Agustin586/AWG-RP2040/Tesis/Anteproyecto/caratula.tex

% =========================================================
% CARÁTULA
% =========================================================
\begin{titlepage}
	\thispagestyle{empty} % sin encabezado ni pie
	
	\vspace*{-3cm}
	
	% --- Logos arriba ---
	\begin{minipage}[t]{0.49\textwidth}
		\raggedright
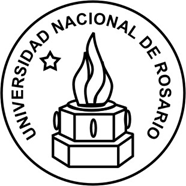
[picture p9: Tesis/Anteproyecto/pic/unr-logo.png]
		
	\end{minipage}
	\begin{minipage}[t]{0.49\textwidth}
		\raggedleft
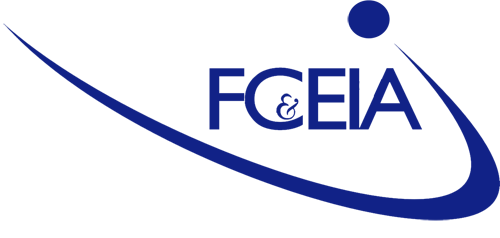
[picture p10: Tesis/Anteproyecto/pic/FCEIA-logo.png]
		
	\end{minipage}
	
	\vspace{1cm}
	
	% --- Institución ---
	\begin{center}
		{\Large Universidad Nacional de Rosario \par}
		\vspace{0.15cm}
		{\large Facultad de Ciencias Exactas, Ingeniería y Agrimensura \par}
		\vspace{0.15cm}
		{\large Ingeniería Electrónica \par}
	\end{center}
	
	\vspace{2cm}
	
	% --- Título principal ---
	\begin{center}
		{\bfseries\LARGE Proyecto I\par}
		\vspace{0.35cm}
		{\bfseries\Large Generador de Funciones Arbitrarias basado en DDS\par}
		\vspace{0.25cm}
		{\large \par}
	\end{center}
	
	\vspace{2cm}
	
	% --- Línea decorativa ---
	\noindent\rule{\textwidth}{1.2pt}
	
	\vspace{0.9cm}
	
	% --- Datos en dos columnas ---
	\noindent\makebox[\textwidth]{%
		\begin{minipage}[t]{0.49\textwidth}
			\raggedright
			{\bfseries Estudiante:}\par
			Agustín Zuliani, Legajo: Z-1183/5\par
			\vspace{0.6cm}
			{\bfseries Carrera:}\par
			Ingeniería Electrónica\par
		\end{minipage}%
		\hfill
		\begin{minipage}[t]{0.49\textwidth}
			\raggedleft
			{\bfseries Director:}\par
			Daniel Márquez\par
			\vspace{0.6cm}
			{\bfseries Asignatura / Proyecto:}\par
			Proyecto 1\par
		\end{minipage}%
	}
	
	\vspace{0.9cm}
	
	% --- Línea decorativa ---
	\noindent\rule{\textwidth}{1.2pt}
	
	\vfill
	
	% --- Pie ---
	\begin{center}
		Rosario, Santa Fe — 2026\par
	\end{center}
	
\end{titlepage}
