Agustin586/AWG-RP2040/Tesis/Anteproyecto/config.tex

%En este archivo se tienen las configuraciones realizadas para el proyecto
%=================================================================================
%								      PAQUETES
%=================================================================================
\usepackage{amsmath}
\usepackage[utf8]{inputenc}
\usepackage{graphicx}
\usepackage[export]{adjustbox}
\usepackage{float}
\usepackage[bookmarks = true, colorlinks=true, linkcolor = black, citecolor = black, menucolor = black, urlcolor = black]{hyperref}
\usepackage{vmargin}
\setpapersize{A4}
\setmargins{2.5cm}{1cm}{16.5cm}{23cm}{.5cm}{2.5cm}{0pt}{2cm}
\setlength{\skip\footins}{1cm}
\usepackage{fancyhdr}
\pagestyle{fancy}
\fancyhf{}
\usepackage{enumitem}
\usepackage{tikz, adjustbox}
\usepackage[most]{tcolorbox}
\usepackage{xcolor}
\usepackage{wrapfig}
\usepackage{lipsum}
\usepackage{titlesec}
\usepackage{rotating}
\usepackage{pdflscape}
\usepackage{tabularx}

% Interlineado
\usepackage{setspace}
\onehalfspacing
