Agustin586/AWG-RP2040/Tesis/Anteproyecto/anteproyecto.tex

\documentclass[12pt,a4paper]{article}

\usepackage[spanish]{babel}

% Carga tu configuración (NO se modifica)
\input{config.tex}

% Extras tuyos
\input{tcolorbox_define}
\input{Config_codigo}

% =========================================================
% ENCABEZADO Y PIE DE PAGINA (fancyhdr ya está cargado en config.tex)
% =========================================================
\chead{%
	{\itshape\bfseries ``Proyecto 1''}\\
	{\bfseries Generador de Funciones Arbitrarias}\\
	Estudiante: Zuliani, Agustín -- Director: Márquez, Daniel\\
	Universidad Nacional de Rosario, 2025
}
\lhead{}
\rhead{}
\renewcommand{\headrulewidth}{1.5pt}

\lfoot{Zuliani, Agustín}
\rfoot{\thepage}

% =========================================================
% MÁRGENES / FORMATO DE PÁGINA
% =========================================================
% Como en config.tex tenés geometry + vmargin, elegí UNO.
% Si querés seguir con vmargin (porque usás \setmargins), dejá esto:
% Si en cambio querés imponer márgenes con geometry (sin tocar config.tex),
% comentá el bloque \setmargins de arriba y usá, por ejemplo:
% \geometry{left=3cm,right=2.5cm,top=3cm,bottom=3cm}

% =========================================================
% FORMATO DE TÍTULOS (titlesec ya está en config.tex)
% =========================================================
\definecolor{teal}{RGB}{0,128,128}

\titleformat{\section}[block]
{\sffamily\Huge\bfseries\color{teal}}
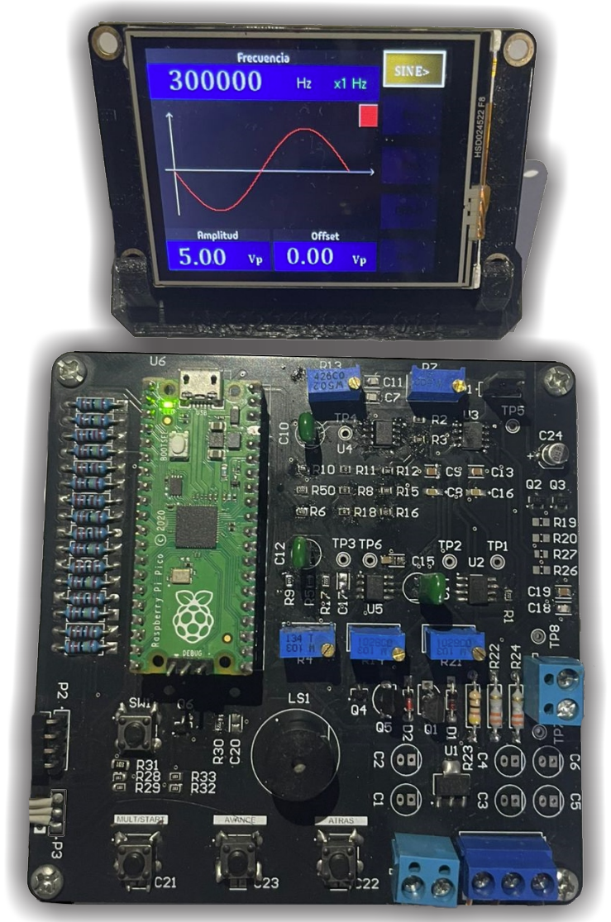
[picture p11: Tesis/Anteproyecto/Introduccion/img/dispositivo.png]
{\raisebox{-0.2\height}{}\hspace{0.3em}\thesection}
{0.5em}
{}
[\vspace{-0.5em}\color{teal}\rule{\linewidth}{2pt}]

\titleformat{\subsection}
{\normalfont\large\bfseries\color{teal}}{\thesubsection}{1em}{}
\titlespacing*{\subsection}{0pt}{0.5em}{0.5em}

\titleformat{\subsubsection}
{\normalfont\large\bfseries\color{teal}}{\thesubsubsection}{1em}{}
\titlespacing*{\subsubsection}{0pt}{0.5em}{0.5em}

% =========================================================
% ÍTEM CON IMAGEN (enumitem ya está en config.tex)
% =========================================================
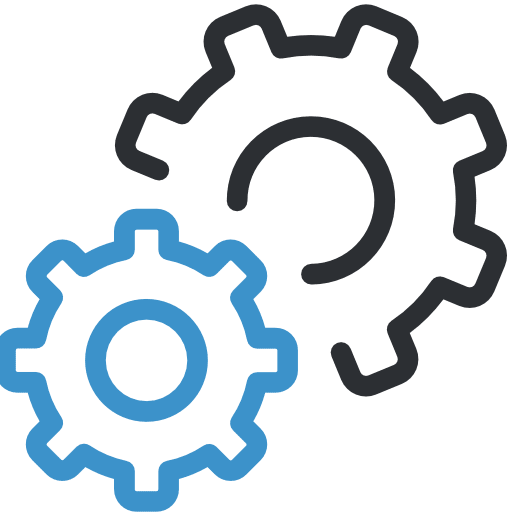
[picture p12: Tesis/Anteproyecto/pic/items_control.png]
\newcommand{\itemimage}{}
\setlist[itemize]{label=\itemimage}

\begin{document}
	
	% =========================================================
	% CARÁTULA SIN ENCABEZADO
	% =========================================================
	\input{caratula.tex}
	
	\newpage
	
	\tableofcontents
	\newpage
	
	\input{Introduccion/doc/introduccion.tex}
%	\input{Introduccion/doc/Objetivo.tex}
	\input{Comparacion/comparacion.tex}
	\input{caracteristicas.tex}
%	\input{Introduccion/doc/Objetivo.tex}
	\input{Metodologia/doc/metodologia.tex}
%	\input{Conclusion/doc/instrumental.tex}
%	\input{Conclusion/doc/avances.tex}
%	\input{Conclusion/doc/mejoras_a_futuro.tex}
	
	\newpage
	
	\bibliographystyle{plain}
	\bibliography{bibliografia}
	
\end{document}
