Agustin586/AWG-RP2040/Tesis/Anteproyecto/Config_codigo.tex

\usepackage{tcolorbox}
\usepackage{listings}
\usepackage{xcolor} % Para colores personalizados

\definecolor{codebg}{rgb}{1,1,1} % Fondo gris claro
\definecolor{codeborder}{rgb}{0.6,0.6,0.6} % Borde gris oscuro

\lstdefinestyle{mystyle}{
  language=C,
  basicstyle=\ttfamily\color{black}, % Código en negro
  keywordstyle=\color{blue}, % Palabras clave en azul
  commentstyle=\color{green!50!black}, % Comentarios en verde oscuro
  stringstyle=\color{red}, % Cadenas en rojo
  showspaces=false, % Oculta los espacios
  showstringspaces=false % Evita que los espacios dentro de strings se marquen
}

\newtcolorbox{codebox}{
    colback=codebg, 
    colframe=codeborder, 
    arc=3mm, 
    boxrule=1pt, 
    fontupper=\ttfamily
}

%===================================================================================
%									BLOCK DE NOTAS
%===================================================================================
% Yellow:
\definecolor{BgYellow}{HTML}{FFF59C}
\definecolor{FrameYellow}{HTML}{F7A600}

% Definir el estilo de la nota
% Yellow Sticky Note (YStkyNote):
\newtcolorbox{YStkyNote}[1][]{%
	enhanced,
	before skip=2mm,after skip=2mm, 
	width=0.4\textwidth, % width of the sticky note
	boxrule=0.2mm,
	colback=BgYellow, colframe=FrameYellow, % Colors
	attach boxed title to top left={xshift=0cm,yshift*=0mm-\tcboxedtitleheight},
	varwidth boxed title*=-3cm,
	% The titlebox:
	boxed title style={frame code={%
			\path[left color=FrameYellow,right color=FrameYellow,
			middle color=FrameYellow]
			([xshift=-0mm]frame.north west) -- ([xshift=0mm]frame.north east)
			[rounded corners=0mm]-- ([xshift=0mm,yshift=0mm]frame.north east)
			-- (frame.south east) -- (frame.south west)
			-- ([xshift=0mm,yshift=0mm]frame.north west)
			[sharp corners]-- cycle;
		},interior engine=empty,
	},
	sharp corners,rounded corners=southeast,arc is angular,arc=3mm,
	% The "folded paper" in the bottom right corner:
	underlay={%
		\path[fill=BgYellow!80!black] ([yshift=3mm]interior.south east)--++(-0.4,-0.1)--++(0.1,-0.2);
		\path[draw=FrameYellow,shorten <=-0.05mm,shorten >=-0.05mm,color=FrameYellow] ([yshift=3mm]interior.south east)--++(-0.4,-0.1)--++(0.1,-0.2);
	},
	drop fuzzy shadow, % Shadow
	fonttitle=\bfseries, 
	title={#1}
}
