Agustin586/AWG-RP2040/Tesis/Anteproyecto/Conclusion/doc/avances.tex

\section{Avances realizados}
En esta sección se presentan los avances que fueron realizados durante el proceso de desarrollo del anteproyecto de forma preliminar. 

\subsection{Diseño de la placa de alimentación}
Dentro de estos avances se encuentra el diseño de la \textbf{placa de Alimentación} a través del programa de diseño \textbf{Altium} que puede verse en la Figura \ref{fig:placaalimentacion} y \ref{fig:placaalimentacionvuelta}.

\begin{figure}[H]
	\centering
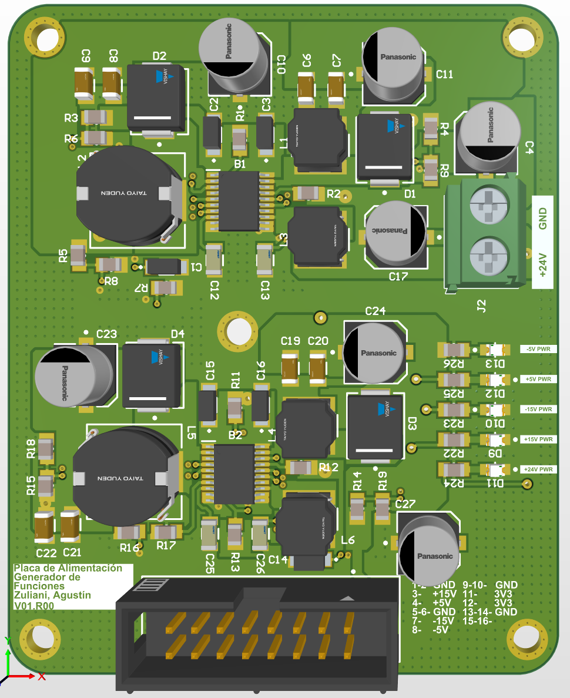
[picture p13: Tesis/Anteproyecto/Conclusion/img/placa_alimentacion.png]
	
	\caption{Placa de Alimentación diseñada V01.R00 del lado TOP.}
	\label{fig:placaalimentacion}
\end{figure}

\begin{figure}[H]
	\centering
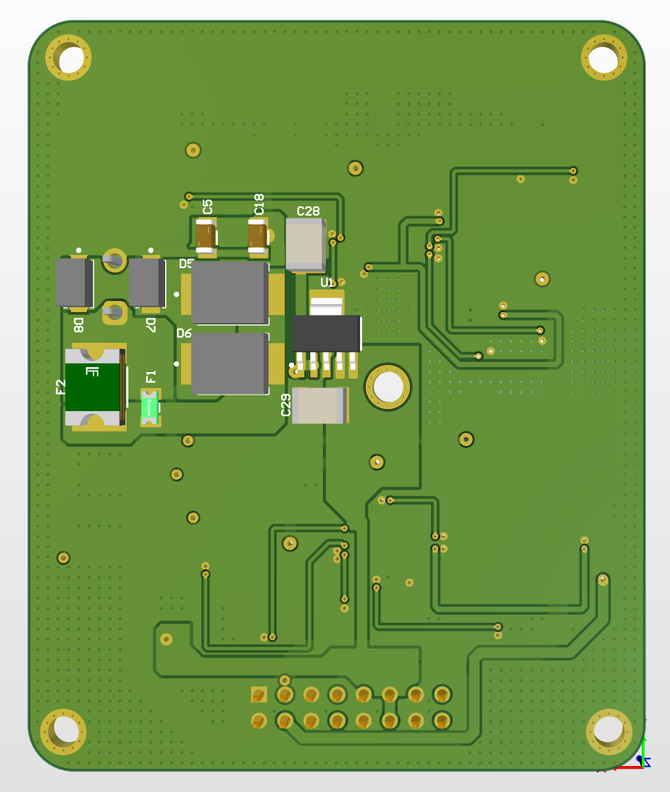
[picture p14: Tesis/Anteproyecto/Conclusion/img/placa_alimentacion_vuelta.png]
	
	\caption{Placa de Alimentación V01.R00 del lado Bottom.}
	\label{fig:placaalimentacionvuelta}
\end{figure}

El circuito esquemático puede verse a continuación:

\begin{figure}[H]
	\centering
	
	\caption{Esquemático de la PCB de Alimentación.}
	\label{fig:fuente}
\end{figure}

\subsection{Diseño de la placa de control}
De la misma manera con la \textbf{placa de control} se fueron realizando avances, dentro de estos se encuentra únicamente el diseño del esquemático. En esta placa como se mencionó anteriormente se encuentra toda la generación de la señal, así como también el control mediante el RP2040 para la lógica funcional.

\begin{figure}[H]
	\centering
	
	\caption{Esquemático de la placa de control.}
	\label{fig:pcbcontrol}
\end{figure}

\begin{figure}[H]
	\centering
	
	\vspace{6pt}
	
	\caption{Esquemático de la placa de control (hojas 2 y 3).}
\end{figure}

\begin{figure}[H]
	\centering
	
	\vspace{6pt}
	
	\caption{Esquemático de la placa de control (hojas 2 y 3).}
\end{figure}

\begin{figure}[H]
	\centering
	
	\vspace{6pt}
	
	\caption{Esquemático de la placa de control (hojas 2 y 3).}
\end{figure}

\begin{figure}[H]
	\centering
	
	\vspace{6pt}
	
	\caption{Esquemático de la placa de control (hojas 2 y 3).}
\end{figure}

\begin{figure}[H]
	\centering
	
	\vspace{6pt}
	
	\caption{Esquemático de la placa de control (hojas 2 y 3).}
\end{figure}

\begin{figure}[H]
	\centering
	
	\vspace{6pt}
	
	\caption{Esquemático de la placa de control (hojas 2 y 3).}
\end{figure}

\begin{figure}[H]
	\centering
	
	\vspace{6pt}
	
	\caption{Esquemático de la placa de control (hojas 2 y 3).}
\end{figure}
