Agustin586/AWG-RP2040/Presentacion SASE/PRESENTACION_SASE_2025.pdf

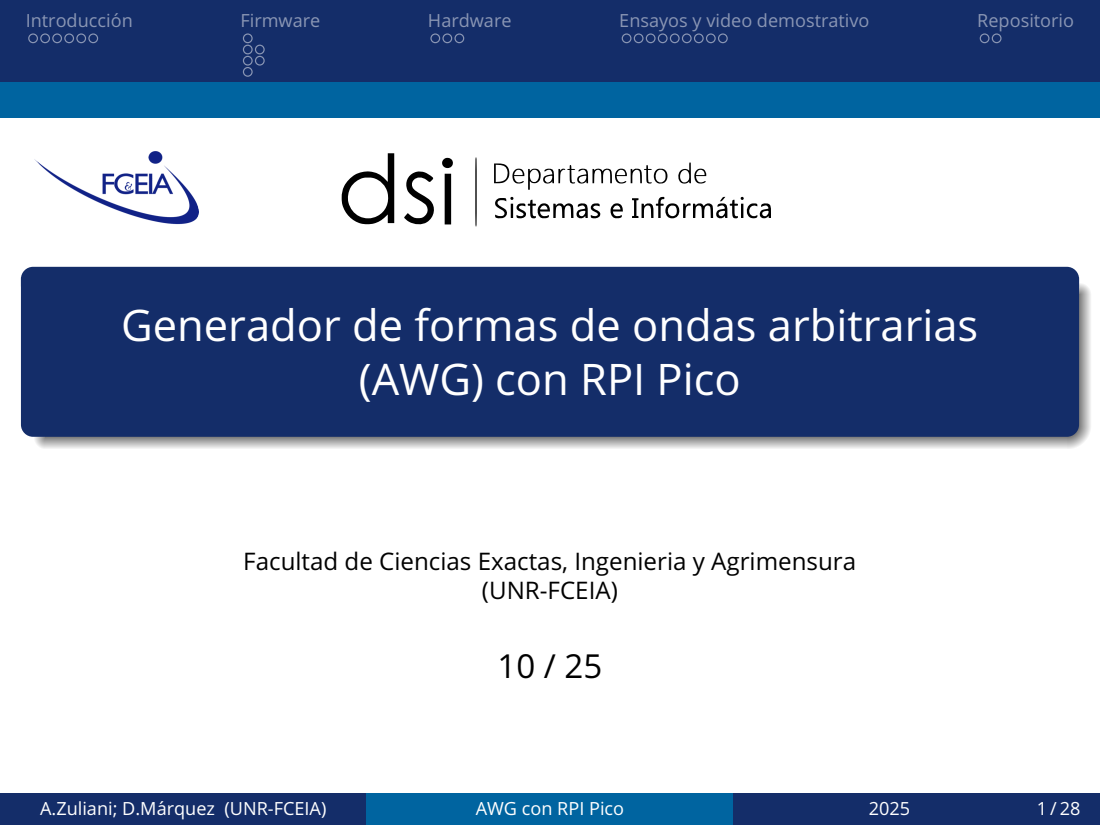
[picture p27: page 1]
Introduccion´; Firmware; Hardware; Ensayos y video demostrativo; Repositorio; (UNR-FCEIA); A.Zuliani; D.Márquez (UNR-FCEIA); AWG con RPI Pico

Generador de formas de ondas arbitrarias

(AWG) con RPI Pico

Facultad de Ciencias Exactas, Ingenieria y Agrimensura

## Índice

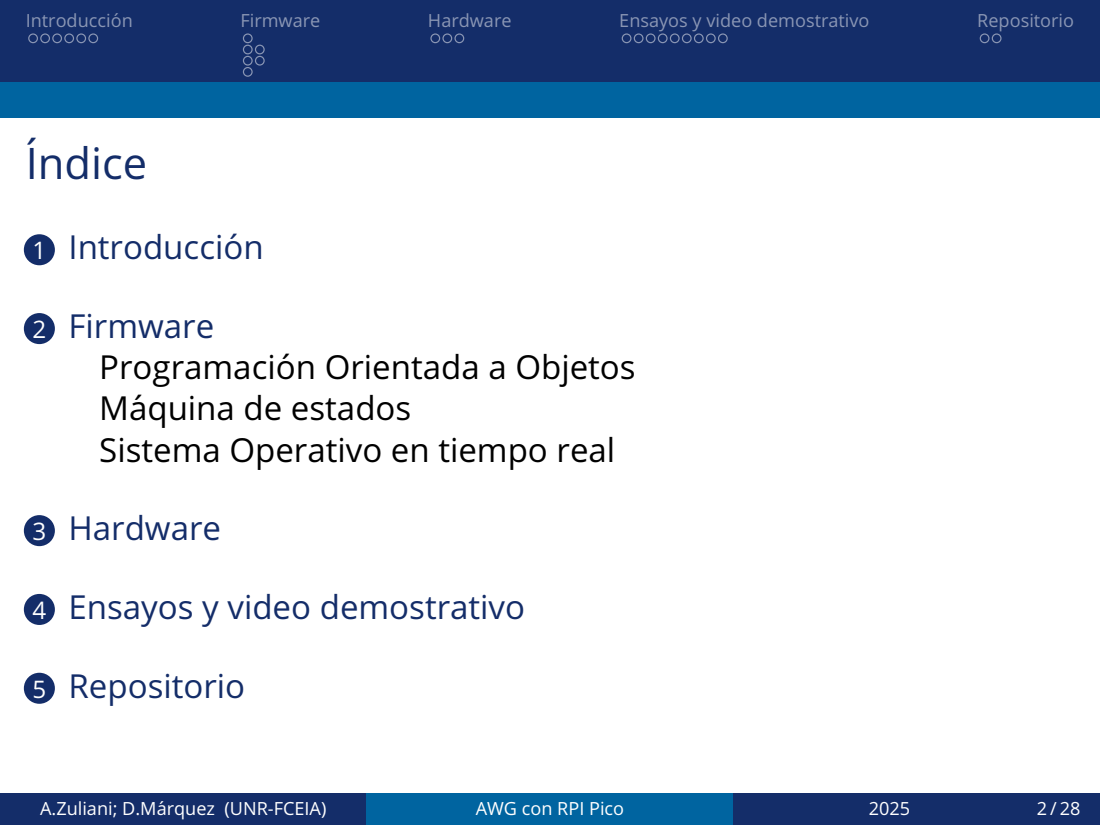
[picture p28: page 2]
1 Introduccion´; 3 Hardware; 5 Repositorio; A.Zuliani; D.Márquez (UNR-FCEIA); AWG con RPI Pico

2 Firmware
Programacion Orientada a Objetos ´
Máquina de estados
Sistema Operativo en tiempo real

4 Ensayos y video demostrativo

## Introduccion´

- ¿Qué es el SASE?
A.Zuliani; D.Márquez (UNR-FCEIA) | AWG con RPI Pico | 2025 | 3 / 28

## Introduccion´

- ¿Qué es el SASE?
- ¿Cuales fueron las motivaciones? ´
A.Zuliani; D.Márquez (UNR-FCEIA) | AWG con RPI Pico | 2025 | 3 / 28

## Introduccion´

- ¿Qué es el SASE?
- ¿Cuales fueron las motivaciones? ´
- ¿Qué es un AWG? ¿Porqué la eleccion de ese micro en particular? ´
A.Zuliani; D.Márquez (UNR-FCEIA) | AWG con RPI Pico | 2025 | 3 / 28

## Simposio Argentino de Sistemas Embebidos (SASE)

2025

El Simposio Argentino de Sistemas Embebidos (SASE) es un evento anual que reúne a la comunidad académica y a la industria en torno a la temática de los Sistemas Embebidos.
Los objetivos del SASE son los siguientes:
1 Difundir en el ámbito profesional y académico las tecnologías asociadas a los sistemas embebidos.
2 Fomentar la interaccion industria-academia en temas ´ asociados a los sistemas embebidos.
3 Incentivar entre los estudiantes universitarios y los jovenes ´ profesionales el interés por los sistemas embebidos.

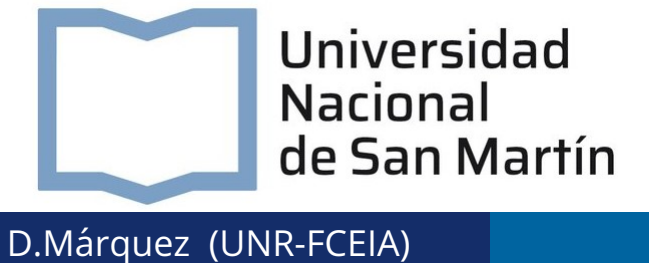
[picture p29: figure]
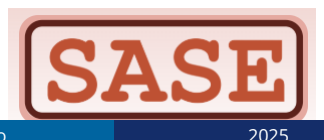
[picture p30: figure]

A.Zuliani; D.Márquez (UNR-FCEIA) | AWG con RPI Pico | 2025 | 4 / 28

## ¿Qué es un AWG?

Un generador de formas de onda arbitrarias (AWG) permite generar funciones periodicas cargando puntos en un buffer y ´ reproduciéndolos mediante un DAC a la frecuencia solicitada. La resolucion depende de la profundidad del buffer y del DAC, ´ afectando la frecuencia máxima alcanzable. Mayor resolucion´ implicará menor frecuencia máxima.

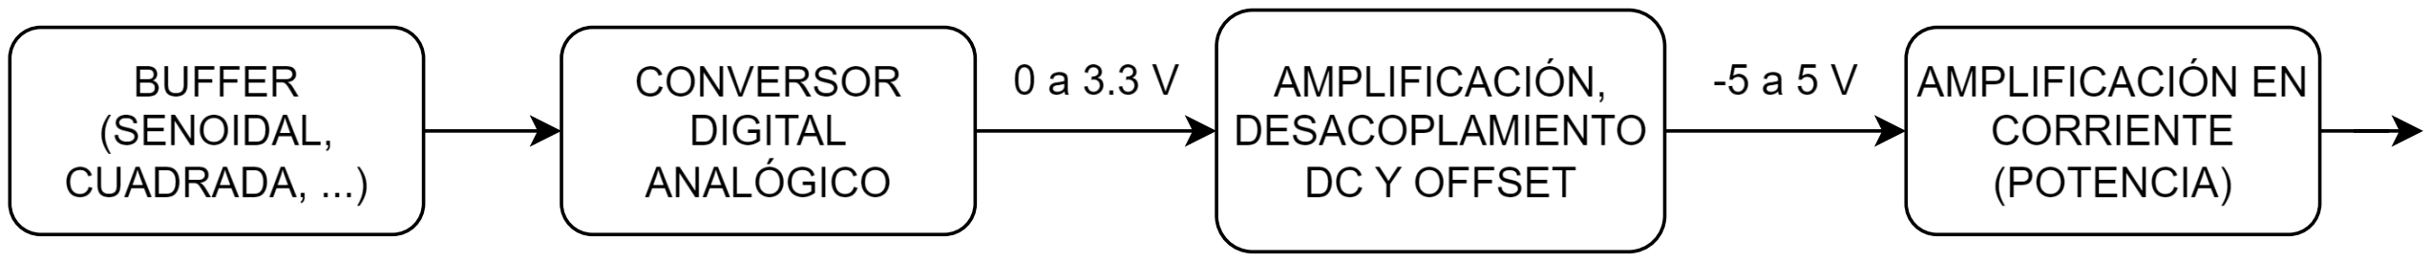
[picture p31: figure]

Figura 1.1: Diagrama en bloques del AWG

A.Zuliani; D.Márquez (UNR-FCEIA) | AWG con RPI Pico | 2025 | 5 / 28

## Raspberry Pi Pico

- Microcontrolador: RP2040, ARM Cortex-M0+ dual-core a 133 MHz.
- Memoria: 264 KB de SRAM y 2 MB de flash externa (QSPI).
- Periféricos: 2x I2C, 2x SPI, 2x UART, 16 canales PWM, ADC de 12 bits (3 canales + temperatura interna).
- PIO: 2 bloques con 4 máquinas de estado programables cada uno.
- GPIO: 26 pines (3.3 V, multifuncion, no toleran 5 V). ´
- USB: 1.1, modo host o dispositivo.
- Alimentacion: ´ | 1.8–5.5 V (regulador interno a 3.3 V).
- Programacion: ´ | C/C++, MicroPython, Arduino.
A.Zuliani; D.Márquez (UNR-FCEIA) | AWG con RPI Pico | 2025 | 6 / 28

## Raspberry Pi Pico

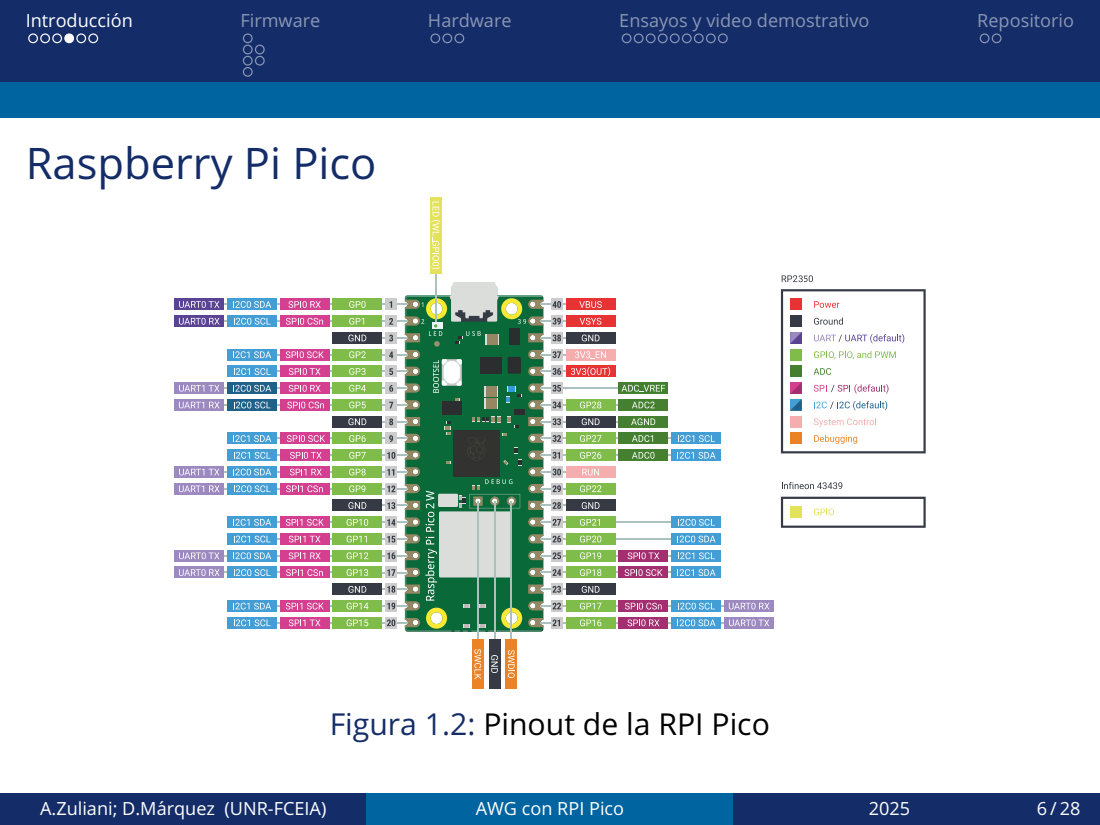
[picture p32: page 9]
A.Zuliani; D.Márquez (UNR-FCEIA); AWG con RPI Pico

Figura 1.2: Pinout de la RPI Pico

## Programmable Input/Ouput (PIO) y DMA

- DMA (Direct Memory Access): transfiere datos entre memoria y periféricos sin intervencion del CPU, liberando ´ carga de procesamiento. Cuenta con 12 canales independientes y se usa comúnmente con PIO, SPI o ADC para transferencias continuas de datos. En nuestro caso lo utilizamos para transferir el buffer en la memoria RAM al PIO.
A.Zuliani; D.Márquez (UNR-FCEIA) | AWG con RPI Pico | 2025 | 7 / 28

## Programmable Input/Ouput (PIO) y DMA

- DMA (Direct Memory Access): transfiere datos entre memoria y periféricos sin intervencion del CPU, liberando ´ carga de procesamiento. Cuenta con 12 canales independientes y se usa comúnmente con PIO, SPI o ADC para transferencias continuas de datos. En nuestro caso lo utilizamos para transferir el buffer en la memoria RAM al PIO.
- PIO (PROGRAMMABLE I/O): es un periférico programable que permite implementar protocolos personalizados o de alta velocidad directamente en hardware, sin cargar la CPU. Posee 2 bloques con 4 máquinas de estado cada uno. Es ideal para bit-banging preciso o interfaces como WS2812, I2S o DVI. En este caso fue utilizado para generar la senal de salida en la ˜ escalera R-2R.
A.Zuliani; D.Márquez (UNR-FCEIA) | AWG con RPI Pico | 2025 | 7 / 28

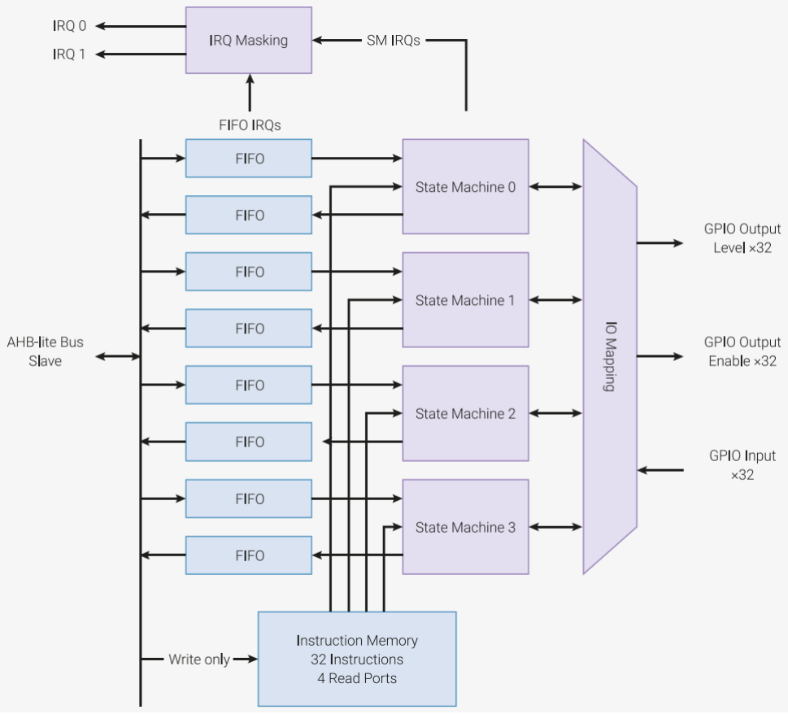
[picture p33: figure]

Figura 1.3: Diagrama de niveles en bloques del periférico PIO.

A.Zuliani; D.Márquez (UNR-FCEIA) | AWG con RPI Pico | 2025 | 8 / 28

FIRMWARE

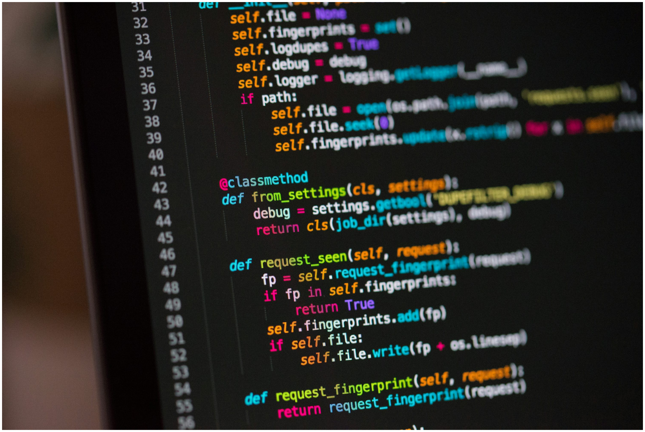
[picture p34: figure]

A.Zuliani; D.Márquez (UNR-FCEIA) | AWG con RPI Pico | 2025 | 9 / 28

## Programacion orientada a objetos (POO) ´

¿Cual fue el enfoque de la programaci ´ | on? ´
A.Zuliani; D.Márquez (UNR-FCEIA) | AWG con RPI Pico | 2025 | 10 / 28

## Programacion orientada a objetos (POO) ´

¿Cual fue el enfoque de la programaci ´ | on? ´

El firmware fue escrito basado en el concepto de la programacion´ orientada a objetos. Para esto mismo cada archivo/objeto representa una porcion específica del hardware. En especial ´ pueden destacarse las etapas de amplificacion´ , desacoplamiento DC y filtros PB (offset).

A.Zuliani; D.Márquez (UNR-FCEIA) | AWG con RPI Pico | 2025 | 10 / 28

## Programacion orientada a objetos (POO) ´

¿Cual fue el enfoque de la programaci ´ | on? ´

El firmware fue escrito basado en el concepto de la programacion´ orientada a objetos. Para esto mismo cada archivo/objeto representa una porcion específica del hardware. En especial ´ pueden destacarse las etapas de amplificacion´ , desacoplamiento DC y filtros PB (offset).
Además se hizo énfasis en una organizacion en forma de ´ | capas,
con la idea de que las capas asociadas a niveles superiores representen una mayor interaccion con el usuario, mientras que ´ capas de niveles inferiores una mayor abstraccion para este. ´
A.Zuliani; D.Márquez (UNR-FCEIA) | AWG con RPI Pico | 2025 | 10 / 28

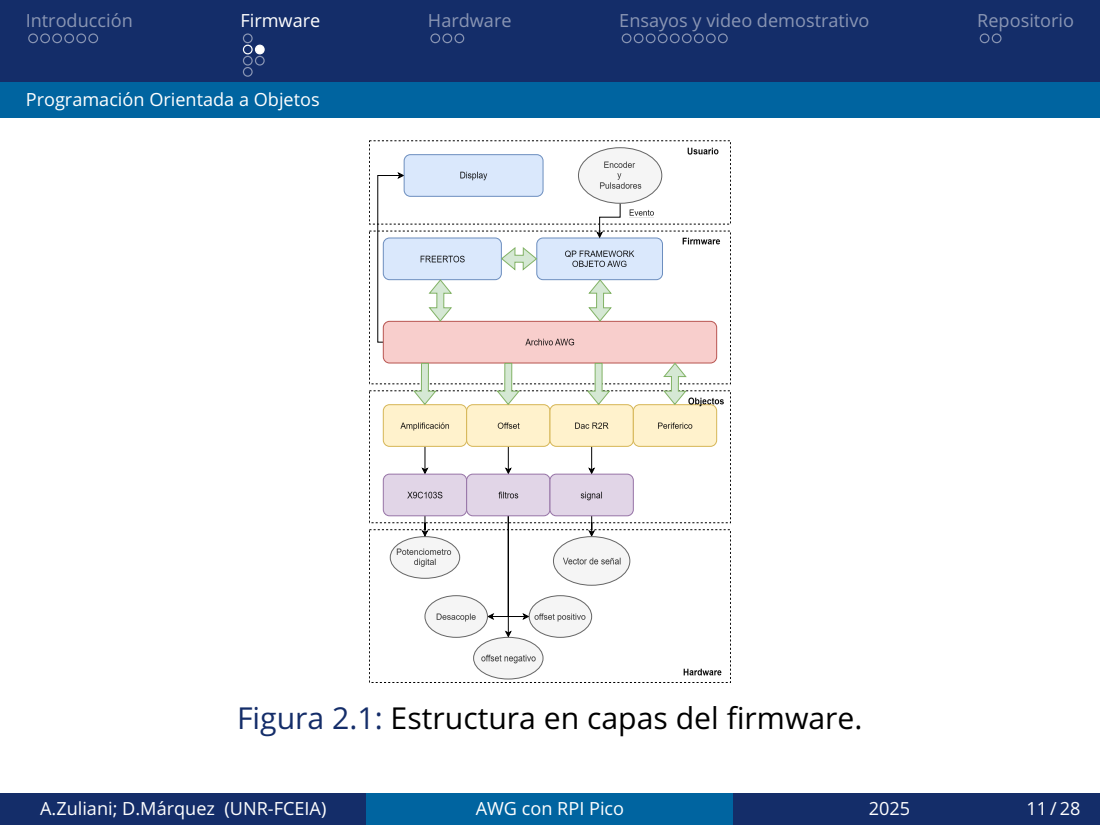
[picture p35: page 17]
A.Zuliani; D.Márquez (UNR-FCEIA); AWG con RPI Pico

Programacion Orientada a Objetos ´

Figura 2.1: Estructura en capas del firmware.

## Máquina de estados

Con la intencion de generar un ´ | menú de configuracion´ para los
distintos parámetros de la senal como ˜ | amplitud, frecuencia, offset
y tipo de senal ˜ , se disenõ una ´ | máquina de estados. Utilizamos el
framework de Quantum Leaps, en el que desarrollamos de forma gráfica los distintos estados, eventos y temporizadores a
utilizar. Podemos ver una representacion de esta m ´ | áquina de
estados en la figura 2.2.

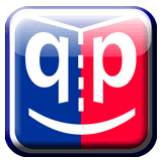
[picture p36: figure]

A.Zuliani; D.Márquez (UNR-FCEIA) | AWG con RPI Pico | 2025 | 12 / 28

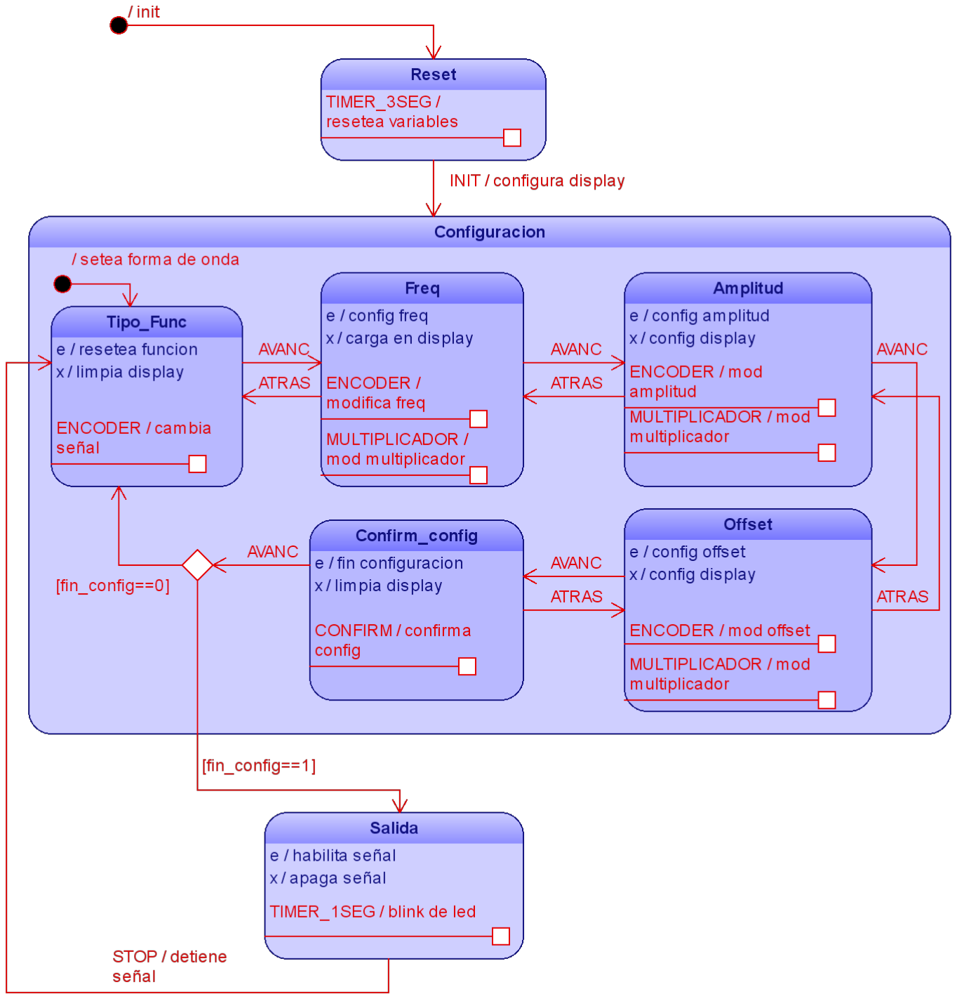
[picture p37: figure]

Figura 2.2: Máquina de estados.

A.Zuliani; D.Márquez (UNR-FCEIA) | AWG con RPI Pico | 2025 | 13 / 28

## Sistema Operativo en Tiempo Real

- ¿Como est ´ an distribuidas las tareas? ´
- ¿Como se relaciona con la MEF de antes? ´
A.Zuliani; D.Márquez (UNR-FCEIA) | AWG con RPI Pico | 2025 | 14 / 28

## Sistema Operativo en Tiempo Real

- ¿Como est ´ an distribuidas las tareas? ´
- ¿Como se relaciona con la MEF de antes? ´
Para la gestion del firmware se utiliz ´ | o FreeRTOS, elegido por ser de ´
codigo abierto y capaz de integrarse con Quantum Leaps. La ´ máquina de estado se ejecuta como una tarea estática, mientras que en paralelo corren otras tareas esenciales: deteccion de ´ pulsadores, manejo de interrupciones del encoder y generacion de ´
la senal (AWG) que son din ˜ | ámicas.

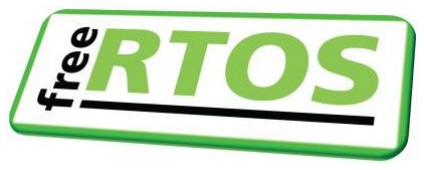
[picture p38: figure]

A.Zuliani; D.Márquez (UNR-FCEIA) | AWG con RPI Pico | 2025 | 14 / 28

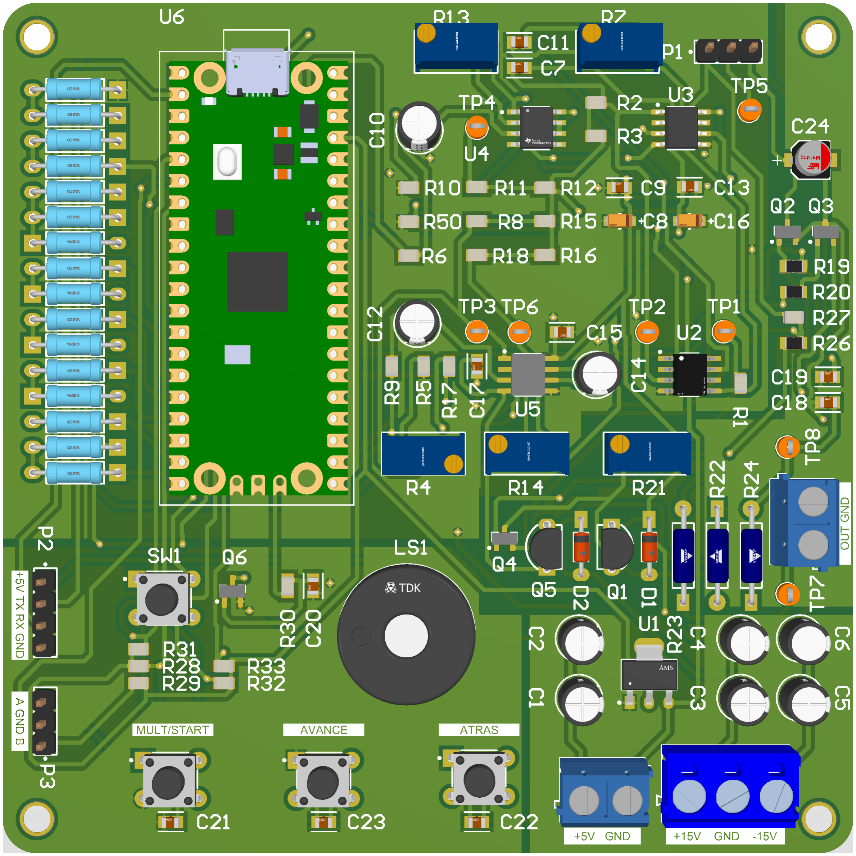
[picture p39: figure]

A.Zuliani; D.Márquez (UNR-FCEIA) | AWG con RPI Pico | 2025 | 15 / 28

## Hardware

El hardware se compone de varias etapas que permiten producir una senal de acuerdo a las especificaciones del usuario. Se ˜ mencionan las siguientes:

- Conversion anal ´ | ogica digital ´
A.Zuliani; D.Márquez (UNR-FCEIA) | AWG con RPI Pico | 2025 | 16 / 28

## Hardware

El hardware se compone de varias etapas que permiten producir una senal de acuerdo a las especificaciones del usuario. Se ˜ mencionan las siguientes:

- Conversion anal ´ | ogica digital ´
- Amplificacion´
A.Zuliani; D.Márquez (UNR-FCEIA) | AWG con RPI Pico | 2025 | 16 / 28

## Hardware

El hardware se compone de varias etapas que permiten producir una senal de acuerdo a las especificaciones del usuario. Se ˜ mencionan las siguientes:

- Conversion anal ´ | ogica digital ´
- Amplificacion´
- Desacople DC
A.Zuliani; D.Márquez (UNR-FCEIA) | AWG con RPI Pico | 2025 | 16 / 28

## Hardware

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

- Conversion anal ´ | ogica digital ´
- Amplificacion´
- Desacople DC
- Offset de continua
A.Zuliani; D.Márquez (UNR-FCEIA) | AWG con RPI Pico | 2025 | 16 / 28

## Hardware

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

- Conversion anal ´ | ogica digital ´
- Amplificacion´
- Desacople DC
- Offset de continua

¿Qué hace a grandes rasgos cada etapa? ¿En qué radica su importancia?

A.Zuliani; D.Márquez (UNR-FCEIA) | AWG con RPI Pico | 2025 | 16 / 28

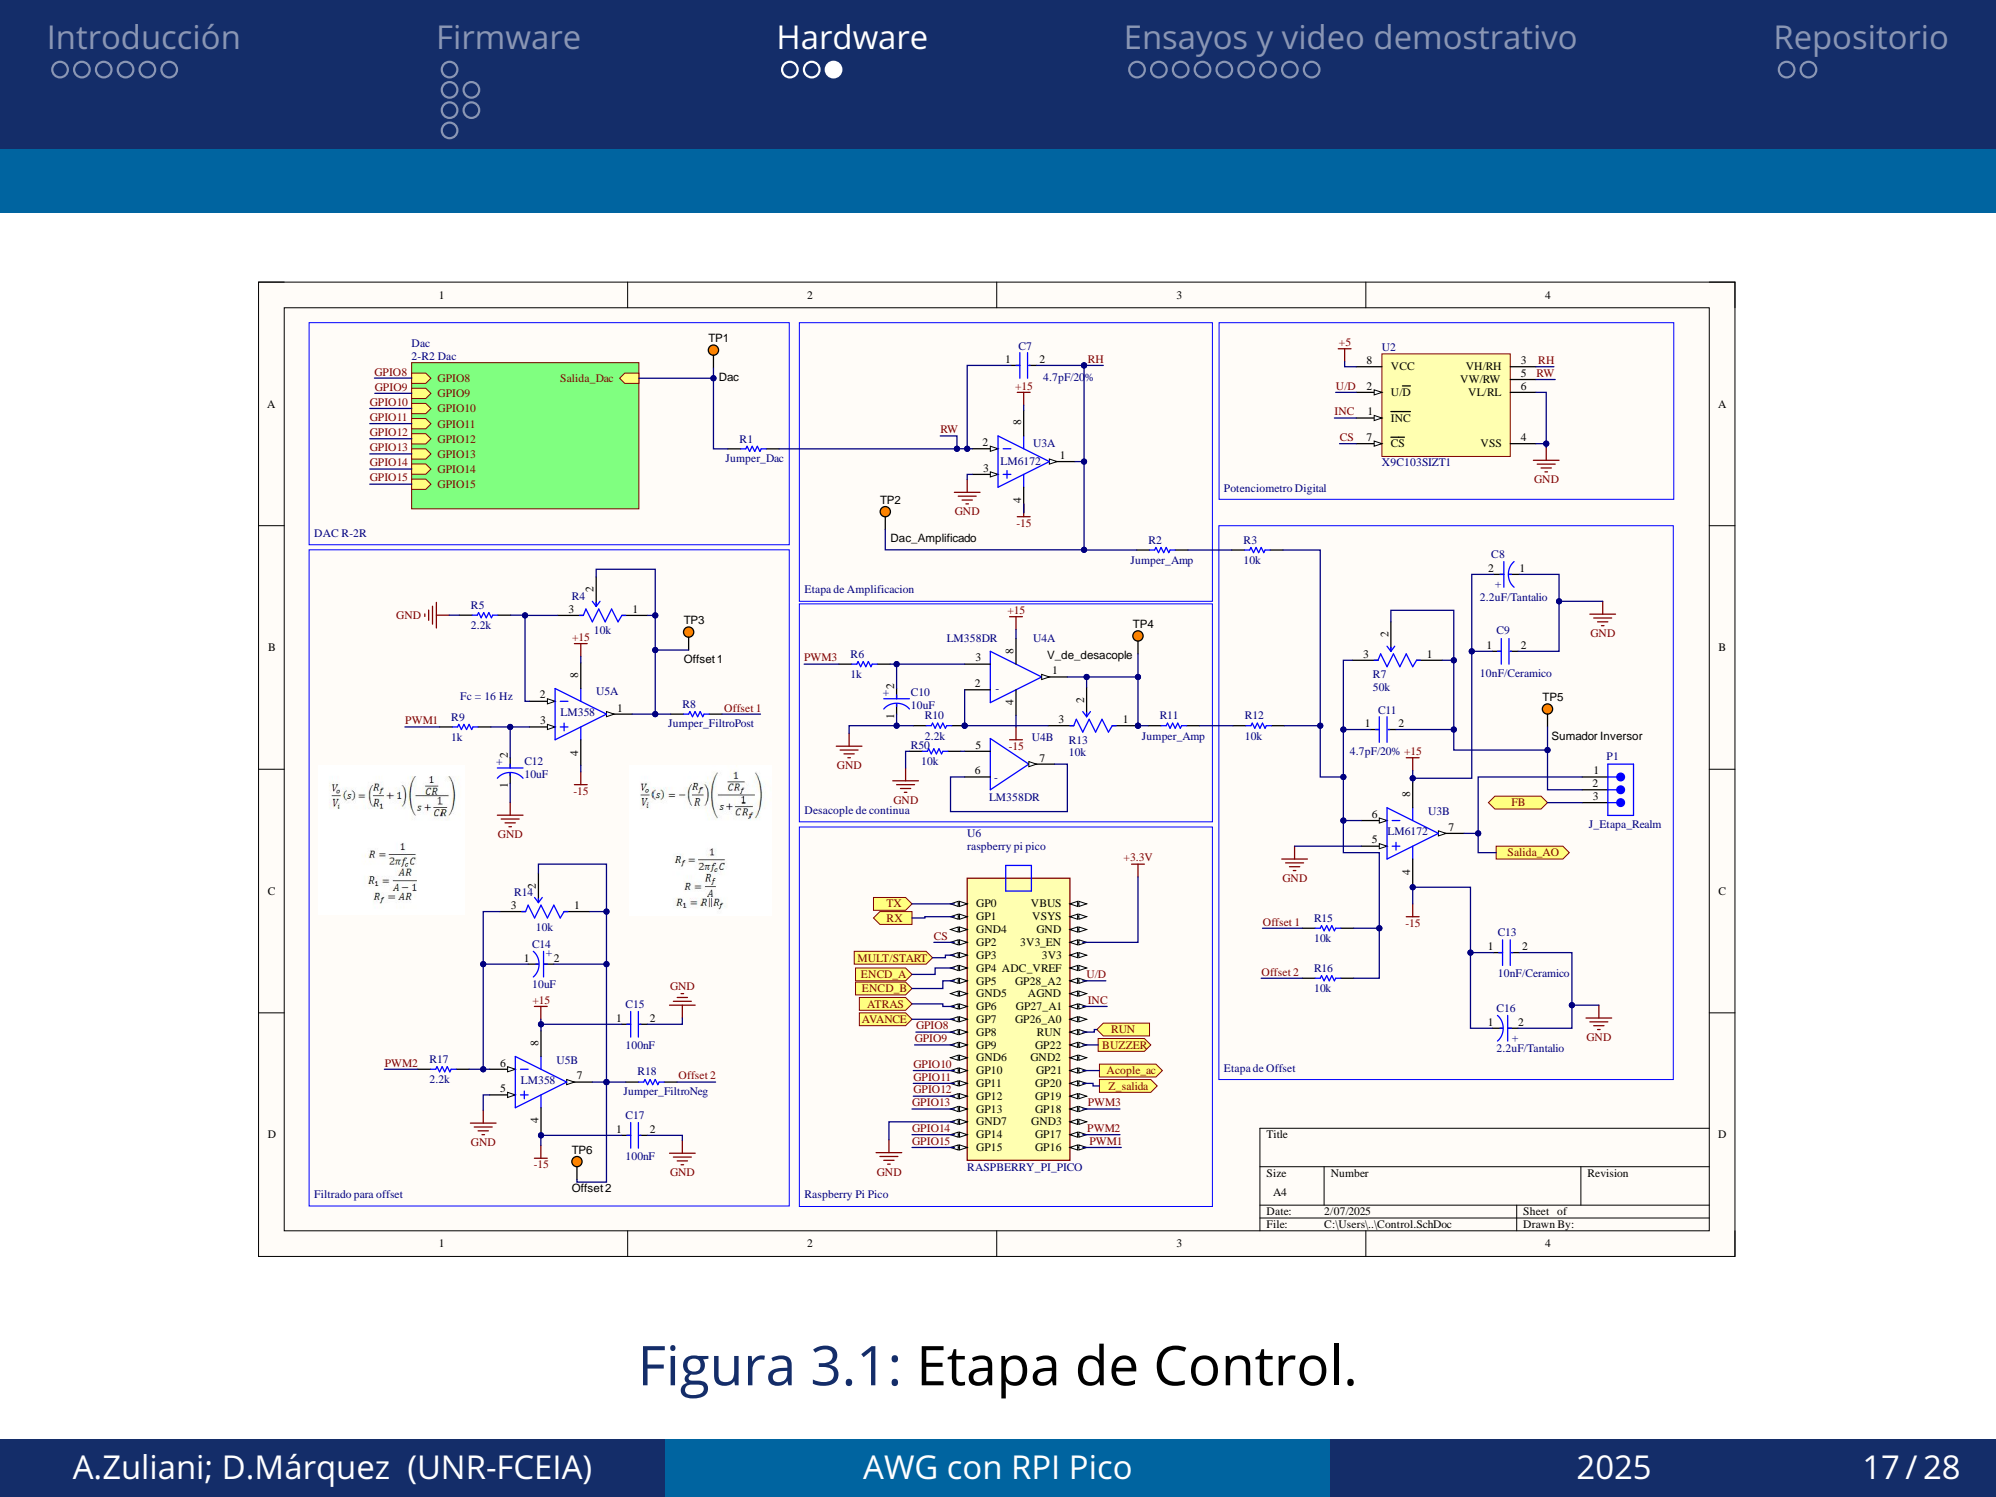
[picture p40: page 28]

Figura 3.1: Etapa de Control.

ENSAYOS

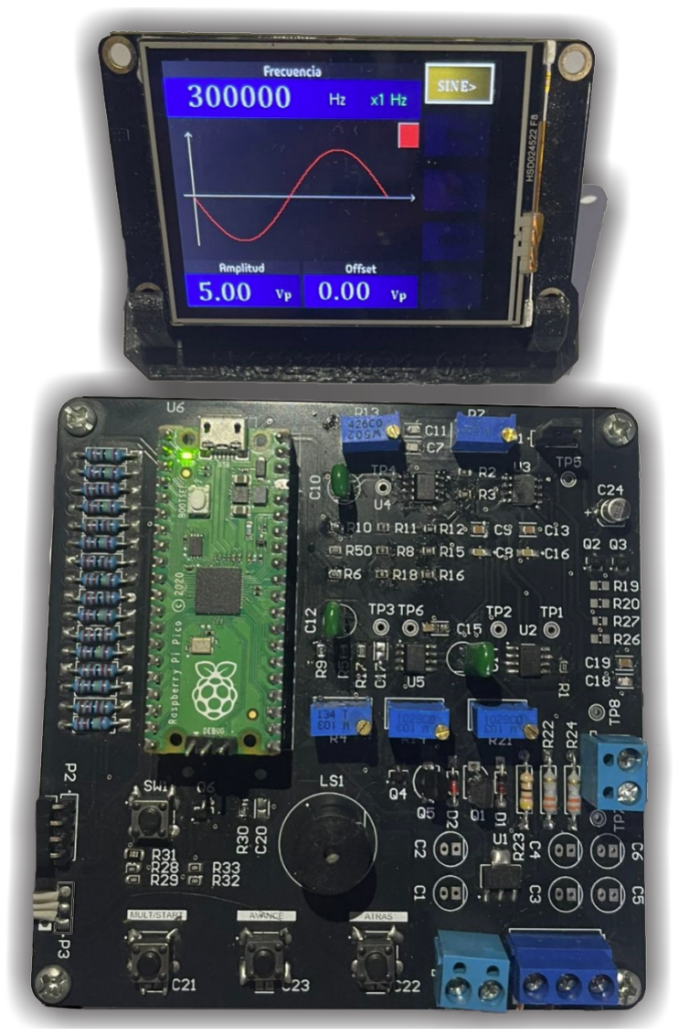
[picture p41: figure]

A.Zuliani; D.Márquez (UNR-FCEIA) | AWG con RPI Pico | 2025 | 18 / 28

## Ensayos realizados

Senoidal:

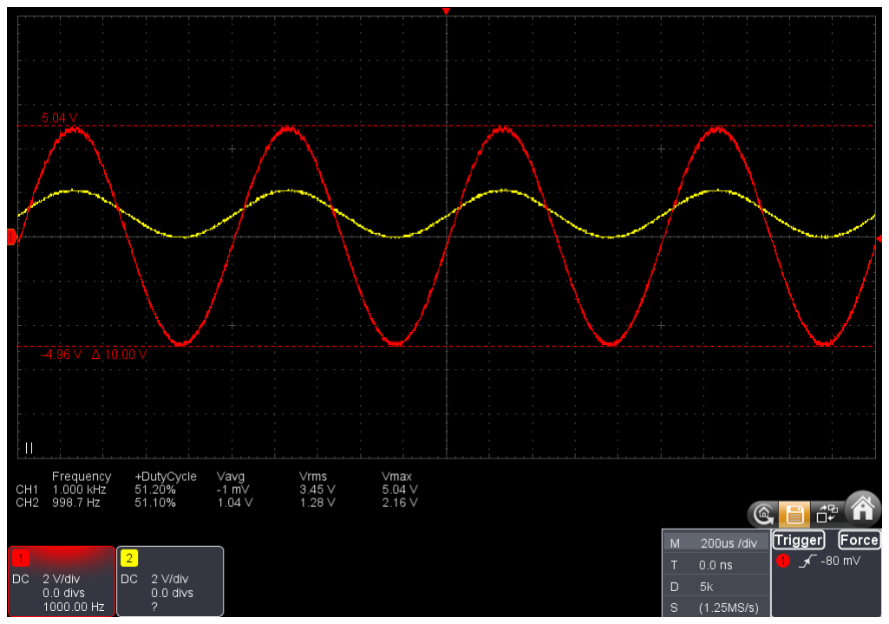
[picture p42: figure]

Figura 4.1: 10 Vpp y f = 10 KHz.

A.Zuliani; D.Márquez (UNR-FCEIA) | AWG con RPI Pico | 2025 | 19 / 28

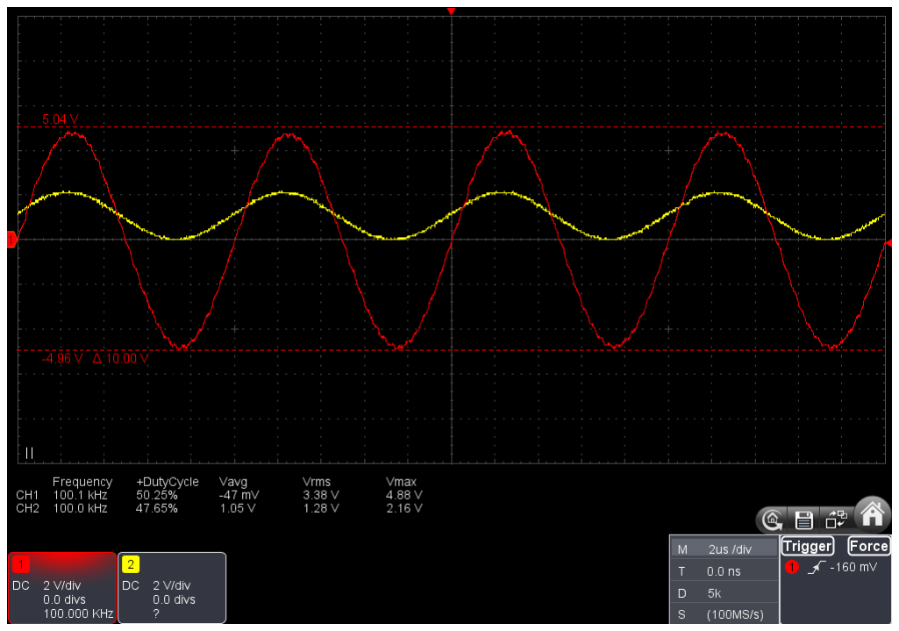
[picture p43: figure]

Figura 4.2: 10 Vpp y f = 100 KHz.

A.Zuliani; D.Márquez (UNR-FCEIA) | AWG con RPI Pico | 2025 | 20 / 28

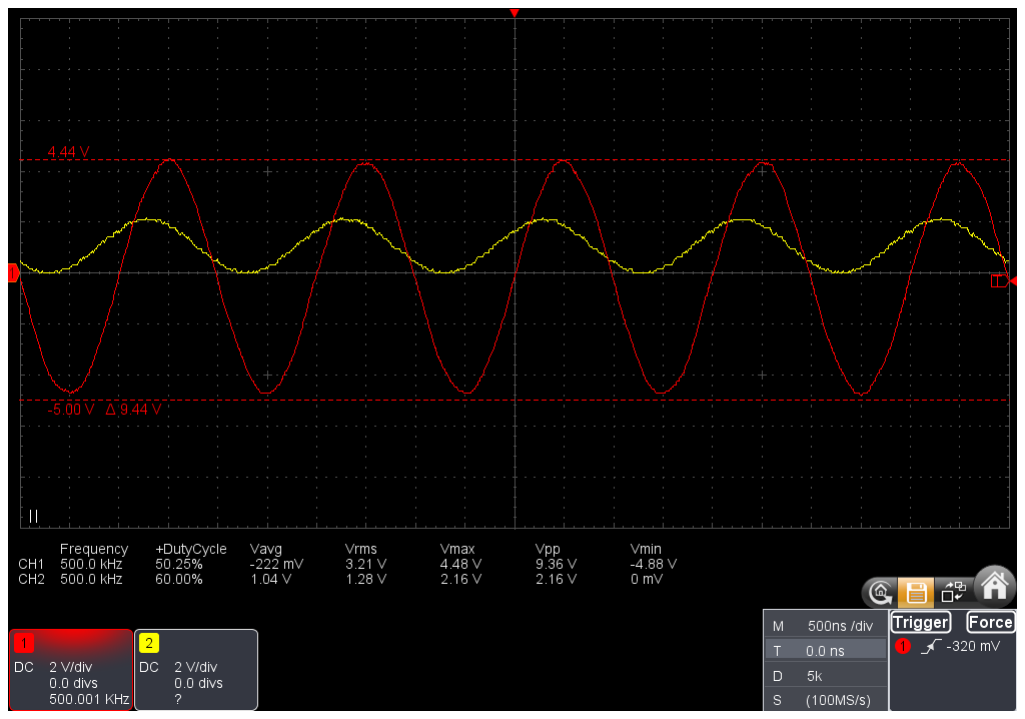
[picture p44: figure]

Figura 4.3: 10 Vpp y f = 500 KHz.

A.Zuliani; D.Márquez (UNR-FCEIA) | AWG con RPI Pico | 2025 | 21 / 28

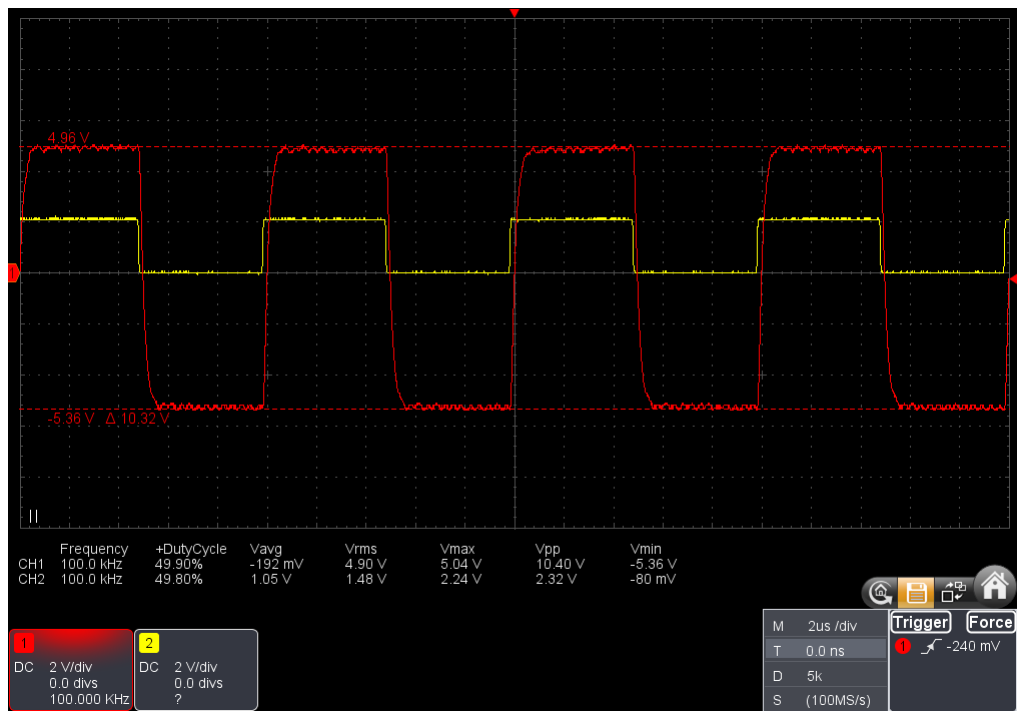
[picture p45: figure]

Figura 4.4: 10 Vpp y f = 100 KHz.

A.Zuliani; D.Márquez (UNR-FCEIA) | AWG con RPI Pico | 2025 | 22 / 28

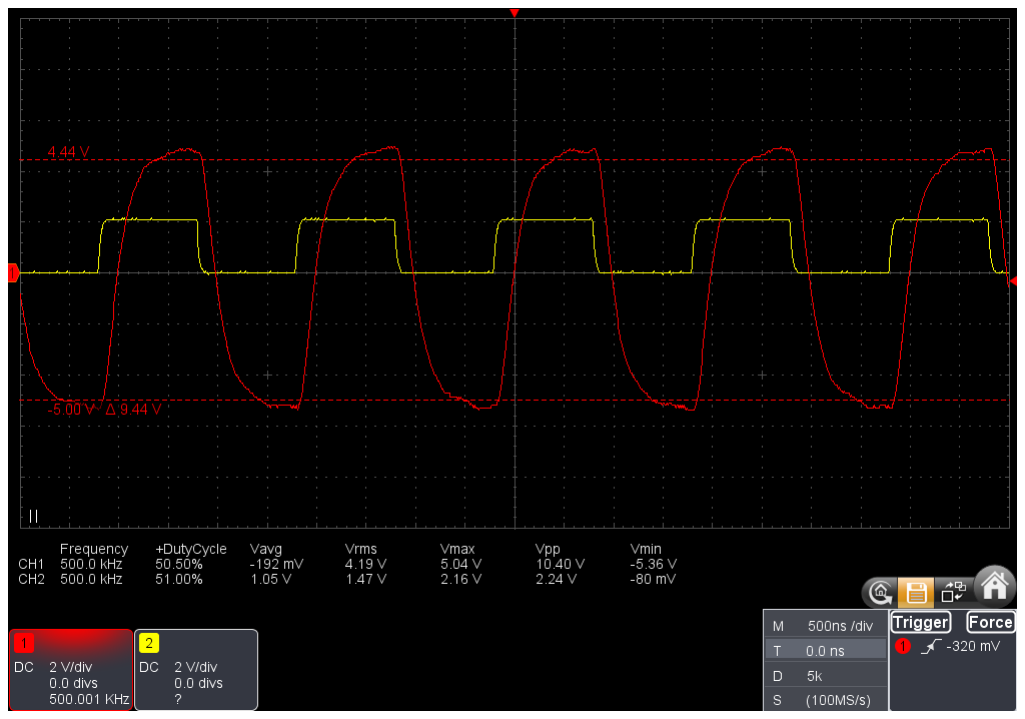
[picture p46: figure]

Figura 4.5: 10 Vpp y f = 500 KHz.

A.Zuliani; D.Márquez (UNR-FCEIA) | AWG con RPI Pico | 2025 | 23 / 28

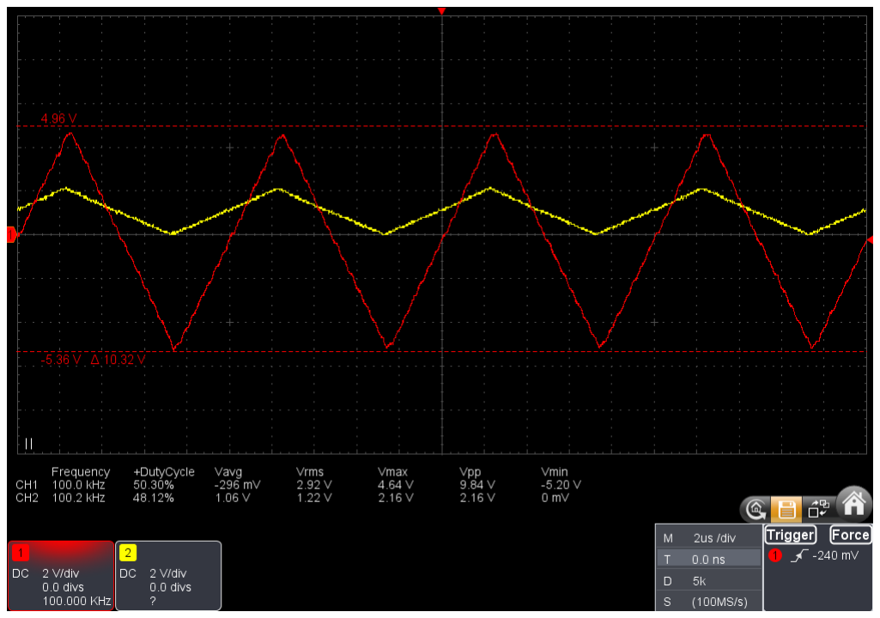
[picture p47: figure]

A.Zuliani; D.Márquez (UNR-FCEIA) | AWG con RPI Pico | 2025 | 24 / 28

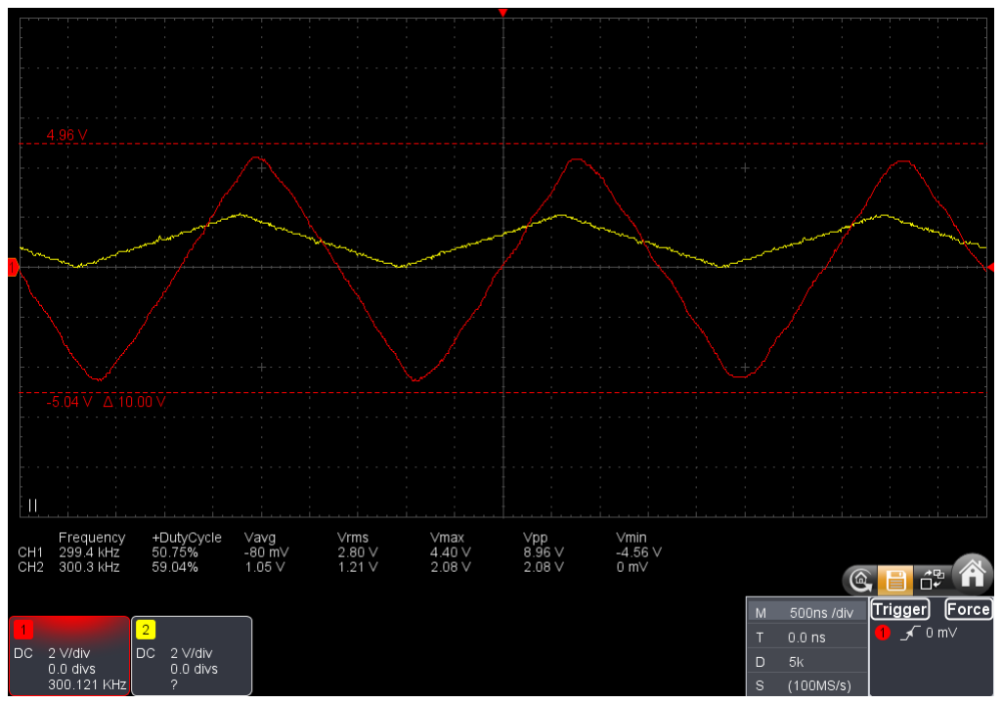
[picture p48: figure]

A.Zuliani; D.Márquez (UNR-FCEIA) | AWG con RPI Pico | 2025 | 25 / 28

## Video demostrativo

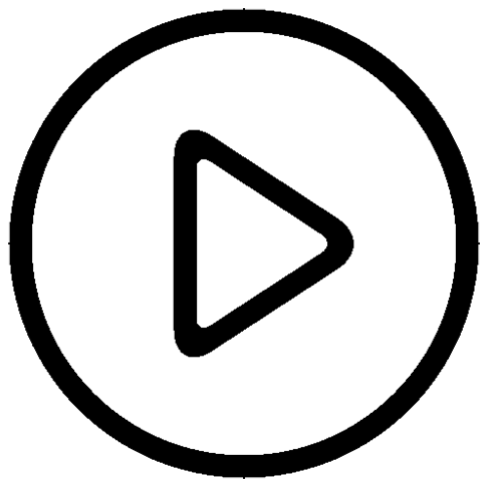
[picture p49: figure]

A.Zuliani; D.Márquez (UNR-FCEIA) | AWG con RPI Pico | 2025 | 26 / 28

## Repositorio

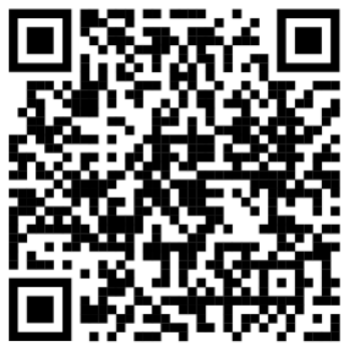
[picture p50: figure]

Emails:
- Agustin Zuliani:
amzuliani02@gmail.com
- Daniel Márquez:
dmarquez@fceia.unr.edu.ar
A.Zuliani; D.Márquez (UNR-FCEIA) | AWG con RPI Pico | 2025 | 27 / 28

# Gracias por mirar y escuchar!

A.Zuliani; D.Márquez (UNR-FCEIA) | AWG con RPI Pico | 2025 | 28 / 28
