Agustin586/AWG-RP2040/Tesis/Tesis/main.tex

%%%%%%%%%%%%%%%%%%%%%%%%%%%%%%%%%%%%%%%%%%%%%%%%%%%%%
%% File: main.tex
%% Author: John Liaperdos (ioannis.liaperdos@gmail.com)
%% Last update: April 28, 2015
%% Description: Provides an example of a PhD Thesis 
%% using the teipel-thesis-en pdfLaTeX class.
%%
%% Character encoding: UTF-8
%%%%%%%%%%%%%%%%%%%%%%%%%%%%%%%%%%%%%%%%%%%%%%%%%%%%%
%
%
%%%%%%
% 1. use the "modern" or "classic" option to switch between 
% a modern or classic font, respectively.
%
% 2. add/remove the "hyperref" option to enable/disable hyperlinks:
% (remember to remove auxiliary files after adding/removing 
% the "hyperref" option).
%
% 3. add/remove the "printer" option to typeset a printer-friendly 
% (grayscale)/color version of the thesis.
%
% 4. use the "watermark" option to indicate a draft copy of the thesis
%
% 5. use the "histinit" option to enable "historiated initials".
% (If used, all chapter initials declared by the \InitialCharacter{}
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
%% Place and date of publication
%
	\thesisPlaceDate{Medellín, 2017}
%
%% -------------------------------------------------------------------
%% Place and date in acknowledgements (if applicable).
%
	\ackPlaceDate{Medellín, 2017}
%
%% -------------------------------------------------------------------
%% Approval information
%
	\examinationDate{ Date:}
	\approvalStatement{Approved by \hspace{2.0 cm}}
%
%% -------------------------------------------------------------------
%% Copyright Year
%
	\copyrightYear{2025}
%
%% -------------------------------------------------------------------
%% Name of first examiner
%
%	\firstExaminer{Professor A}
	\firstExaminer{\hspace{5.0 cm}}
%
%% -------------------------------------------------------------------
%% Title of first examiner
%
	\firstExaminerTitle{}
%
%% -------------------------------------------------------------------
%% Name of second examiner
%
	\secondExaminer{\hspace{5.0 cm}}
%
%% -------------------------------------------------------------------
%% Title of second examiner
%
	\secondExaminerTitle{}
%%
%%
%%%%%%%%%%%%%%%%%%%%%%%%%%%%%%%%%%%%%%%%%%%%%%%%%%%%%%%%%%%%%%%%%%%%%%
%% THESIS COLORS: 
%%%%%%%%%%%%%%%%%%%%%%%%%%%%%%%%%%%%%%%%%%%%%%%%%%%%%%%%%%%%%%%%%%%%%%
%%
%% Color for cover and chapters
	\chaptercolor{brown!75!magenta}
%%
%% Color for appendices
	\appendixcolor{brown!80!magenta}
%%
%% hyperlink color (ignored if the "hyperref" option is omitted)
    	\hyperlinkcolor{red!55!brown}
%%
%% Thesis title foreground color in cover page (ignored if the "plain" option is used)
    	\titlecolor{white}
%%
%% Thesis title background color in cover page (ignored if the "plain" option is used)
    	\titlebackgroundcolor{brown!85!magenta}  
%%
%%
%%%%%%%%%%%%%%%%%%%%%%%%%%%%%%%%%%%%%%%%%%%%%%%%%%%%%%%%%%%%%%%%%%%%%%
%% COVER PAGE IMAGE: 
%%%%%%%%%%%%%%%%%%%%%%%%%%%%%%%%%%%%%%%%%%%%%%%%%%%%%%%%%%%%%%%%%%%%%%
%%
%% Cover page image (optional)
%% If no cover page image is required, set argument to blank, or comment-out the \coverpageimage macro.
%%
%% Syntax:
%%          \coverpageimage{scale factor}{path to cover page image}
%%      or
%%          \coverpageimage[tikz]{scale factor}{TikZ commands}
%%          (commands may include \usetikzlibrary statements, etc.)
%%      
%% Examples:
%%      - Use the image in "figures/rdf.png" scaled by 0.8 (=80%):
%%          \coverpageimage{0.8}{figures/rdf.png}
%%      - Use a TikZ drawing scaled by 0.5 (=50%):
%%          \coverpageimage[tikz]{0.5}{
%%              \draw[thick, magenta] \foreach \x in {18,90,...,306} {
%%                  (\x:4) node{} -- (\x+72:4)
%%                  (\x:4) -- (\x:3) node{}
%%                  (\x:3) -- (\x+15:2) node{}
%%                  (\x:3) -- (\x-15:2) node{}
%%                  (\x+15:2) -- (\x+144-15:2)
%%                  (\x-15:2) -- (\x+144+15:2)
%%              };
%%          }
%%
     \coverpageimage{0.4}{figures/neutrino_mass_diagram}
     %\coverpageimage{0.3}{figures/bullet2}  
     \vspace{2.0 cm}
%%
%%
%%%%%%%%%%%%%%%%%%%%%%%%%%%%%%%%%%%%%%%%%%%%%%%%%%%%%%%%%%%%%%%%%%%%%%
%% MISCELLANEOUS SETTINGS: 
%%%%%%%%%%%%%%%%%%%%%%%%%%%%%%%%%%%%%%%%%%%%%%%%%%%%%%%%%%%%%%%%%%%%%%
%%
% Path to University Logo (all supported formats are allowed)
	%\UniversityLogoPath{logo/teikal_logo.eps}
	\UniversityLogoPath{figures/logo-udea}
%
% Path to University Logo (grayscale version to be used with the `printer' option)
	\UniversityBWLogoPath{figures/logo-udea.eps}
%
% Scalefactor for University logos (1 for 100%)
	\LogoScaleFactor{1.1}
% Draft Indication (watermark text to be used with the `watermark' option)
	\draftIndication{}%poner algo debajo de superviso en la primera hoja
%
% Frontispiece settings (ignored if the `frontispiece' option is omitted)
%	Syntax: \setFrontispiece[scale factor]{path to frontispiece image}{frontispiece image legend}
	\setFrontispiece[0.3]{figures/logo-udea}{Universidad de Antioquia} %figura detras de la primera página ---> GUITARRA
	
\begin{document}
\maketitle
\beginfrontmatter

\include{abstract}
% Dedication
	\thesisDedication{Para mi familia y amigos.
	\\Especial dedicación a mi familia por todo su apoyo durante estos años.}
% Acknowledgements (content in `acknowledgements.tex')
	%\include{acknowledgements}
% Table of Contents
	\tableofcontents
% List of Figures
	%\listoffigures
% List of Illustrations
	%\listofillustrations
% List of Tables
	%\listoftables
% Preface (content in `preface.tex') 
	%\include{preface}
	
\beginmainmatter

\end{document}

%%%%%%%%%%%%%%%%%%%%%%%%%%%%%%%%%%%%%%%%%%%%%%%%%%%%
