Agustin586/AWG-RP2040/img/10VPP_100KHZ_SENOIDAL.pdf

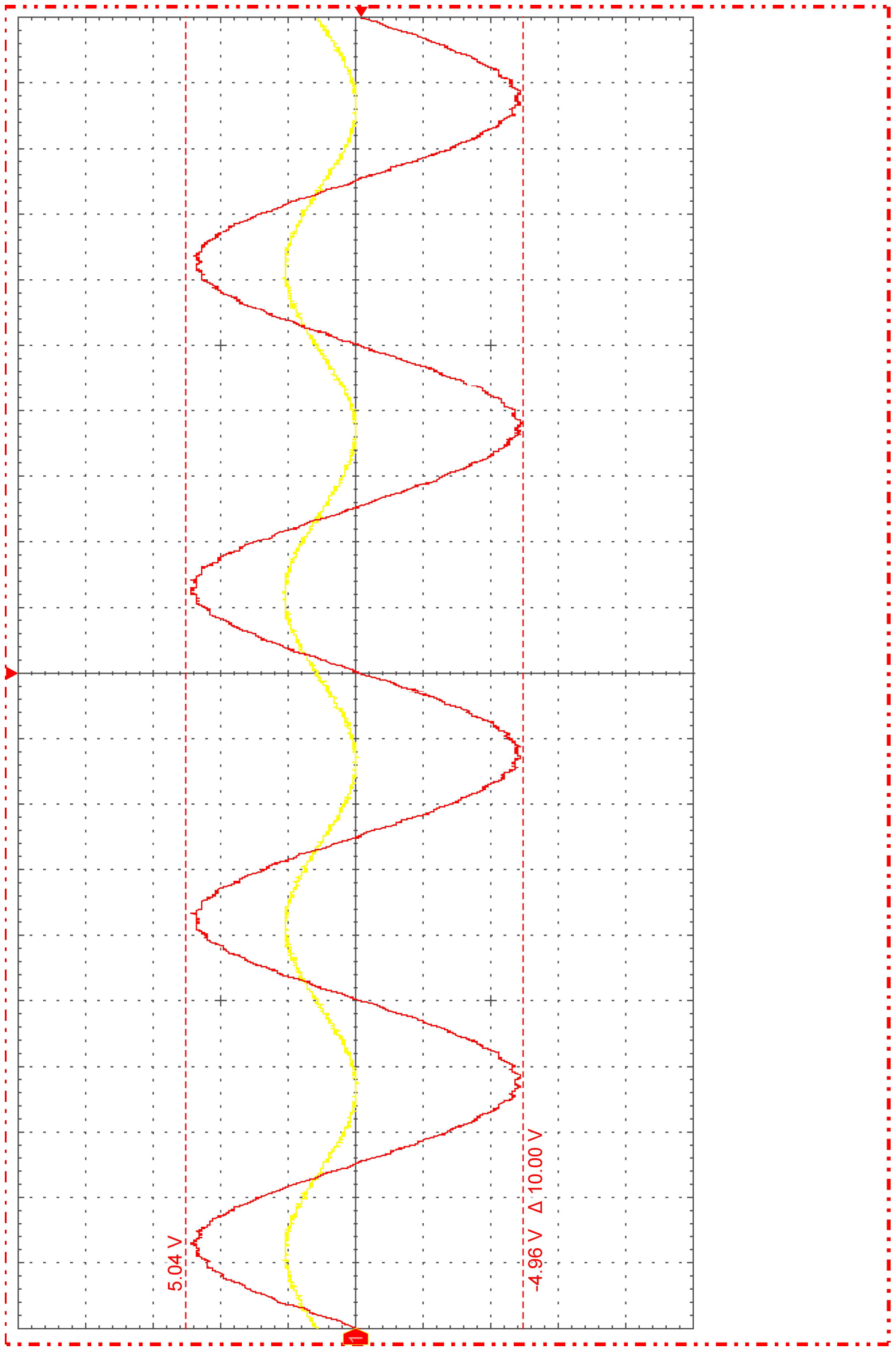
[picture p62: page 1]
