Agustin586/AWG-RP2040/img/10VPP_1KHZ_SENOIDAL.pdf

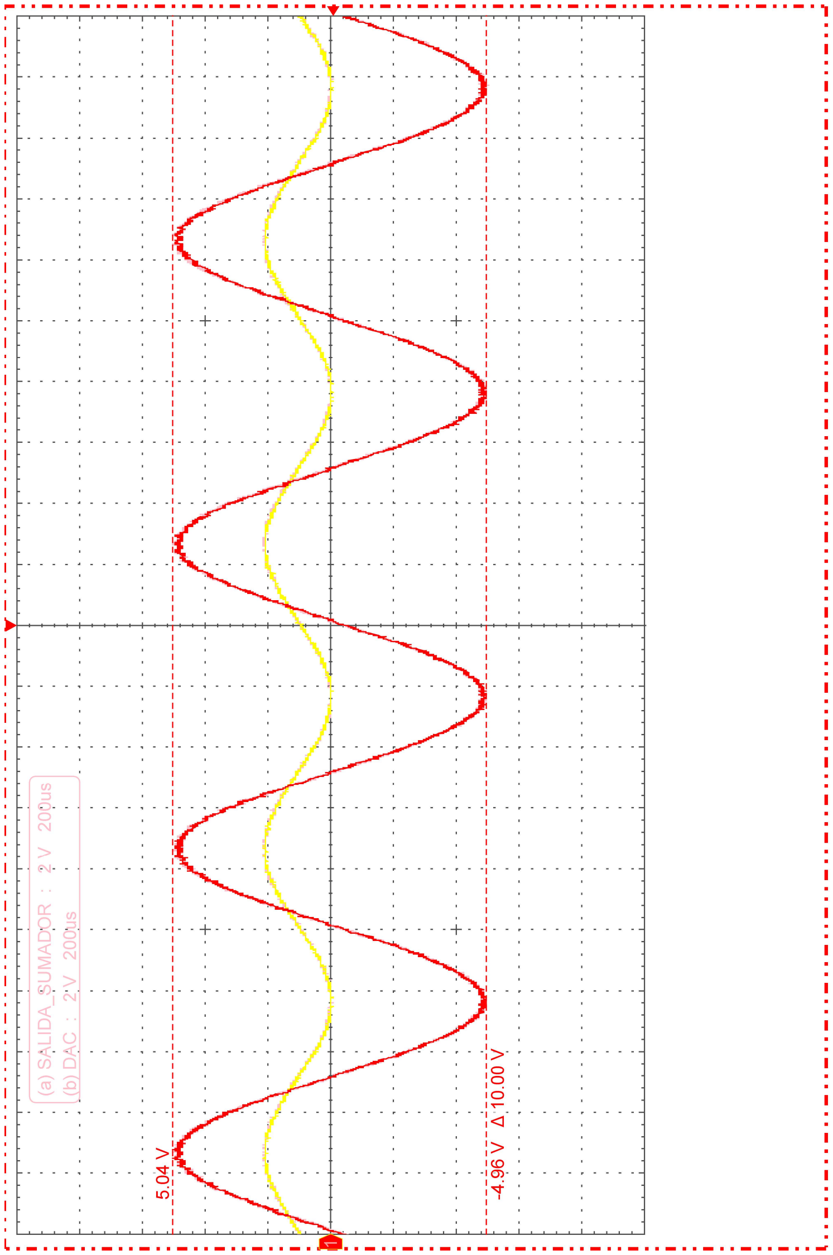
[picture p63: page 1]
