Agustin586/AWG-RP2040/img/10VPP_50KHZ_SENOIDAL.pdf

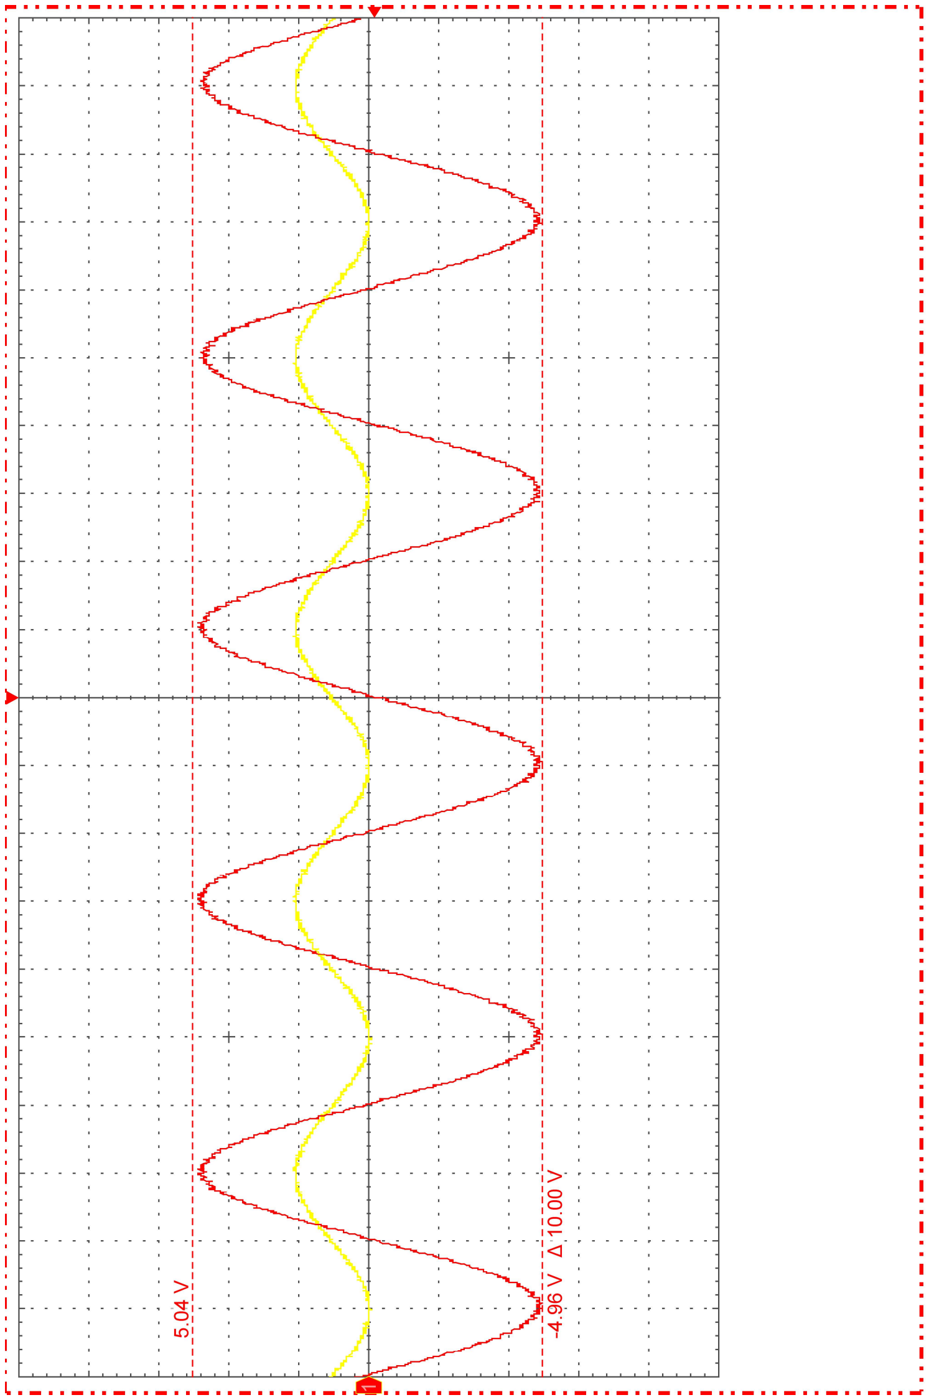
[picture p64: page 1]
