Agustin586/AWG-RP2040/img/1vpp.png

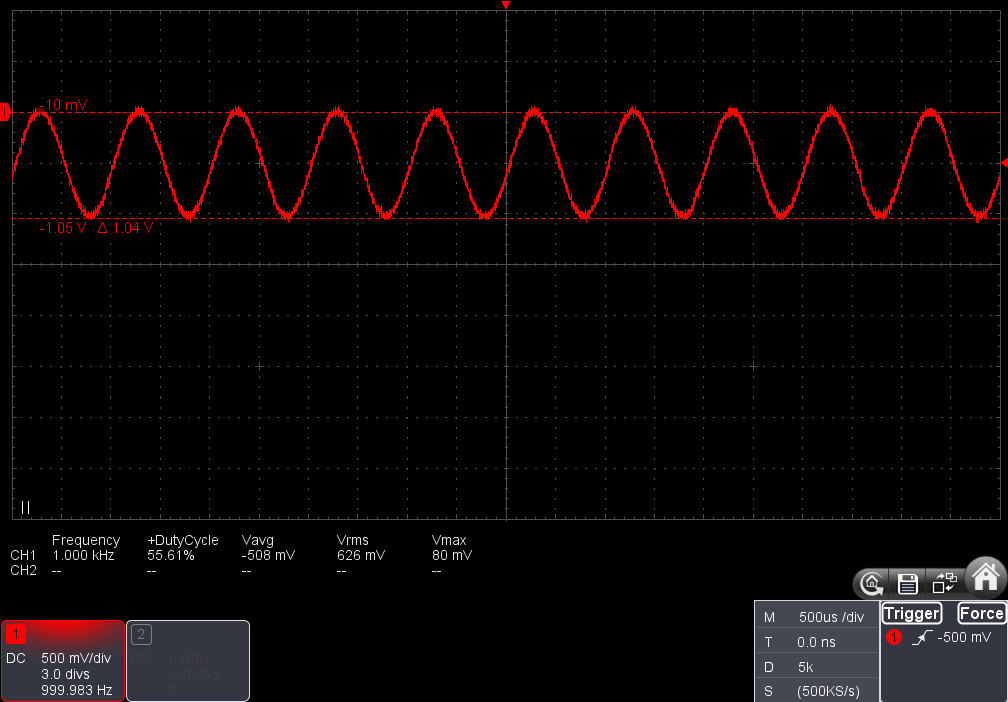
img/1vpp.png
