Agustin586/AWG-RP2040/img/10VPP_2.5VOFFSET_100KHZ_SENO.png

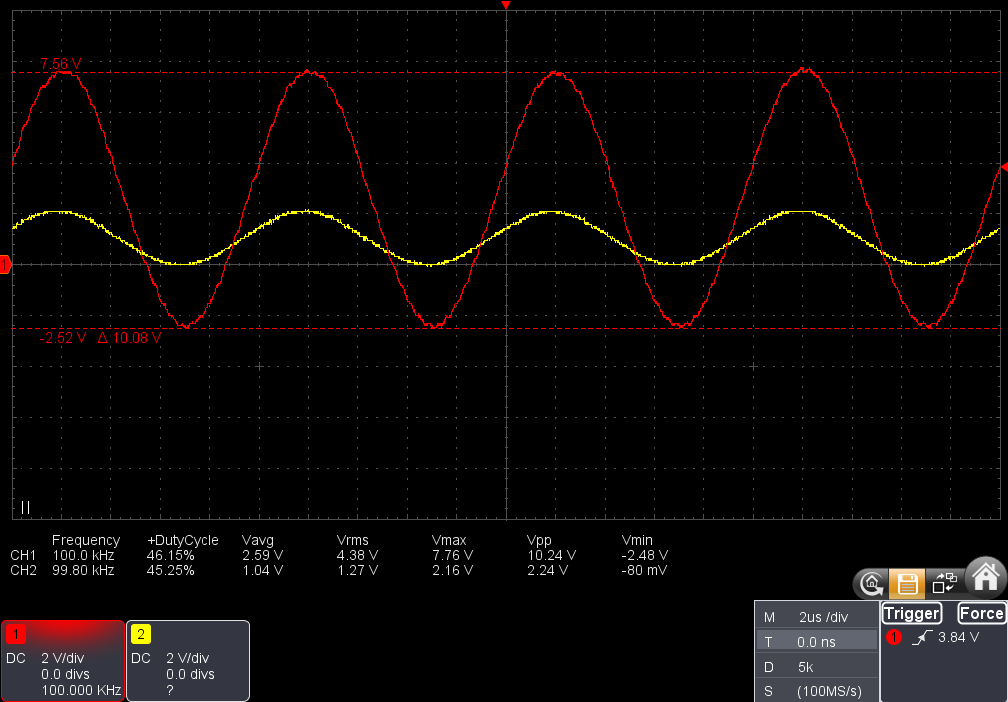
img/10VPP_2.5VOFFSET_100KHZ_SENO.png
