Agustin586/AWG-RP2040/img/10VPP_100KHZ_CUAD.png

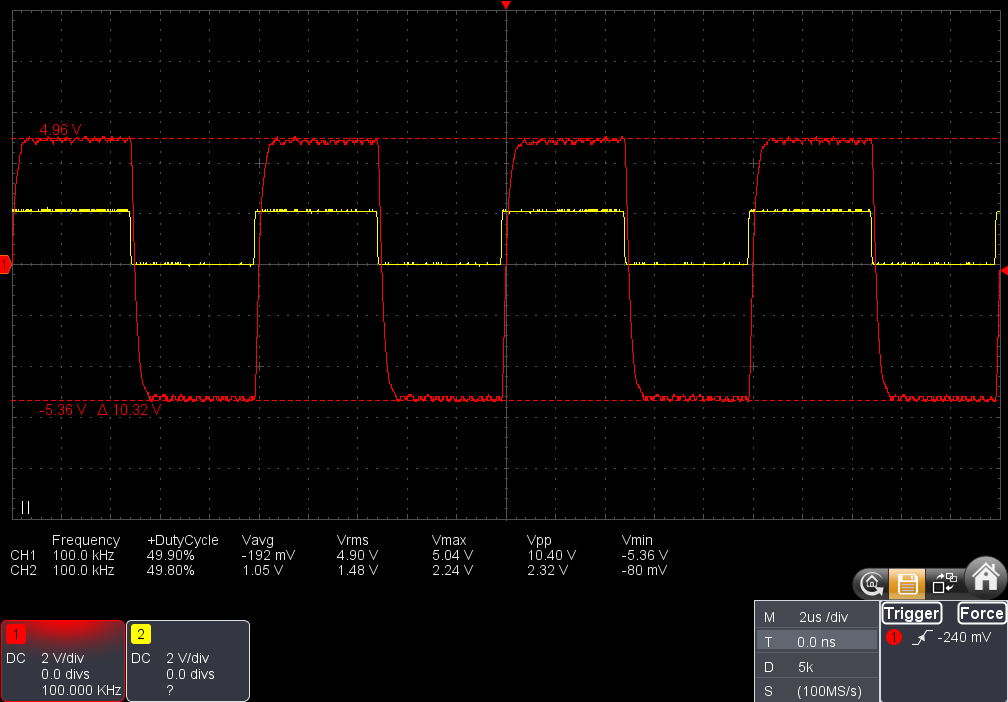
img/10VPP_100KHZ_CUAD.png
