Agustin586/AWG-RP2040/img/10VPP_100KHZ_SENOIDAL.png

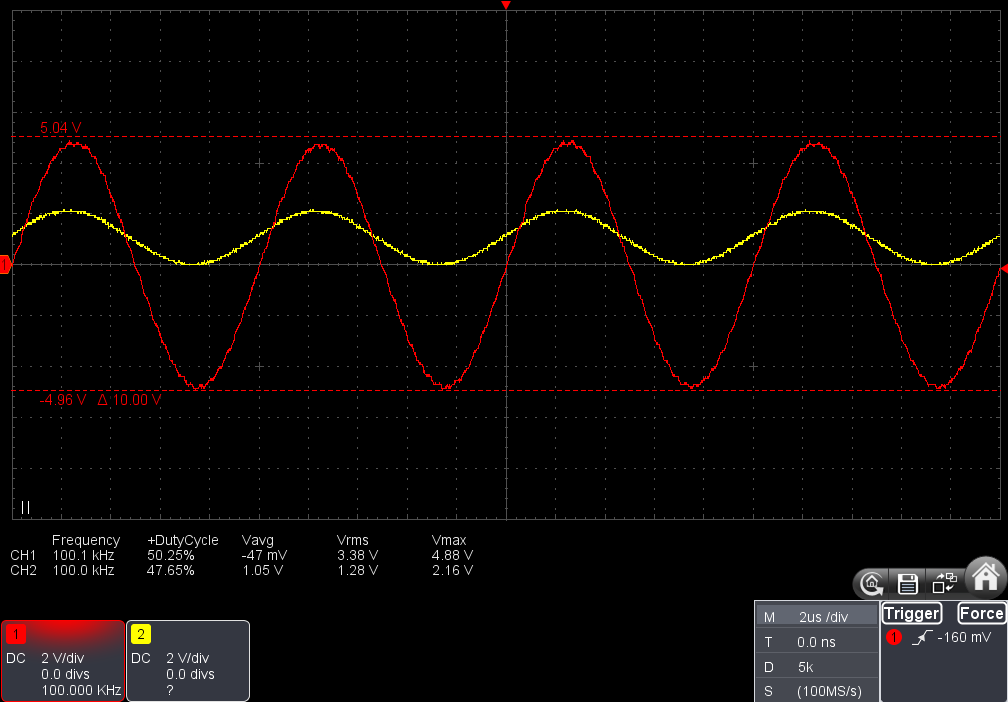
img/10VPP_100KHZ_SENOIDAL.png
