Agustin586/AWG-RP2040/img/10VPP_100KHZ_TRIAN.png

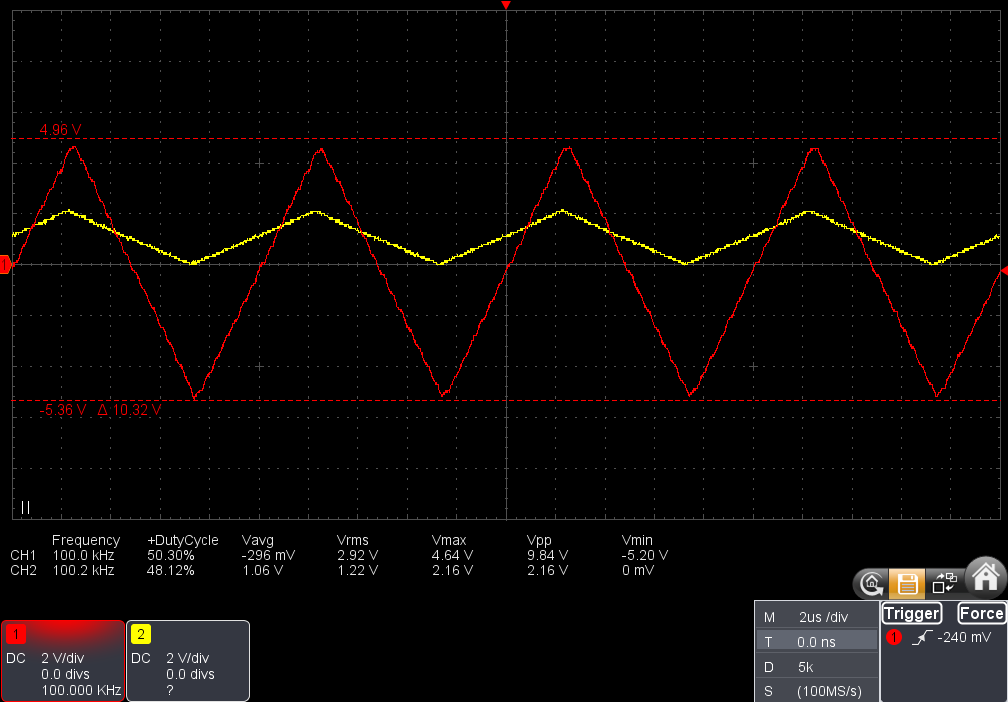
img/10VPP_100KHZ_TRIAN.png
