Agustin586/AWG-RP2040/img/10VPP_500KHZ_SENO.png

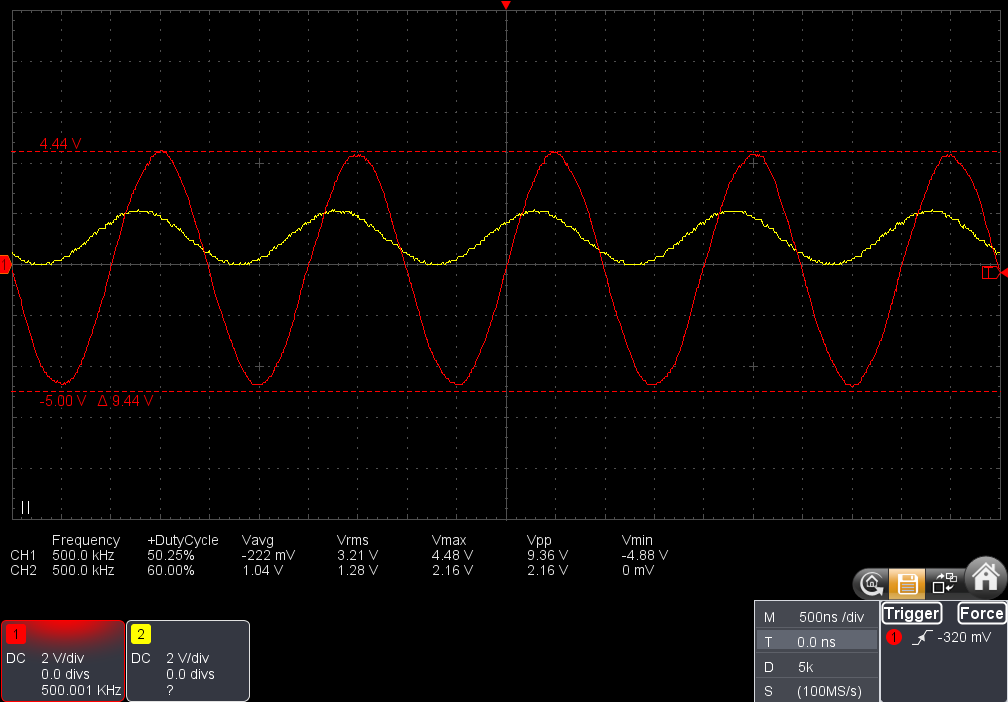
img/10VPP_500KHZ_SENO.png
