Agustin586/AWG-RP2040/img/IDEM.png

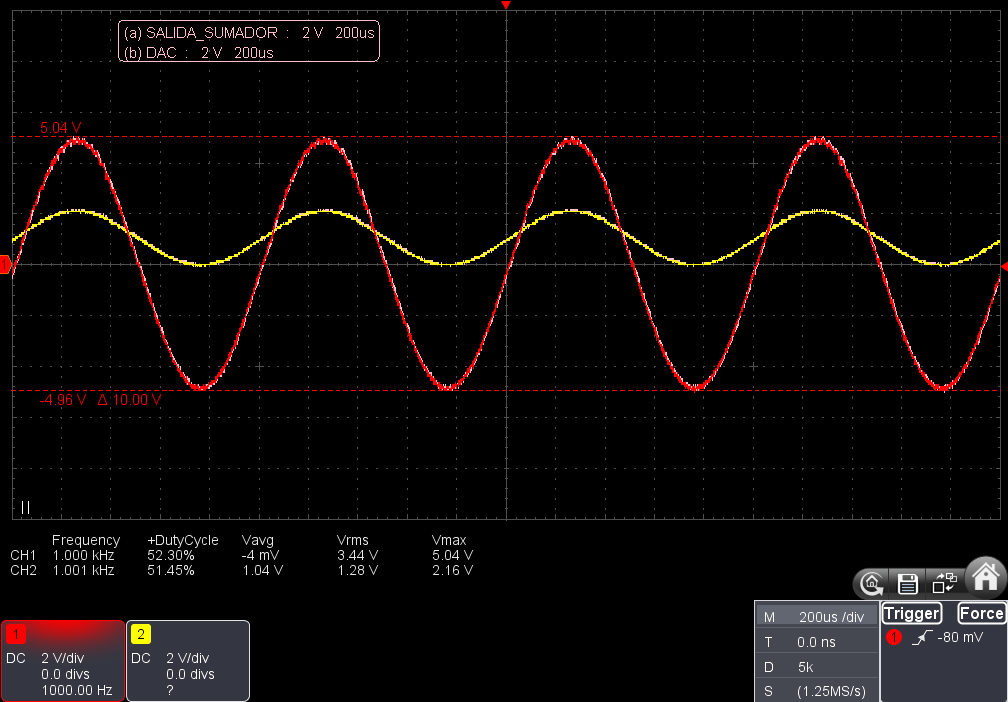
img/IDEM.png
