Agustin586/AWG-RP2040/img/UNSAM.jpg

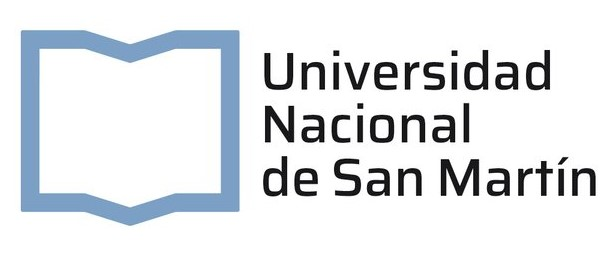
img/UNSAM.jpg
