Agustin586/AWG-RP2040/Presentacion SASE/img/encoder.jpg

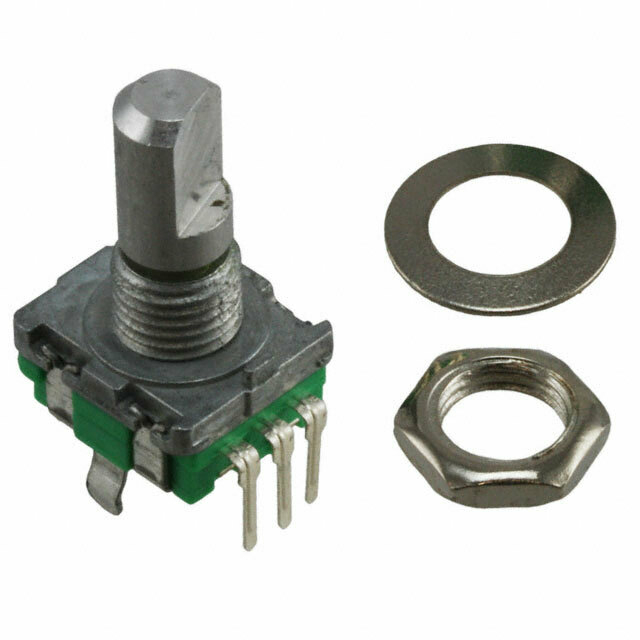
Presentacion SASE/img/encoder.jpg
