Agustin586/AWG-RP2040/Presentacion SASE/img/pcb.png

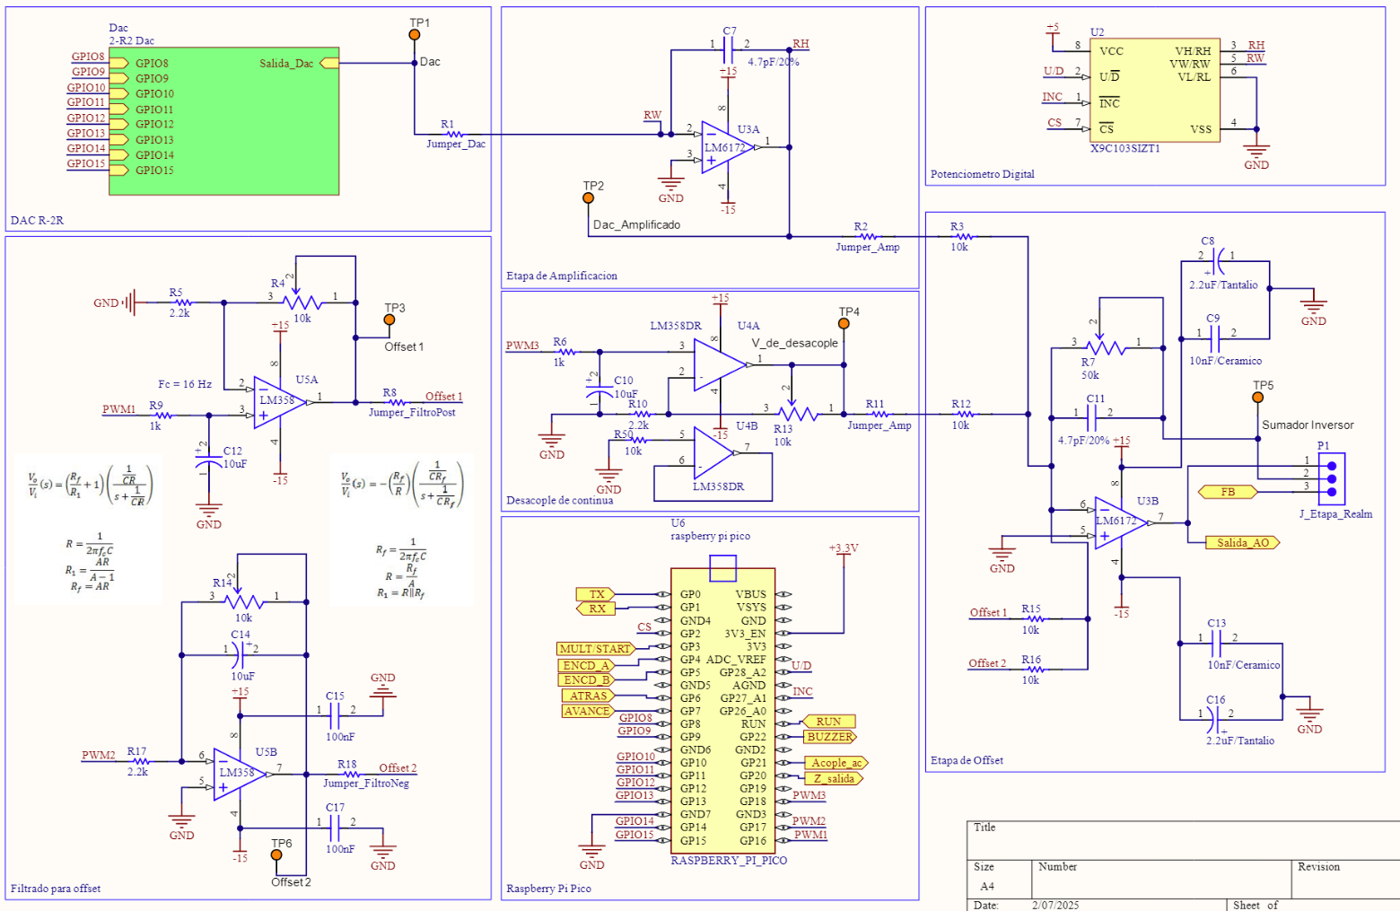
Presentacion SASE/img/pcb.png
