Agustin586/AWG-RP2040/Presentacion SASE/img/pio.png

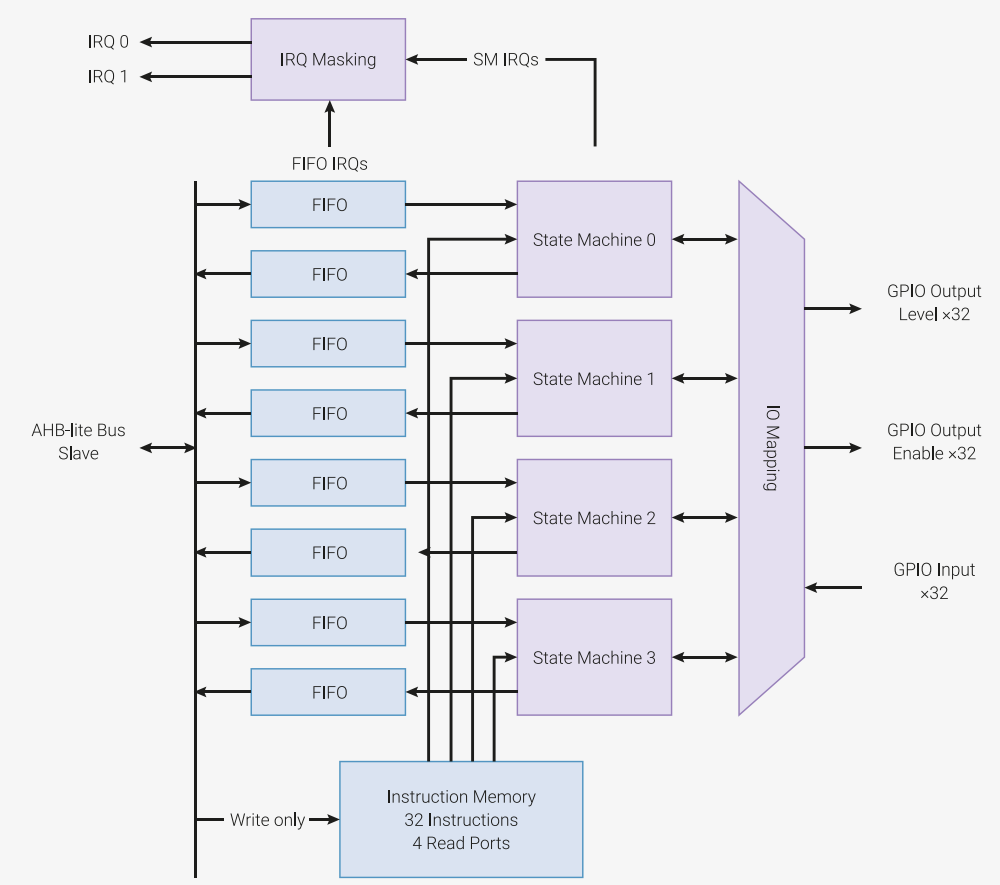
Presentacion SASE/img/pio.png
