Agustin586/AWG-RP2040/Tesis/Anteproyecto/Comparacion/img/Gaf-chino.png

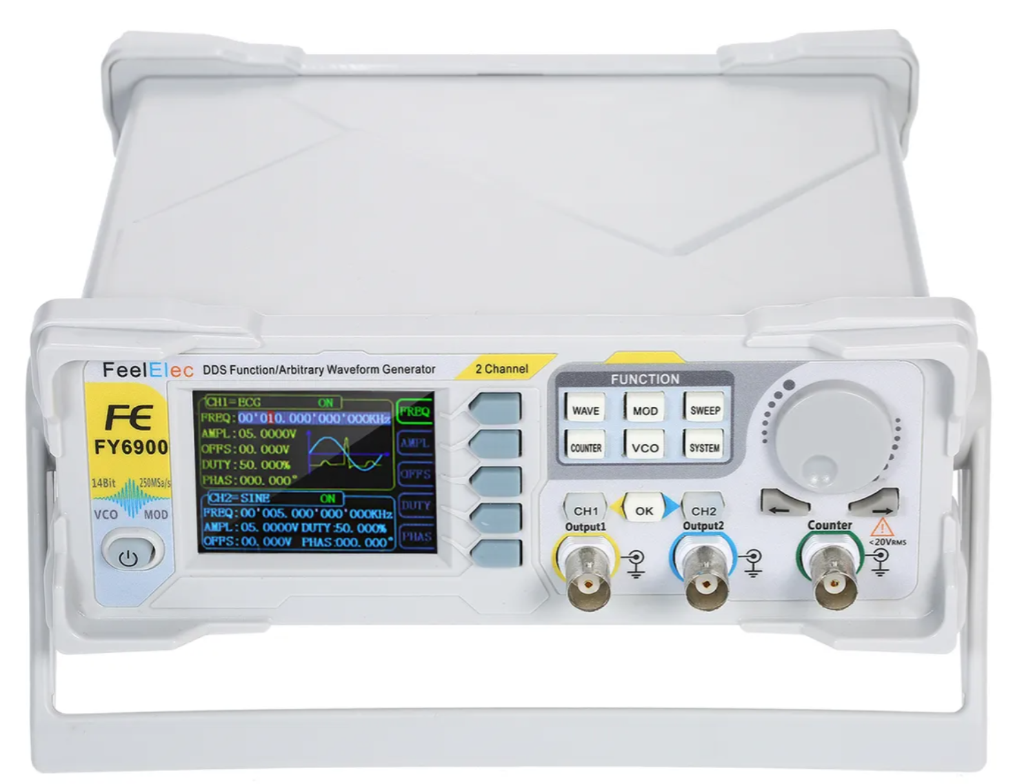
Tesis/Anteproyecto/Comparacion/img/Gaf-chino.png
