Agustin586/AWG-RP2040/Tesis/Anteproyecto/Comparacion/img/owon.png

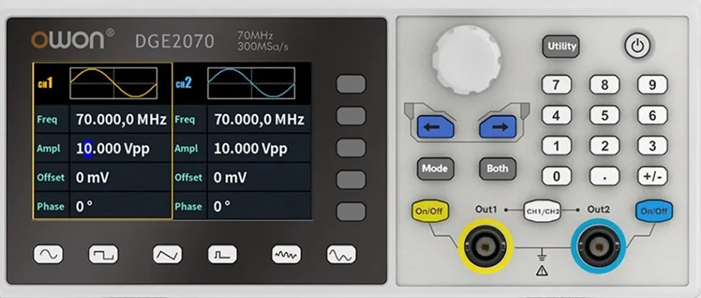
Tesis/Anteproyecto/Comparacion/img/owon.png
