Agustin586/AWG-RP2040/Tesis/Anteproyecto/Comparacion/img/unit-t.png

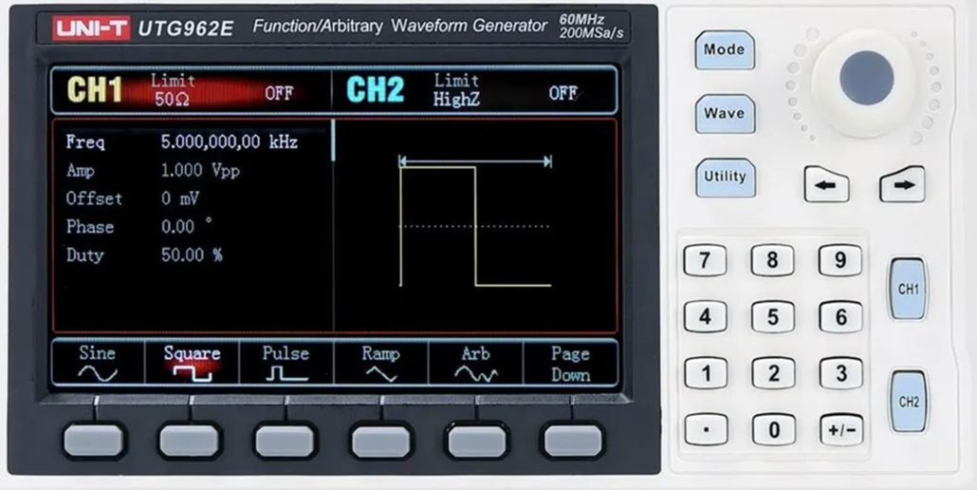
Tesis/Anteproyecto/Comparacion/img/unit-t.png
