Agustin586/AWG-RP2040/Tesis/Anteproyecto/img/AWG_DDS.png

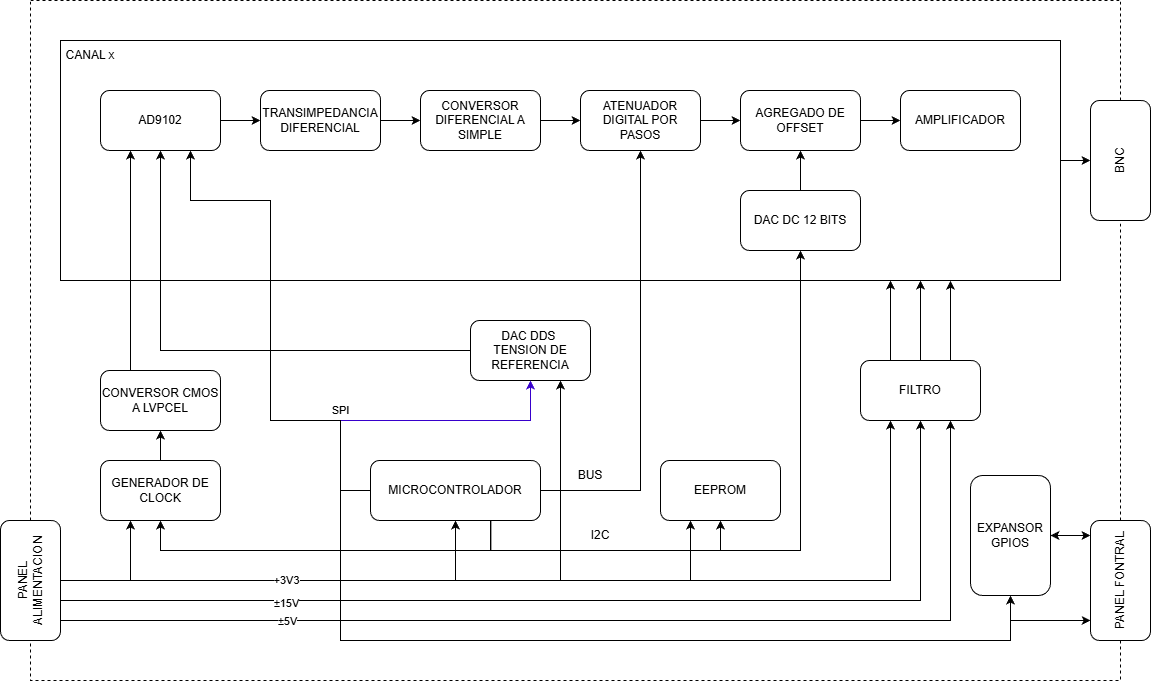
Tesis/Anteproyecto/img/AWG_DDS.png
