Agustin586/AWG-RP2040/Tesis/Anteproyecto/Introduccion/img/dds.png

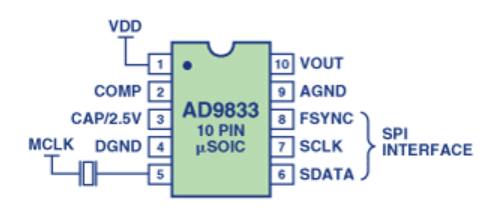
Tesis/Anteproyecto/Introduccion/img/dds.png
