Agustin586/AWG-RP2040/Tesis/Anteproyecto/Introduccion/img/DDS_AD9102.png

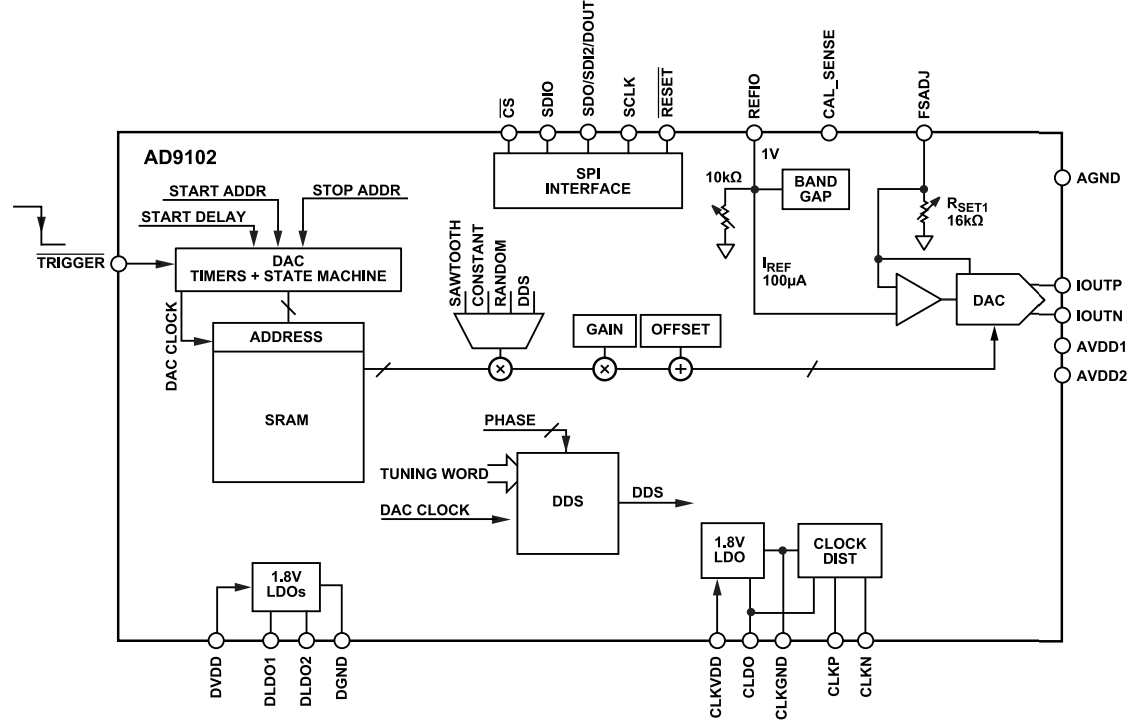
Tesis/Anteproyecto/Introduccion/img/DDS_AD9102.png
