Agustin586/AWG-RP2040/Tesis/Anteproyecto/Introduccion/img/pulso_gauseano.png

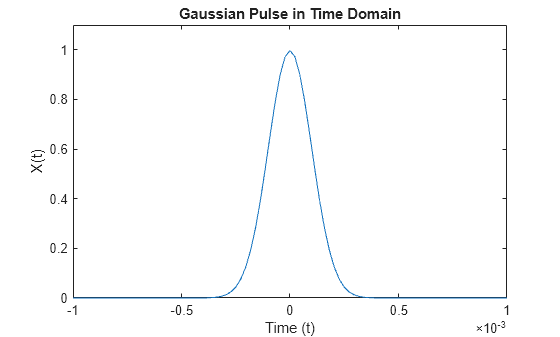
Tesis/Anteproyecto/Introduccion/img/pulso_gauseano.png
