Agustin586/AWG-RP2040/Tesis/Anteproyecto/Introduccion/img/r2r-4bits-2.png

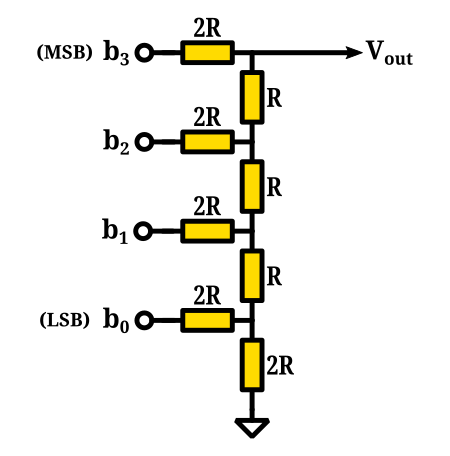
Tesis/Anteproyecto/Introduccion/img/r2r-4bits-2.png
