Agustin586/AWG-RP2040/Tesis/Anteproyecto/Introduccion/img/triangular.png

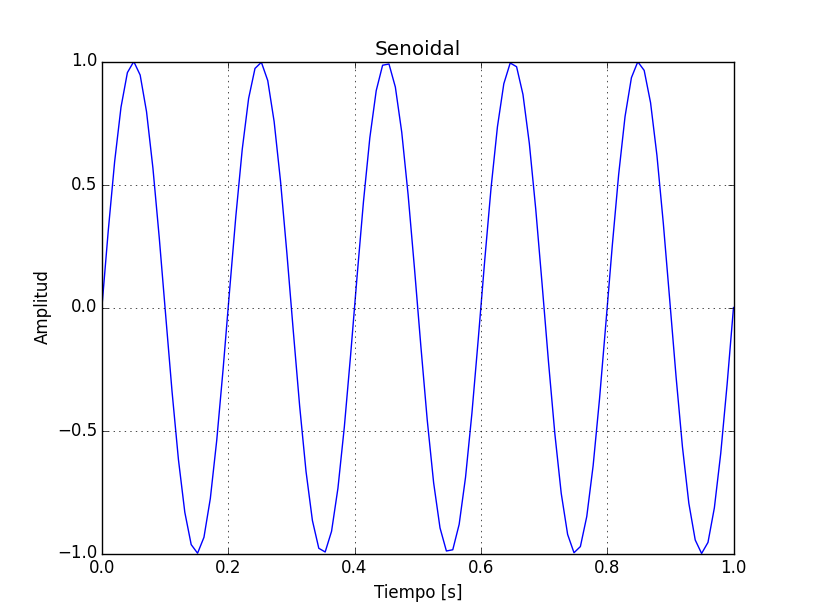
Tesis/Anteproyecto/Introduccion/img/triangular.png
