Agustin586/AWG-RP2040/Tesis/Anteproyecto/Introduccion/img/vias_stitching.png

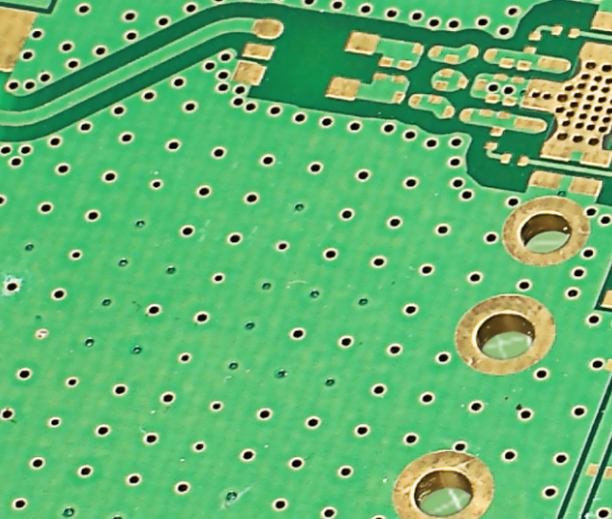
Tesis/Anteproyecto/Introduccion/img/vias_stitching.png
