Agustin586/AWG-RP2040/Tesis/Anteproyecto/pic/pid.png

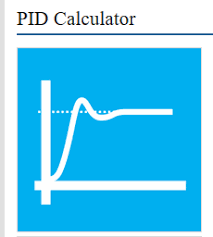
Tesis/Anteproyecto/pic/pid.png
