Agustin586/AWG-RP2040/Tesis/Extras/Funktionsgenerator-master/Funktionsgenerator-master/Bilder/Gerät/Hauptplatine.png

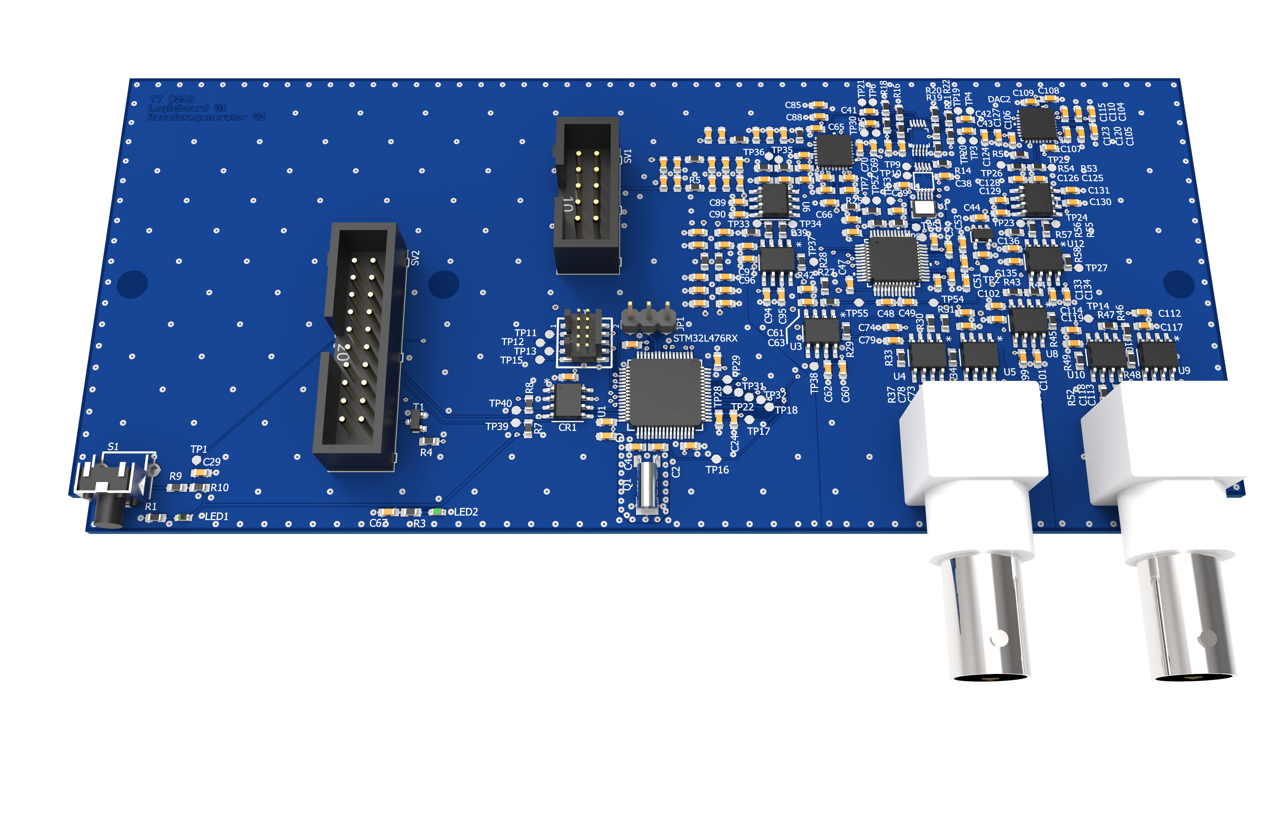
Tesis/Extras/Funktionsgenerator-master/Funktionsgenerator-master/Bilder/Gerät/Hauptplatine.png
