Agustin586/AWG-RP2040/Tesis/Extras/Funktionsgenerator-master/Funktionsgenerator-master/Bilder/Gerät/Netzteilplatine.png

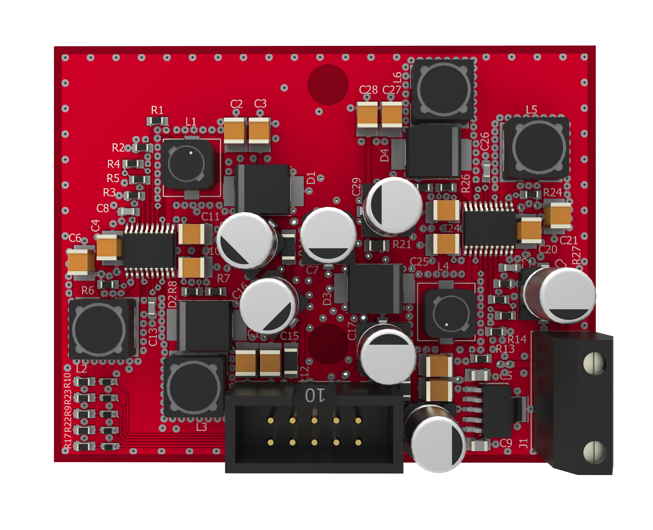
Tesis/Extras/Funktionsgenerator-master/Funktionsgenerator-master/Bilder/Gerät/Netzteilplatine.png
