Agustin586/AWG-RP2040/PCB/PCB_Fuente/Fuente.V01.R00/Project Outputs for Fuente.V01.R00/BOM/Bill of Materials-Fuente.V01.R00.xlsx

Comment | Description | Designator | Footprint | LibRef | Quantity
LT8471IFE#PBF | DC/DC CONVERTER, MULTITOPOLOGY, 50V, TSSOP-20; Supply Voltage:50V; No. of Step-Down DC - DC Converters:2; No. of LDO Regulators:-; No. of Regulated Outputs:2; Digital IC Case:TSSOP; No. of Pins:20Pins; Operating Temperature Min:-40CRoHS Compliant: Yes | B1, B2 | SOP65P640X120-21N | LT8471IFE#PBF | 2
2.2uF 50V | Capacitor | C1, C2, C3, C14, C15, C16 | MBASx31x | MBASU31LSB7225KTNA01 | 6
47uF 35V | CAP ALUM 47UF 20% 35V SMD | C4, C10, C11, C17, C23, C24, C27 | FP-FK-D-MFG | CMP-05427-000002-1 | 7
4.7uF 20V | CAP CER 1UF 10V X7R 1206 | C5, C6, C7, C8, C9, C18, C19, C20, C21, C22 | FP-CC1206-1_25-MFG | CMP-03422-001171-1 | 10
100nF 50V | CAP CER 0.1UF 50V X7R 1206 | C12, C13, C25, C26 | FP-C1206C-EB-MFG | CMP-03020-005759-1 | 4
10uF 25V | CAP 10uF 25V ±20% 1812 (4532 Metric) Thickness 2.8mm SMD | C28, C29 | CAPC1812(4532)280_L | CMP-1040-01657-2 | 2
SL43-E3/57T | DIODE SCHOTTKY 30V 4A DO214AB | D1, D3 | FP-95402-MFG | CMP-02539-000070-1 | 2
SL43 | DIODE SCHOTTKY 30V 4A DO214AB | D2, D4 | FP-95402-MFG | CMP-02539-000070-1 | 2
MBRS360T3G | Schottky Power Rectifier, 2-Pin SMC, Pb-Free, Tape and Reel | D5, D6 | ONSC-SMC-2-403-03_V | CMP-1055-00394-1 | 2
SMAJ24CA | Transient Voltage Suppressor, 6.40 to 231 V, 24 V Stand-off Voltage, Bi-Directional, -55 to 155 degC, 2-pin DO-214AC, Pb-Free, Tape and Reel | D7, D8 | VISH-DO-214AC-2_N | CMP-0548-00269-2 | 2
PWR +15V | SML-LX0805UWC-TR White LED, 0805 Diffused, Rectangle Lens SMD package | D9, D10, D11, D12, D13 | FP-SML-LX0805UWC-TR-MFG | CMP-00229-00139794-1 | 5
0468001.NR | FUSE BOARD MNT 1A 63VAC/VDC 1206 | F1 | FP-0468-MFG | CMP-2000-05753-2 | 1
2920L110/60MR | PTC RESET FUSE 60V 1.1A 2920 | F2 | FP-2920L-MFG | CMP-08606-000028-1 | 1
IDC-PLACA CONTROL | CONN HEADER VERT 16POS 2.54MM | J1 | FP-SBH11-PBPC-D08-ST-BK-MFG | CMP-25680-000019-1 | 1
INPUT 24V | 111 Series 5MM Pitch Straight, Pcb Terminal Block, Through Hole, 2 Way | J2 | 691111710002 | CMP-1502-03262-3 | 1
15uH | Shielded Wirewound Inductor 15uH 20% 2.3A 91mΩ SMD | L1, L3, L4, L6 | FP-NR6045-MFG | CMP-14484-001063-1 | 4
10uH | Inductor Power Shielded Wirewound 10uH 20% 100KHz Ferrite 4.1A 32.5mΩ DCR T/R | L2, L5 | FP-NR10050-MFG | CMP-14484-000424-1 | 2
100K 5% | 124K 0.125W 1% 0805 (2012 Metric) SMD | R1, R2, R11, R12 | RESC0805(2012)_M | CMP-1013-00746-1 | 4
68K7 1% (69K) | 124K 0.125W 1% 0805 (2012 Metric) SMD | R3, R13 | RESC0805(2012)_M | CMP-1013-00746-1 | 2
180K 1% | 124K 0.125W 1% 0805 (2012 Metric) SMD | R4, R5, R14 | RESC0805(2012)_M | CMP-1013-00746-1 | 3
4K75 1% | 124K 0.125W 1% 0805 (2012 Metric) SMD | R6, R16 | RESC0805(2012)_M | CMP-1013-00746-1 | 2
170K 1% (169K) | 124K 0.125W 1% 0805 (2012 Metric) SMD | R7, R17 | RESC0805(2012)_M | CMP-1013-00746-1 | 2
10K 1% | 124K 0.125W 1% 0805 (2012 Metric) SMD | R8, R9, R19 | RESC0805(2012)_M | CMP-1013-00746-1 | 3
316K 1% | 124K 0.125W 1% 0805 (2012 Metric) SMD | R15 | RESC0805(2012)_M | CMP-1013-00746-1 | 1
59K 1% | 124K 0.125W 1% 0805 (2012 Metric) SMD | R18 | RESC0805(2012)_M | CMP-1013-00746-1 | 1
1K2 5% | 124K 0.125W 1% 0805 (2012 Metric) SMD | R22, R23, R25, R26 | RESC0805(2012)_M | CMP-1013-00746-1 | 4
2K2 5% | 124K 0.125W 1% 0805 (2012 Metric) SMD | R24 | RESC0805(2012)_M | CMP-1013-00746-1 | 1
TPS7A4533DCQT | Single Output Fast Transient Response LDO, 1.5 A, Fixed 3.3 V Output, 2.1 to 20 V Input, 6-pin SOT-223 (DCQ), -40 to 125 degC, Green (RoHS & no Sb/Br) | U1 | DCQ0006A_M | CMP-0395-00359-2 | 1
