Agustin586/AWG-RP2040/PCB/Carrito Excel/Carritodecomprasguardado_ene.17_1007a. m..xls

CARRITO:1/17/2026 10:06:54
Mouser N.º | Fabricante N.º | Fabricante | Ref. Cliente | Descripción | RoHS | Ciclo de vida | Cantidad pedida | Precio (ARS) | Ext.: (ARS)
576-0468001.NR | 0468001.NR | Littelfuse |  | Fusibles de montaje en superficie 1A Slo-Blo | En conformidad con la RoHS |  | 1 | $ 1.588,86 | $ 1.588,86
576-04661.75NR | 04661.75NR | Littelfuse |  | Fusibles de montaje en superficie 63V 1.75A VFA Slimline | En conformidad con la RoHS |  | 1 | $ 1.031,94 | $ 1.031,94
584-LT8471IFE#PBF | LT8471IFE#PBF | Analog Devices Inc. |  | Reguladores de voltaje de conmutación 2x Multitopology DC/DC Convs w/ 2A Switc | En conformidad con la RoHS |  | 2 | $ 24.324,30 | $ 48.648,60
660-RN73H2TD6732B25 | RN73H2ATTD6732B25 | KOA Speer |  | Resistores de película fina - SMD | En conformidad con la RoHS |  | 10 | $ 468,47 | $ 4.684,70
963-BASU31LSB7225KT | MBASU31LSB7225KTNA01 | TAIYO YUDEN |  | Capacitores cerámicos de capas múltiples (MLCC) - SMD/SMT 50V 2.2uF X7R 1206 10% Industrial | En conformidad con la RoHS |  | 10 | $ 353,81 | $ 3.538,10
963-NR10050T100M | NR10050T100M | TAIYO YUDEN |  | Inductores de potencia - SMD 963-LSXBH10050HL100M RPLCMT PN 10uH 1005 20% LOW PROFILE | En conformidad con la RoHS |  | 4 | $ 1.113,84 | $ 4.455,36
625-SL43-E3 | SL43-E3/57T | Vishay |  | Rectificadores y diodos Schottky 4.0 Amp 30 Volt | En conformidad con la RoHS por exención |  | 4 | $ 1.900,08 | $ 7.600,32
80-C1206C104K5RAUTO | C1206C104K5RACAUTO | KEMET |  | Capacitores cerámicos de capas múltiples (MLCC) - SMD/SMT 50V 0.1uF X7R 1206 10% AEC-Q200 | En conformidad con la RoHS |  | 100 | $ 70,43 | $ 7.043,00
963-NRS6045T150MMGK | NRS6045T150MMGK | TAIYO YUDEN |  | Inductores de potencia - SMD 963-LSXND6060YEL150M RPLCMT PN 6045 15uH 91mOhms 1900mA | En conformidad con la RoHS |  | 10 | $ 345,62 | $ 3.456,20
667-EEE-FK1V470P | EEE-FK1V470P | Panasonic |  | Capacitores electrolíticos de aluminio - SMD 47uF 35V | En conformidad con la RoHS |  | 10 | $ 366,91 | $ 3.669,10
80-C1812C106M3R | C1812C106M3RACTU | KEMET |  | Capacitores cerámicos de capas múltiples (MLCC) - SMD/SMT 25volts 10uF X7R 20% | En conformidad con la RoHS |  | 2 | $ 1.736,28 | $ 3.472,56
584-AD9102BCPZ | AD9102BCPZ | Analog Devices Inc. |  | Conversores digitales a analógicos - DAC 14 bit Single Channel DAC | En conformidad con la RoHS |  | 1 | $ 60.180,12 | $ 60.180,12
579-MCP4725A0TECH | MCP4725A0T-E/CH | Microchip |  | Conversores digitales a analógicos - DAC Sngl 12B NV DAC | En conformidad con la RoHS |  | 2 | $ 2.080,26 | $ 4.160,52
625-SMAJ24CA-E3/5A | SMAJ24CA-E3/5A | Vishay |  | Diodos de protección contra ESD / Diodos TVS 400W 24V 5% Bi | En conformidad con la RoHS por exención |  | 5 | $ 573,30 | $ 2.866,50
576-2920L110/60MR | 2920L110/60MR | Littelfuse |  | Fusibles reajustables - PPTC 60V 1.1A-HD 20A 1210 | En conformidad con la RoHS |  | 2 | $ 1.097,46 | $ 2.194,92
863-MBRS360T3G | MBRS360T3G | onsemi |  | Rectificadores y diodos Schottky 3A 60V | En conformidad con la RoHS por exención |  | 10 | $ 350,53 | $ 3.505,30
640-USB4125-GF-A-190 | USB4125-GF-A-0190 | GCT |  | Conectores USB USB C Rec GF RA 6P SMT TH Stakes 1.9mm | En conformidad con la RoHS |  | 10 | $ 809,17 | $ 8.091,70
640-USB4105-GF-A | USB4105-GF-A | GCT |  | Conectores USB USB Type C,2.0, Rec,SMT, 0.95mmTH Shell Stakes,G/F,RA,Top Mnt,T&R | En conformidad con la RoHS |  | 10 | $ 1.077,80 | $ 10.778,00
279-CRGCQ0805F5K6 | CRGCQ0805F5K6 | TE Connectivity |  | Resistores de película gruesa - SMD CRGCQ 0805 5K6 1% SMD Resistor | En conformidad con la RoHS por exención |  | 10 | $ 34,40 | $ 344,00
279-CRGP0805F10K | CRGP0805F10K | TE Connectivity |  | Resistores de película gruesa - SMD CRGP 0805 10K 1% SMD Resistor | En conformidad con la RoHS por exención |  | 10 | $ 111,38 | $ 1.113,80
863-MBR120VLSFT1G | MBR120VLSFT1G | onsemi |  | Rectificadores y diodos Schottky 1A 20V | En conformidad con la RoHS por exención |  | 10 | $ 388,21 | $ 3.882,10
