Agustin586/AWG-RP2040/PCB/PCB_Control/PCB_Control/Project Outputs for PCB_Control.V03.R00/PCB_Control.V03.R00.xlsx

Comment | Description | Designator | Footprint | LibRef | Quantity
MCP23S17-E_SS | I/O Port Expander 16-Bit SPI SSOP28 | B1 | SOP65P780X200-28N | MCP23S17-E_SS | 1
LMH6612MAX_NOPB | Single Supply, Dual 345 MHz Rail-to-Rail Output Amplifier | B2, B4 | SOIC127P600X175-8N | LMH6612MAX_NOPB | 2
THS4271D | Super-Fast Ultra-Low Distortion High Speed Amplifier | B3, B5, B8, B9, B10, B11 | SOIC127P600X175-8N | THS4271D | 6
USBLC6-2SC6 | TVS Diode Array Uni-Directional USBLC6-2SC6 17V, SOT-23 6-Pin | B6 | SOT95P280X145-6N | USBLC6-2SC6 | 1
W25Q128JVSIM_TR | 3V 128M-BIT SERIAL FLASH MEMORY WITH DUAL/QUAD SPI & QPI & DTR | B7 | SOIC127P790X216-8N | W25Q128JVSIM_TR | 1
OPA4197ID | 36-V, Precision, Rail-to-Rail Input Output, Low Offset Voltage Op Amp | B12 | SOIC127P600X175-14N | OPA4197ID | 1
PE4312C-Z | RF ATTENUATOR 31.5DB 50OHM 20QFN | B13, B14 | QFN50P400X400X90-21N-D | PE4312C-Z | 2
SI5351A-B-GTR | Clock Generator 10MHz to 100MHz-IN 160MHz-OUT 10-Pin MSOP T/R | B15 | SOP50P490X110-10N | SI5351A-B-GTR | 1
AD9102BCPZ | Analog Devices AD9102BCPZ, 14 bit Serial DAC, 180Msps, 32-Pin LFCSP | B16, B17 | QFN50P500X500X80-33N-D | AD9102BCPZ | 2
DAC8562SDGSR | 16-bit, dual-channel, low-power, ultra-low glitch, voltage output DAC with 2.5V, 4ppm/C reference | B18 | SOP50P490X110-10N | DAC8562SDGSR | 1
W5500 | Ethernet ICs 3in1 Enet Controller TCP/IP +MAC+PHY | B19 | QFP50P900X900X160-48N | W5500 | 1
100n | Capacitor SMD 0805 | C1, C4, C5, C6, C9, C10, C11, C14, C15, C16, C19, C20, C21, C22, C25, C26, C27, C28, C30, C32, C34, C36, C38, C40, C42, C45, C47, C49, C50, C52, C54, C55, C57, C59, C60, C62, C64, C65, C88, C90, C91, C92, C94, C96, C98, C100, C101, C102, C104, C106, C111, C112, C113, C114, C137, C138, C147, C149, C151, C161, C163, C165, C167, C168, C169, C170, C171, C172, C176, C178, C180, C182, C189, C190, C191, C192, C193, C194, C195, C198 | CAP_0805 | CAP_0805 | 80
10u | Capacitor SMD 0805 | C2, C3, C7, C8, C12, C13, C17, C18, C23, C24, C29, C31, C33, C35, C37, C39, C41, C43, C44, C46, C48, C51, C53, C56, C58, C61, C63, C87, C89, C93, C95, C97, C99, C103, C105, C196, C197 | CAP_0805 | CAP_0805 | 37
0.1u | Capacitor SMD 0805 | C66, C68, C107, C108, C109, C110, C116, C124, C127, C135 | CAP_0805 | CAP_0805 | 10
10u_0603 | Capacitor SMD Tantalum 0603 | C67, C69 | CAP_TANT_0603 | CAP_TANT_0603 | 2
10u | WCAP-ASLI Radial Can - SMD aluminum electrolytic capacitor 0.248Dia 6.30mm ±20% 10muF 80V | C70, C71 | WCAP-ASLI_D6.3H7.7 | CMP-03913-89507488-2 | 2
2.2uF | CC0603 2.2 uF X5R 10.00% 16 V | C72 | FP-CC0603-DA-MFG | CMP-03422-000187-1 | 1
4.7uF | Chip Multilayer Ceramic Capacitors for General Purpose, 0805, 4.7uF, X6S, 22%, 20%, 35V | C73 | FP-GRM21B-0_15-IPC_A | CMP-06035-033280-1 | 1
100n | CC0805KKX7RYBB104 Capacitor Ceramic 0.01uF 250V X7R 10% 0805 T/R | C74, C75, C76, C77, C78, C79, C80, C81, C82, C84, C139, C140, C141, C142, C143, C144, C153, C154, C155, C156, C157, C158 | FP-CC0805-EB-MFG | CMP-00621-107850848-1 | 22
1u |  | C83 | CAPC2013X140X50NL20T25 | CMP-2007-04663-1 | 1
15p |  | C85, C86 | CAPC2013X94X50NL20T25 | CMP-1036-01049-2 | 2
100p | Capacitor SMD 0805 | C115, C117, C118, C119, C120, C121, C122, C123, C125, C126, C128, C129, C130, C131, C132, C133, C134, C136, C148, C150, C152, C162, C164, C166 | CAP_0805 | CAP_0805 | 24
8.2p | Capacitor SMD 0805 | C145, C146, C159, C160 | CAP_0805 | CAP_0805 | 4
1u | Capacitor SMD 0805 | C173, C175, C177, C179, C181 | CAP_0805 | CAP_0805 | 5
150n | Capacitor SMD 0805 | C174 | CAP_0805 | CAP_0805 | 1
22n | Capacitor SMD 0805 | C183 | CAP_0805 | CAP_0805 | 1
6.8n | Capacitor SMD 0805 | C184, C185 | CAP_0805 | CAP_0805 | 2
1n 2KV | Capacitor SMD 0805 | C186 | CAP_0805 | CAP_0805 | 1
10n | Capacitor SMD 0805 | C187, C199 | CAP_0805 | CAP_0805 | 2
15p | Capacitor SMD 0805 | C188 | CAP_0805 | CAP_0805 | 1
4.7u | Capacitor SMD 0805 | C200 | CAP_0805 | CAP_0805 | 1
ESD9B3.3ST5G | SZ Prefix for Automotive and Other Applications Requiring Unique Site and Control Change Requirements ; AECQ101 Qualified and PPAP Capable ; This is a PbFree Device; Low Capacitance 15 pF; Low Clamping Voltage; Small Body Outline Dimensions: 0.039 x 0.024 (1.0mm x 0.60mm); Low Body Height: 0.016 (0.4 mm); Response Time is < 1 ns; IEC6100042 Level 4 ESD Protection; Low Leakage | D1 | SODFL1006X40N | ESD9B3.3ST5G | 1
SMF5.0AT1G | 200 W Transient Voltage Suppressor, 2-Pin SOD-123FL, Pb-Free, Tape and Reel | D2, D3 | ONSC-SOD-123FL-2-498_V | CMP-1061-00612-1 | 2
SMBJ15A | TVS DIODE 15VWM 24.4VC SMB | D4, D10 | FP-SMBJ-MFG | CMP-07401-000033-1 | 2
GREEN | LED 0805 GREEN SMD | D5, D6, D7, D8, D9, D14 | LED_0805_GREEN | LED_0805_GREEN | 6
1N4148WSF-7 | DIODE GEN PURP 100V 250MA SOD323 | D11, D12 | FP-SOD323F-MFG | CMP-12791-000029-1 | 2
BLUE | LED 0805 BLUE SMD | D13 | LED_0805_BLUE | LED_0805_BLUE | 1
MBR120VLSFT1G | Guardring for Stress Protection; Optimized for Very Low Forward Voltage; 125 C Operating Junction Temperature; Epoxy Meets UL94, VO; Package Designed for Optimal Automated Board Assembly; ESD Rated Machine Model C; ESD Rated Human Body Model 3B; Device Meets MSL 1 Requirements; Pb-Free Packages are Available | D15, D16, D17, D18 | SODFL3616X98N | MBR120VLSFT1G | 4
ESDS312DBVR | 3.6V Data-Line Surge and 30kV ESD Protection Diode Array | D19, D20 | SOT95P280X145-5N | ESDS312DBVR | 2
FB0805 | Ferrite Bead SMD 0805 | FB1, FB2, FB3, FB4, FB5, FB7 | FB_0805 | FB_0805 | 6
MPZ1608S331ATA00 | Power line Ferrite Bead 330Ω @ 100MHz 1.7A DCR 0.08Ω SMD 0603 | FB6 | FP-MPZ1608-0_8-IPC_C | CMP-08257-000202-1 | 1
SBH11-PBPC-D08-ST-BK | CONN HEADER VERT 16POS 2.54MM | J1, J4, J6 | FP-SBH11-PBPC-D08-ST-BK-MFG | CMP-25680-000019-1 | 3
5413879-2 | BNC RF Interface, Jack, 50 ohm, Bayonet, 4 GHz Operating Frequency, Cable-to-Board, 1 Position, Printed Circuit Board, Board Mount / Panel Mount | J2, J3 | 54138792 | 5413879-2 | 2
NEXTION_PINS | Low Profile Socket Strips, Through-hole, Vertical, -55 to 125 degC, 2.54 mm Pitch, 4-Pin, Female, RoHS | J5 | SMTC-SLW-104-01-X-S | CMP-1023-00133-1 | 1
USB4105-GF-A | CONN RCPT USB2.0 TYPEC 5A | J7 | FP-USB4105-GF-A-MFG | CMP-245163-000001-1 | 1
DEBUG PINS | Modified .025" SQ Post Header, Through-hole, Right Angle, -55 to 125 degC, 2.54 mm Pitch, 3-Pin, Male, RoHS | J8 | SMTC-MTSW-103-08-X-S-229-RA | CMP-1024-00100-1 | 1
SSQ-103-01-T-S | CONN RCPT 3POS 0.1 TIN PCB | J9 | FP-SSQ-103-01-T-S-MFG | CMP-02766-001396-1 | 1
SI-60118-F | MagJack 10/100BASE-T | J10 | SI60118F | SI-60118-F | 1
Jumper | Jumper 2 Pins Through-Hole DO NOT PLACE | JMP1 | JMP2_TH | JMP2_TH | 1
BC817-40W-7 | NPN Small Signal Transistor, 45 V, 500 mA, -65 to 150 degC, 3-Pin SOT323, RoHS, Tape and Reel | Q1, Q2 | DIOD-SOT323-3_V | CMP-2000-05934-1 | 2
1K | Resistor SMD 0805 | R1, R2, R3, R4, R5, R49, R50 | RES_0805 | RES_0805 | 7
1K5 0.1% | Resistor SMD 0805 | R6, R9, R12, R15 | RES_0805 | RES_0805 | 4
300R 0.1% | Resistor SMD 0805 | R7, R10, R13, R16 | RES_0805 | RES_0805 | 4
100R 0.1% | Resistor SMD 0805 | R8, R11, R14, R17 | RES_0805 | RES_0805 | 4
1K 1% | Resistor SMD 0805 | R18, R20, R66, R69 | RES_0805 | RES_0805 | 4
50 Ohm | Resistor SMD 0805 | R19, R21 | RES_0805 | RES_0805 | 2
0 Ohm | Resistor SMD 0805 | R22, R23, R25, R26 | RES_0805 | RES_0805 | 4
49.9 0.1% | Resistor SMD 0805 | R24, R27, R73, R78 | RES_0805 | RES_0805 | 4
0R | Resistor SMD 0805 | R28, R29, R30, R31, R32, R33, R36, R37, R38, R39, R40, R41, R42, R43, R44, R45, R46, R59, R60, R61, R62, R74, R79, R90, R91, R92, R93, R96, R97, R98, R99, R100, R101, R102, R105, R106, R107, R132, R133, R134, R135, R137, R138, R139 | RES_0805 | RES_0805 | 44
10K | Resistor SMD 0805 | R34, R35, R47, R48, R94, R95, R103, R104, R136, R140, R141, R142, R143, R144, R145, R146, R147, R148, R154, R155 | RES_0805 | RES_0805 | 20
499 0.1% | Resistor SMD 0805 | R51, R54, R55, R58 | RES_0805 | RES_0805 | 4
249 0.1% | Resistor SMD 0805 | R52, R53, R56, R57, R109, R110, R112, R113 | RES_0805 | RES_0805 | 8
5K1 1% | Resistor SMD 0805 | R63, R64 | RES_0805 | RES_0805 | 2
33 1% | Resistor SMD 0805 | R65, R67 | RES_0805 | RES_0805 | 2
DFN | Resistor SMD 0805 | R68 | RES_0805 | RES_0805 | 1
1K 0.1% | Resistor SMD 0805 | R70, R71, R72, R75, R76, R77 | RES_0805 | RES_0805 | 6
100K | Resistor SMD 0805 | R80, R85 | RES_0805 | RES_0805 | 2
R0805 | Resistor SMD 0805 | R81, R82, R83, R84, R86, R87, R88, R89 | RES_0805 | RES_0805 | 8
10K 0.1% | Resistor SMD 0805 | R108, R111, R124, R127, R128, R131 | RES_0805 | RES_0805 | 6
120R | Resistor SMD 0805 | R114, R115, R116, R117 | RES_0805 | RES_0805 | 4
2K7 | Resistor SMD 0805 | R118, R119 | RES_0805 | RES_0805 | 2
82R | Resistor SMD 0805 | R120, R121, R122, R123 | RES_0805 | RES_0805 | 4
5K | Resistor SMD 0805 | R125, R129 | RES_0805 | RES_0805 | 2
33R | Resistor SMD 0805 | R126, R130, R156, R157, R160, R161 | RES_0805 | RES_0805 | 6
49.9R | Resistor SMD 0805 | R149, R150, R151, R158 | RES_0805 | RES_0805 | 4
330R | Resistor SMD 0805 | R152, R153 | RES_0805 | RES_0805 | 2
49.9R 1% | Resistor SMD 0805 | R159 | RES_0805 | RES_0805 | 1
1M | Resistor SMD 0805 | R162 | RES_0805 | RES_0805 | 1
22 R | Resistor SMD 0805 | R163, R165 | RES_0805 | RES_0805 | 2
12K4 1% | Resistor SMD 0805 | R164 | RES_0805 | RES_0805 | 1
0 R | Resistor SMD 0805 | R166, R167 | RES_0805 | RES_0805 | 2
22R | Resistor SMD 0805 | R168, R169, R170, R171, R172, R173, R174, R175, R176 | RES_0805 | RES_0805 | 9
10K | Resistor SMD 0603 | R177, R178 | RES_0603 | RES_0603 | 2
IM03GR | Low Power Consumption, High Dielectric, High Mechanical Shock Resistance, IM Relay | RLY1, RLY2 | TECO-IM-8G-WING | CMP-0439-00001-1 | 2
BOOT | SWITCH TACTILE SPST-NO 0.05A 24V | SW1 | FP-2-1977223-2-MFG | CMP-03407-000026-1 | 1
RESET | SWITCH TACTILE SPST-NO 0.05A 24V | SW2 | FP-2-1977223-2-MFG | CMP-03407-000026-1 | 1
THS3091DDARG3 | Single-High-Voltage, Low Distortion, Current-Feedback Operational Amplifier, 10 to 30 V, -40 to 85 degC, 8-pin SOP (DDA8), Green (RoHS & no Sb/Br) | U1, U2, U3, U4 | TI-DDA8-1775X1775TP_M | CMP-0018-00513-2 | 4
MCP4725A1T-E/CH | 12-Bit Digital-to-Analog Converter with EEPROM Memory in SOT-23-6, 6-Pin SOT-23, Extended Temperature, Tape and Reel | U5, U6 | SOT-23-CH6_N | CMP-0188-00759-2 | 2
NCP1117ST33T3G | Low-Dropout Positive Fixed Voltage Regulator, 1 A, 3.3 V Output Voltage, 0 to 125 degC, 4-Pin SOT-223 (318H-01), Pb-Free, Tape and Reel | U7 | ONSC-SOT-223-4-318H-01_A_V | CMP-1679-00010-1 | 1
W25Q16JVUXIQ | IC FLASH 16MBIT SPI/QUAD 8USON | U8 | FP-UX-MFG | CMP-78876-000011-1 | 1
RP2040 | 32-Bit Dual-Core ARM Cortex-M0+ Microcontroller | U9 | QFN-56-EP | RP2040 | 1
SY55857LKG | SY55857LKG SY55857L Series 3.3 V 2.5 Gbps ANY INPUT-to-LVPECL Dual Translator - MSOP-10 | U10 | FP-K10-1-IPC_A | CMP-00252-66526369-1 | 1
OPA2197IDR | IC OP AMP GP RR 10MHZ 8-SOIC | U11 | FP-D0008A-MFG | CMP-04895-000044-1 | 1
24LC1025T-E/SN | 1 Mbit, 400kHz, 2.5V, 8-Pin SOIC 150mil, Extended Temperature, Tape and Reel | U12 | SOIC-SN8_M | CMP-0159-00340-1 | 1
ABM8-272-T3 | Crystal, 12 MHz, SMD, 3.2mm x 2.5mm, 30 ppm, 10 pF, 30 ppm, ABM8 Series | X1 | ABM8272T3 | ABM8-272-T3 | 1
ABM8G-25.000MHZ-B4Y-T3 | Crystal 25MHz ±30ppm (Tol) ±30ppm (Stability) 10pF FUND 60Ω 4-Pin SMD T/R | Y1 | FP-ABM8G-MFG | CMP-27762-015306-1 | 1
ASE-25.000MHZ-LC-T | Crystal or Oscillator | Y2 | ASE24576MHZLCT | ASE-25.000MHZ-LC-T | 1
