Agustin586/AWG-RP2040/PCB/PCB_Control/PCB_Control/3D Model/PCB_Control.V03.R00.step

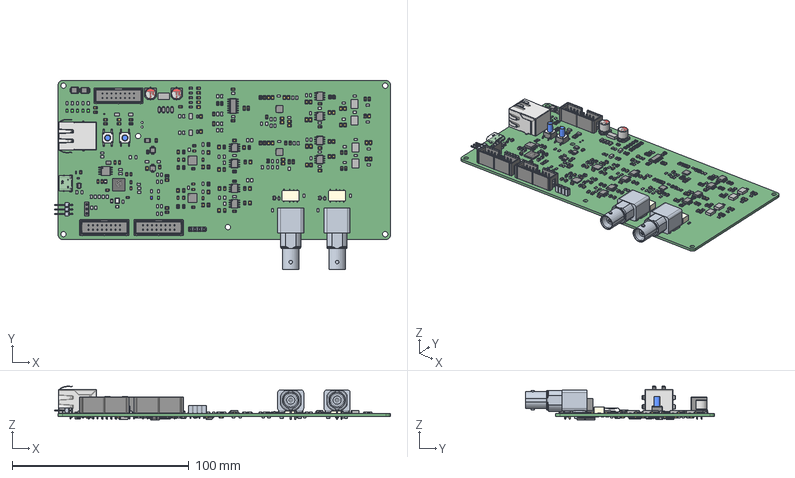
[picture p93: CAD file, 2026-04-12]
PCB/PCB_Control/PCB_Control/3D Model/PCB_Control.V03.R00.step
190.1 x 107.0 x 19.1 mm
SI-60118-F
R0805 x 176
ASE-25.000MHZ-LR-T
Abracon New Logo
BODY-SOT x 2
LEAD-SOT x 10
LEAD-DUMMY x 2
PinsArrayLR x 17
PinsArrayTB x 5
Diodes Inc. 1N4148WSF-7 1 x 2
Diodes Inc. 1N4148WSF-72 x 2
Diodes Inc. 1N4148WSF-72_MIR2 x 2
Diodes x 2
Termination
Marking
Logo
ABM8-272-T3
Extruded x 37
BODY-SO x 2
LEAD-D0008A x 8
Texas Logo
Texas Logo1
terminals x 2
logo x 6
RP2040
Base x 2
Steel Cover x 2
notch x 2
Actuator x 2
Leads x 2
TE x 2
Leader x 6
T1SSQ-103-01-T-S
P2SSQ-103-01-T-S
Samtec
MTSW-103-08-X-S-229-RA
USB4105-15-A_PART2
1_MIR
GCT
pins x 3
SLW-104-01-X-S
PinKIdent x 5
PinK x 5
PinA x 5
LED_0805_GREEN x 6
LED_0805_BLUE
Bourns Logo x 2
side x 44
Yageo Logo x 22
Murata Logo 3
name
capicitor_6.3x7.7x2.2 x 2
Base_Φ6_3Capacitor x 2
CAP_TANT_0603 x 2
ThermalPin x 4
LEAD-SO x 14
PIN1-ID
MCP23S17-E_SS
