Agustin586/AWG-RP2040/PCB/PCB_Fuente/Fuente.V01.R00/3D Model/PCB-Fuente.V01.R00.step

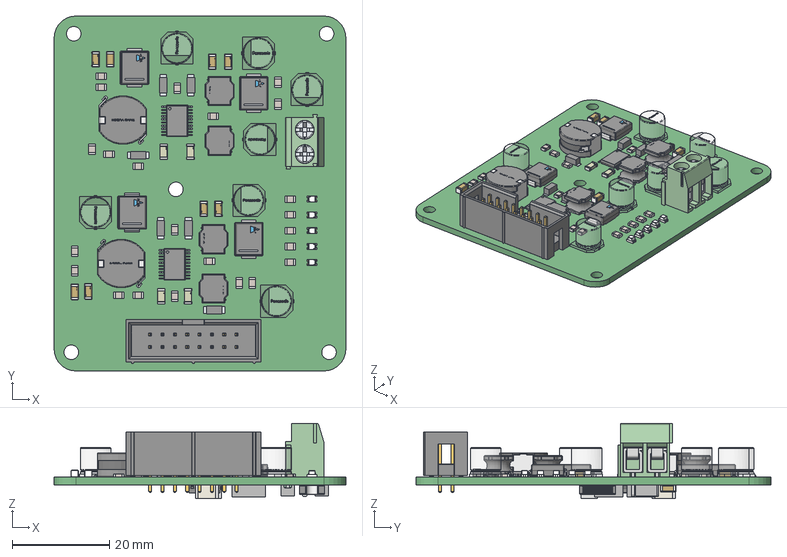
[picture p94: CAD file, 2026-04-12]
PCB/PCB_Fuente/Fuente.V01.R00/3D Model/PCB-Fuente.V01.R00.step
60.0 x 73.0 x 15.4 mm
Extruded x 79
BODY_MP06A
LEAD_MP06A x 5
LEAD_WIDE_MP06A
6911117100xx_CAGE x 2
6911117100xx_PIN x 2
6911117100xx_VIS+ x 2
Lead
Littelfuse
Lead_MIR2
Lumex Logo x 5
CAP003 x 7
CAP x 7
CAP001 x 7
CAP002 x 7
CAP004 x 7
Panasonic x 7
pins
logo x 3
Taiyo Yuden Logo adjustable x 4
core x 2
terminal x 4
wire_ x 4
Vishay logo x 4
Vishay logo - 1 x 4
Cap_KEMET_C1206C472K4RACTU_eec x 12
Pins x 6
PinsArrayLR x 2
ThermalPad x 2
