Agustin586/AWG-RP2040/PCB/PCB_Fuente/Libreria-MouserElectronics/LIB_LT8471IFE#PBF/LT8471IFE#PBF/3D/LT8471IFE#PBF.stp

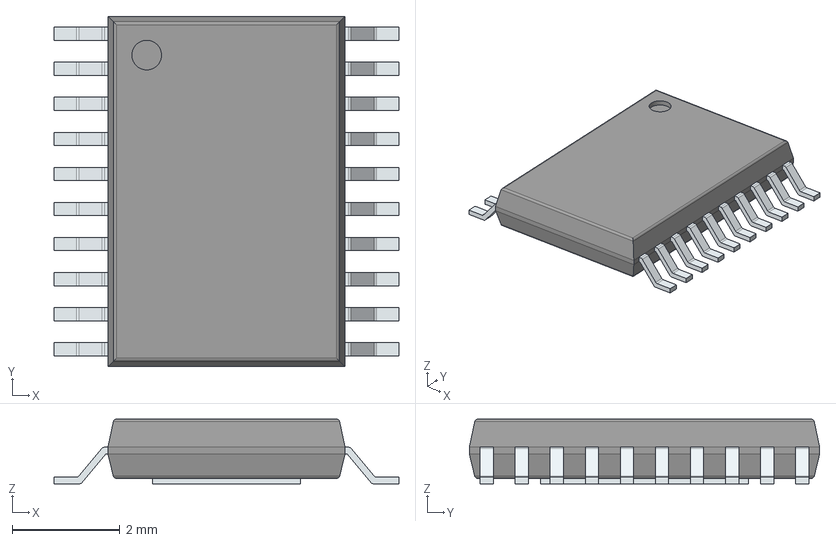
[picture p95: CAD file, 2026-04-12]
PCB/PCB_Fuente/Libreria-MouserElectronics/LIB_LT8471IFE#PBF/LT8471IFE#PBF/3D/LT8471IFE#PBF.stp
6.40 x 6.50 x 1.20 mm
PinsArrayLR
ThermalPad
