Agustin586/AWG-RP2040/PCB/PCB_Fuente/Libreria-MouserElectronics/LIB_MBASU31LSB7225KTNA01/MBASU31LSB7225KTNA01/3D/MBASU31LSB7225KTNA01.stp

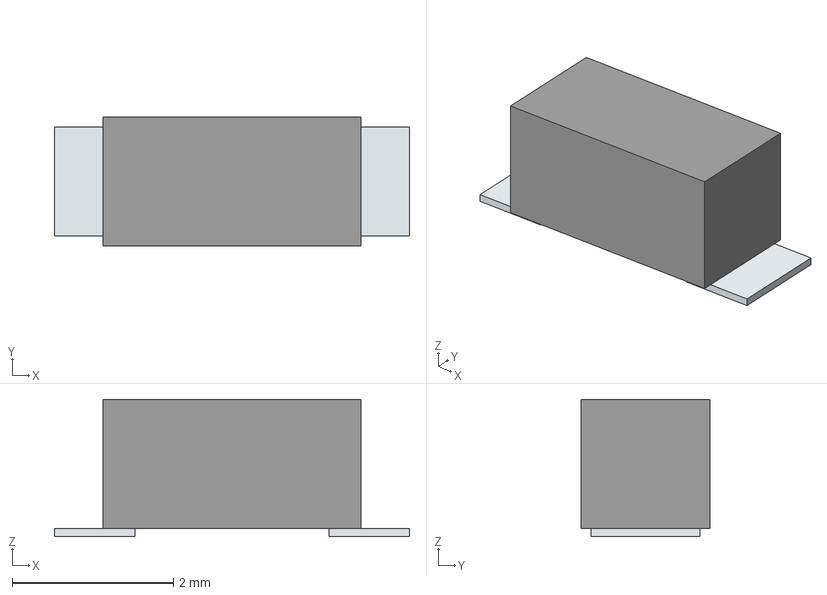
[picture p96: CAD file, 2026-04-12]
PCB/PCB_Fuente/Libreria-MouserElectronics/LIB_MBASU31LSB7225KTNA01/MBASU31LSB7225KTNA01/3D/MBASU31LSB7225KTNA01.stp
4.40 x 1.60 x 1.70 mm
Pins
