Agustin586/AWG-RP2040/(list of files, cad)

Other CAD files:
PCB/PCB_Control/Librerias/LIB_5227161-2_BNC/5227161-2/Allegro/52271612.psm
PCB/PCB_Control/Librerias/LIB_5227161-2_BNC/5227161-2/DEHDL/5227161_2/chips/chips.prt
PCB/PCB_Control/Librerias/LIB_5413879-2/5413879-2/DEHDL/5413879_2/chips/chips.prt
PCB/PCB_Control/Librerias/LIB_ABM8-272-T3/ABM8-272-T3/DEHDL/abm8_272_t3/chips/chips.prt
PCB/PCB_Control/Librerias/LIB_AD9102BCPZ/AD9102BCPZ/Allegro/qfn50p500x500x80-33n-d.psm
PCB/PCB_Control/Librerias/LIB_AD9102BCPZ/AD9102BCPZ/DEHDL/ad9102bcpz/chips/chips.prt
PCB/PCB_Control/Librerias/LIB_ASE-25.000MHZ-LC-T/ASE-25.000MHZ-LC-T/Allegro/ase24576mhzlct.psm
PCB/PCB_Control/Librerias/LIB_ASE-25.000MHZ-LC-T/ASE-25.000MHZ-LC-T/DEHDL/ase_25.000mhz_lc_t/chips/chips.prt
PCB/PCB_Control/Librerias/LIB_BLM21PG600SN1D/BLM21PG600SN1D/Allegro/blm21ag102bh1j.psm
PCB/PCB_Control/Librerias/LIB_BLM21PG600SN1D/BLM21PG600SN1D/DEHDL/blm21pg600sn1d/chips/chips.prt
PCB/PCB_Control/Librerias/LIB_DAC8562SDGSR/DAC8562SDGSR/Allegro/sop50p490x110-10n.psm
PCB/PCB_Control/Librerias/LIB_DAC8562SDGSR/DAC8562SDGSR/DEHDL/dac8562sdgsr/chips/chips.prt
PCB/PCB_Control/Librerias/LIB_ESD9B3.3ST5G/ESD9B3.3ST5G/Allegro/sodfl1006x40n.psm
PCB/PCB_Control/Librerias/LIB_ESD9B3.3ST5G/ESD9B3.3ST5G/DEHDL/esd9b3.3st5g/chips/chips.prt
PCB/PCB_Control/Librerias/LIB_ESDS312DBVR/ESDS312DBVR/Allegro/sot95p280x145-5n.psm
PCB/PCB_Control/Librerias/LIB_ESDS312DBVR/ESDS312DBVR/DEHDL/esds312dbvr/chips/chips.prt
PCB/PCB_Control/Librerias/LIB_IM03GR/IM03GR/Allegro/im06gr.psm
PCB/PCB_Control/Librerias/LIB_IM03GR/IM03GR/DEHDL/im03gr/chips/chips.prt
PCB/PCB_Control/Librerias/LIB_LMH6612MAX_NOPB/LMH6612MAX_NOPB/Allegro/soic127p600x175-8n.psm
PCB/PCB_Control/Librerias/LIB_LMH6612MAX_NOPB/LMH6612MAX_NOPB/DEHDL/lmh6612max_nopb/chips/chips.prt
PCB/PCB_Control/Librerias/LIB_MCP23S17-E_SS/MCP23S17-E_SS/Allegro/sop65p780x200-28n.psm
PCB/PCB_Control/Librerias/LIB_MCP23S17-E_SS/MCP23S17-E_SS/DEHDL/mcp23s17_e_ss/chips/chips.prt
PCB/PCB_Control/Librerias/LIB_OPA4197ID/OPA4197ID/Allegro/soic127p600x175-14n.psm
PCB/PCB_Control/Librerias/LIB_OPA4197ID/OPA4197ID/DEHDL/opa4197id/chips/chips.prt
PCB/PCB_Control/Librerias/LIB_P6SMBJ5.0CA/P6SMBJ5.0CA/Allegro/dionm5437x240n.psm
PCB/PCB_Control/Librerias/LIB_P6SMBJ5.0CA/P6SMBJ5.0CA/DEHDL/p6smbj5.0ca/chips/chips.prt
PCB/PCB_Control/Librerias/LIB_PE4312C-Z/PE4312C-Z/Allegro/qfn50p400x400x90-21n-d.psm
PCB/PCB_Control/Librerias/LIB_PE4312C-Z/PE4312C-Z/DEHDL/pe4312c_z/chips/chips.prt
PCB/PCB_Control/Librerias/LIB_RT6154AGQW/RT6154AGQW/Allegro/son50p300x400x80-15n-d.psm
PCB/PCB_Control/Librerias/LIB_RT6154AGQW/RT6154AGQW/DEHDL/rt6154agqw/chips/chips.prt
PCB/PCB_Control/Librerias/LIB_SI-60118-F/SI-60118-F/DEHDL/si_60118_f/chips/chips.prt
PCB/PCB_Control/Librerias/LIB_SI5351A-B-GTR/SI5351A-B-GTR/Allegro/sop50p490x110-10n.psm
PCB/PCB_Control/Librerias/LIB_SI5351A-B-GTR/SI5351A-B-GTR/DEHDL/si5351a_b_gtr/chips/chips.prt
PCB/PCB_Control/Librerias/LIB_THS4271D/THS4271D/Allegro/soic127p600x175-8n.psm
PCB/PCB_Control/Librerias/LIB_THS4271D/THS4271D/DEHDL/ths4271d/chips/chips.prt
PCB/PCB_Control/Librerias/LIB_USBLC6-2SC6/USBLC6-2SC6/DEHDL/usblc6_2sc6/chips/chips.prt
PCB/PCB_Control/Librerias/LIB_W25Q128JVSIM_TR/W25Q128JVSIM_TR/Allegro/soic127p790x216-8n.psm
PCB/PCB_Control/Librerias/LIB_W25Q128JVSIM_TR/W25Q128JVSIM_TR/DEHDL/w25q128jvsim_tr/chips/chips.prt
PCB/PCB_Control/Librerias/LIB_W5500/W5500/Allegro/qfp50p900x900x160-48n.psm
PCB/PCB_Control/Librerias/LIB_W5500/W5500/DEHDL/w5500/chips/chips.prt
PCB/PCB_Control/Librerias/Schottky/MBR120VLSFT1G/Allegro/sodfl3616x98n.psm
PCB/PCB_Control/Librerias/Schottky/MBR120VLSFT1G/DEHDL/mbr120vlsft1g/chips/chips.prt
PCB/PCB_Control/PCB_Control/3D Model/PCB_Control.V03.R00.DWG
PCB/PCB_Control/PCB_Control/3D Model/PCB_Control.V03.R00.x_t
PCB/PCB_Fuente/Libreria-MouserElectronics/LIB_LT8471IFE#PBF/LT8471IFE#PBF/Allegro/sop65p640x120-21n.psm
PCB/PCB_Fuente/Libreria-MouserElectronics/LIB_LT8471IFE#PBF/LT8471IFE#PBF/DEHDL/lt8471ife#pbf/chips/chips.prt
PCB/PCB_Fuente/Libreria-MouserElectronics/LIB_MBASU31LSB7225KTNA01/MBASU31LSB7225KTNA01/Allegro/mbasx31x.psm
PCB/PCB_Fuente/Libreria-MouserElectronics/LIB_MBASU31LSB7225KTNA01/MBASU31LSB7225KTNA01/DEHDL/mbasu31lsb7225ktna01/chips/chips.prt
