Agustin586/AWG-RP2040/Programa/STM32-Display_TFT/Codigo/firmware_panel/build/primary/sysbuild_modules.txt

"mcuboot":"D:/aguat/Documents/GitHub/STM32/zephyrProject/deps/bootloader/mcuboot":"D:/aguat/Documents/GitHub/STM32/zephyrProject/deps/bootloader/mcuboot/boot/zephyr/sysbuild"
