Agustin586/AWG-RP2040/Programa/STM32-Display_TFT/Codigo/firmware_panel/build/primary/zephyr_settings.txt

# WARNING. THIS FILE IS AUTO-GENERATED. DO NOT MODIFY!
#
# This file contains build system settings derived from your modules.
#
# Modules may be set via ZEPHYR_MODULES, ZEPHYR_EXTRA_MODULES,
# and/or the west manifest file.
#
# See the Modules guide for more information.
"DTS_ROOT":"D:/aguat/Documents/GitHub/STM32/zephyrProject/deps/modules/hal/stm32"
