Agustin586/AWG-RP2040/Tesis/Extras/Funktionsgenerator-master/Funktionsgenerator-master/Dokumentation/Bedienungsanleitung.pdf

## Ostbayerische Technische Hochschule Regensburg

## Fakultät Elektro- und Informationstechnik

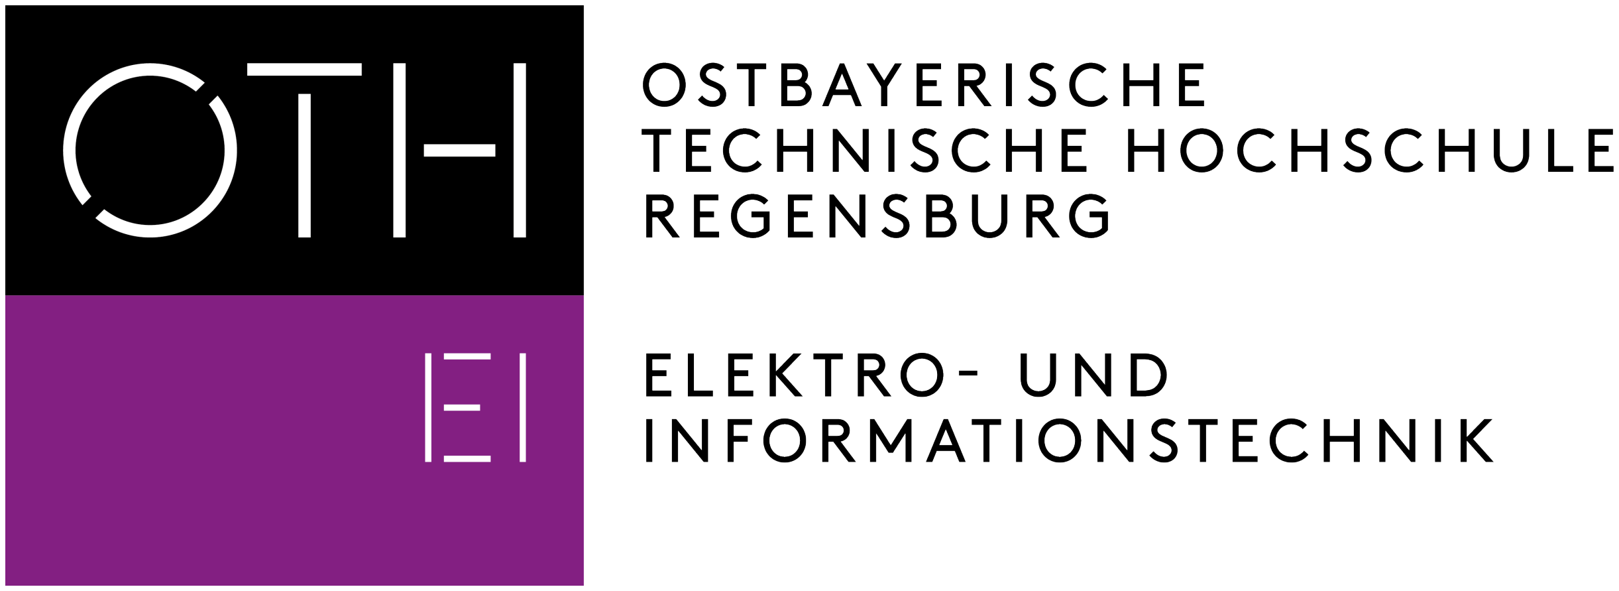
[picture p97: figure]

# Bedienungsanleitung

# Funktionsgenerator Version 2

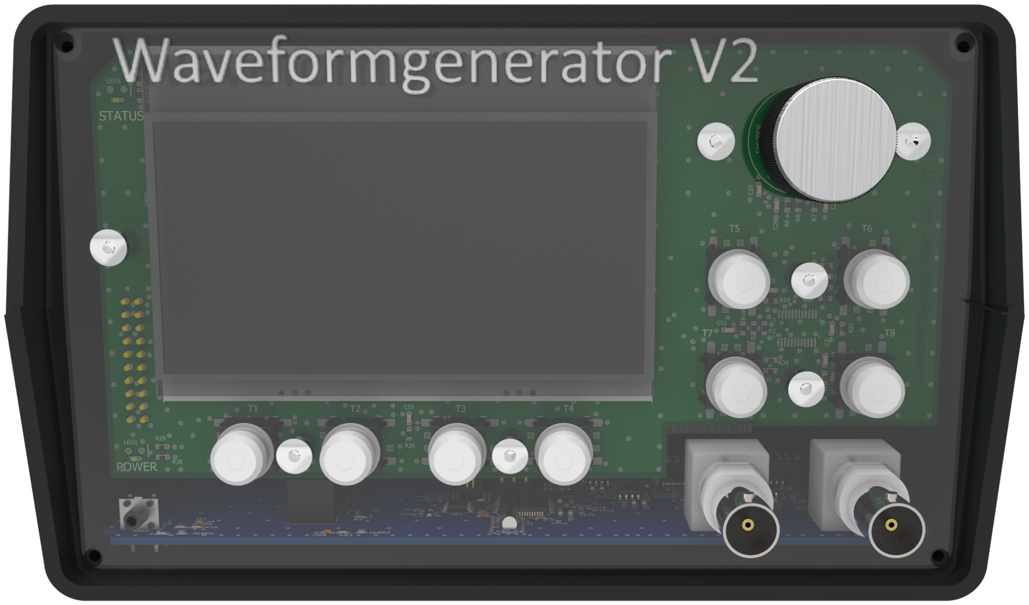
[picture p98: figure]

Projektmitglieder: | Manuel Dentgen Tobias Frauenschläger Thomas Taugenbeck
Betreuer: | Prof. Dr.-Ing. Hans Meier Prof. Dr. rer. nat. Roland Mandl
Ausstellungsdatum: | 8. April 2019

Funktionsgenerator Version 2 | | 1 Bedienungsanleitung

## 1 Bedienungsanleitung

Auf den folgenden Seiten befindet sich eine ausfuhrliche Bedienungsanleitung des ¨ Funktionsgenerators. Dabei wird der Selbsttest beim Einschalten des Geräts, sowie
die Anderung der einzelnen Parameter f ¨ | ur beide Channel beschrieben. Außerdem ¨
wird die Anderung der generellen Einstellungen, wie Hintergrundbeleuchtung und ¨
Kontrast des Displays, welche vom Hauptmenu aufgerufen werden, erl ¨ | äutert.

### 1.1 Startvorgang

Sobald der Schalter auf der Ruckseite des Geh ¨ | | äuses betätigt und das Gerät somit
eingeschaltet wird, beginnt der Mikrocontroller mit der Initialisierung der internen Hardwarebaugruppen. Außerdem werden die POWER LED (leuchtet dauerhaft grun) und die STATUS LED (blinkt im 1 Hz Takt blau) auf dem Frontpanel und ¨

der Hauptplatine aktiviert. Die Taster sowie der Drehencoder sind zu Beginn deaktiviert und werden erst nach dem Bootscreen bzw. beim Betreten eines Submenus ¨ aktiviert. Der Funktionsgenerator beginnt nach der Initialisierung mit einem Test der restlichen Hardware auf dem Frontpanel. Dabei werden alle LEDs der Taster nacheinander eingeschaltet. Dies hat zur Folge, dass nach einer kurzen Verzögerung
iterativ alle Taster grun leuchten. Nach einer weiteren kurzen Verz ¨ | | ögerung leuchten
alle Taster nacheinander, durch Zuschalten der roten LED, gelb. Nachdem die grunen ¨ LEDs erneut durch kurze zeitliche Abstände einzeln ausgeschaltet werden, leuchten die Taster schließlich rot und der visuelle Test der farbigen Taster ist abgeschlossen. Dieser Test ermöglicht es dem Anwender defekte LEDs in den Tastern beim Start des Geräts zu erkennen. Das Display wird noch vor dem Durchschalten der farbig beleuchteten Taster initialisiert. Während des Startvorgangs wird dann ein Bootscreen angezeigt, welcher einen Ladebalken und Informationen zu den Entwicklern darstellt. Zusätzlich werden in dieser Zeit die auf dem EEPROM gespeicherten Werte zu Hintergrundbeleuchtung, Display-Kontrast und Parameter der beiden Kanäle geladen. Nachdem die Zeit des Ladebalkens abgelaufen ist, wechselt der Funktionsgenerator in das Hauptmenu und die 8 Taster des Frontpanels werden erstmals ¨ aktiviert. Die vier variablen Taster unter dem Display werden im Hauptmenu auf die ¨ Farbe gelb geschaltet. Von den restlichen vier werden die beiden oberen Channel-Select Buttons auf jeweils grun und rot geschaltet. Dadurch wird das Umschalten ¨
auf das Menu von Channel 1 (gr ¨ | un) bzw. von Channel 2 (rot) durch Bet ¨ | ätigung
visualisiert. Die LEDs der letzten beiden Channel-Activate Buttons, welche sich unter den Select-Buttons befinden, bleiben ausgeschaltet und zeigen dadurch an, dass
Dentgen Manuel, Frauenschläger Tobias, Taugenbeck Thomas | Seite 2

die beiden Ausgangssignale der Kanäle Signale nicht an den BNC Buchsen ausgegeben werden. Die Funktion der Channel-Activate Buttons ändert sich während des Betriebs der Firmware nicht, wodurch an der Beleuchtung der Buttons der aktuelle Aktivierungs-Status der beiden Channels erkennbar wird.

### 1.2 Hauptmenü

Nach dem Wechsel auf das Hauptmenu wird eine ¨ | Ubersicht der einzelnen Submen ¨ | us ¨
angezeigt (siehe Abbildung 1). Diese Submenus sind die rote und gr ¨ | une Hinter- ¨

grundbeleuchtung, das Einstellungsmenu f ¨ ur den Kontrast des Displays und das ¨
Creditsmenu. Diese k ¨ | önnen uber die variablen Taster, welche ¨ | uber das Display mit ¨
den jeweiligen Submenus benannt sind, aufgerufen werden. ¨

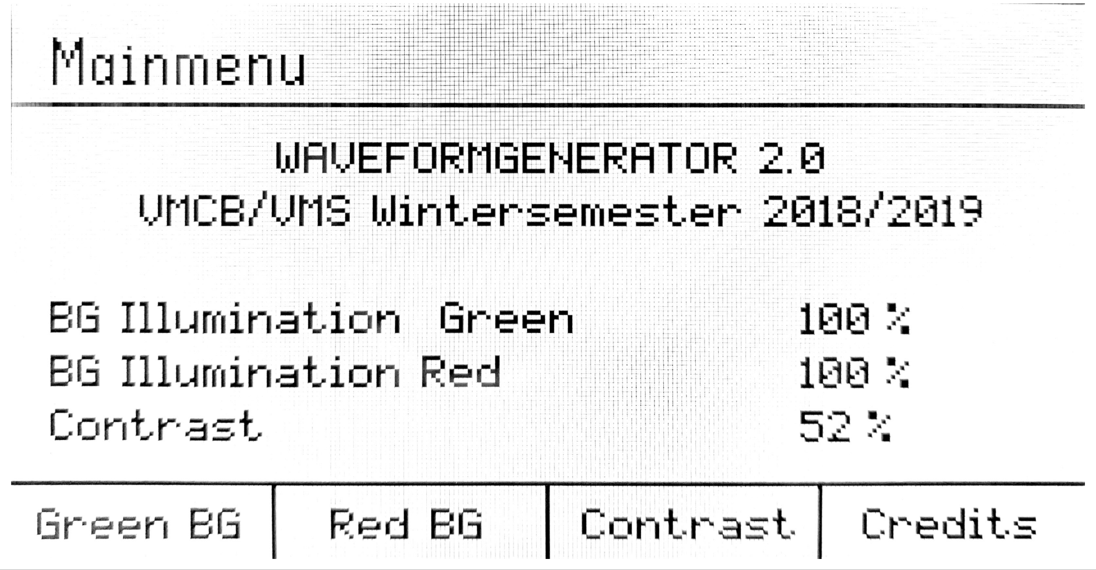
[picture p99: figure]
EH3 Illumir'latiür'l F'.._r=u:i; F'Jrr|+r-d'-F+

Abb. 1: Allgemeine Ubersicht im Hauptmen ¨ | ü
Sobald ein Submenu ausgew ¨ | ählt wurde, ändert sich die Funktion der variablen Tas-
ter. Auf Abbildung 2 ist das Submenu f ¨ ur die gr ¨ | une Hintergrundbeleuchtung zu ¨
sehen. Die beiden mittleren Taster besitzen die Funktion die aktuelle Helligkeit, welche als Prozentwert angegeben ist, zu verzehnfachen, oder sie durch zehn zu teilen. Durch den rechten variablen Taster kann das Submenu wieder verlassen werden und ¨
der Funktionsgenerator wechselt erneut in die Ubersicht des Hauptmen ¨ | us. Durch ¨
Drehen des Encoders im Submenu kann nach dem Betreten des Submen ¨ | us die Stelle ¨
ausgewählt werden, welche anschließend verändert werden soll. In der Grafik ist die Einerstelle des Wertes ausgewählt, was durch den Strich unter der Ziffer angedeutet wird.
Durch Drucken des Encoders ¨ | ändert sich die Darstellung der vorher ausgewählten
Ziffer und sie wird im Display pixelweise invertiert (siehe Abbildung 3). Somit kann

der Helligkeitswert durch Drehung des Encoders nun präziser eingestellt werden. Eine Drehung nach links verringert den Wert um 1 % und das Drehen nach rechts

Dentgen Manuel, Frauenschläger Tobias, Taugenbeck Thomas | Seite 3

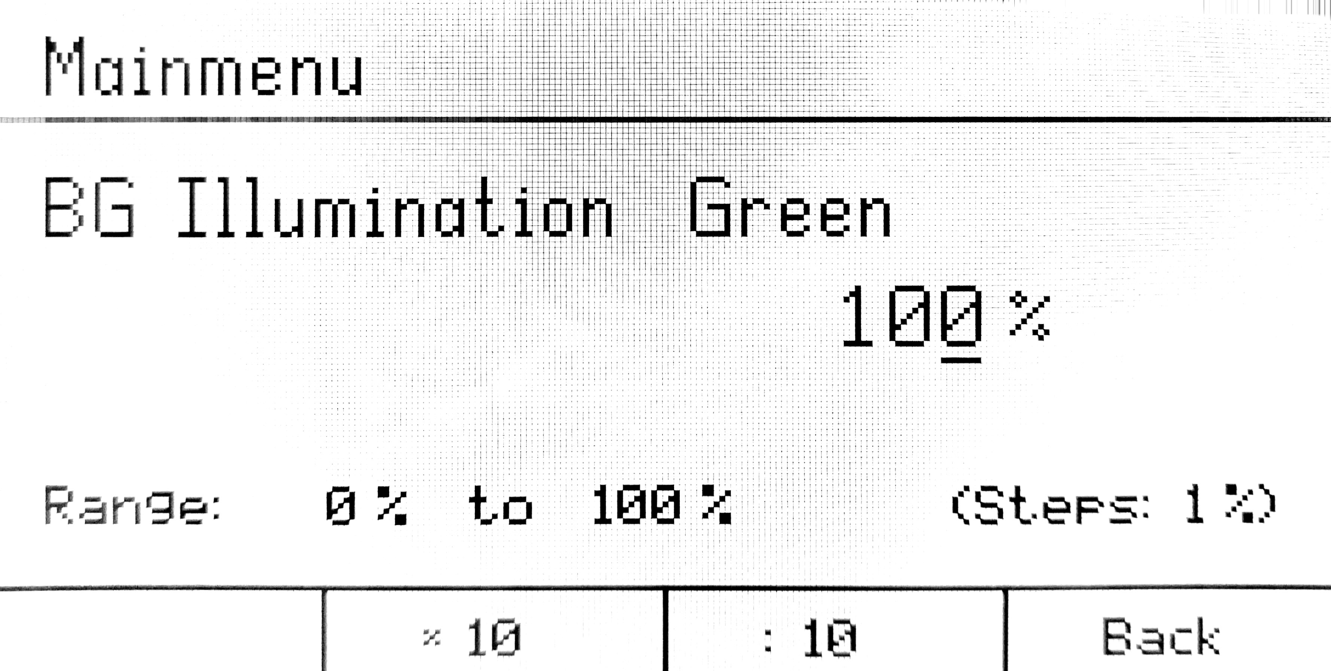
[picture p100: figure]

Abb. 2: Submenu der gr ¨ | unen Hintergrundbeleuchtung ¨

bewirkt entsprechend eine Erhöhung des Wertes um 1 %. Ein erneutes Drucken des ¨

Encoders speichert die Ziffer und anschließend kann durch Drehung eine andere Stelle ausgewählt werden. Die Grenzen des Submenus, welche bei den Hintergrund- ¨ beleuchtungen minimal 0 % (aus) bis maximal 100 % sind, werden im Bereich uber ¨ den Namen fur die variablen Taster angezeigt. Außerdem wird die minimale Schritt- ¨ größe, welche bei der Hintergrundbeleuchtung 1 % entspricht, im rechten unteren

Menubereich angezeigt. ¨

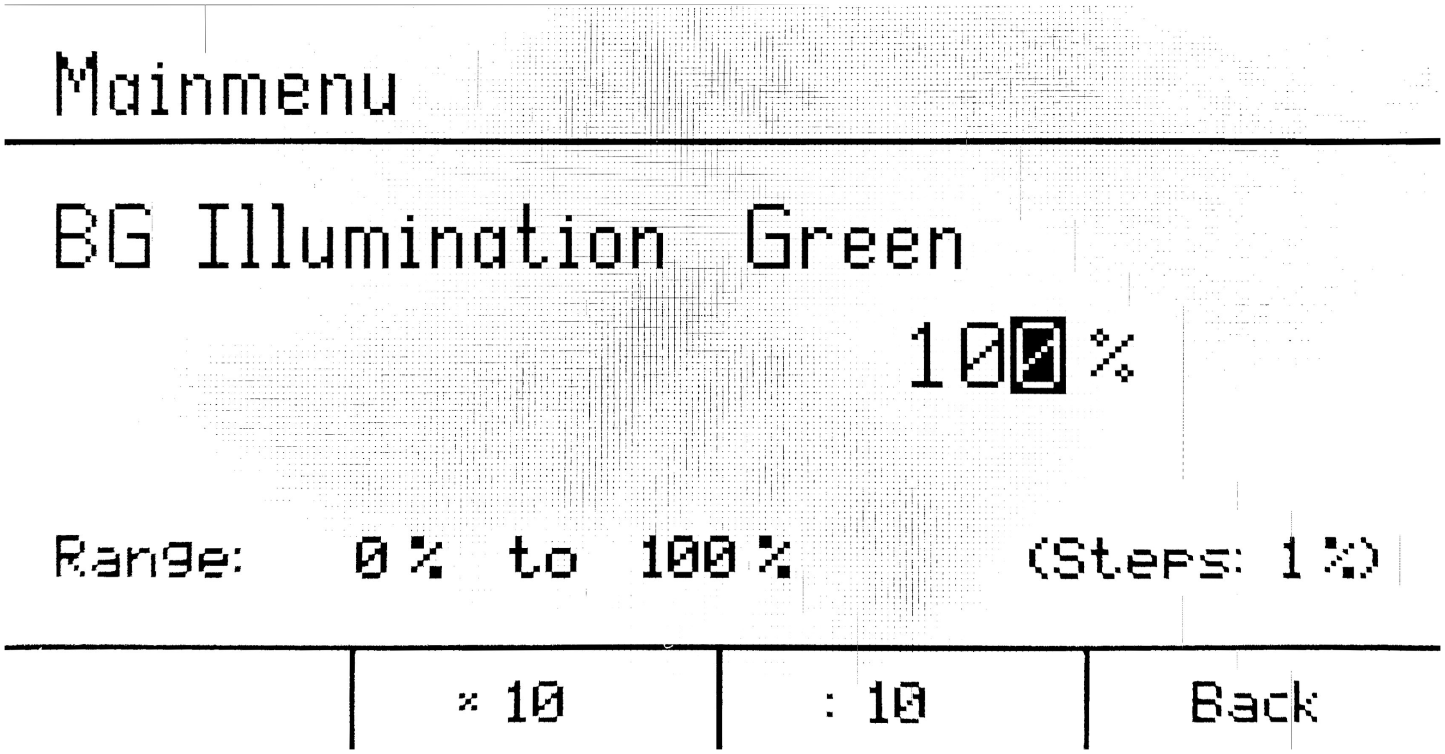
[picture p101: figure]
_______fi@3_____ffluin men,L1~*'_.°~~"; umln

Abb. 3: Submenu der gr ¨ | unen Hintergrundbeleuchtung mit ausgew ¨ | ählter Einerstelle

Die beiden Helligkeitsmenus sind gleich aufgebaut und steuern entsprechend die ¨
unterschiedlichen Hintergrundfarben. Das Kontrastmenu ist, bis auf eine st ¨ | ärkere
Eingrenzung des minimalen und maximalen Wertes, entsprechend den Helligkeits-
menus aufgebaut. Im Creditsmen ¨ | u befinden sich Informationen zu den Entwicklern ¨
und zum Projekt. Das Hauptmenu besitzt, im Gegensatz zu den Channelmen ¨ | us und ¨
auf Grund von der Maximierung auf vier Submenus nur eine Seite. ¨
Dentgen Manuel, Frauenschläger Tobias, Taugenbeck Thomas | Seite 4

### 1.3 Channelmenus¨

Uber die Beleuchtung der beiden ¨ | Channel-Select Buttons wird immer das zu errei-
chende Menu angezeigt. Ein gr ¨ | uner Button entspricht hierbei wieder dem Channel 1 ¨
und ein roter Button dem Channel 2. Falls sich der Funktionsgenerator in einem der
beiden Channelmenus befindet, wechselt der entsprechende ¨ | Channel-Select Button
auf die Farbe gelb und deutet somit den möglichen Wechsel in das Hauptmenu an. ¨
Da die Steuerung ab hier fur beide Channelmen ¨ | us gleich abl ¨ | äuft, wird im Folgenden
nur auf den Ablauf des Channel 1 Menus eingegangen. Dennoch gilt die Beschrei- ¨
bung fur beide Channels, mit Ausnahme der Farben f ¨ | ur die Tasterbeleuchtung. ¨
Nachdem das Channel 1 Menu ausgew ¨ | ählt wurde, wird eine Ubersicht ¨ | uber alle ¨

Parameter des Channels angezeigt (siehe Abbildung 4). Diese Parameter sind Frequenz, Amplitude, Offset, Phase und Signalform. Wenn die Signalform Rechteck ausgewählt ist, wird die zusätzliche Einstellung des Duty Cycle dargestellt. Durch Variieren dieses Werts kann ein Rechtecksignal mit einstellbarer Pulsbreite erzeugt werden. Die variablen Taster werden auf die Farbe grun geschaltet, um das aktuelle ¨
Channel 1 Menu visuell zu verdeutlichen. Die ¨ | Channel-Select Buttons bekommen,
wie in Kapitel 1.1 beschrieben, die Farben gelb und rot. Im oberen Teil der Menu- ¨
Ubersicht wird, zus ¨ | ätzlich zu der farbigen LED des Channel-Activate Buttons, der

Aktivierungs-Status des Channel 1 auf der BNC Buchse angezeigt. Des weiteren
befindet sich oben rechts in der Ubersicht die Seitenangabe des Men ¨ | us. ¨

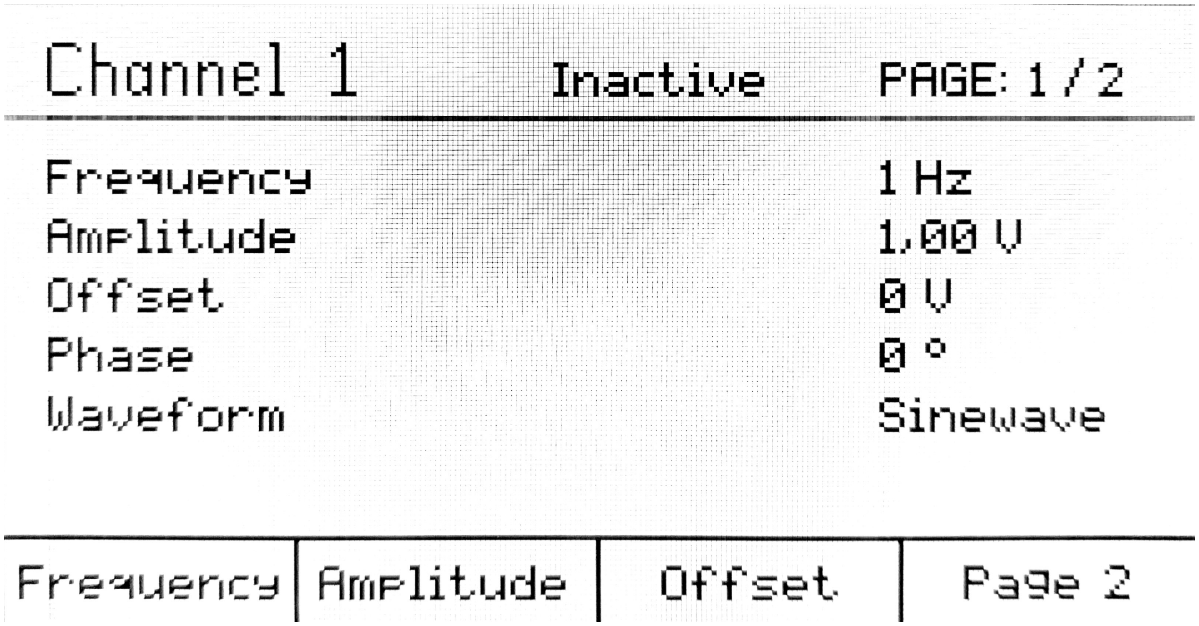
[picture p102: figure]
L.hunnell-v"; Frwequ.Pncg'_A._ÄÄY,.._. Flrnplitude ;..¢s JFF'F'd-F_PJ+ WW; Sine-wage

Abb. 4: Allgemeine Ubersicht im Channelmen ¨ | u des Kanal 1 ¨
Die funf bzw. sechs Submen ¨ | us m ¨ | ussen, auf Grund der Begrenzung durch vier va- ¨
riable Taster, auf zwei Menuseiten aufgeteilt werden. Auf Seite 1 kann durch den ¨ rechten Taster auf die zweite Seite des Menus gewechselt werden. Auf Seite 2 kann ¨ mit Hilfe des linkes Tasters auf die erste Seite zuruck gewechselt werden. Die restli- ¨ chen variablen Taster rufen auf der ersten Seite die Submenus Frequenz, Amplitude ¨
Dentgen Manuel, Frauenschläger Tobias, Taugenbeck Thomas | Seite 5

und Offset auf. Auf der zweiten Seite können die Submenus Phase und Signalform, ¨ sowie bei ausgewählter Rechtecksignalform der Duty Cycle des Signals verändert werden.
Die Submenus Frequenz und Amplitude sind grunds ¨ | ätzlich ähnlich aufgebaut. Nach
dem Betreten eines dieser Submenus werden der Name, der aktuelle Wert mit Ein- ¨ heit und die Grenzwerte des Parameters angezeigt (siehe Abbildung 5). Außerdem
befindet sich unten rechts uber der Tasterbeschreibung die minimale Schrittgr ¨ | öße
des Parameters. Bei der Frequenz entspricht diese 1 Hz und bei der Amplitude ist die minimale Schrittgröße 1 mV.

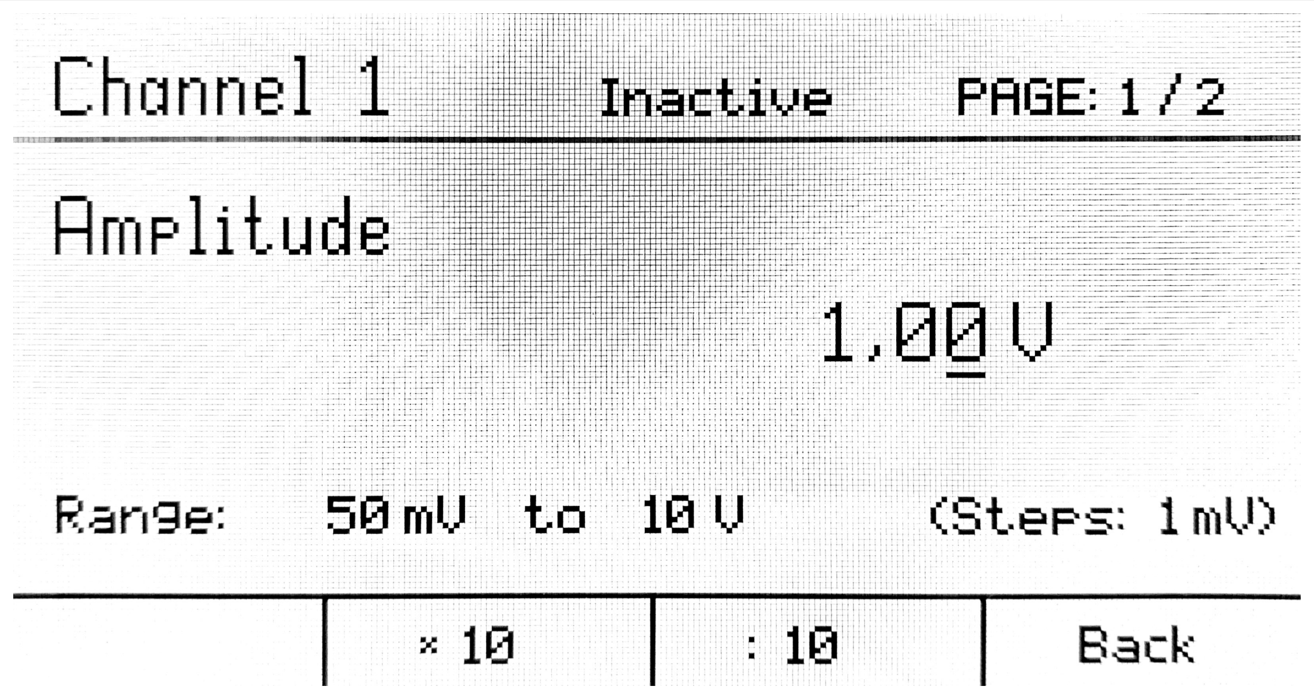
[picture p103: figure]
FImF-litude; Sam-um1~su" k"qt.EP_a-.'1n1L...IW; WESLL h: ll- EI

Abb. 5: Submenu zum Einstellen der Amplitude ¨

Beim Betreten des Submenus wird unter der rechten Ziffer zus ¨ | ätzlich ein Strich ange-
zeigt. Dieser deutet an, dass diese Stelle des Wertes ausgewählt ist. Durch einmaliges Drucken des Drehencoders verschwindet der Strich und die dargestellte Zahl wird ¨ pixelweise invertiert (siehe Abbildung 6). Dadurch wird das Andern des Wertes auf ¨

der vorher ausgewählten Position visualisiert. Mit einer Drehung des Encoders nach links oder rechts wird die Zahl um eins erhöht oder verringert. Beim Uberlauf einer ¨
Ziffer von 9 nach 0 wird ein Ubertrag in die n ¨ | ächst höhere Stelle ausgefuhrt und ¨

ein Unterschreiten der Zahl 0 bewirkt entsprechend eine Verringerung der nächst höheren Stelle. Durch erneutes Drucken des Encoders verschwindet die grafische In- ¨ vertierung der Ziffer und der Strich aus Abbildung 5 wird erneut angezeigt. Wenn der Encoder in diesem Zustand gedreht wird, kann die zu verändernde Ziffer durch entsprechendes Drehen nach links bzw. rechts ausgewählt werden.

Dentgen Manuel, Frauenschläger Tobias, Taugenbeck Thomas | Seite 6

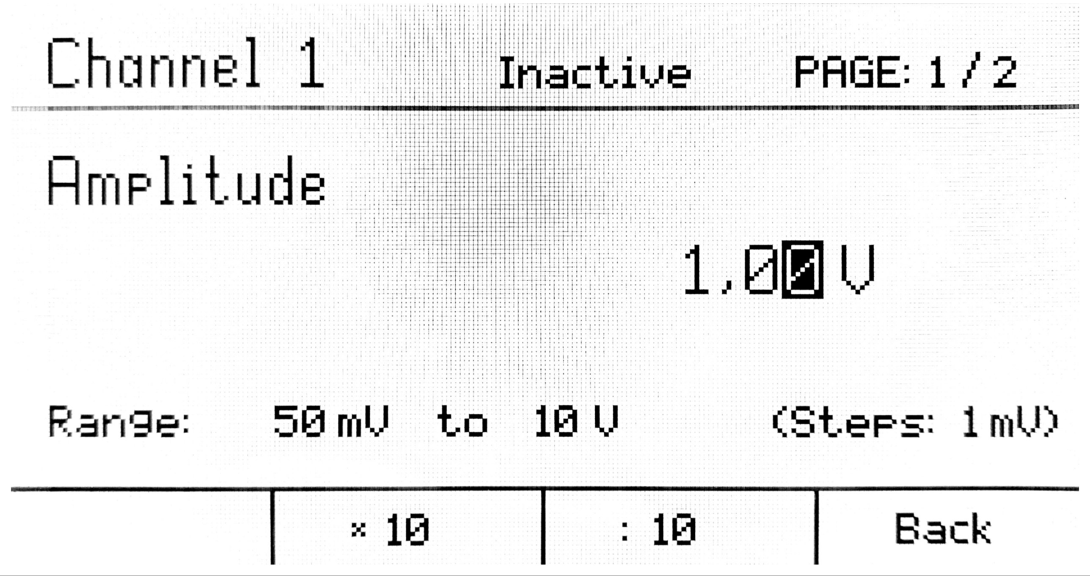
[picture p104: figure]
IiSr..E-r=:s":lmLLl; WBaLL-' A'IE

Abb. 6: Zweite Nachkommastelle des Wertes wurde ausgewählt

Zusätzlich, zur schnellen Anderung des Wertes in großen Schritten, k ¨ | önnen die bei-

den mittleren variablen Taster verwendet werden. Der Linke bewirkt dabei eine Verzehnfachung des Wertes und der Rechte das Teilen durch Zehn. In der Darstellung der Ziffer verändert sich dabei lediglich die Stelle des Kommas (siehe Abbildung
7) und gegebenenfalls der Faktor vor der Einheit.

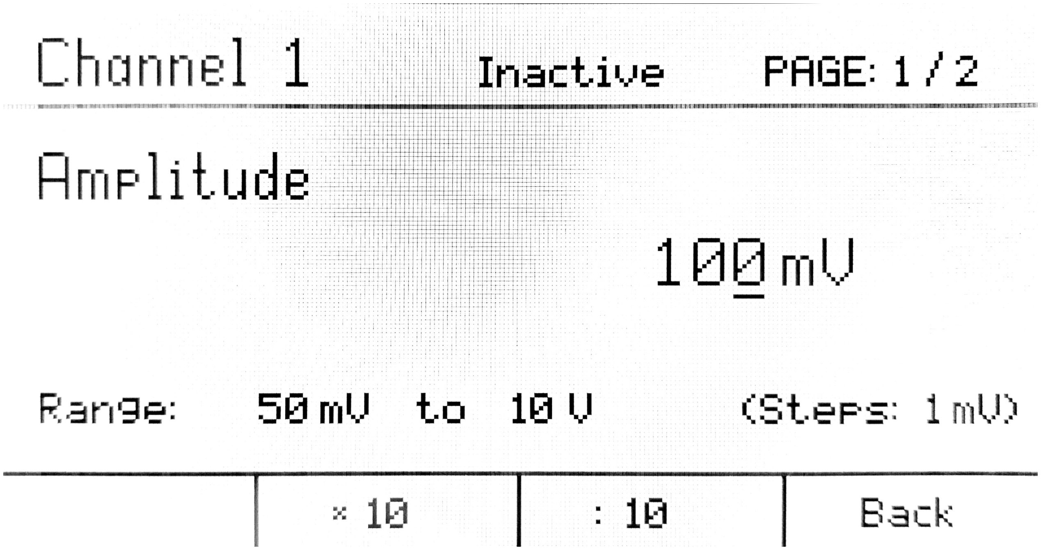
[picture p105: figure]
Wfi'lfi.'1E; BaLL-'; slamutcuiaui; ifit.EP_H- 1n1L.|..W; Fl ITI F' 1 t u; ;r<:.<.,1::wiH A mmn 11 In vnmw

Abb. 7: Veränderter Wert nach Drucken des ¨ | :10-Buttons
Durch Drucken des ¨ | Back-Buttons wird der neu eingestellte Wert auf dem externen
EEPROM gespeichert. Dadurch können die Einstellungen der Channels nach dem Ausschalten und Neustart des Geräts wieder geladen werden. Auch wenn das Signal erst beim Betätigen des Back-Buttons erneut gespeichert wird, verändert sich die
Ausgabe an der BNC Buchse mit jeder Anderung einer Ziffer bzw. durch Dr ¨ | ucken ¨

des *10-Button bzw. :10-Button. Dies gilt wiederum nur unter der Voraussetzung,

dass das Signal an der BNC Buchse aktiviert ist. Dadurch kann die Veränderung des Signals live an der BNC Buchse gemessen werden.

Dentgen Manuel, Frauenschläger Tobias, Taugenbeck Thomas | Seite 7

Die Submenus f ¨ ur den Offset und der Phase sind zum großen Teil ¨ | ähnlich aufgebaut,
wie die fur Amplitude und Frequenz. Zu den beschriebenen Funktionen wird aller- ¨ dings zusätzlich der linke variable Taster verwendet. Dieser hat die Funktion einen eingestellten Wert zu invertieren.

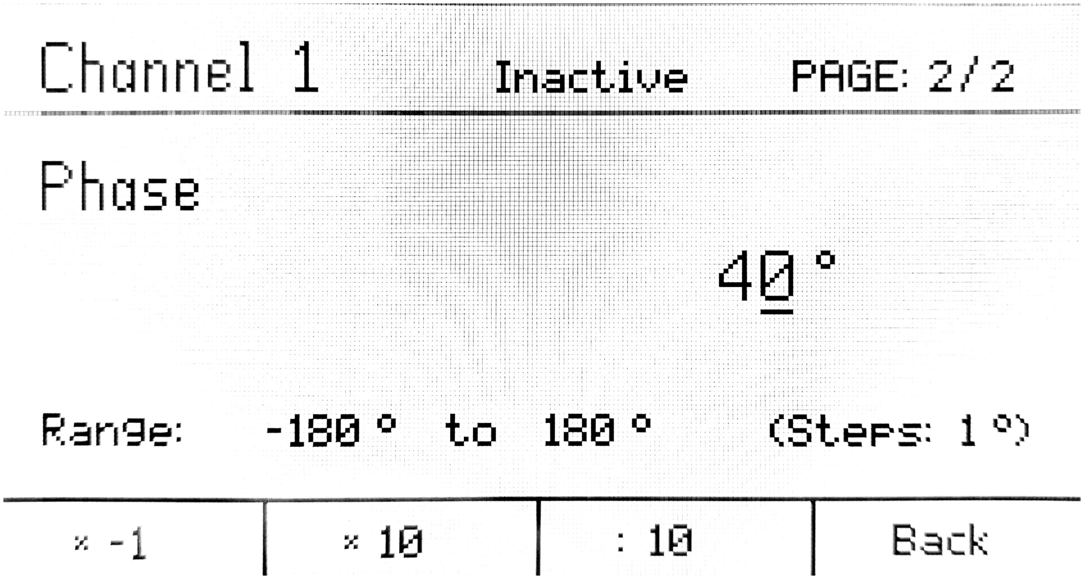
[picture p106: figure]

Abb. 8: Submenu Phase mit zus ¨ | ätzlichem *-1-Button

So wird durch Drucken des Tasters der positive Wert in Abbildung 8 invertiert ¨ und wie in Abbildung 9 negativ dargestellt. Die minimale Schrittgröße beim Offset
beträgt 1 mV und fur die Phase ist die kleinste ver ¨ | änderbare Einheit ein Grad.

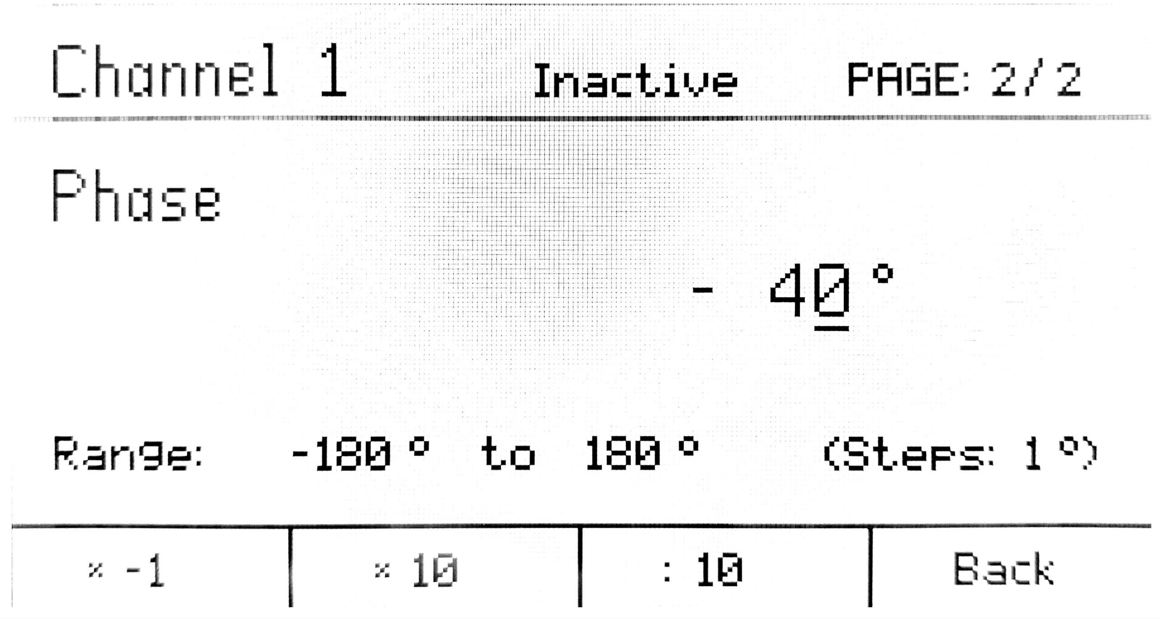
[picture p107: figure]

Abb. 9: Submenu Phase nach Bet ¨ | ätigung des *-1-Button
Bei diesen beiden Submenus wird außerdem beim Unter- bzw. ¨ | Uberschreiten des ¨

Wertes 0 eine Invertierung des Vorzeichens ausgelöst, sodass eine angenehme Einstellung der Parameter ermöglicht wird.
Mit Hilfe des Signalformmenu kann die Form des Ausgangssignals durch Drehen des ¨ Encoders festgelegt werden (siehe Abbildung 10). Die möglichen Ausgangssignalfor-

men sind Sinus, Dreieck, fallender und steigender Sägezahn, sowie Rechteck.

Dentgen Manuel, Frauenschläger Tobias, Taugenbeck Thomas | Seite 8

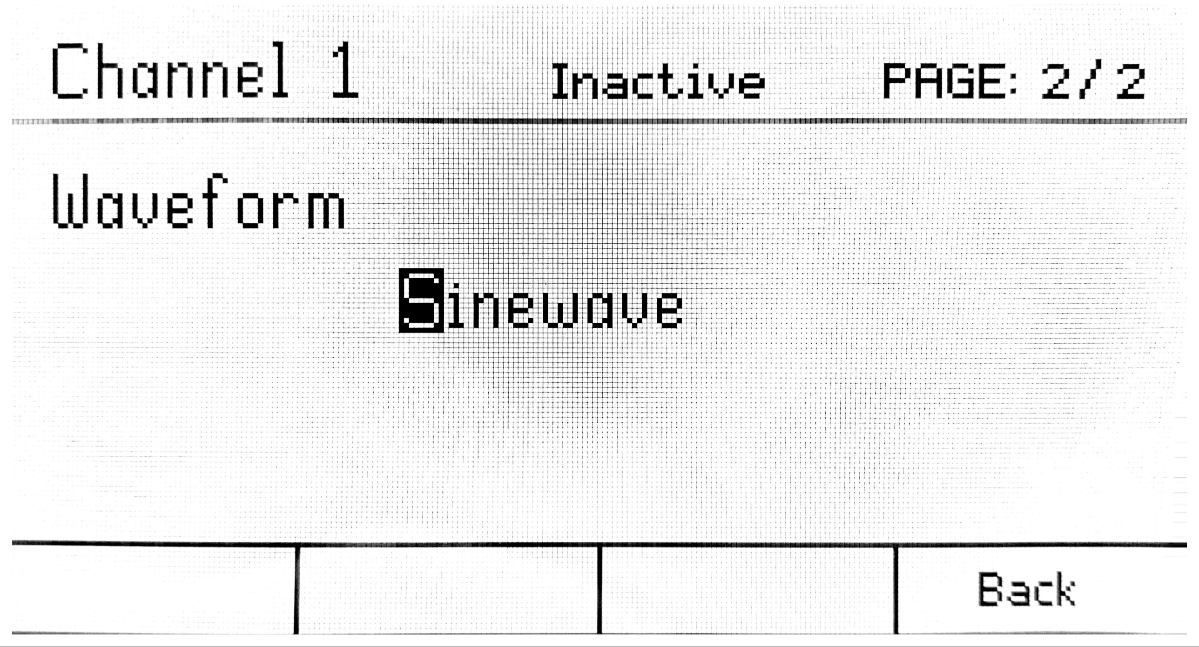
[picture p108: figure]

WIE! | F'FIEE: 2r: I'llfvl'l'mTIY'I-LW'WEMTFIFTI FFPIZFI FIFI'PT Fl VT! I rru'mmmtmmg I H x' r! l

Abb. 10: Submenu Signalform ¨

Falls letztere Einstellung gewählt wurde, wird ein neues Submenu angezeigt, wel- ¨ ches den Duty Cycle des Rechtecksignal veränderbar macht. Dadurch lässt sich eine Pulsweitenmodulation mit dem Funktionsgenerator verwirklichen. Der Duty Cycle ist zwischen 0 % und 100 % begrenzt und hat die minimale Schrittgröße von einem
%. Wenn in diesem Menu ein Duty-Cycle von 100 % ausgew ¨ | ählt ist, entspricht dies
einer konstanten Gleichspannung, dessen Höhe durch das Amplitudenmenu einge- ¨ stellt werden kann.
Dentgen Manuel, Frauenschläger Tobias, Taugenbeck Thomas | Seite 9
