Agustin586/AWG-RP2040/Tesis/Anteproyecto/img/AWG_DDS.pdf

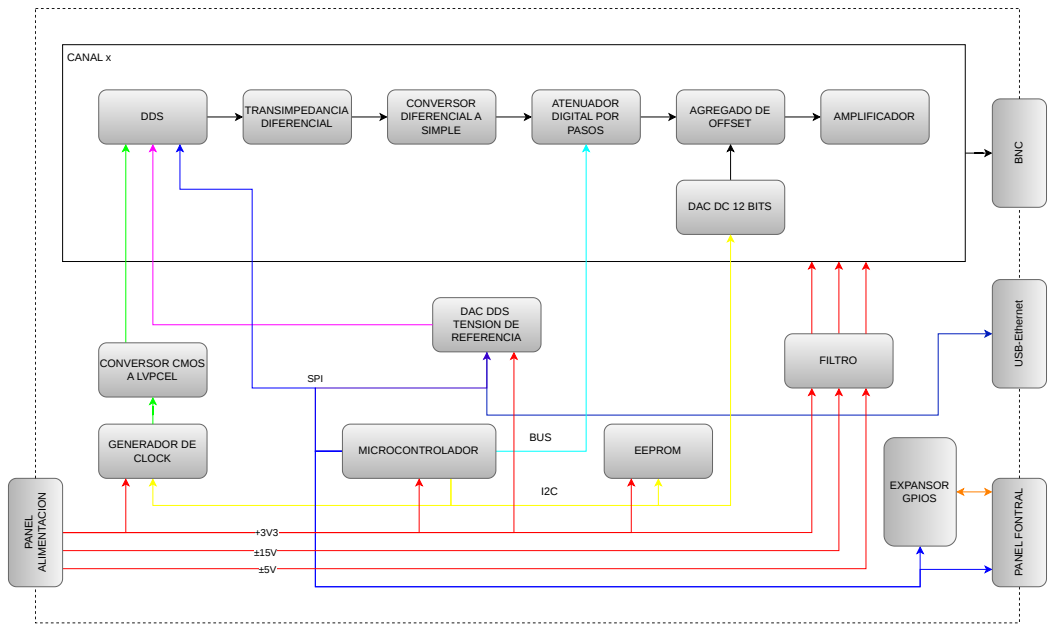
[picture p109: page 1]
DDS; TRANSIMPEDANCIA; DIFERENCIAL; CONVERSOR DIFERENCIAL A SIMPLE; ATENUADOR DIGITAL POR PASOS; AGREGADO DE; OFFSET; AMPLIFICADOR; CANAL x; DAC DDS TENSION DE REFERENCIA; SPI; MICROCONTROLADOR; EEPROM GENERADOR DE; CLOCK; CONVERSOR CMOS A LVPCEL; BUS; FILTRO; PANEL; ALIMENTACION; EXPANSOR GPIOS; USB-Ethernet

BNC PANEL FONTRAL

DAC DC 12 BITS
