Agustin586/AWG-RP2040/Tesis/Anteproyecto/img/PanelAlimentacionDDS.pdf

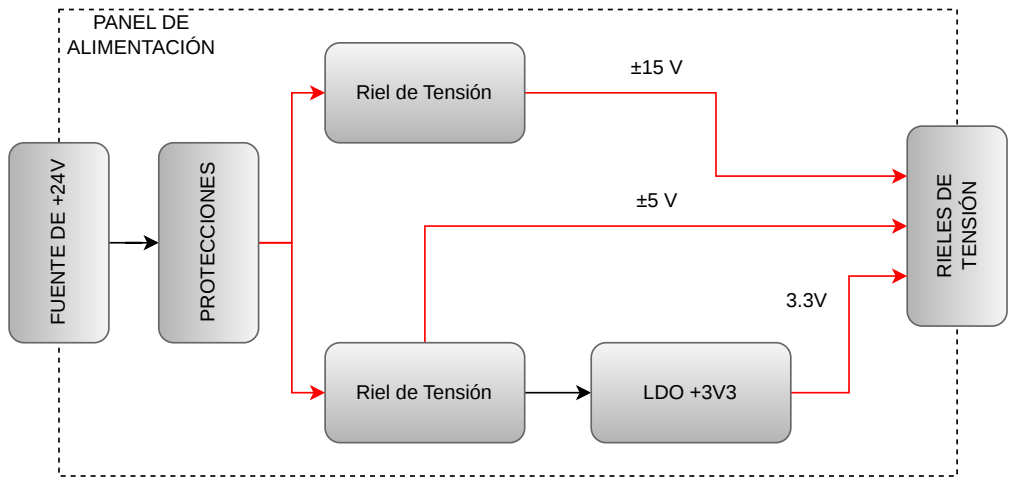
[picture p110: page 1]
Riel de; Tensión; FUENTE DE +24V; RIELES DE; TENSIÓN; LDO +3V3; PANEL DE ALIMENTACIÓNPROTECCIONES
