Agustin586/AWG-RP2040/Tesis/Anteproyecto/img/Firmware_DB.drawio.pdf

# Principal

# Control de Periféricos

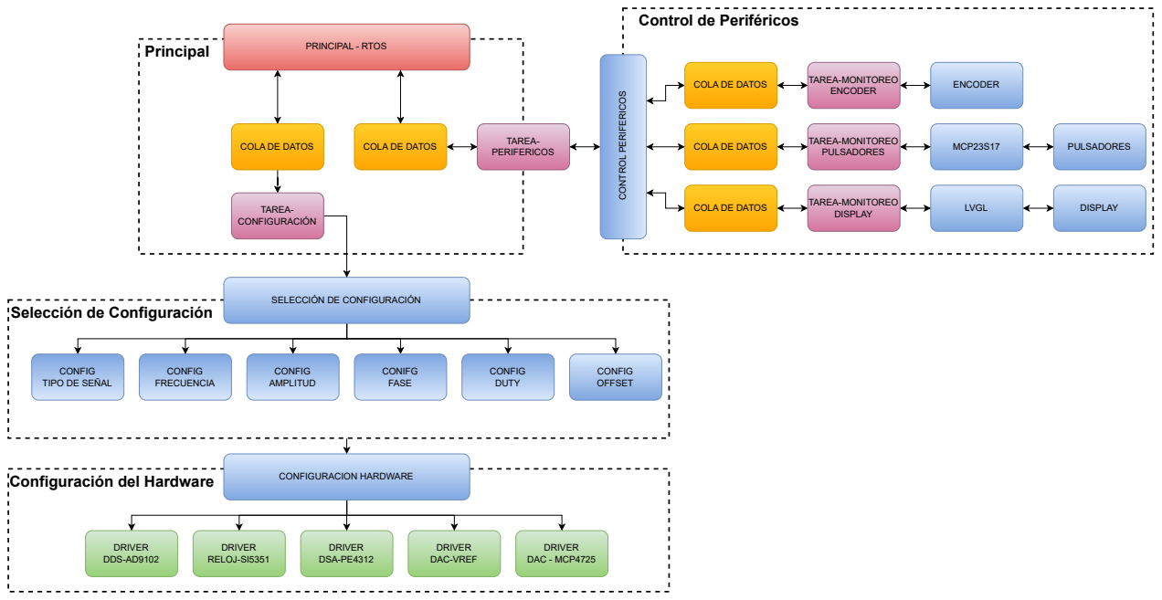
[picture p111: page 1]
PRINCIPAL - RTOS; DRIVER DDS-AD9102; DRIVER DSA-PE4312; DRIVER DAC - MCP4725; DRIVER RELOJ-SI5351; DRIVER DAC-VREF; MCP23S17; PULSADORES; LVGL; DISPLAY; CONTROL PERIFERICOS; ENCODER; TAREA- PERIFERICOS; TAREA-MONITOREO ENCODER; TAREA-MONITOREO PULSADORES; TAREA-MONITOREO DISPLAY; COLA DE DATOS; CONFIG AMPLITUD; CONFIG FRECUENCIA; CONIFG FASE; CONFIG DUTY; CONFIG OFFSET; CONFIGURACION HARDWARE; TAREA- CONFIGURACIÓN

COLA DE DATOS

Selección de Configuración

SELECCIÓN DE CONFIGURACIÓN

CONFIG
TIPO DE SEÑAL

Configuración del Hardware
