Agustin586/AWG-RP2040/Presentacion SASE/img/Generador de Funciones.pdf

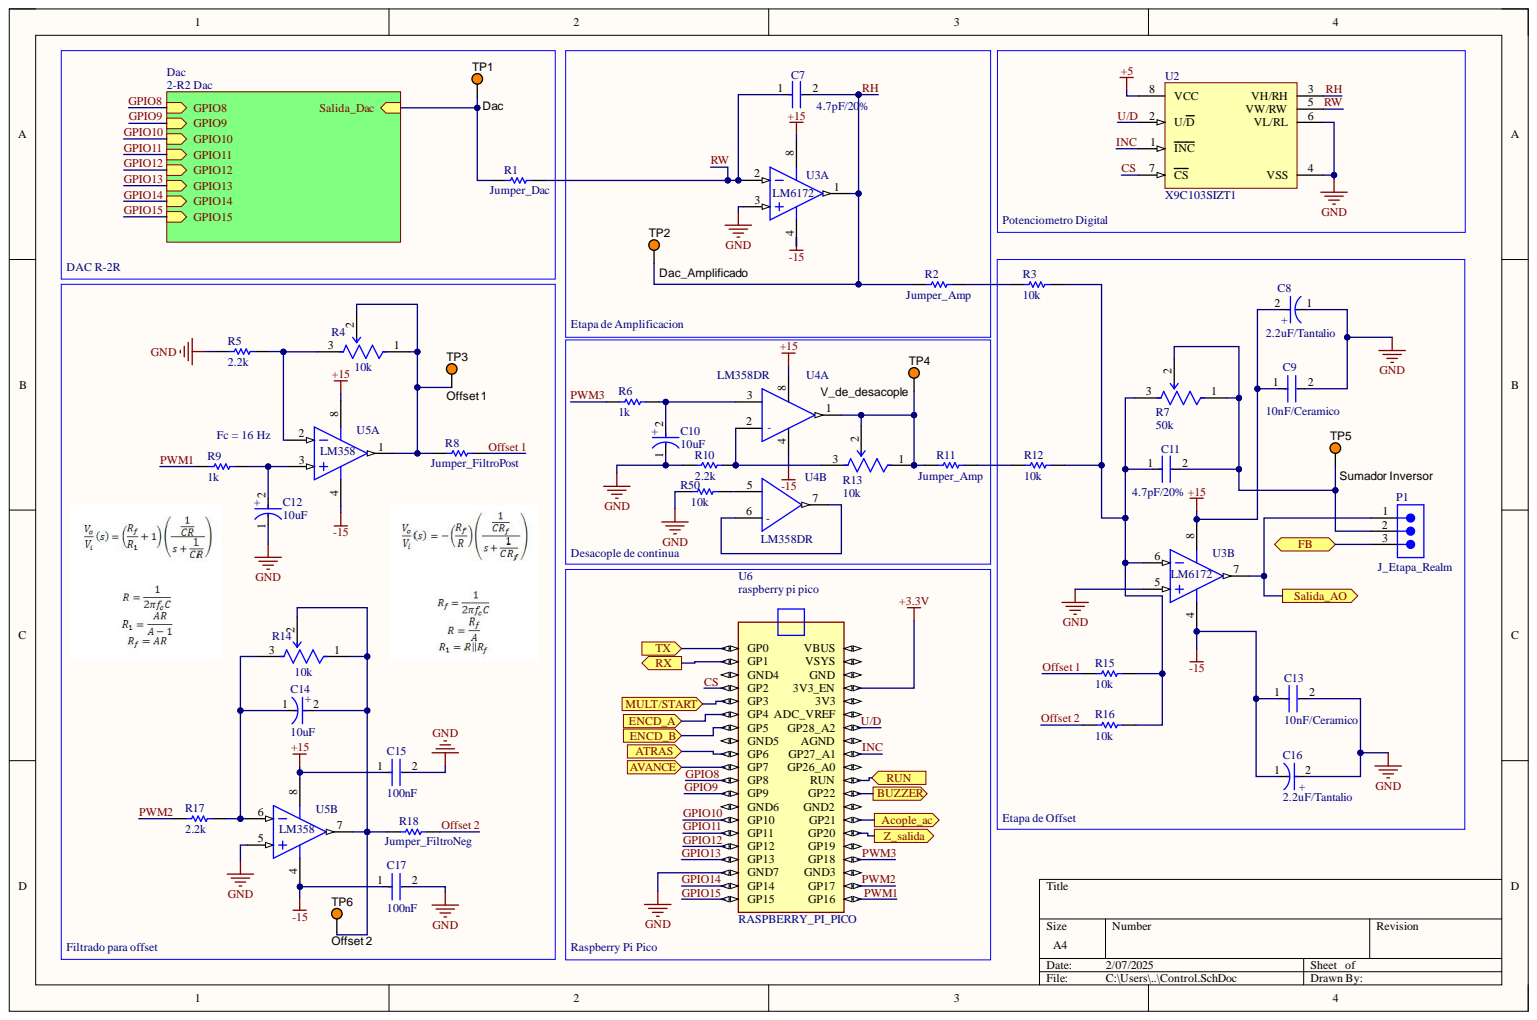
[picture p112: page 1]
