Agustin586/AWG-RP2040/PCB/Generador de Funciones/PCB_Awg.pdf

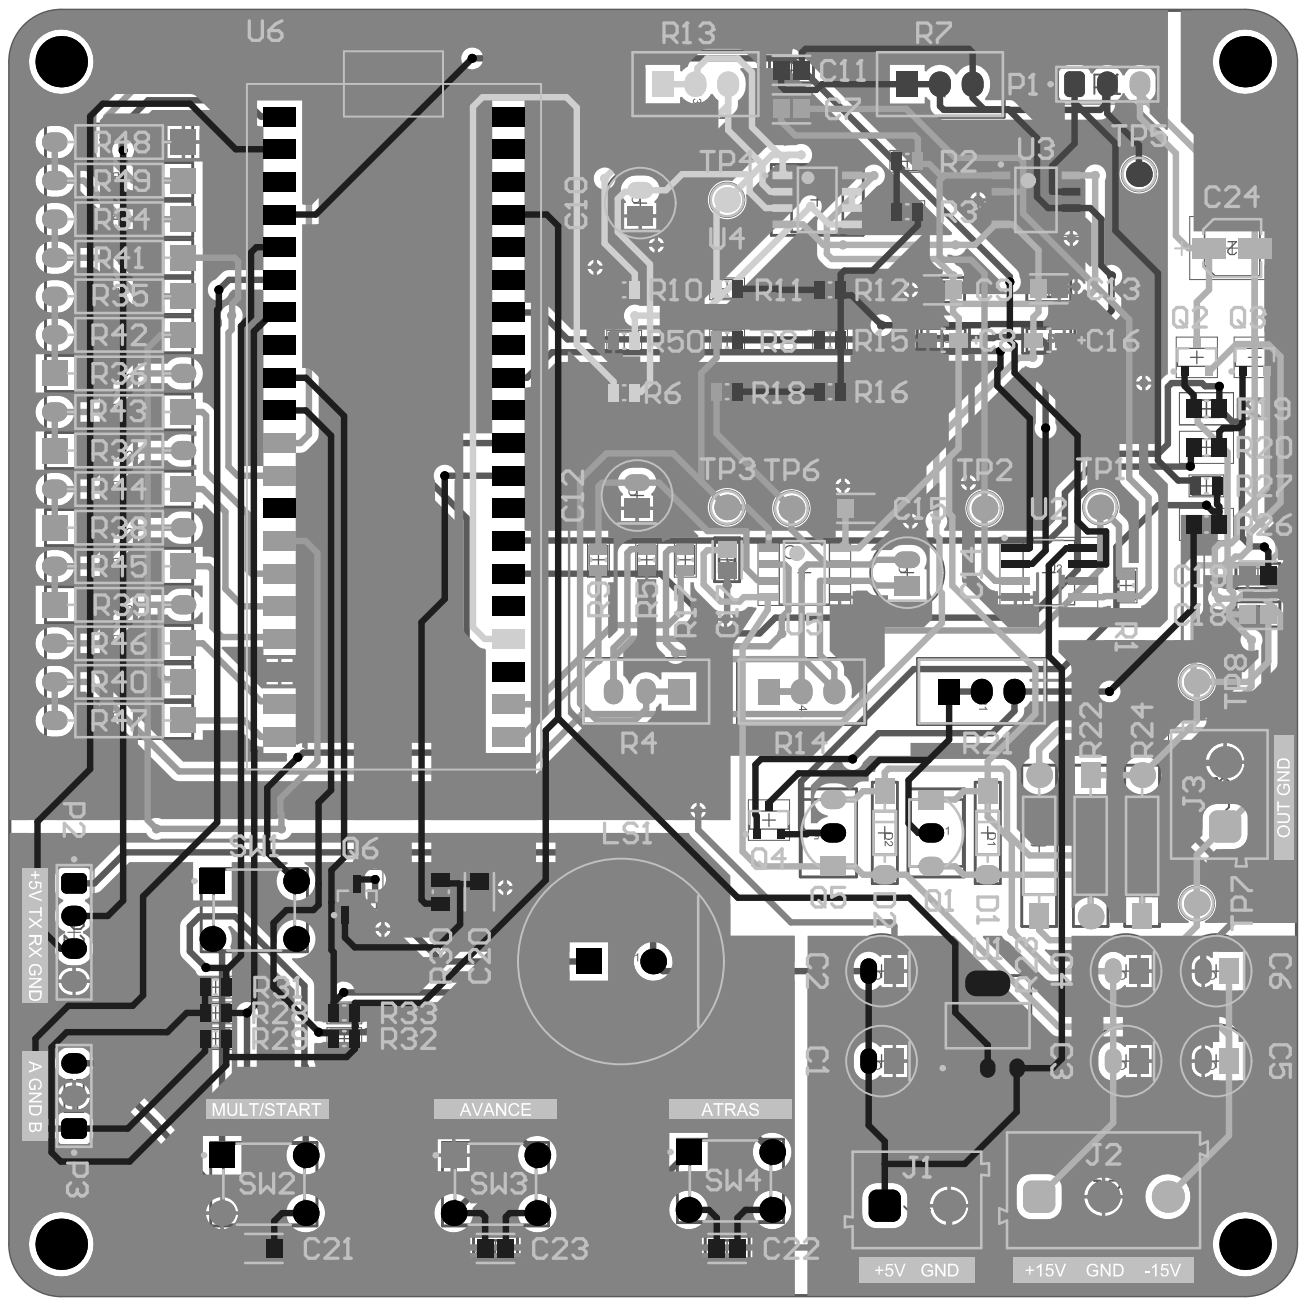
[picture p113: page 1]
