Agustin586/AWG-RP2040/PCB/PCB_Fuente/Fuente.V01.R00/Fuente.V01.R00.pdf

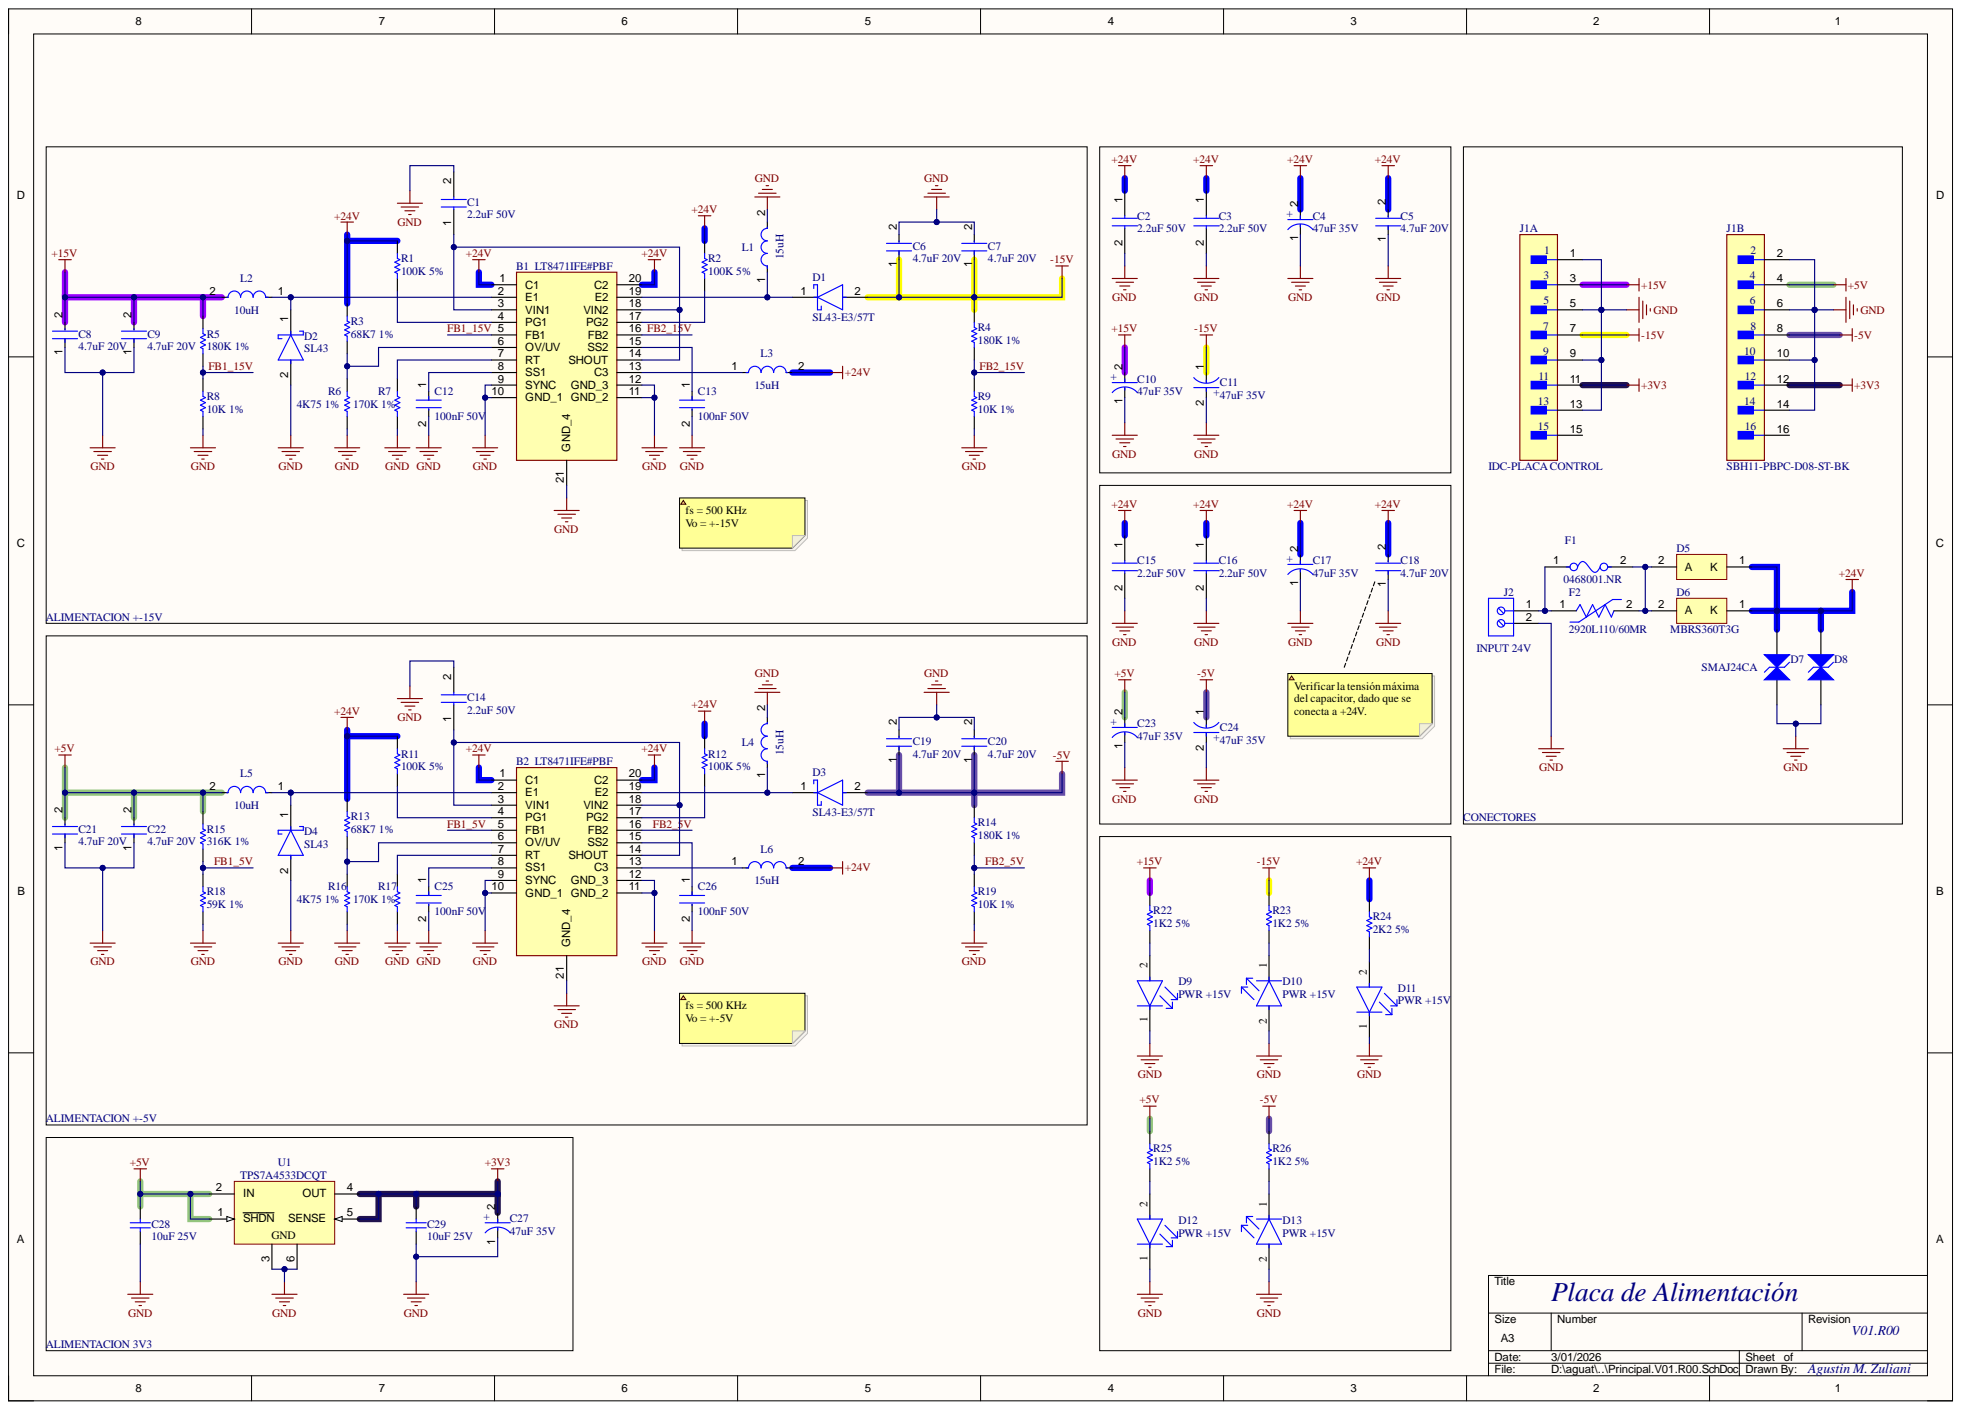
[picture p114: page 1]

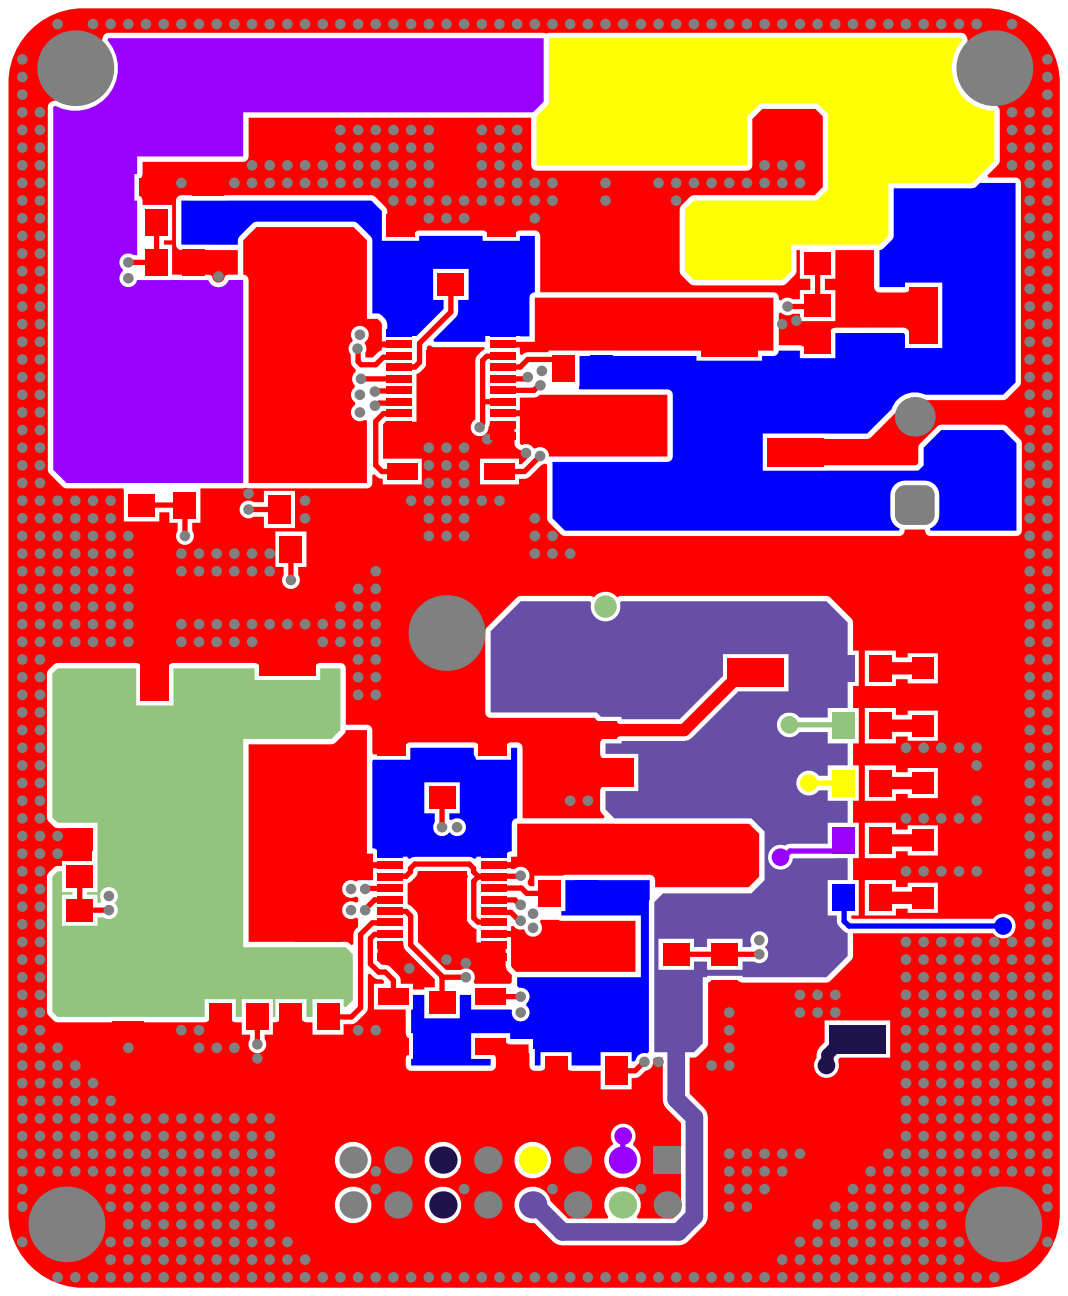
[picture p115: page 2]

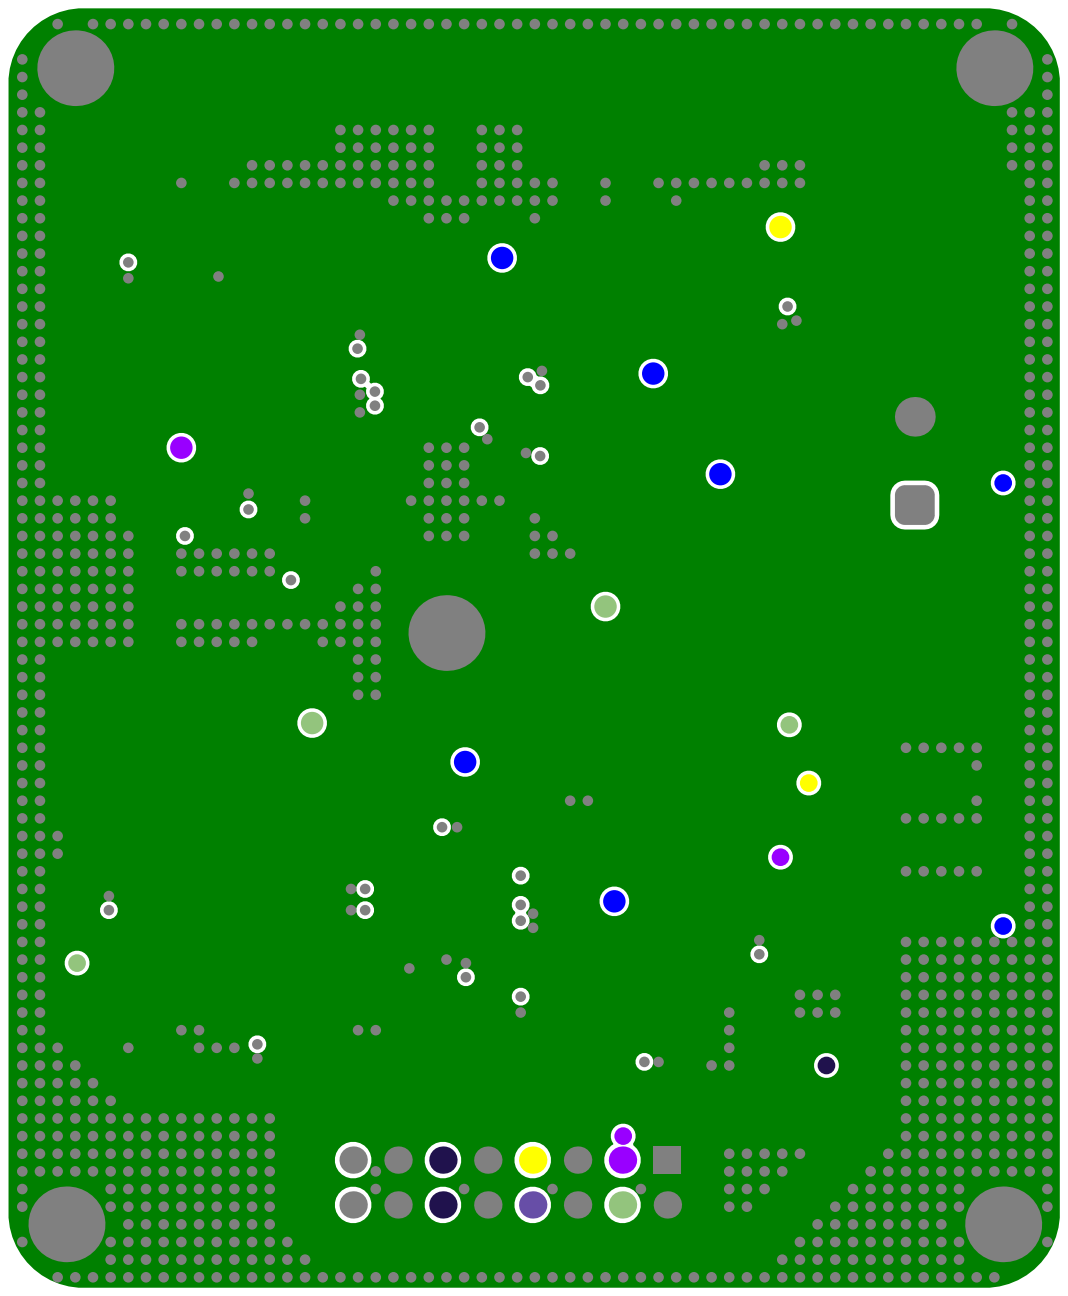
[picture p116: page 3]

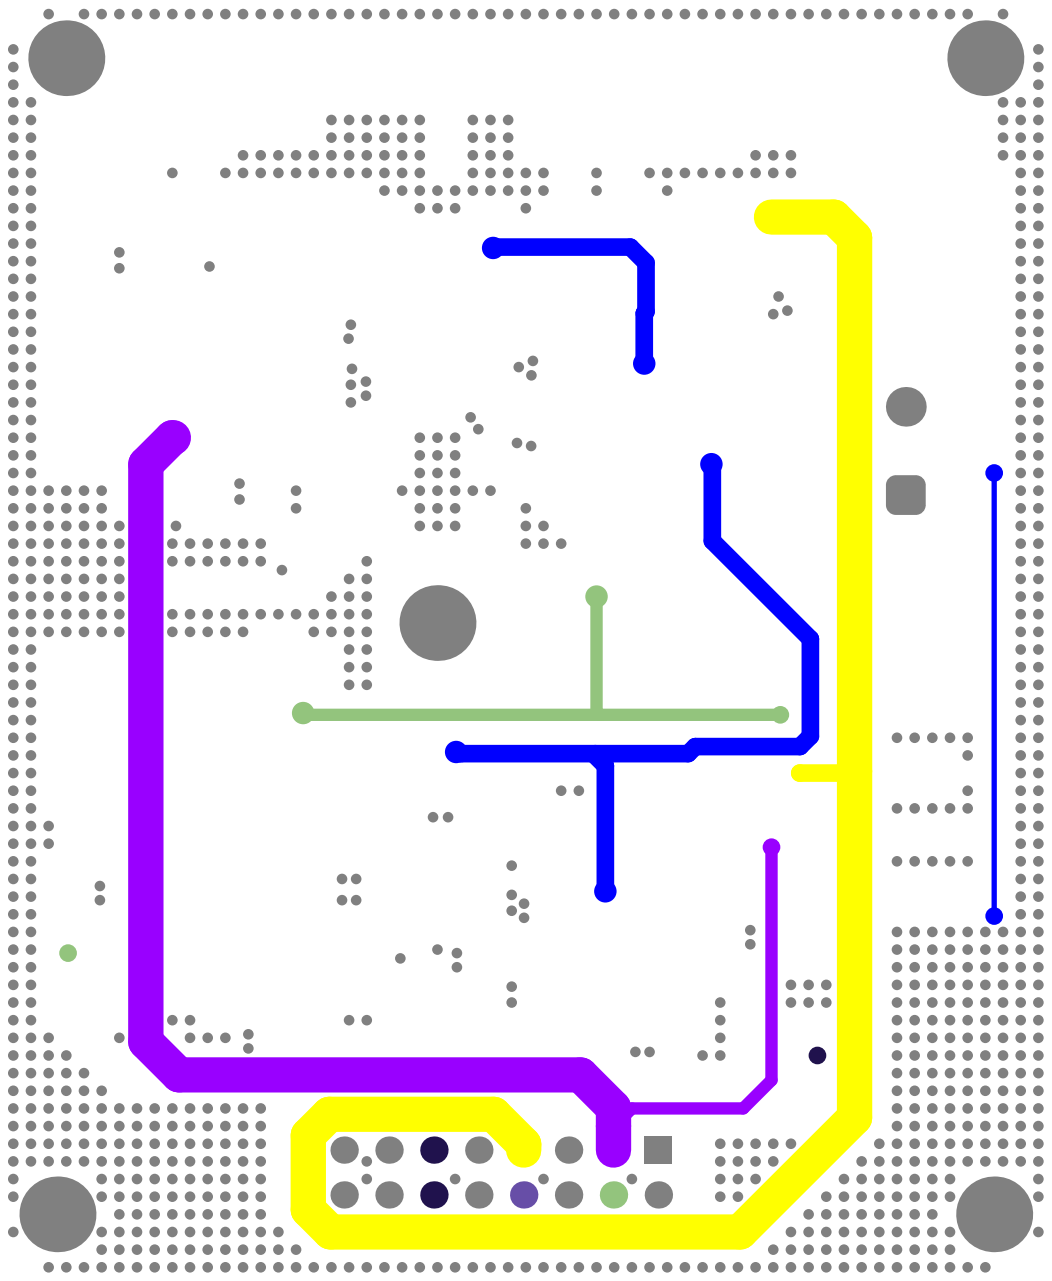
[picture p117: page 4]

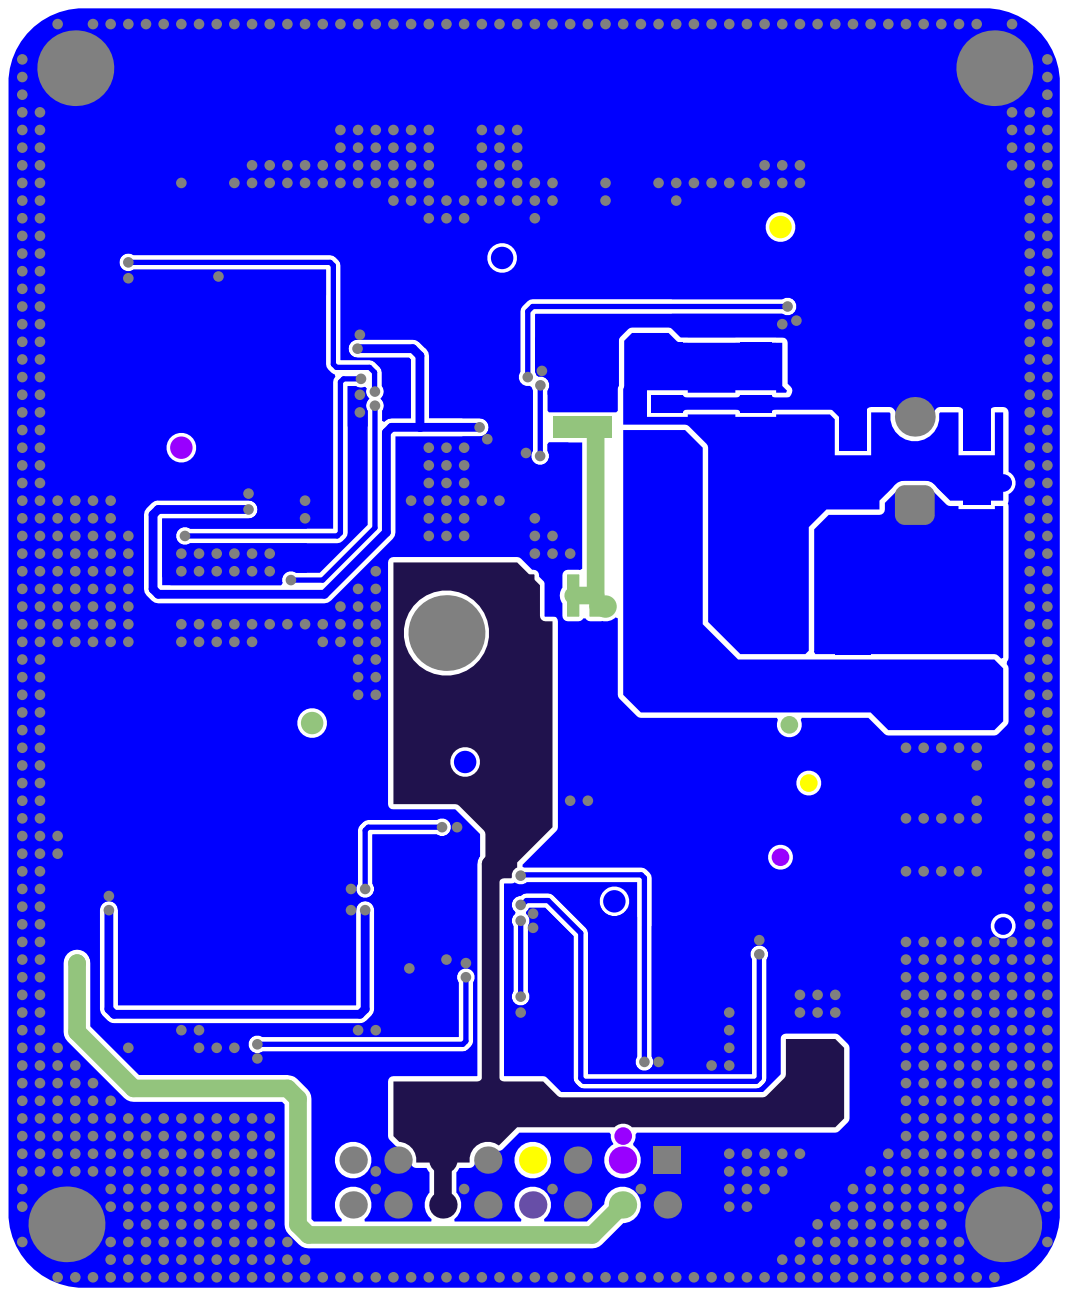
[picture p118: page 5]

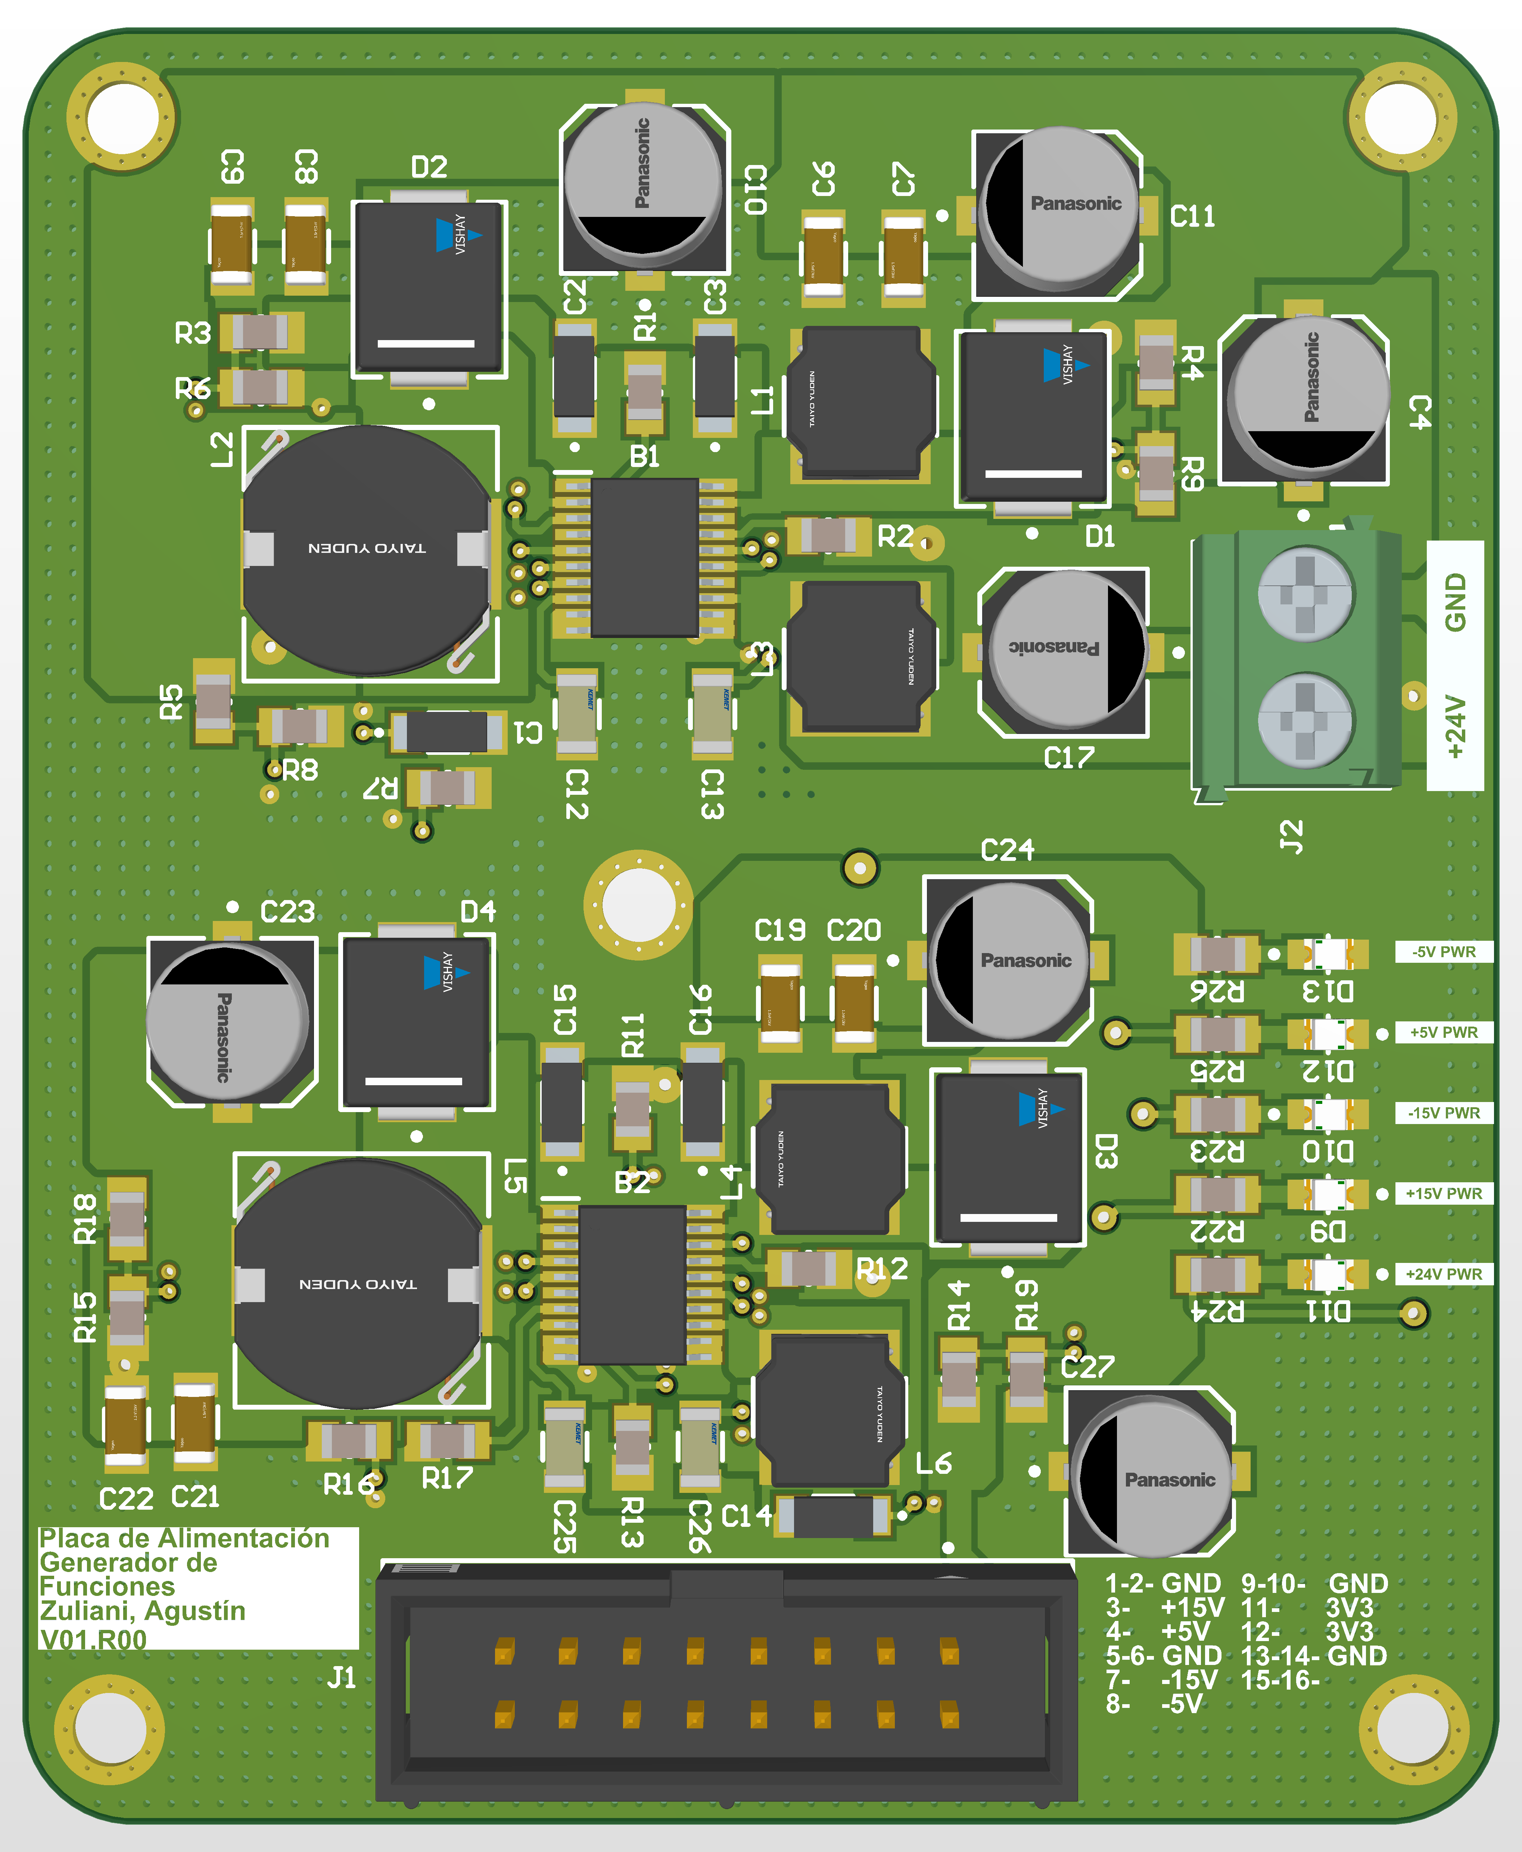
[picture p119: page 6]

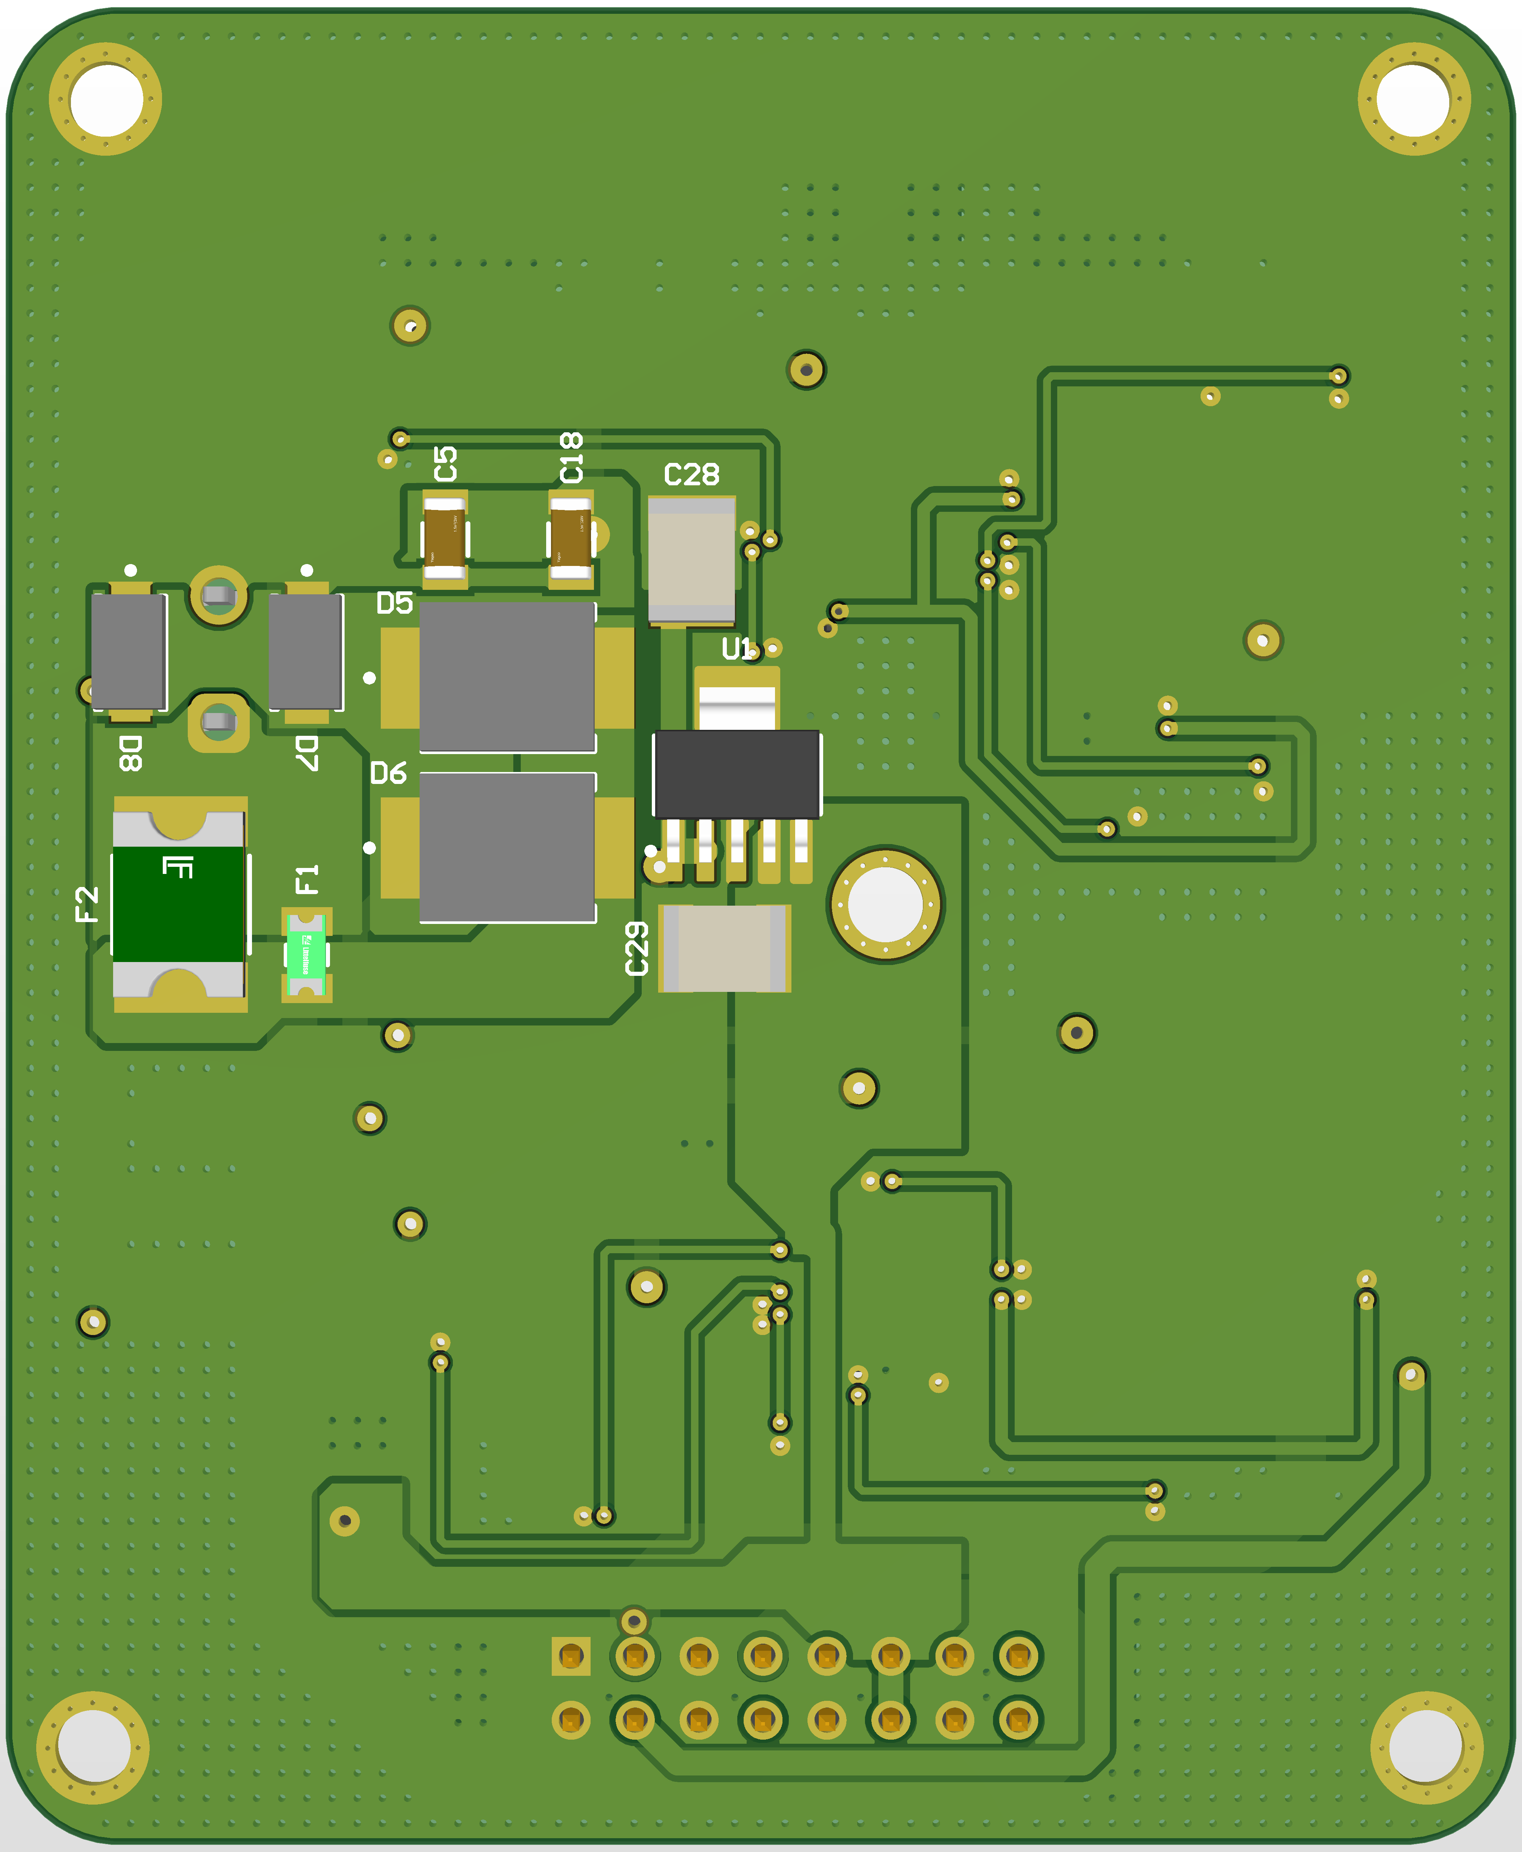
[picture p120: page 7]
