Agustin586/AWG-RP2040/PCB/PCB_Control/PCB_Control/PCB_Control.V03.R00.pdf

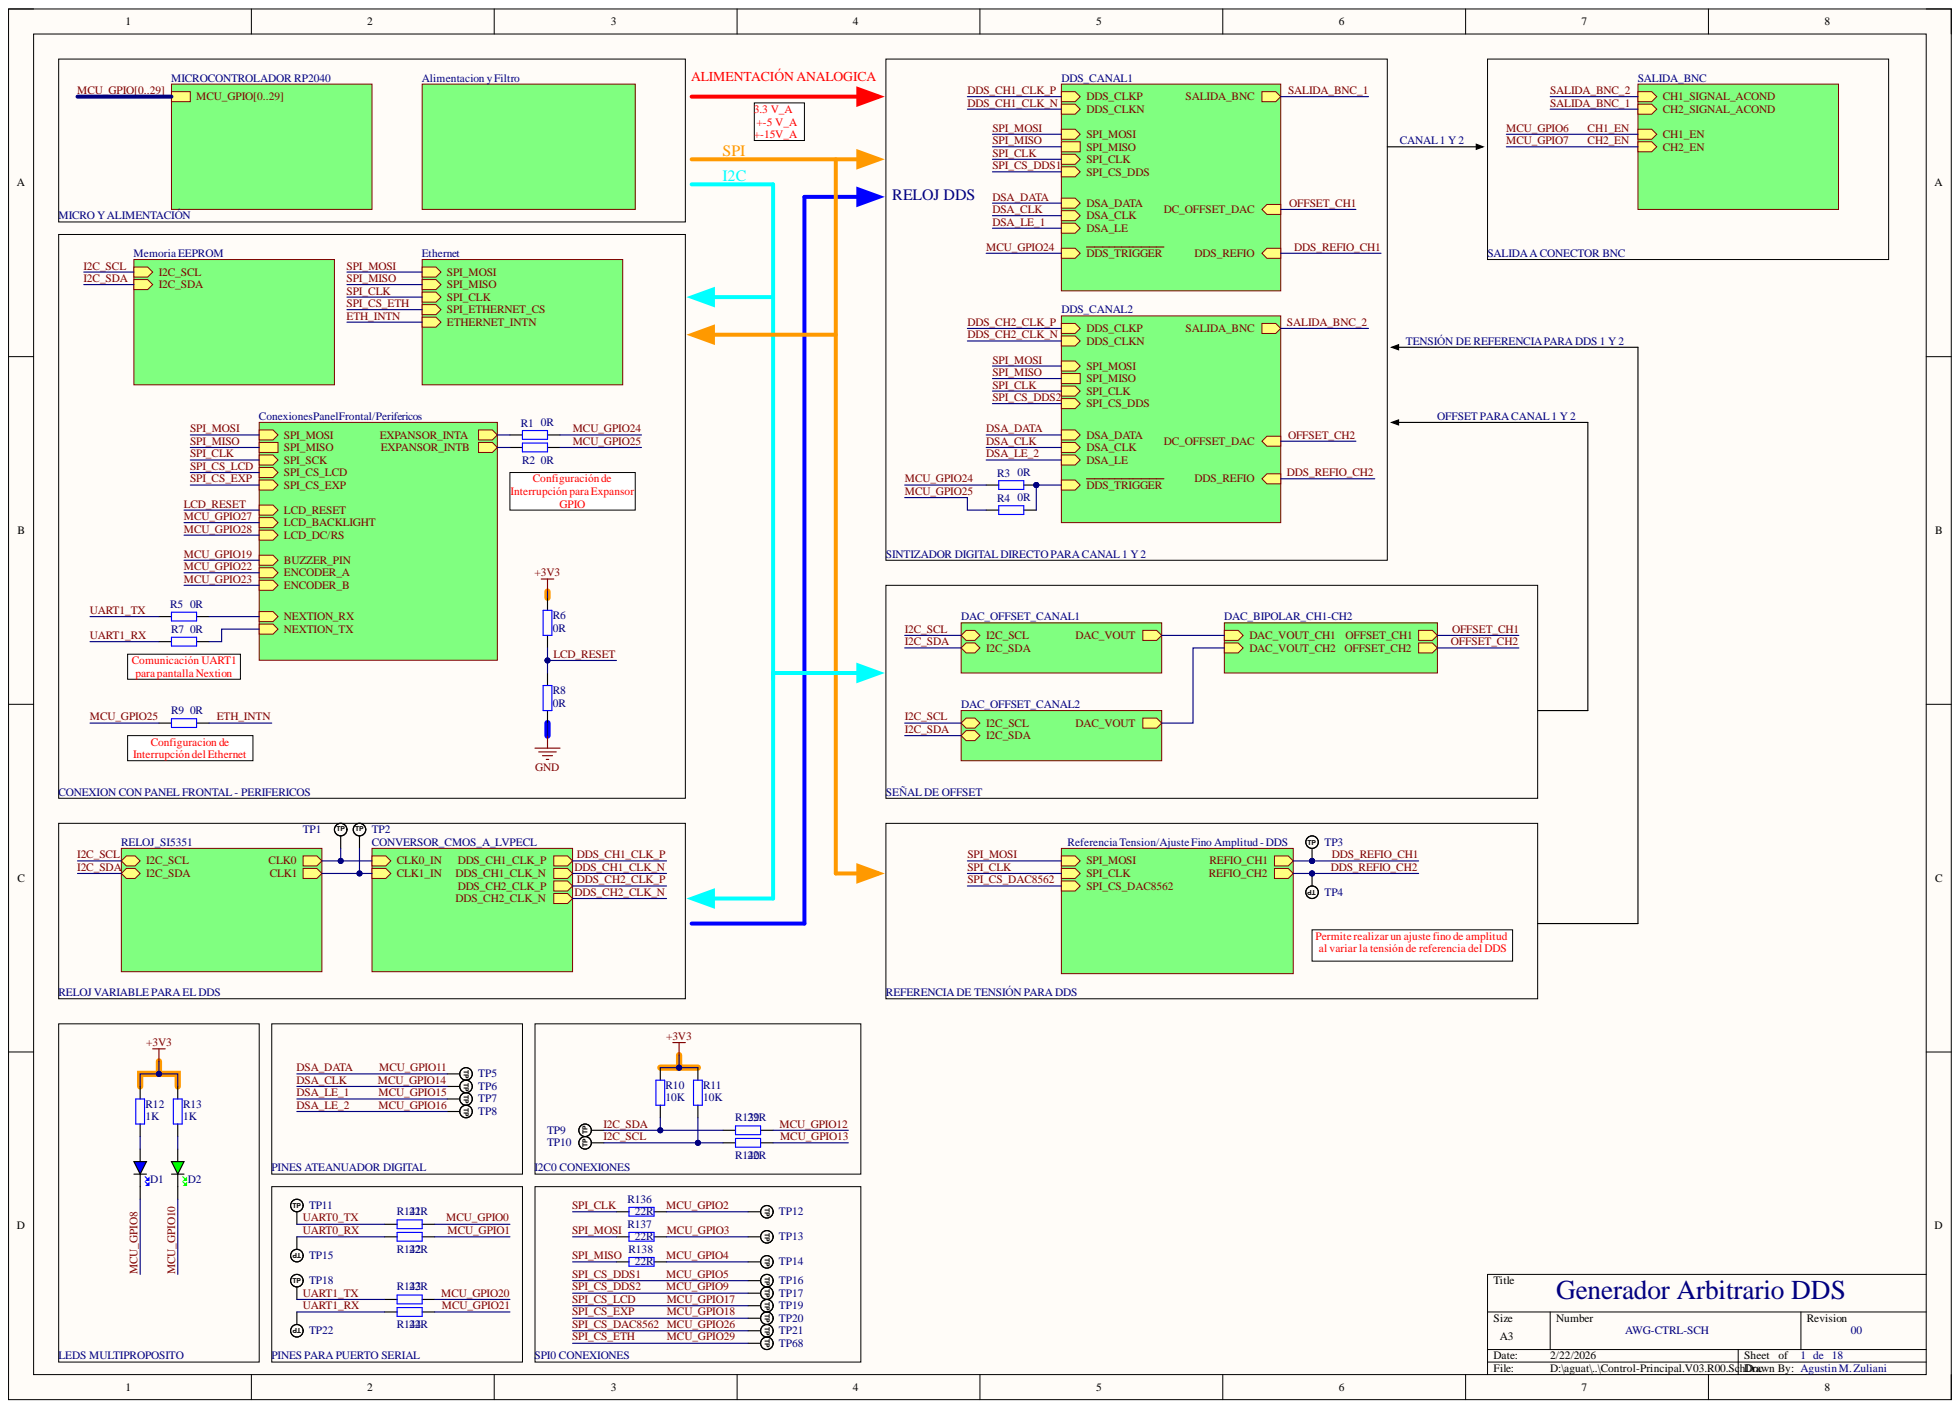
[picture p121: page 1]

TENSIÓN DE REFERENCIA PARA DDS 1 Y 2

SINTIZADOR DIGITAL DIRECTO PARA CANAL 1 Y 2

CONEXION CON PANEL FRONTAL - PERIFERICOS

Permite realizar un ajuste fino de amplitud
al variar la tensión de referencia del DDS

RELOJ VARIABLE PARA EL DDS

REFERENCIA DE TENSIÓN PARA DDS

PINES PARA PUERTO SERIAL

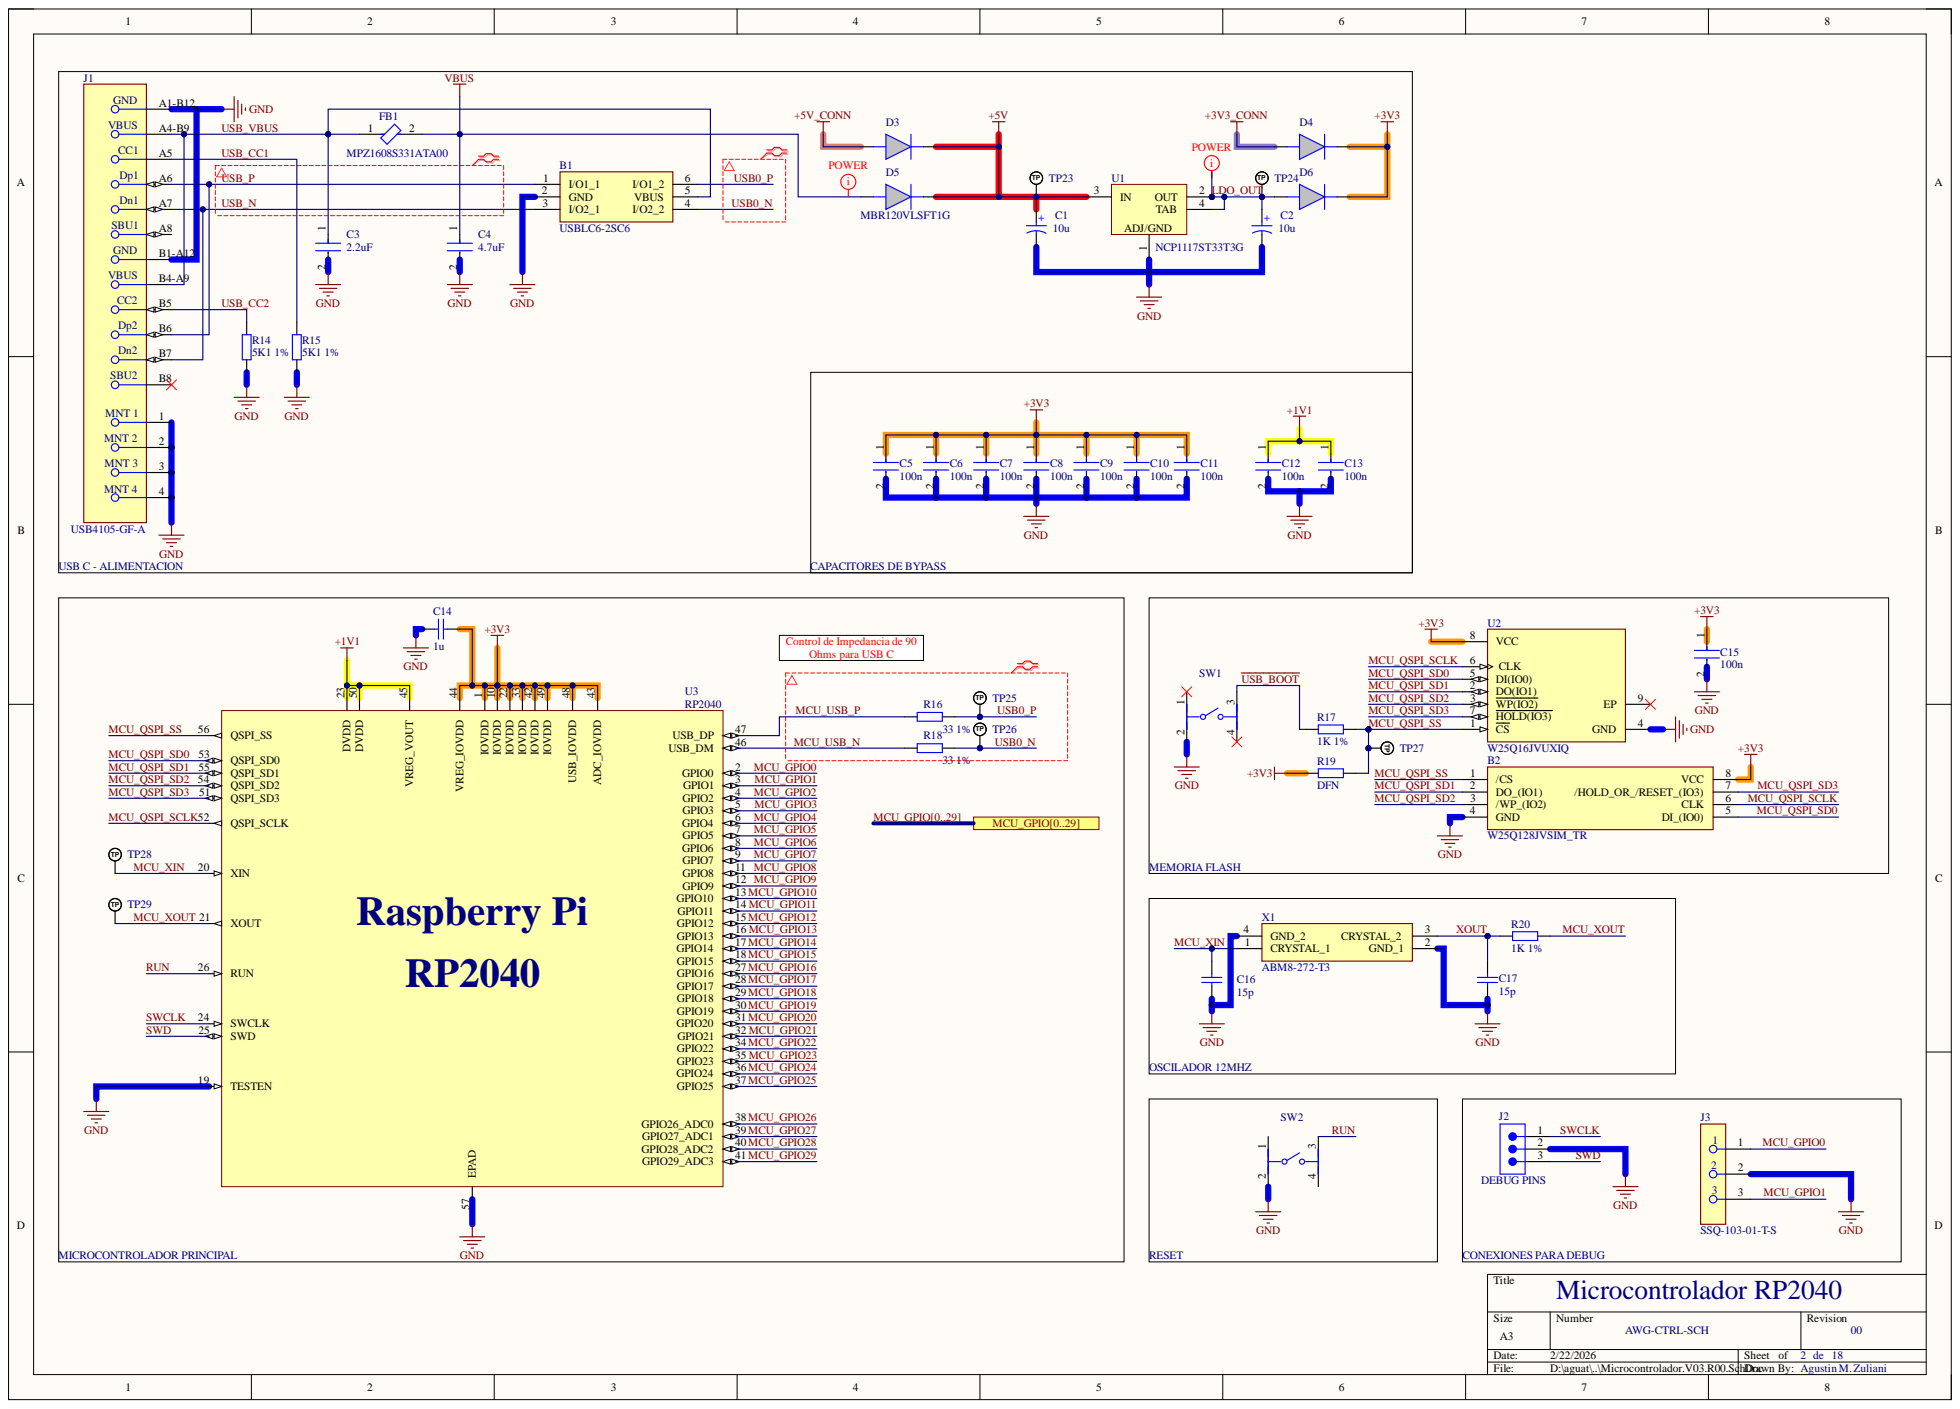
[picture p122: page 2]

I/O2_1 3 | USB0_N

USB_CC2

Control de Impedancia de 90
Ohms para USB C

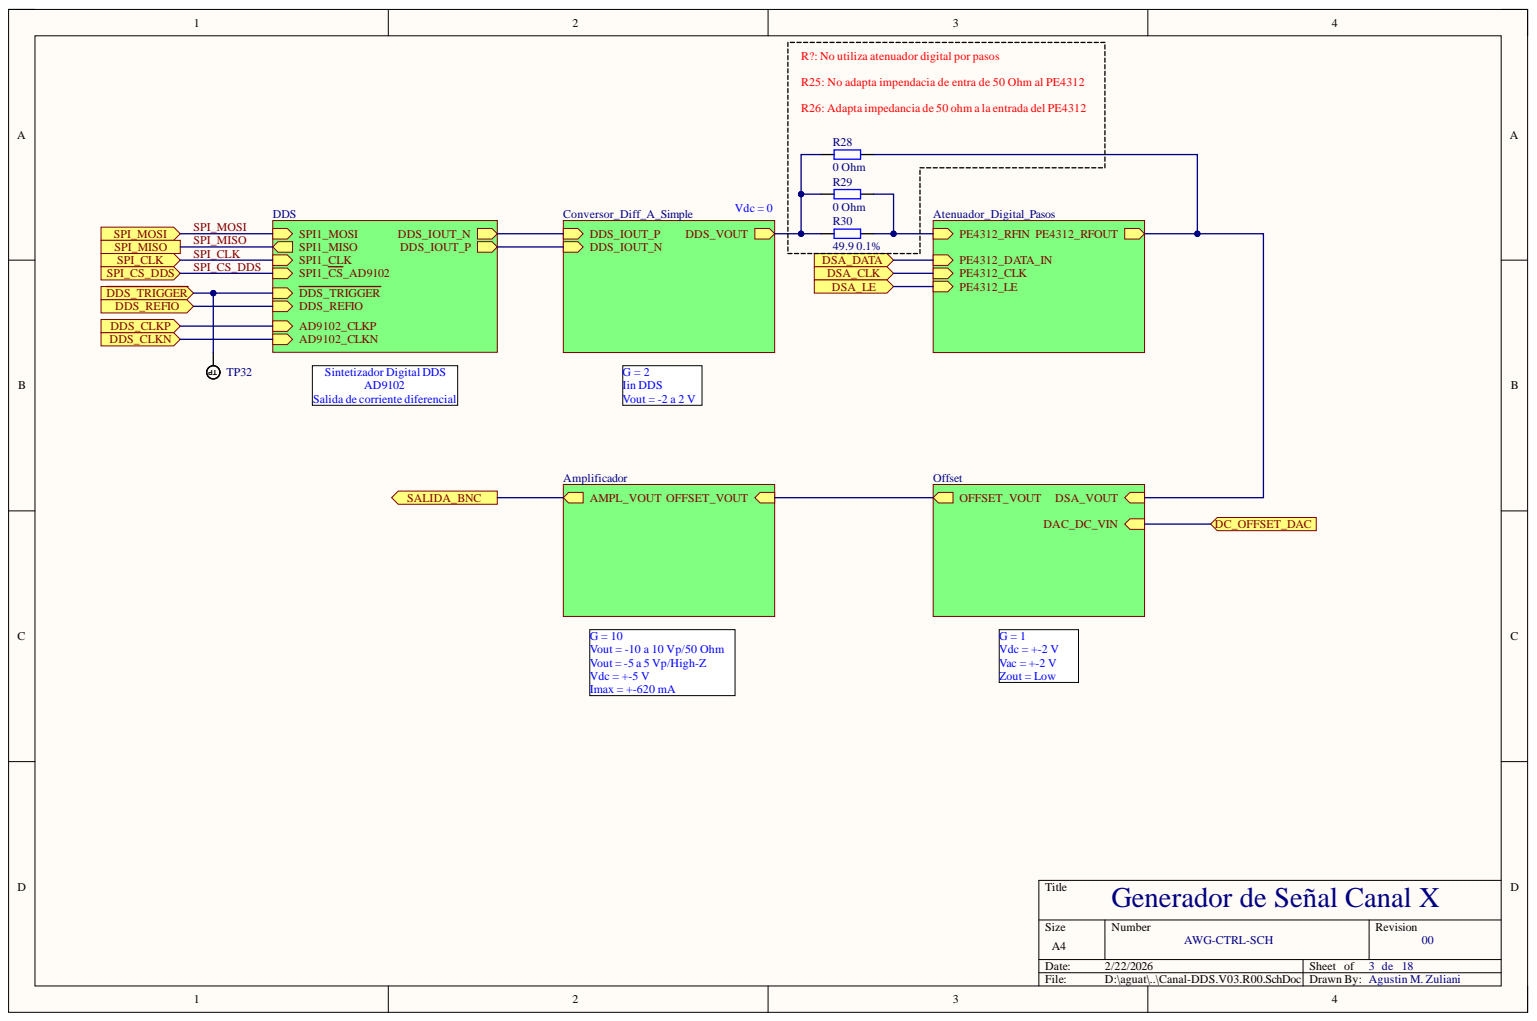
[picture p123: page 3]

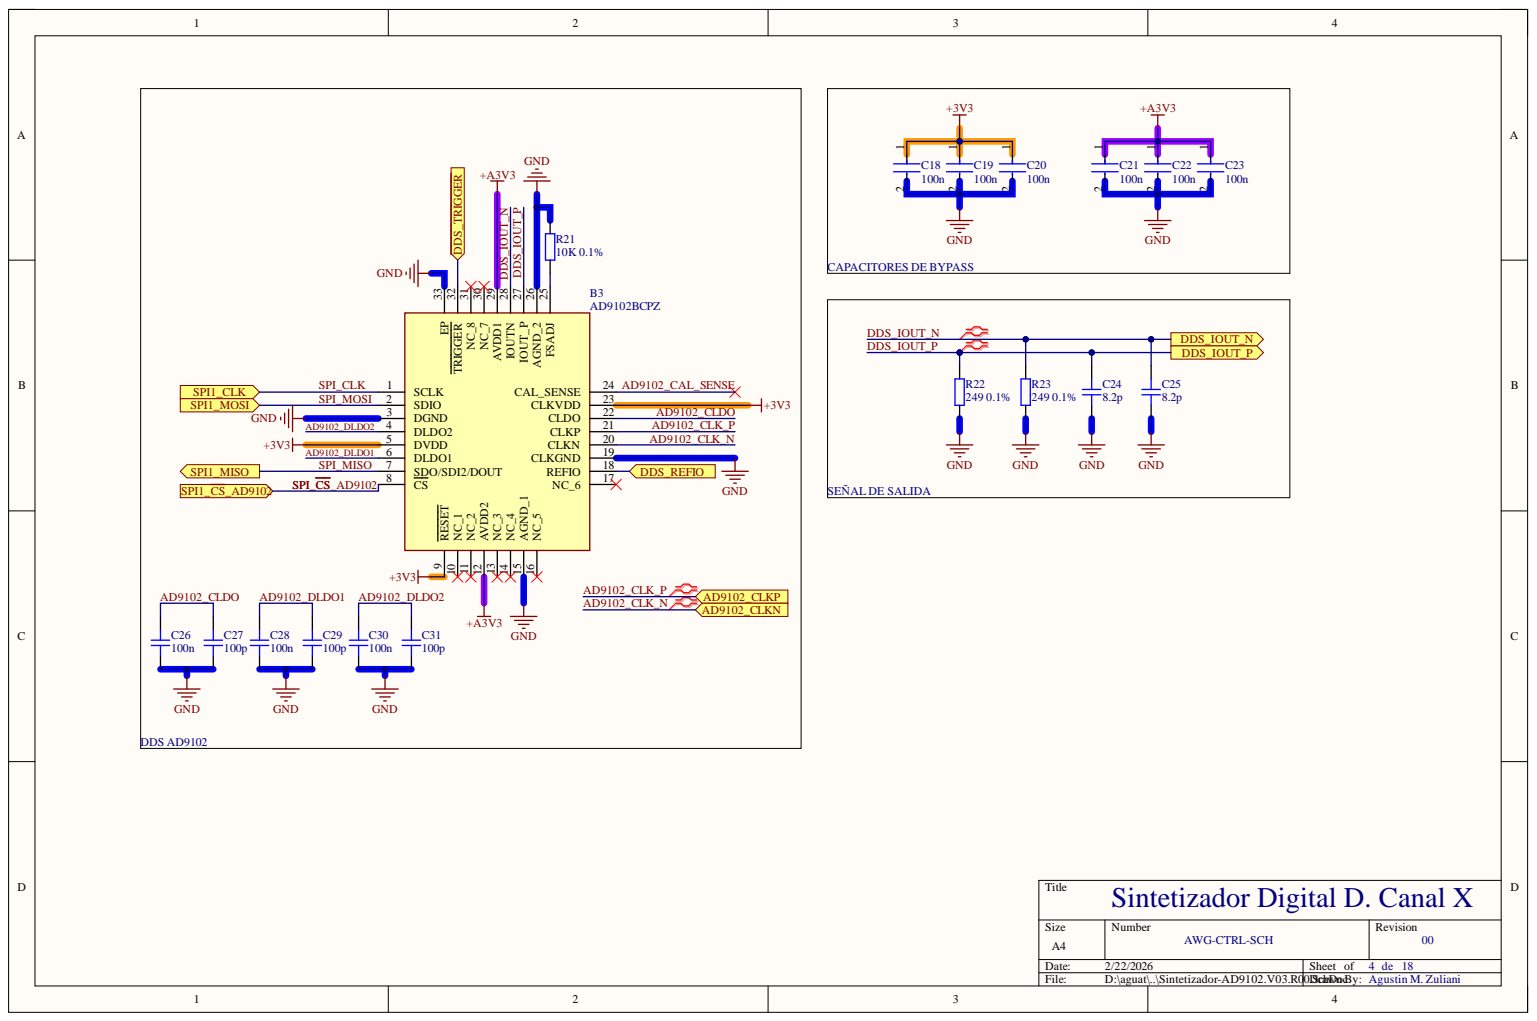
[picture p124: page 4]

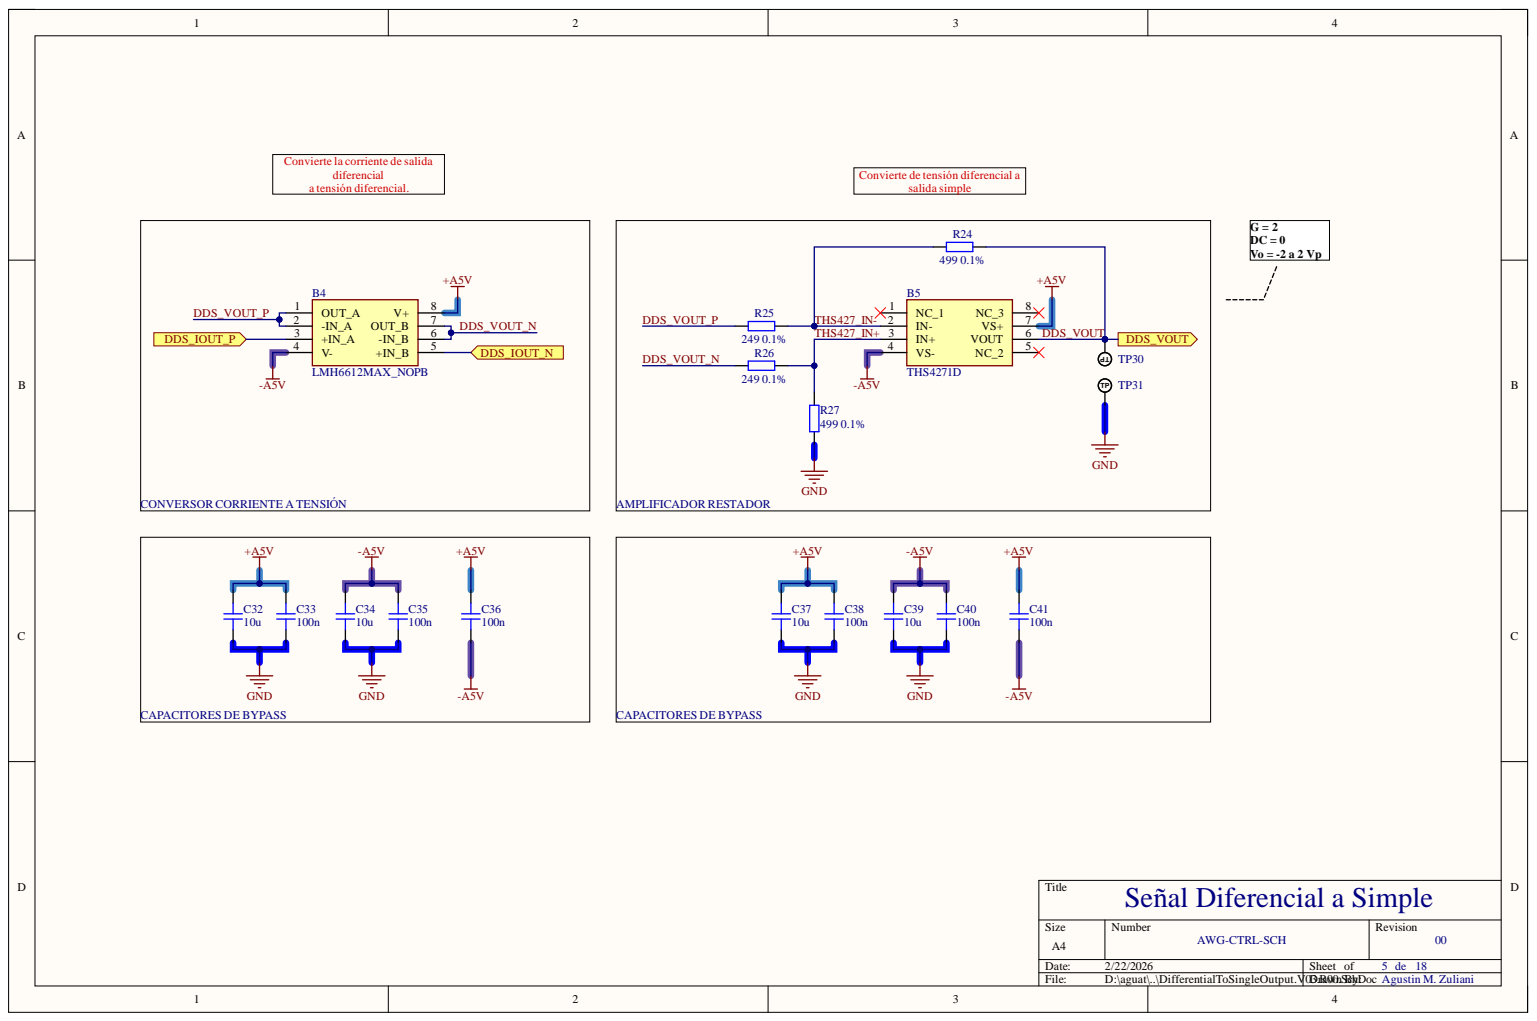
[picture p125: page 5]

Convierte la corriente de salida

Convierte de tensión diferencial a

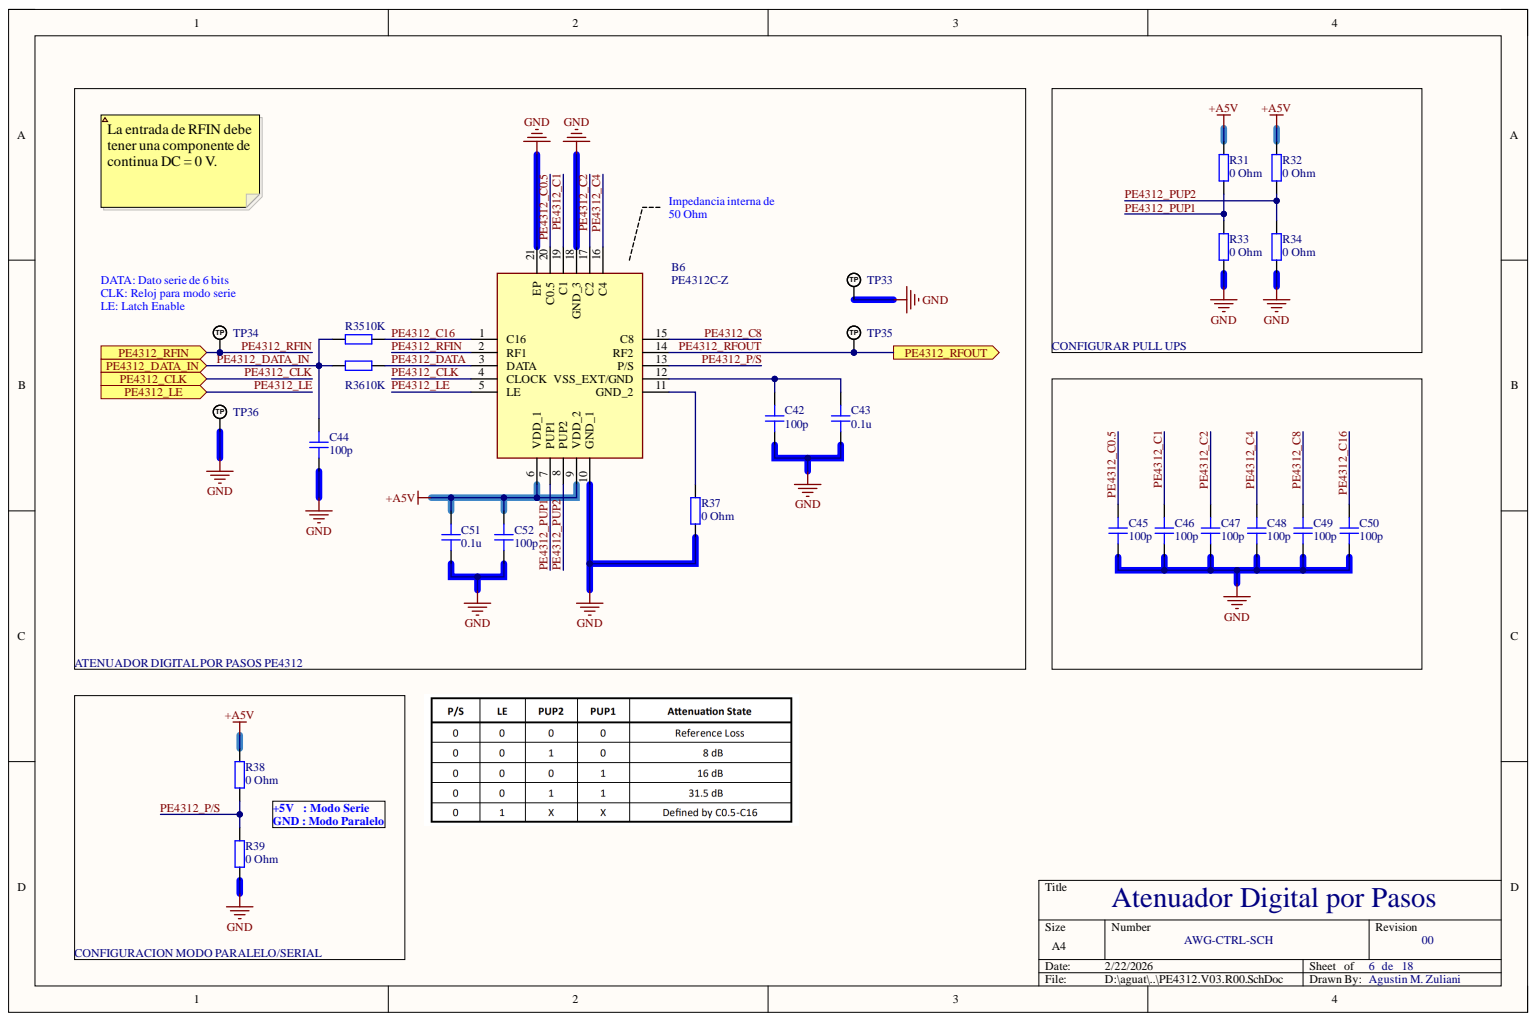
[picture p126: page 6]

La entrada de RFIN debe
tener una componente de
continua DC = 0 V.

DATA: Dato serie de 6 bits
CLK: Reloj para modo serie
LE: Latch Enable

Title
Atenuador Digital por Pasos

CONFIGURACION MODO PARALELO/SERIAL

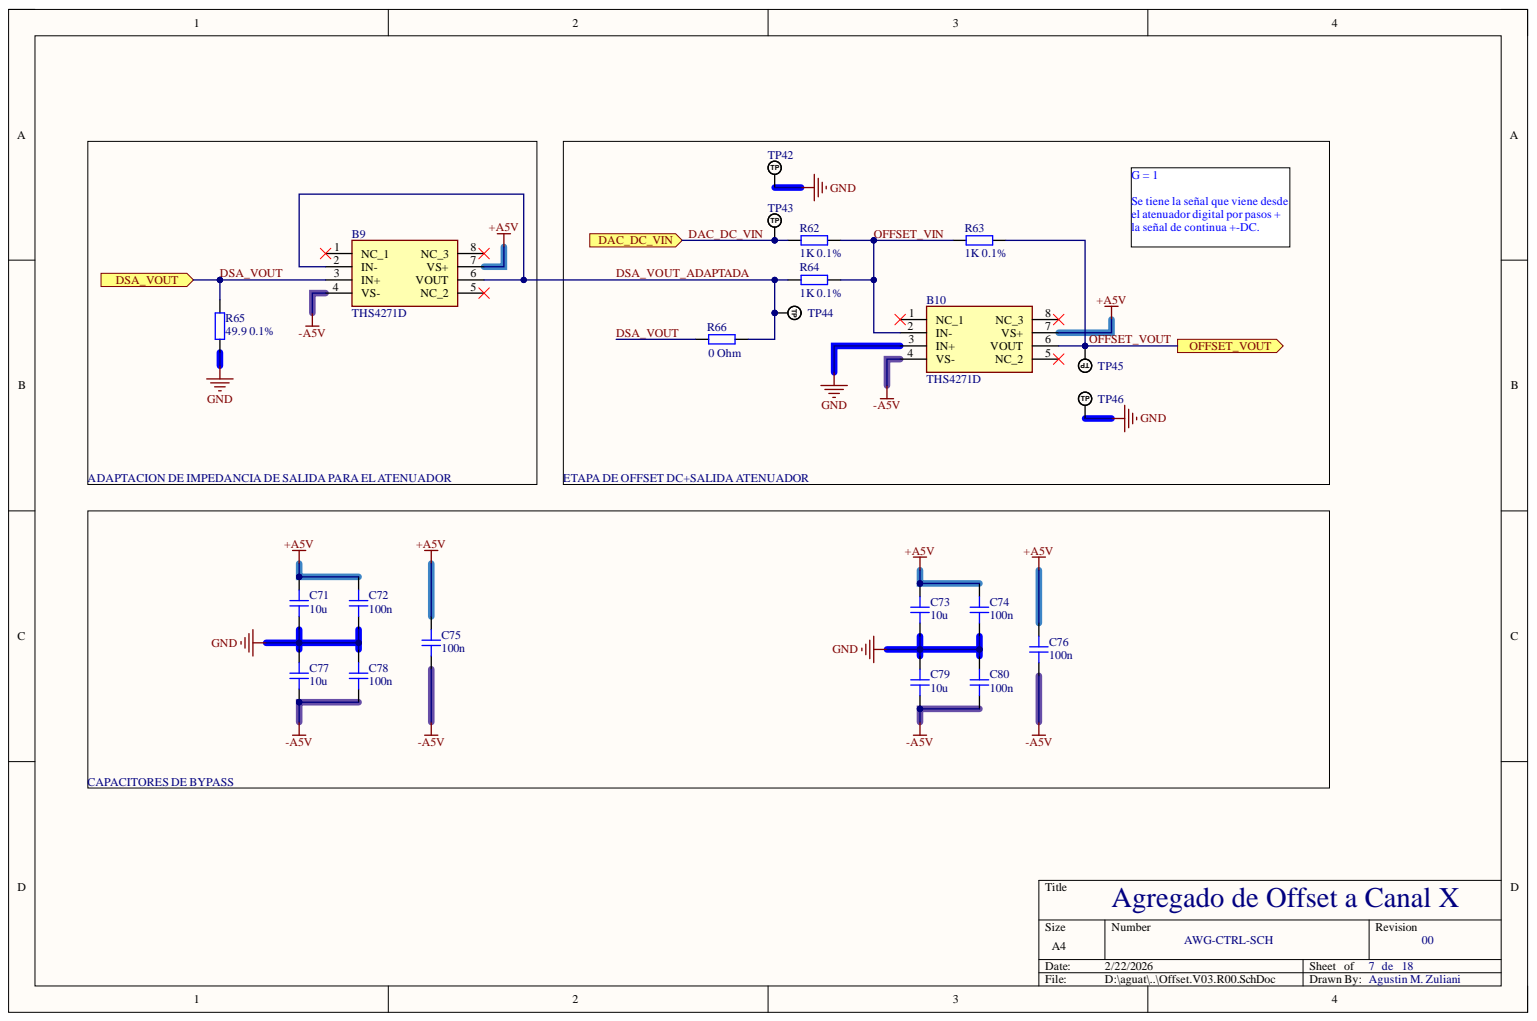
[picture p127: page 7]

Se tiene la señal que viene desde
el atenuador digital por pasos +
la señal de continua +-DC.

NC_1 1 VOUT

ADAPTACION DE IMPEDANCIA DE SALIDA PARA ELATENUADOR

ETAPA DE OFFSET DC+SALIDA ATENUADOR

Title
Agregado de Offset a Canal X

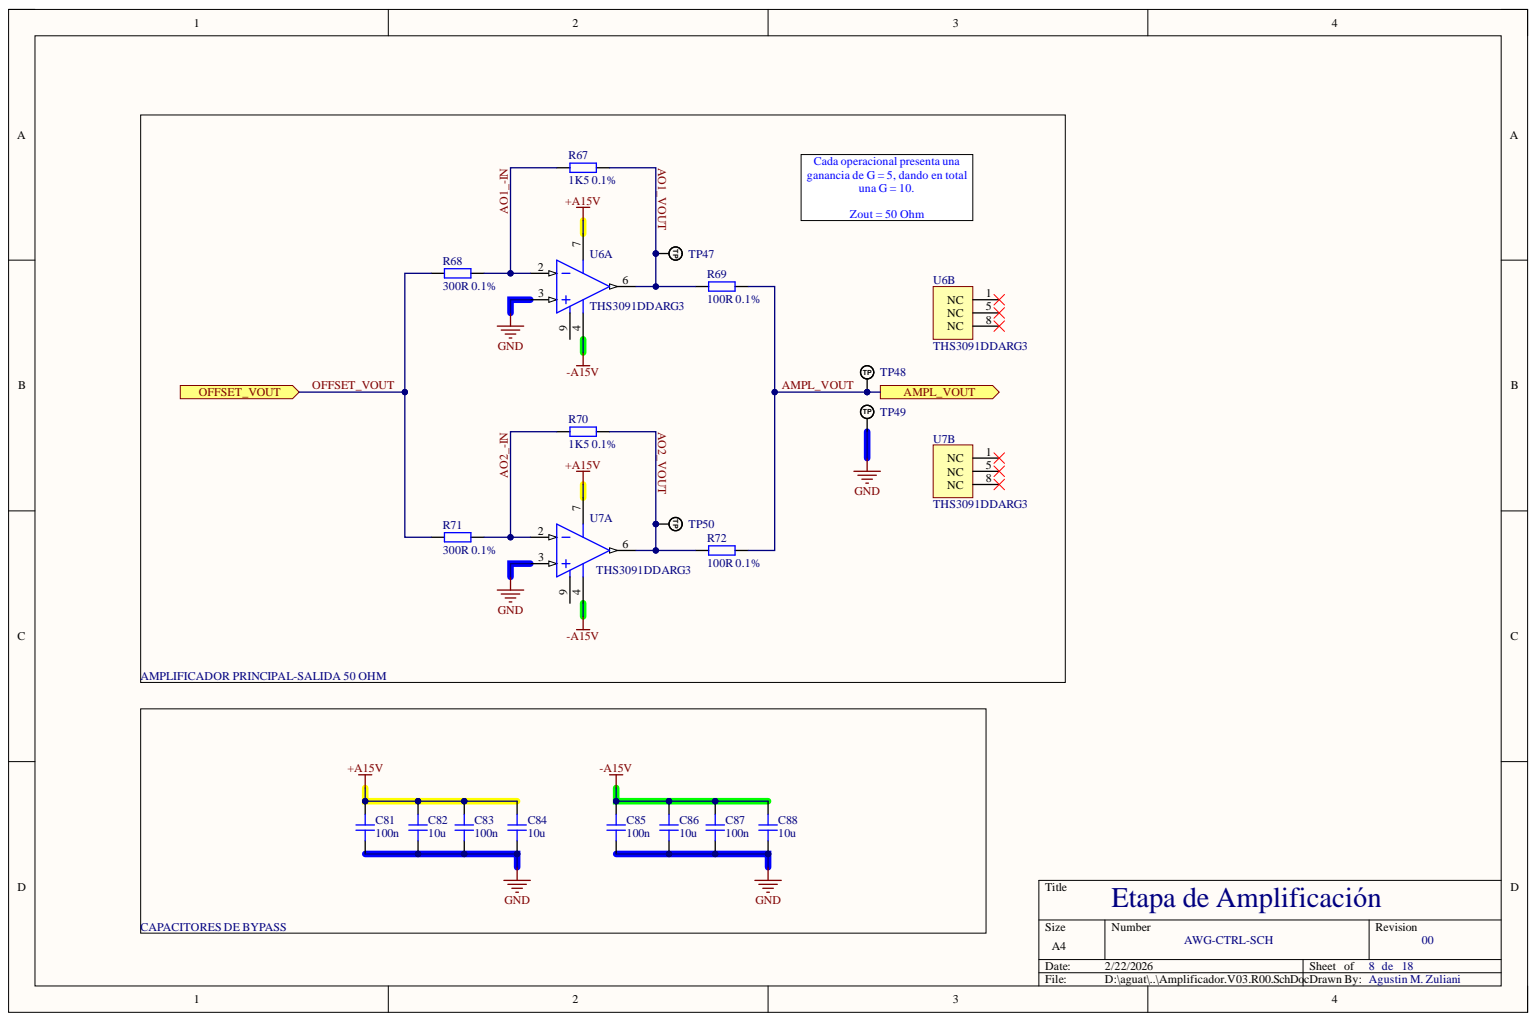
[picture p128: page 8]

Cada operacional presenta una
ganancia de G = 5, dando en total

AMPLIFICADOR PRINCIPAL-SALIDA 50 OHM

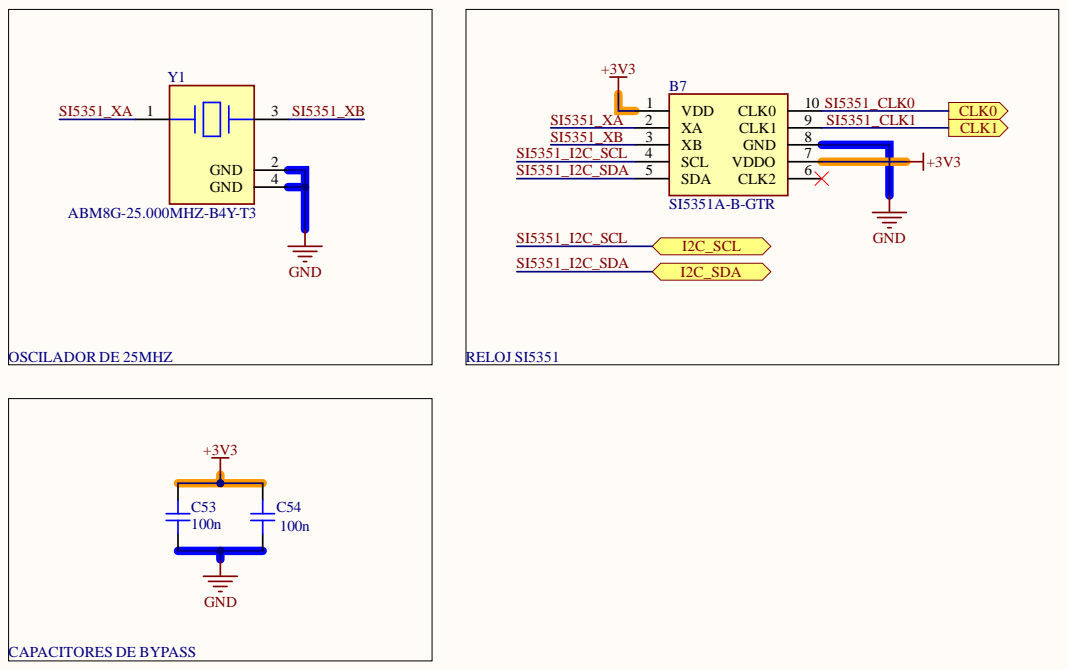
[picture p129: page 9]

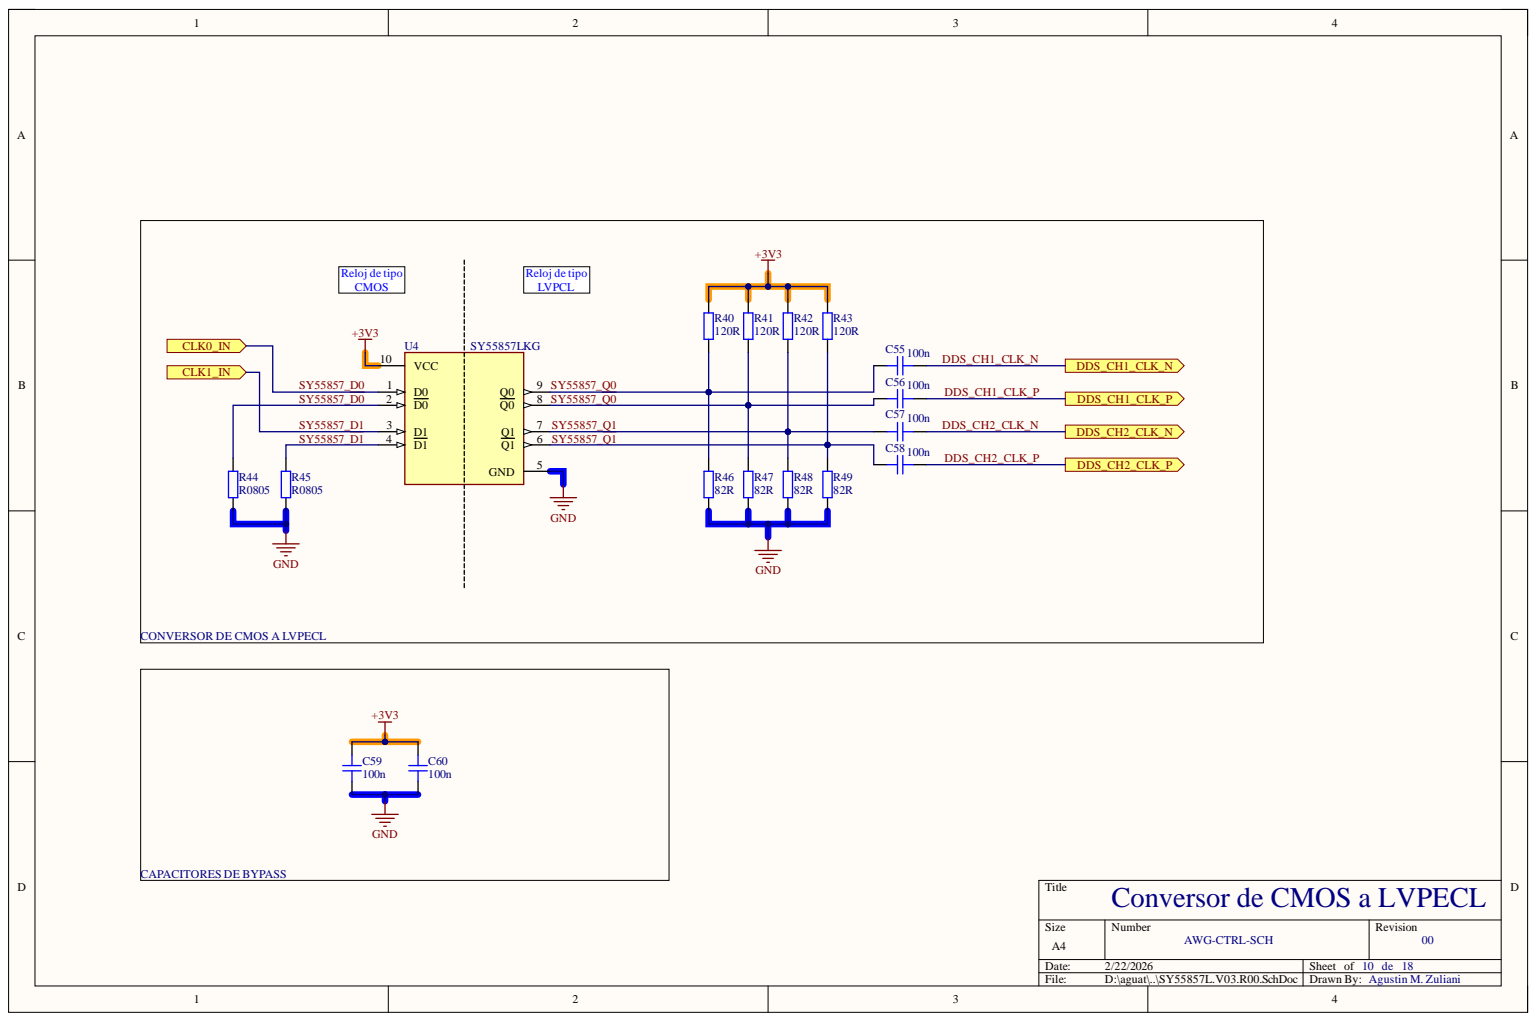
[picture p130: page 10]

CONVERSOR DE CMOS A LVPECL

Title
Conversor de CMOS a LVPECL

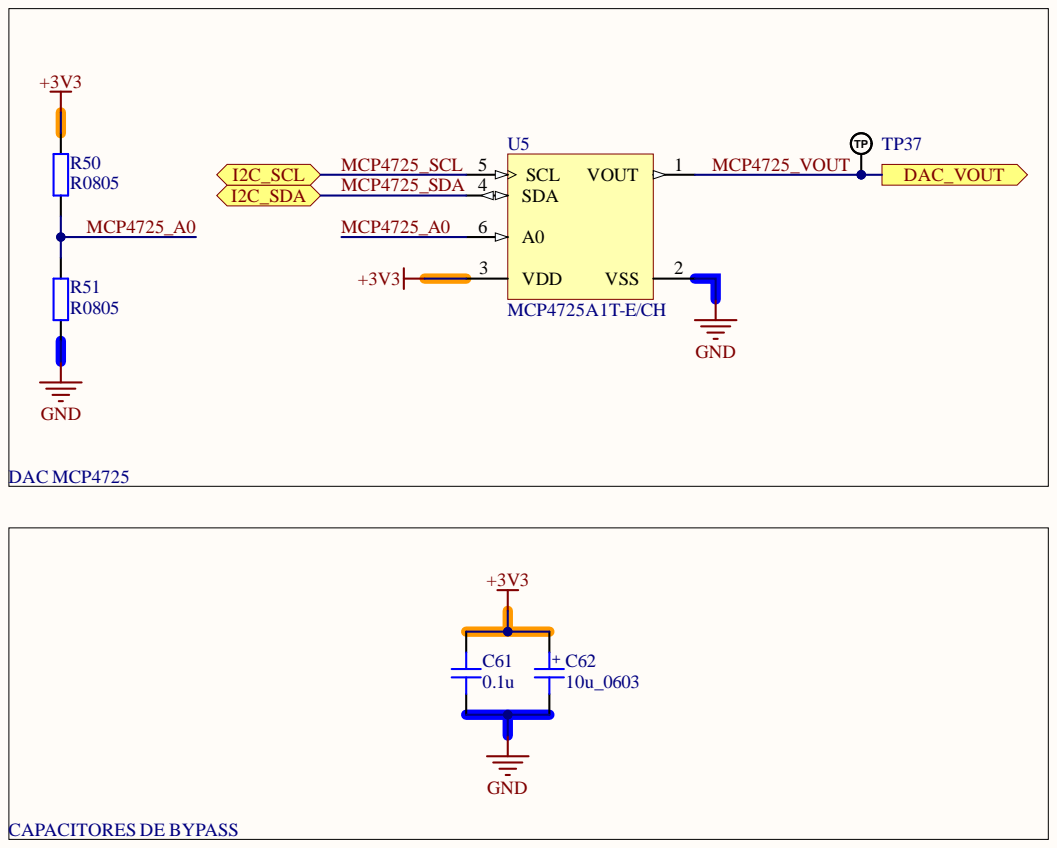
[picture p131: page 11]

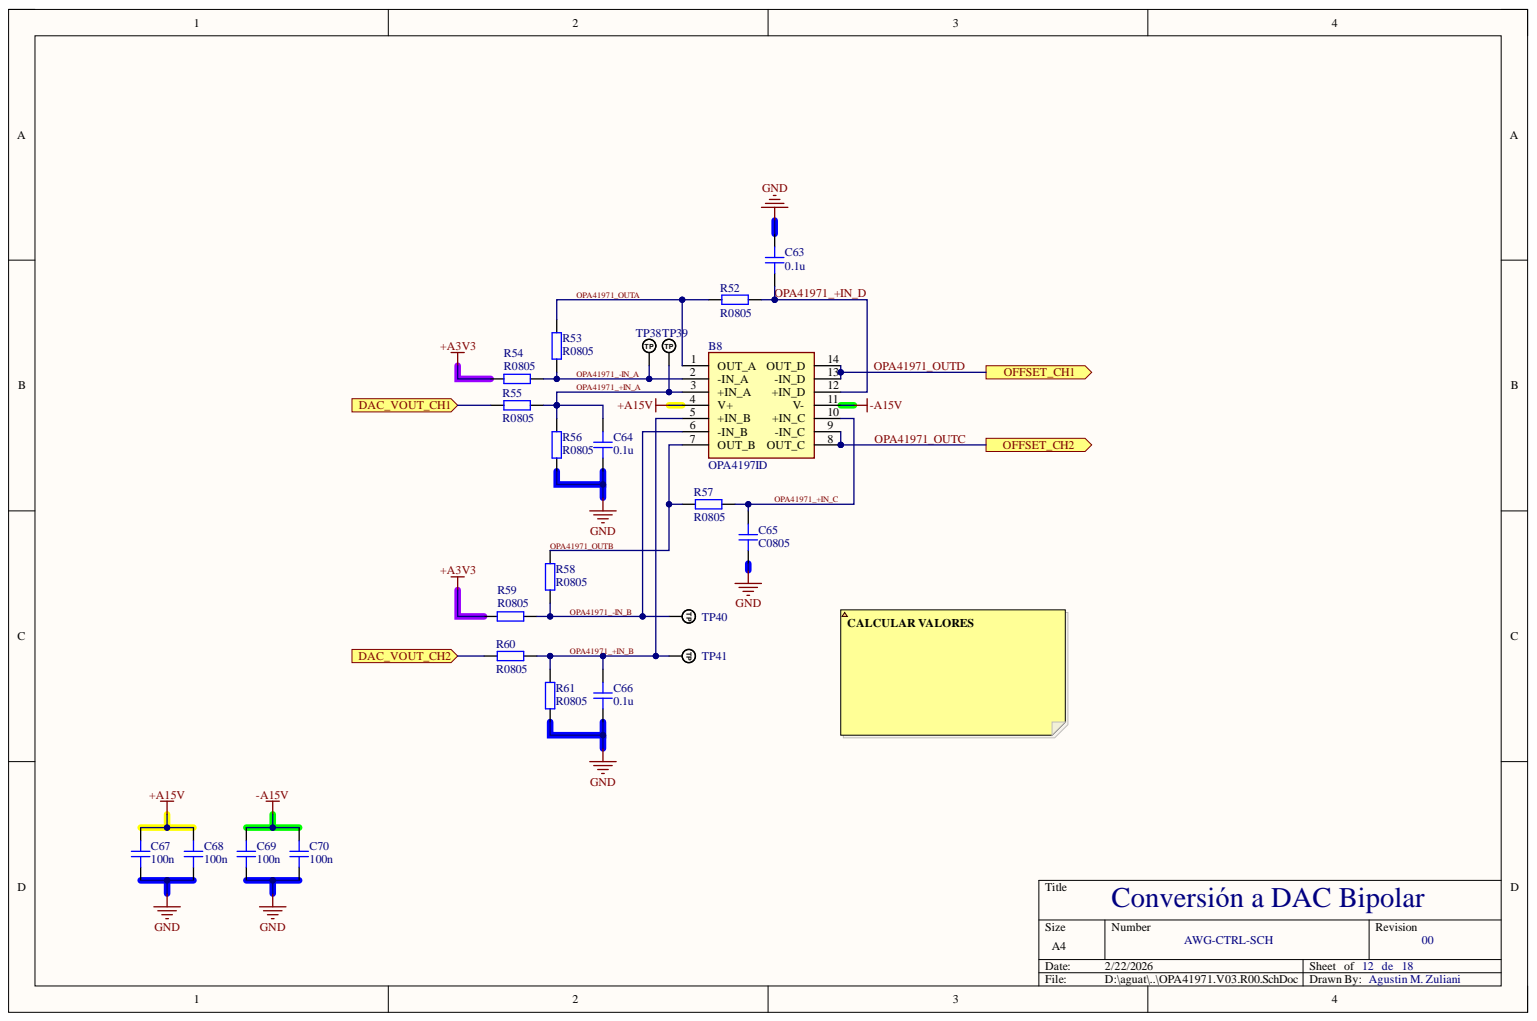
[picture p132: page 12]

OUT_A 1
-IN_A 2
+IN_A 3
V+ 4
+IN_B 5

OPA41971_-IN_B

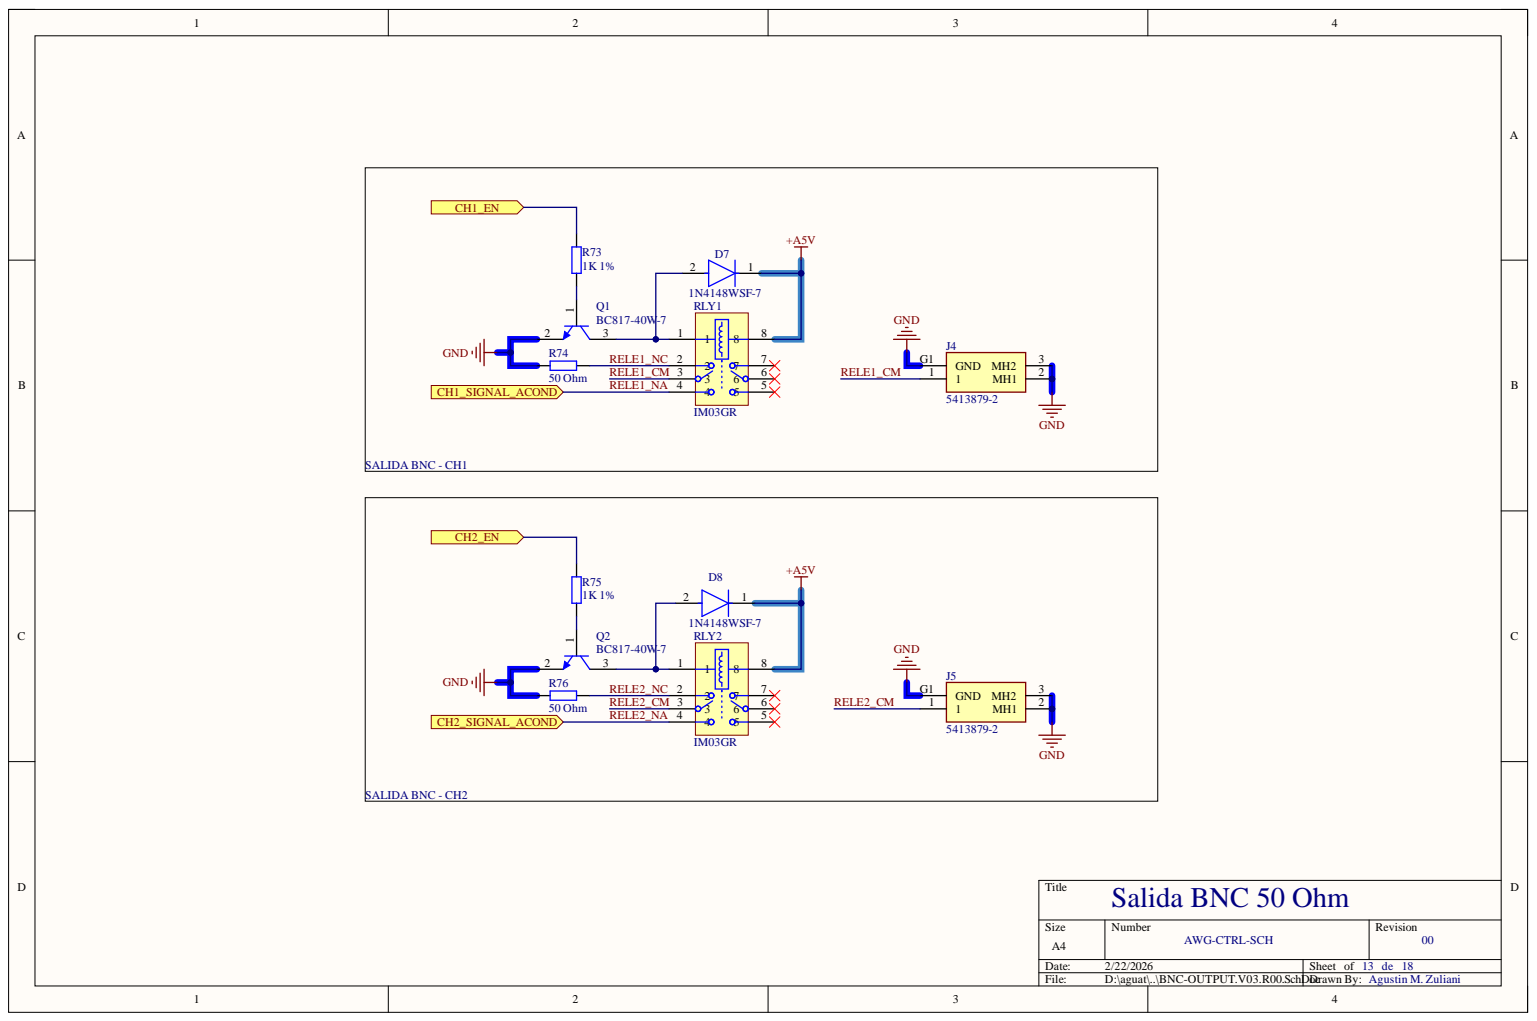
[picture p133: page 13]

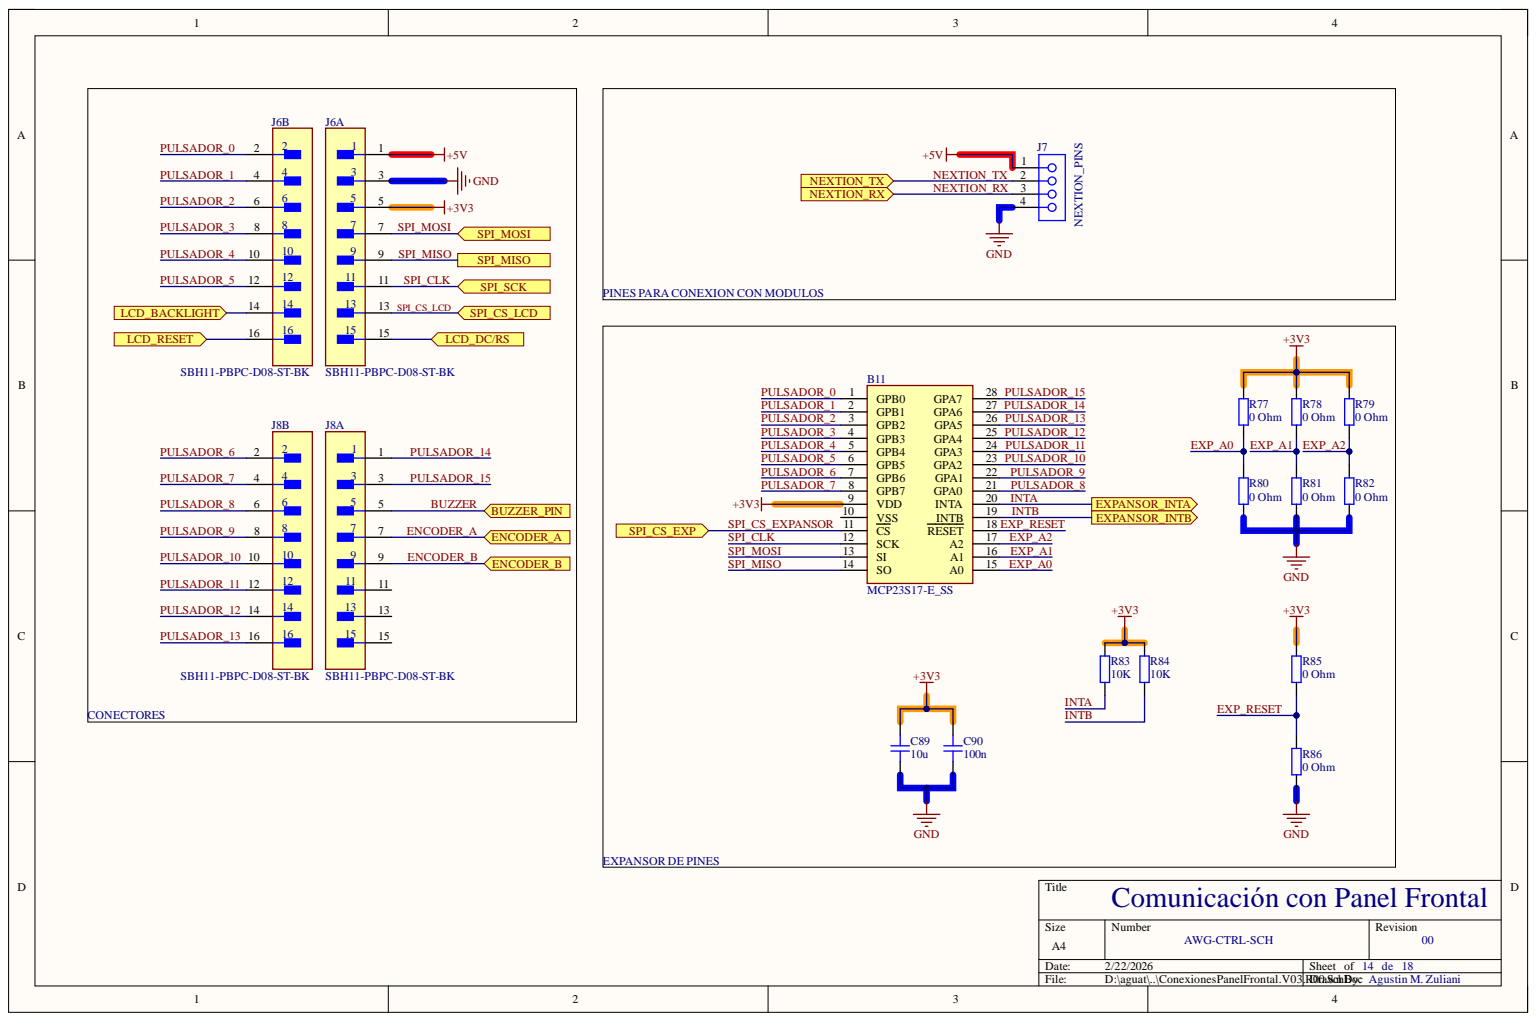
[picture p134: page 14]

PINES PARA CONEXION CON MODULOS

Title
Comunicación con Panel Frontal

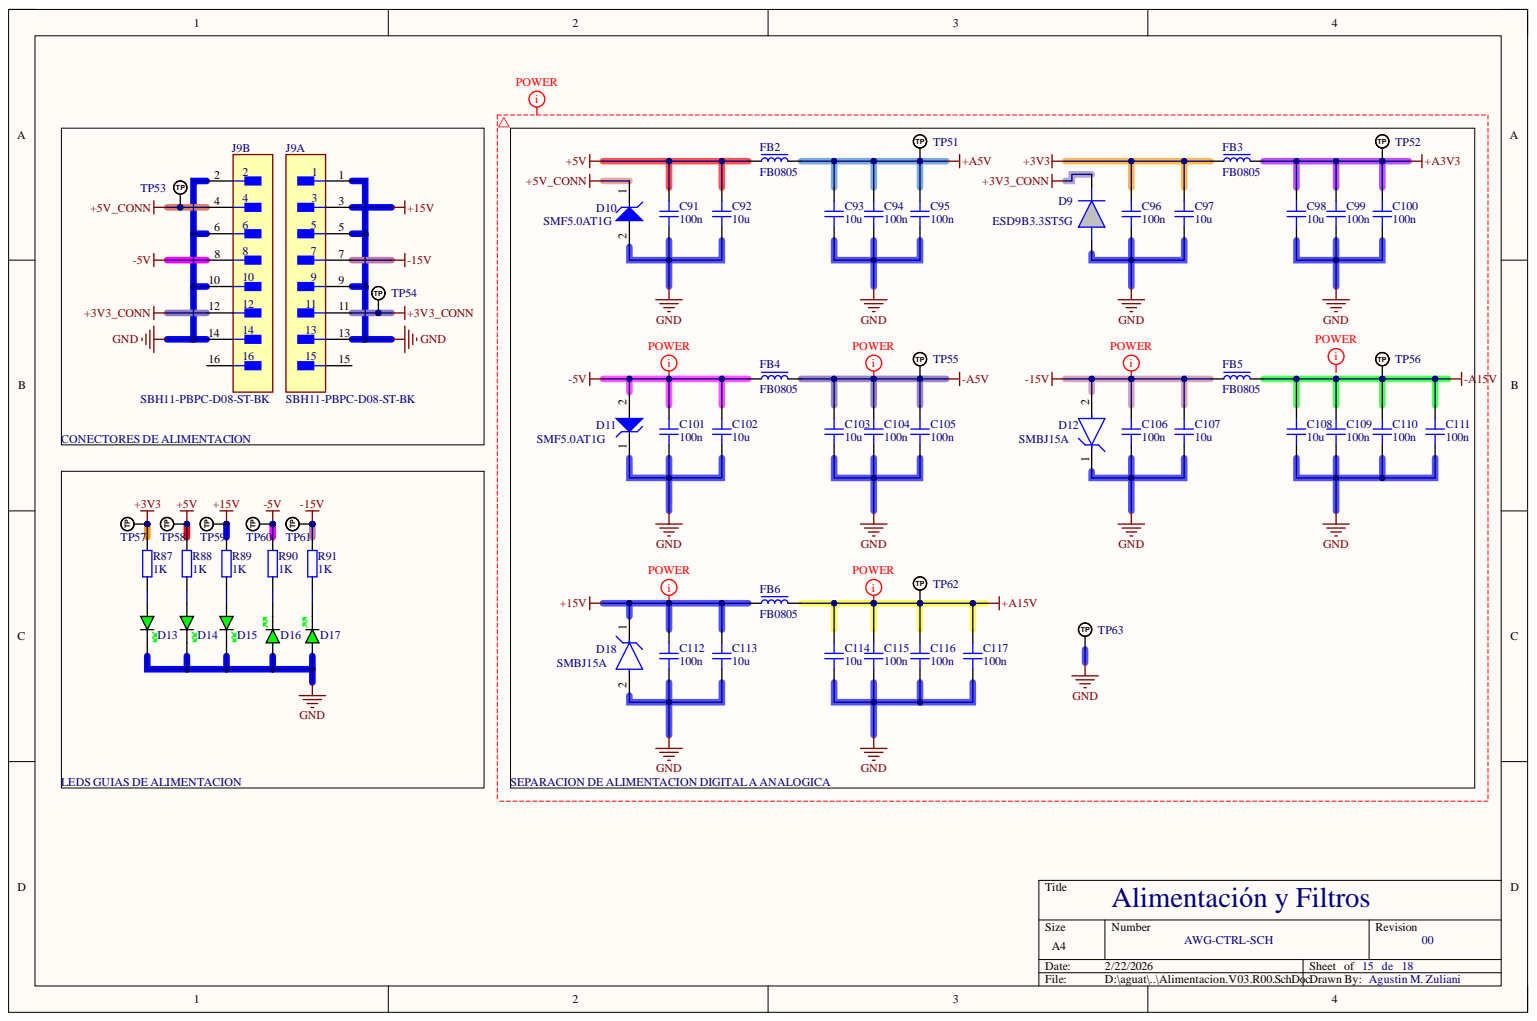
[picture p135: page 15]

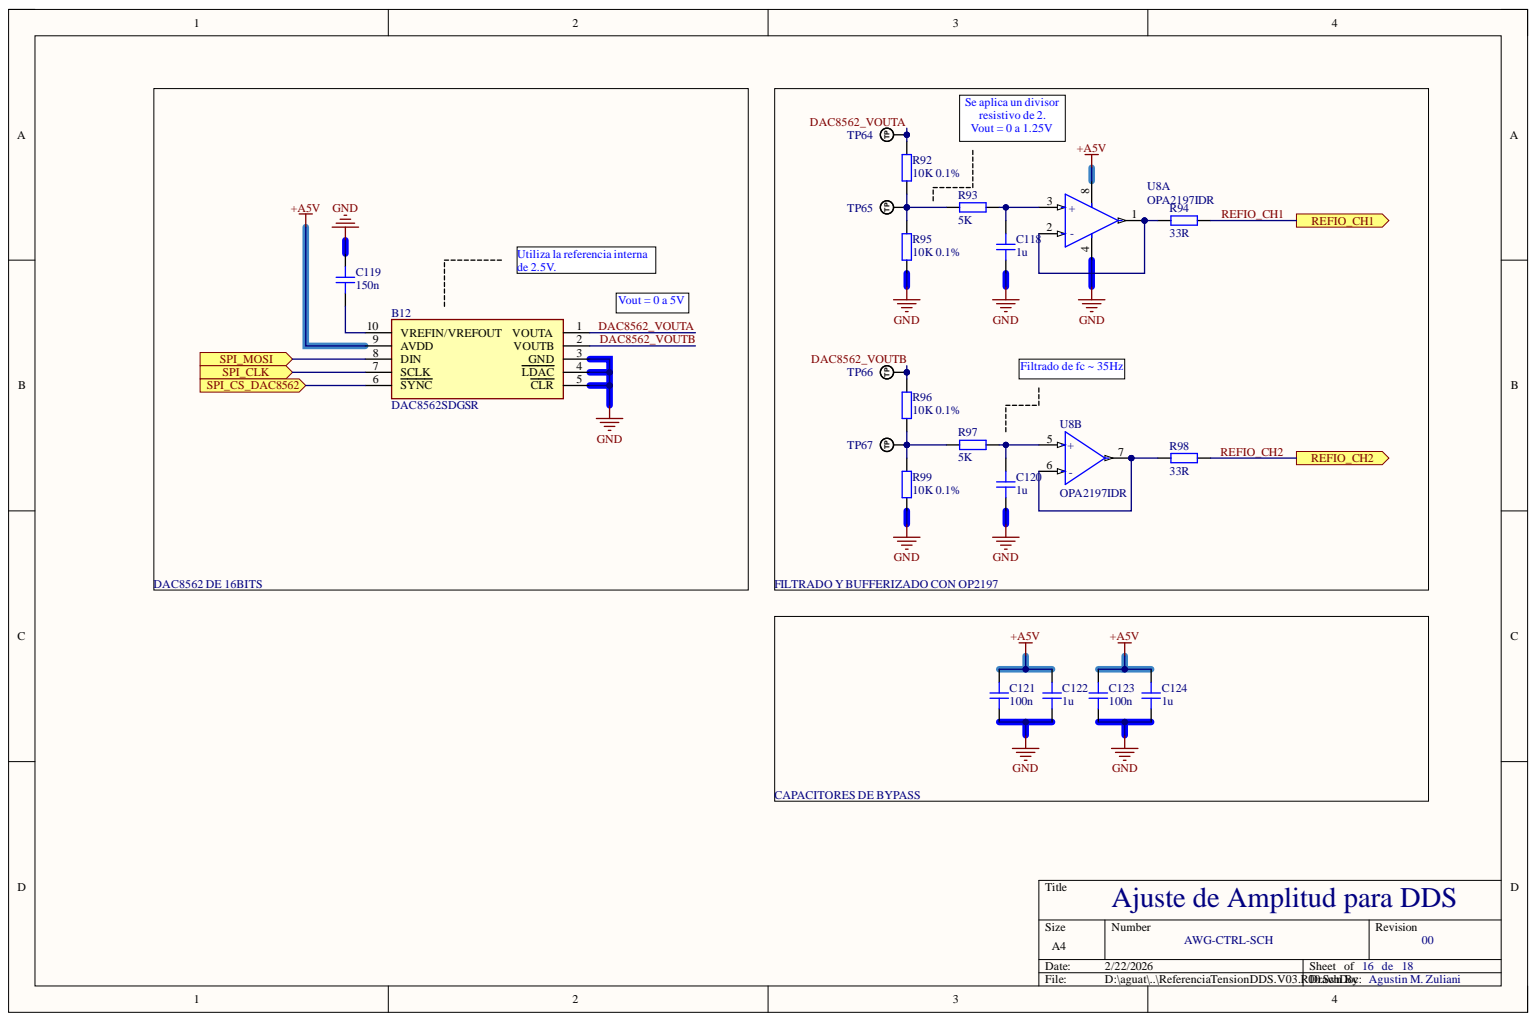
[picture p136: page 16]

Se aplica un divisor
resistivo de 2.
Vout = 0 a 1.25V

Utiliza la referencia interna

Title
Ajuste de Amplitud para DDS

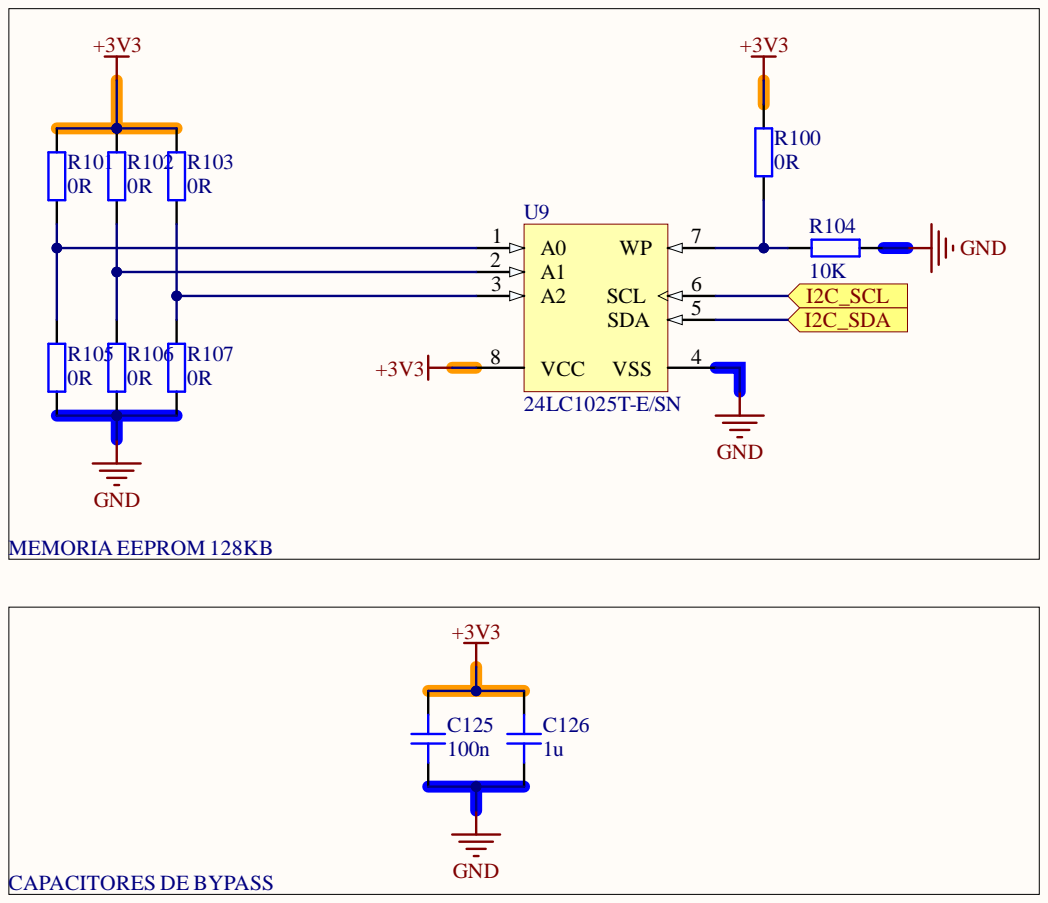
[picture p137: page 17]

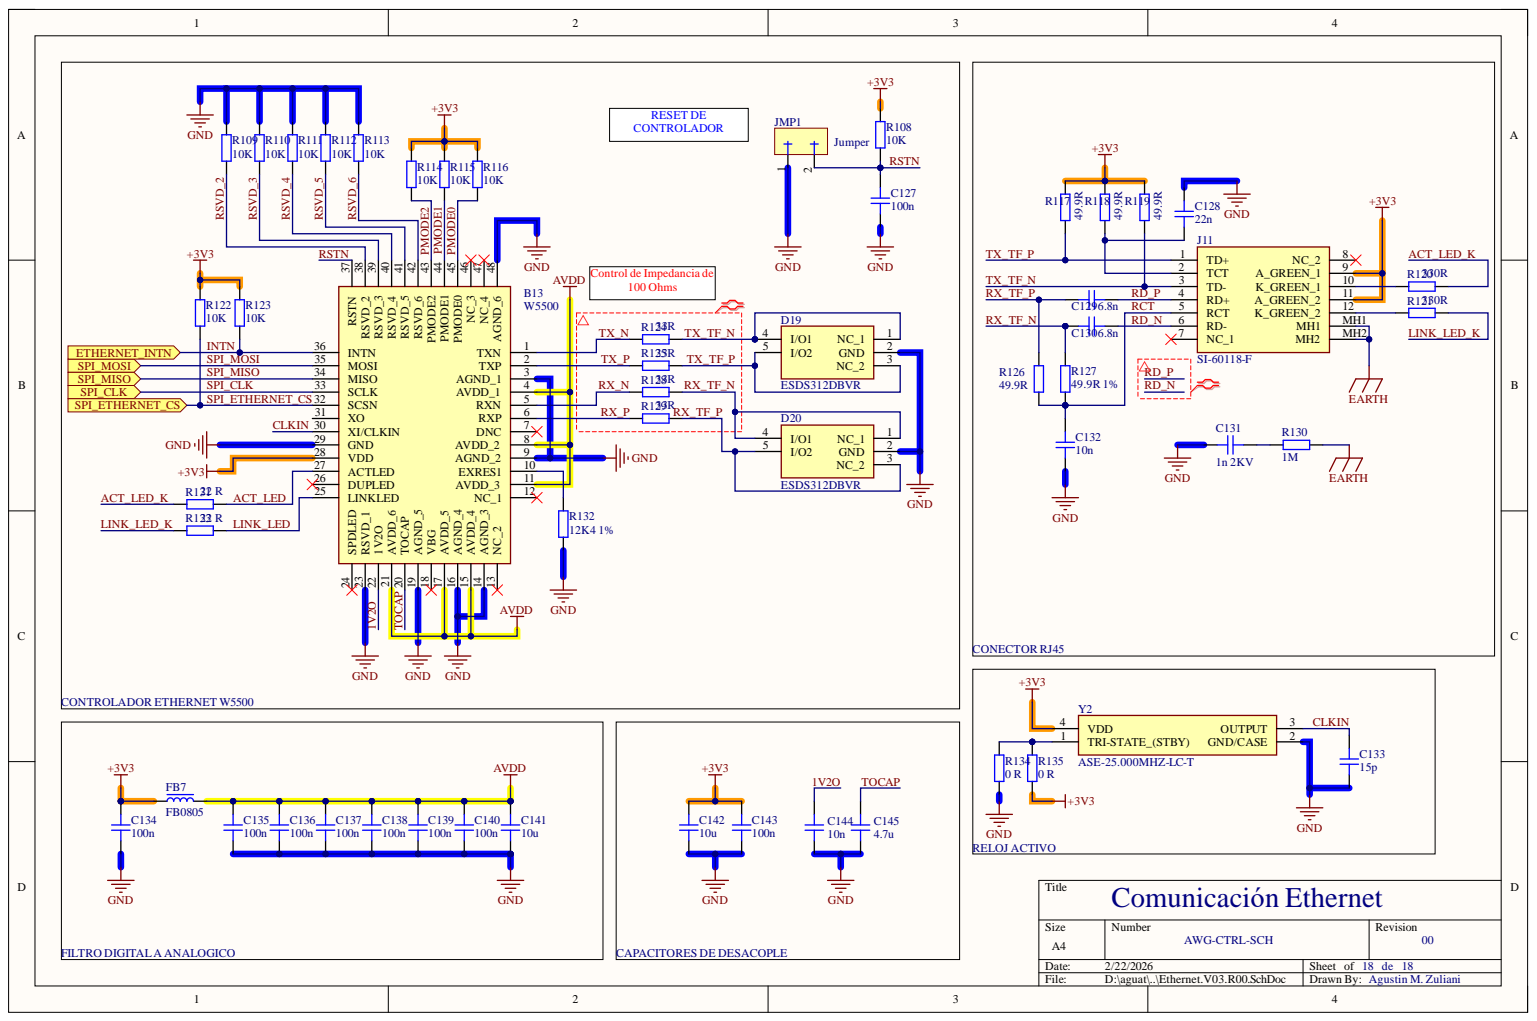
[picture p138: page 18]

Control de Impedancia de

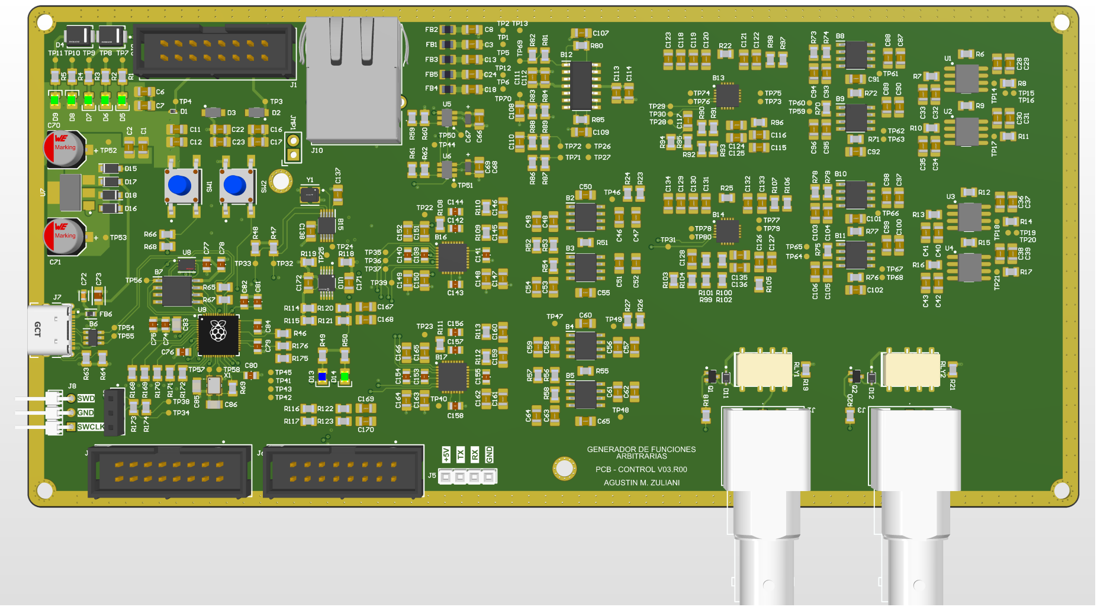
[picture p139: page 19]

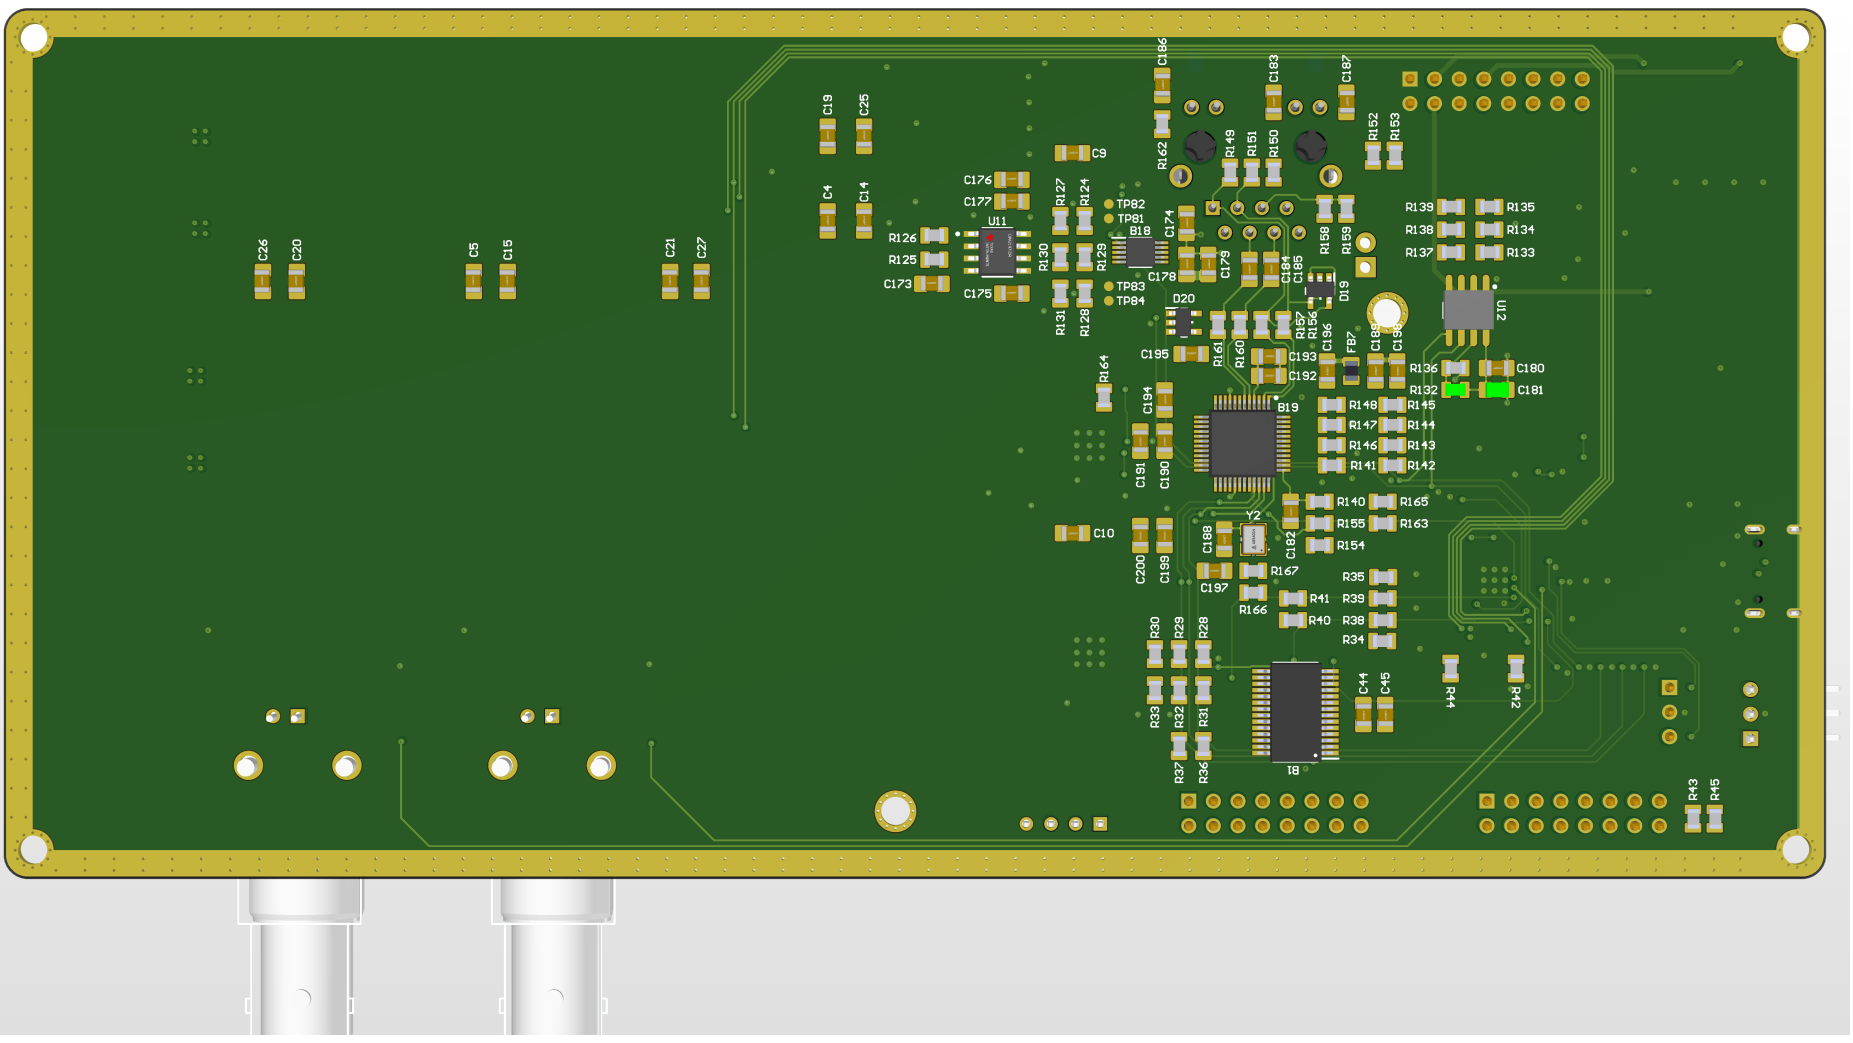
[picture p140: page 20]
