Agustin586/AWG-RP2040/(list of files, drawings)

Other design files:
PCB/Generador de Funciones/2-R2 Dac.SchDoc
PCB/Generador de Funciones/Alimentacion.SchDoc
PCB/Generador de Funciones/Control.SchDoc
PCB/Generador de Funciones/Generador de Funciones.PrjPcb
PCB/Generador de Funciones/main.SchDoc
PCB/Generador de Funciones/PCB_Awg.PcbDoc
PCB/Generador de Funciones/PcbLib1.PcbLib
PCB/Generador de Funciones/Perifericos.SchDoc
PCB/Generador de Funciones/Salida.SchDoc
PCB/Generador de Funciones/Schlib1.SchLib
PCB/PCB_Control/Librerias/AltiumDesigner-Libraries-main/AltiumDesigner-Libraries-main/Schematic-Lib-PhilsLab.SchLib
PCB/PCB_Control/Librerias/LIB_5227161-2_BNC/5227161-2/Altium/5227161-2.SchLib
PCB/PCB_Control/Librerias/LIB_5227161-2_BNC/5227161-2/Altium/52271612.PcbLib
PCB/PCB_Control/Librerias/LIB_5413879-2/5413879-2/Altium/5413879-2.SchLib
PCB/PCB_Control/Librerias/LIB_5413879-2/5413879-2/Altium/54138792.PcbLib
PCB/PCB_Control/Librerias/LIB_ABM8-272-T3/ABM8-272-T3/Altium/ABM8-272-T3.SchLib
PCB/PCB_Control/Librerias/LIB_ABM8-272-T3/ABM8-272-T3/Altium/ABM8272T3.PcbLib
PCB/PCB_Control/Librerias/LIB_AD9102BCPZ/AD9102BCPZ/Altium/AD9102BCPZ.SchLib
PCB/PCB_Control/Librerias/LIB_AD9102BCPZ/AD9102BCPZ/Altium/QFN50P500X500X80-33N-D.PcbLib
PCB/PCB_Control/Librerias/LIB_BLM21PG600SN1D/BLM21PG600SN1D/Altium/BLM21AG102BH1J.PcbLib
PCB/PCB_Control/Librerias/LIB_BLM21PG600SN1D/BLM21PG600SN1D/Altium/BLM21PG600SN1D.SchLib
PCB/PCB_Control/Librerias/LIB_DAC8562SDGSR/DAC8562SDGSR/Altium/DAC8562SDGSR.SchLib
PCB/PCB_Control/Librerias/LIB_DAC8562SDGSR/DAC8562SDGSR/Altium/SOP50P490X110-10N.PcbLib
PCB/PCB_Control/Librerias/LIB_ESD9B3.3ST5G/ESD9B3.3ST5G/Altium/ESD9B3.3ST5G.SchLib
PCB/PCB_Control/Librerias/LIB_ESD9B3.3ST5G/ESD9B3.3ST5G/Altium/SODFL1006X40N.PcbLib
PCB/PCB_Control/Librerias/LIB_ESDS312DBVR/ESDS312DBVR/Altium/ESDS312DBVR.SchLib
PCB/PCB_Control/Librerias/LIB_ESDS312DBVR/ESDS312DBVR/Altium/SOT95P280X145-5N.PcbLib
PCB/PCB_Control/Librerias/LIB_LMH6612MAX_NOPB/LMH6612MAX_NOPB/Altium/LMH6612MAX_NOPB.SchLib
PCB/PCB_Control/Librerias/LIB_LMH6612MAX_NOPB/LMH6612MAX_NOPB/Altium/SOIC127P600X175-8N.PcbLib
PCB/PCB_Control/Librerias/LIB_MCP23S17-E_SS/MCP23S17-E_SS/Altium/MCP23S17-E_SS.SchLib
PCB/PCB_Control/Librerias/LIB_MCP23S17-E_SS/MCP23S17-E_SS/Altium/SOP65P780X200-28N.PcbLib
PCB/PCB_Control/Librerias/LIB_OPA4197ID/OPA4197ID/Altium/OPA4197ID.SchLib
PCB/PCB_Control/Librerias/LIB_OPA4197ID/OPA4197ID/Altium/SOIC127P600X175-14N.PcbLib
PCB/PCB_Control/Librerias/LIB_P6SMBJ5.0CA/P6SMBJ5.0CA/Altium/DIONM5437X240N.PcbLib
PCB/PCB_Control/Librerias/LIB_P6SMBJ5.0CA/P6SMBJ5.0CA/Altium/P6SMBJ5.0CA.SchLib
PCB/PCB_Control/Librerias/LIB_PE4312C-Z/PE4312C-Z/Altium/PE4312C-Z.SchLib
PCB/PCB_Control/Librerias/LIB_PE4312C-Z/PE4312C-Z/Altium/QFN50P400X400X90-21N-D.PcbLib
PCB/PCB_Control/Librerias/LIB_RT6154AGQW/RT6154AGQW/Altium/RT6154AGQW.SchLib
PCB/PCB_Control/Librerias/LIB_RT6154AGQW/RT6154AGQW/Altium/SON50P300X400X80-15N-D.PcbLib
PCB/PCB_Control/Librerias/LIB_SI5351A-B-GTR/SI5351A-B-GTR/Altium/SI5351A-B-GTR.SchLib
PCB/PCB_Control/Librerias/LIB_SI5351A-B-GTR/SI5351A-B-GTR/Altium/SOP50P490X110-10N.PcbLib
PCB/PCB_Control/Librerias/LIB_SI-60118-F/SI-60118-F/Altium/SI60118F.PcbLib
PCB/PCB_Control/Librerias/LIB_SI-60118-F/SI-60118-F/Altium/SI-60118-F.SchLib
PCB/PCB_Control/Librerias/LIB_THS4271D/THS4271D/Altium/SOIC127P600X175-8N.PcbLib
PCB/PCB_Control/Librerias/LIB_THS4271D/THS4271D/Altium/THS4271D.SchLib
PCB/PCB_Control/Librerias/LIB_USBLC6-2SC6/USBLC6-2SC6/Altium/SOT95P280X145-6N.PcbLib
PCB/PCB_Control/Librerias/LIB_USBLC6-2SC6/USBLC6-2SC6/Altium/USBLC6-2SC6.SchLib
PCB/PCB_Control/Librerias/LIB_W25Q128JVSIM_TR/W25Q128JVSIM_TR/Altium/SOIC127P790X216-8N.PcbLib
PCB/PCB_Control/Librerias/LIB_W25Q128JVSIM_TR/W25Q128JVSIM_TR/Altium/W25Q128JVSIM_TR.SchLib
PCB/PCB_Control/Librerias/LIB_W5500/W5500/Altium/QFP50P900X900X160-48N.PcbLib
PCB/PCB_Control/Librerias/LIB_W5500/W5500/Altium/W5500.SchLib
PCB/PCB_Control/Librerias/Schottky/MBR120VLSFT1G/Altium/MBR120VLSFT1G.SchLib
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
