Agustin586/AWG-RP2040/Tesis/Extras/Funktionsgenerator-master/Funktionsgenerator-master/Hardware/Netzteilplatine/Netzteilplatine.brd

## EAGLE design Tesis/Extras/Funktionsgenerator-master/Funktionsgenerator-master/Hardware/Netzteilplatine/Netzteilplatine.brd (2026-01-10)

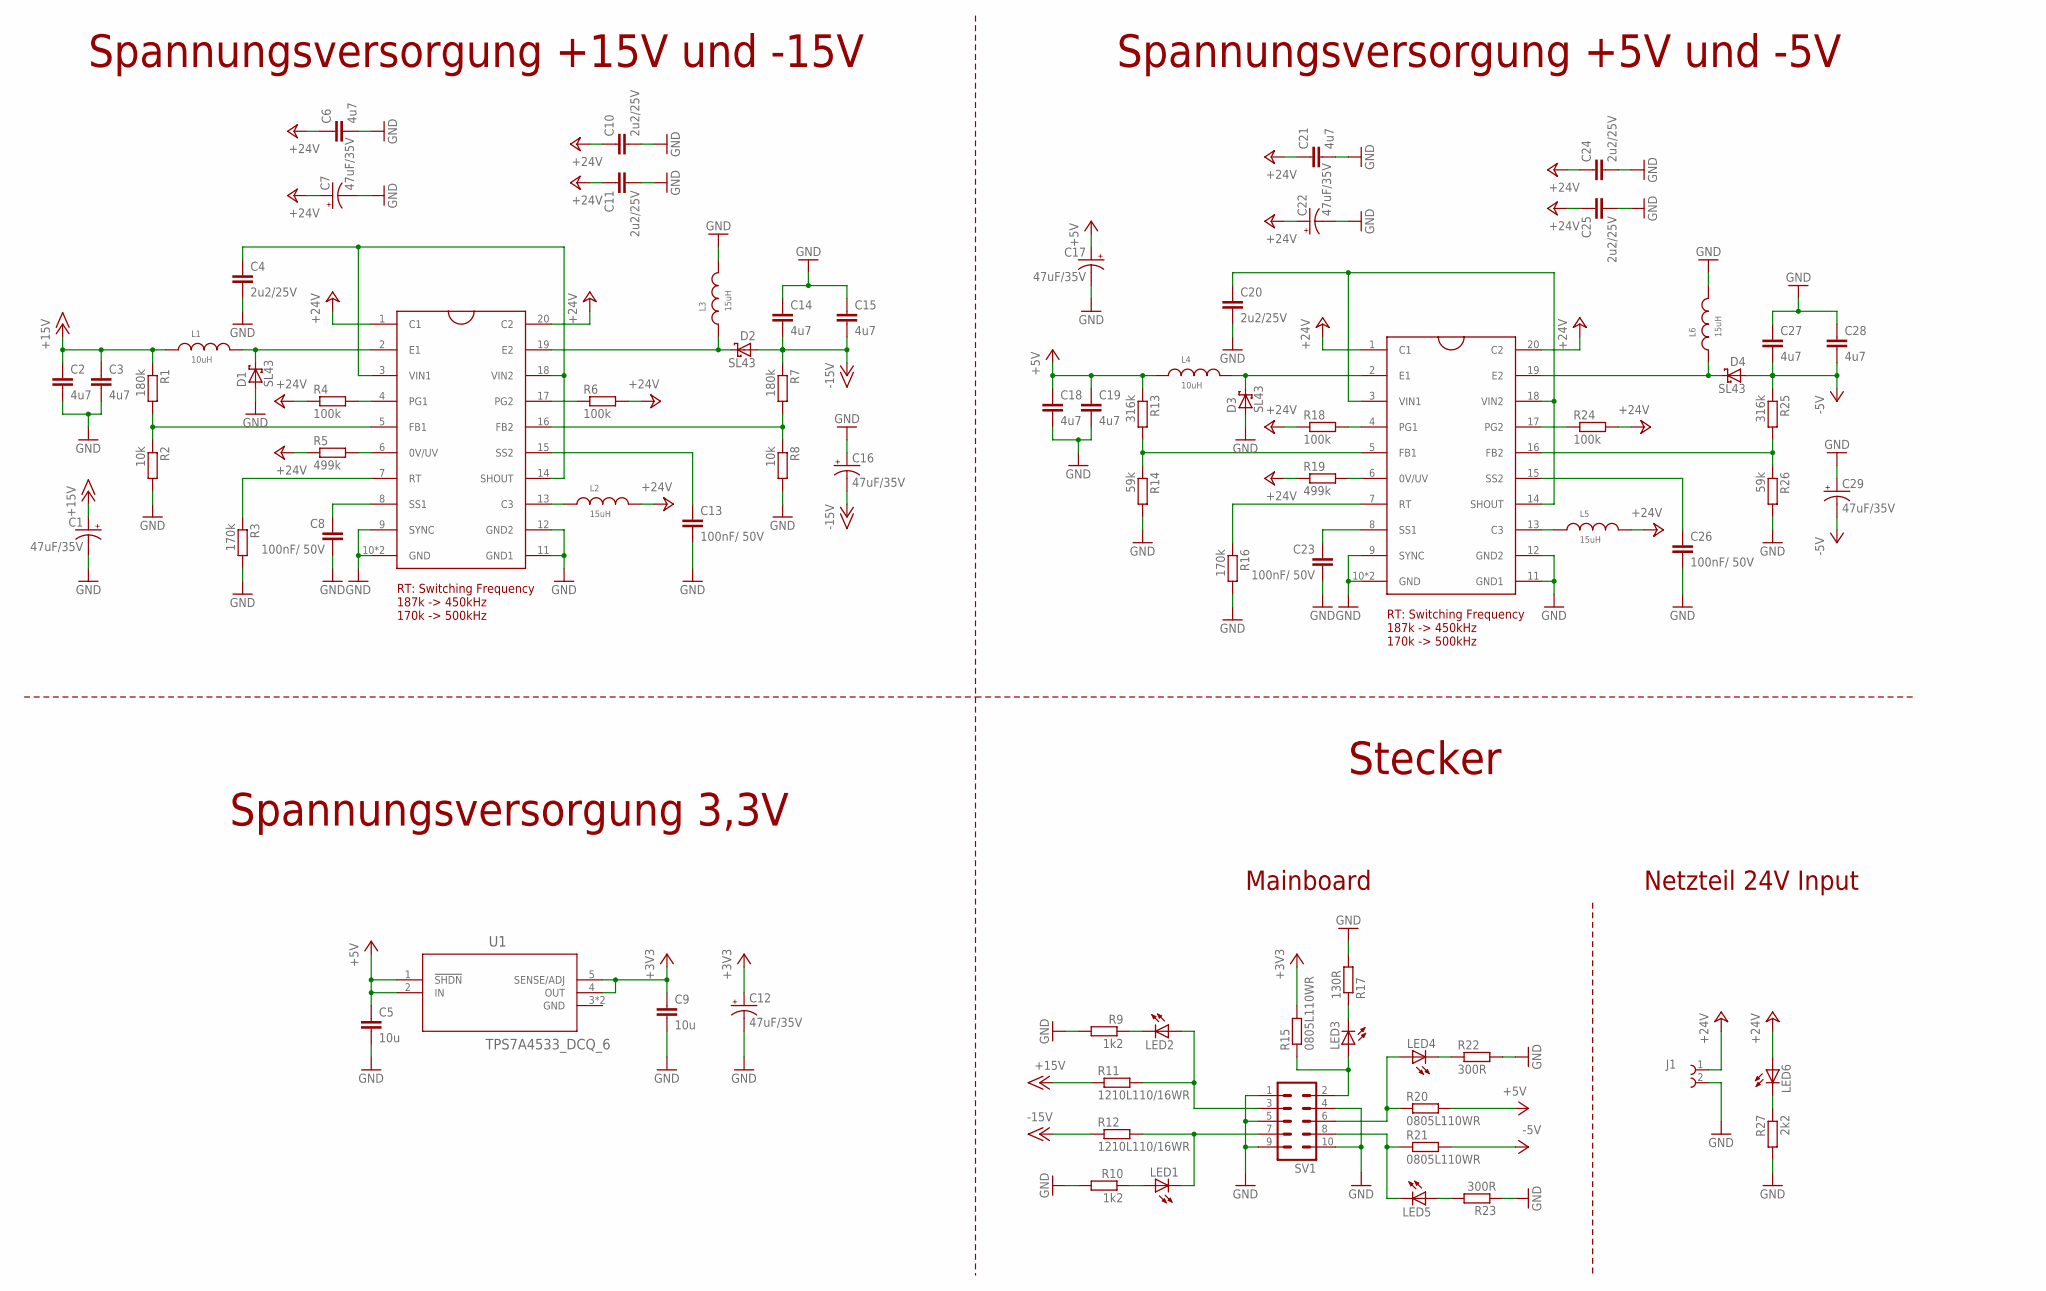
[picture p143: schematic Netzteilplatine.sch]

Parts:
C1, C7, C12, C16, C17, C22, C29: 47uF/35V; PANASONIC_D
C2, C3, C6, C14, C15, C18, C19, C21, C27, C28: 4u7; C1210
C4, C10, C11, C20, C24, C25: 2u2/25V; C1210
C5, C9: 10u; C0805
C8, C13, C23, C26: 100nF/ 50V; C0603
D1, D2, D3, D4: SL43; SMC
J1: 691137810002
L1, L4: 10uH; WE-PD_7332-7345_PLASTIC_BASE
L2, L3, L5, L6: 15uH; WE-PD2SR_7850
LED1, LED2, LED3, LED4, LED5, LED6: LEDCHIPLED_0603; CHIPLED_0603
R1, R7: 180k; R0603
R2, R8: 10k; R0603
R3, R16: 170k; R0603
R4, R6, R18, R24: 100k; R0603
R5, R19: 499k; R0603
R9, R10: 1k2; R0603
R11, R12: 1210L110/16WR; R1206
R13, R25: 316k; R0603
R14, R26: 59k; R0603
R15, R20, R21: 0805L110WR; R0805
R17: 130R; R0603
R22, R23: 300R; R0603
R27: 2k2; R0603
SV1: ML10
U1: TPS7A4533_DCQ_6; DCQ6
U2, U3: LT8471; TSSOP20

Connections:
+3V3: C9.1, C12.+, R15.2, U1.4 (OUT), U1.5 (SENSE/ADJ)
+5V: C5.1, C17.+, C18.1, C19.1, L4.1, R13.1, R20.2, U1.1 (!SHDN), U1.2 (IN)
+15V: C1.+, C2.1, C3.1, L1.1, R1.1, R11.1
+24V: C6.1, C7.+, C10.1, C11.1, C21.1, C22.+, C24.1, C25.1, J1.1, L2.2, L5.2, LED6.A, R4.1, R5.1, R6.2, R18.1, R19.1, R24.2, U2.1 (C1), U2.20 (C2), U3.1 (C1), U3.20 (C2)
-5V: C27.2, C28.2, C29.-, D4.A, R21.2, R25.1
-15V: C14.2, C15.2, C16.-, D2.A, R7.1, R12.1
GND: C1.-, C2.2, C3.2, C4.2, C5.2, C6.2, C7.-, C8.2, C9.2, C10.2, C11.2, C12.-, C13.2, C14.1, C15.1, C16.+, C17.-, C18.2, C19.2, C20.2, C21.2, C22.-, C23.2, C24.2, C25.2, C26.2, C27.1, C28.1, C29.+, D1.A, D3.A, J1.2, L3.2, L6.2, R2.2, R3.2, R8.2, R9.2, R10.2, R14.2, R16.2, R17.2, R22.2, R23.1, R26.2, R27.2, SV1.1, SV1.4, SV1.5, SV1.9, SV1.10, U1.3 (GND), U1.P$1 (GND), U2.9 (SYNC), U2.10 (GND), U2.11 (GND1), U2.12 (GND2), U2.P$1 (GND), U3.9 (SYNC), U3.10 (GND), U3.11 (GND1), U3.12 (GND2), U3.P$1 (GND)
unnamed: C4.1, U2.3 (VIN1), U2.14 (SHOUT), U2.18 (VIN2)
unnamed: R7.2, R8.1, U2.16 (FB2)
unnamed: R1.2, R2.1, U2.5 (FB1)
unnamed: R5.2, U2.6 (0V/UV)
unnamed: C20.1, U3.3 (VIN1), U3.14 (SHOUT), U3.18 (VIN2)
unnamed: C8.1, U2.8 (SS1)
unnamed: R19.2, U3.6 (0V/UV)
unnamed: C13.1, U2.15 (SS2)
unnamed: C23.1, U3.8 (SS1)
unnamed: C26.1, U3.15 (SS2)
unnamed: R25.2, R26.1, U3.16 (FB2)
unnamed: R13.2, R14.1, U3.5 (FB1)
unnamed: R3.1, U2.7 (RT)
unnamed: R16.1, U3.7 (RT)
unnamed: D1.C, L1.2, U2.2 (E1)
unnamed: D2.C, L3.1, U2.19 (E2)
unnamed: L2.1, U2.13 (C3)
unnamed: D3.C, L4.2, U3.2 (E1)
unnamed: R6.1, U2.17 (PG2)
unnamed: R4.2, U2.4 (PG1)
unnamed: D4.C, L6.1, U3.19 (E2)
unnamed: L5.1, U3.13 (C3)
unnamed: R24.1, U3.17 (PG2)
unnamed: R18.2, U3.4 (PG1)
unnamed: LED3.A, R15.1, SV1.2
unnamed: LED4.A, R20.1, SV1.6
unnamed: LED4.C, R22.1
unnamed: LED1.C, R12.2, SV1.7
unnamed: LED5.C, R21.1, SV1.8
unnamed: LED5.A, R23.2
unnamed: LED2.A, R11.2, SV1.3
unnamed: LED3.C, R17.1
unnamed: LED2.C, R9.1
unnamed: LED1.A, R10.1
unnamed: LED6.C, R27.1

Notes on the sheet:
Spannungsversorgung +15V und -15V
Spannungsversorgung 3,3V
RT: Switching Frequency 187k -> 450kHz 170k -> 500kHz
Spannungsversorgung +5V und -5V
Stecker
Mainboard
Netzteil 24V Input

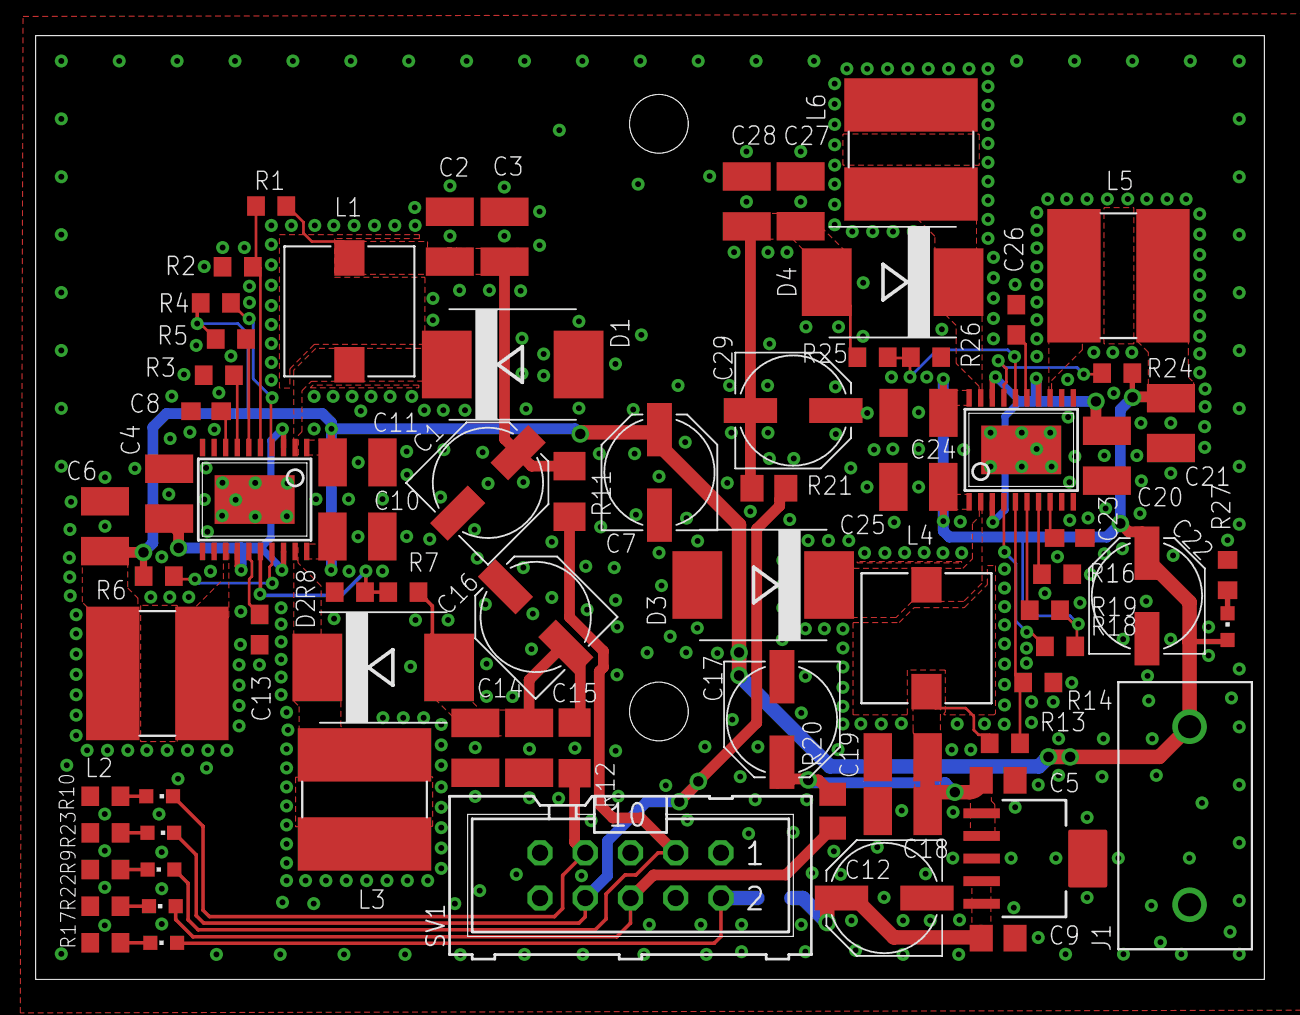
[picture p144: board Netzteilplatine.brd from above]

Board: 2 copper layers, 69.0 x 53.0 mm, 77 parts (1 on the bottom side), 42 nets.
