Agustin586/AWG-RP2040/Tesis/Extras/Funktionsgenerator-master/Funktionsgenerator-master/Hardware/Frontpanel/Frontpanel.brd

## EAGLE design Tesis/Extras/Funktionsgenerator-master/Funktionsgenerator-master/Hardware/Frontpanel/Frontpanel.brd (2026-01-10)

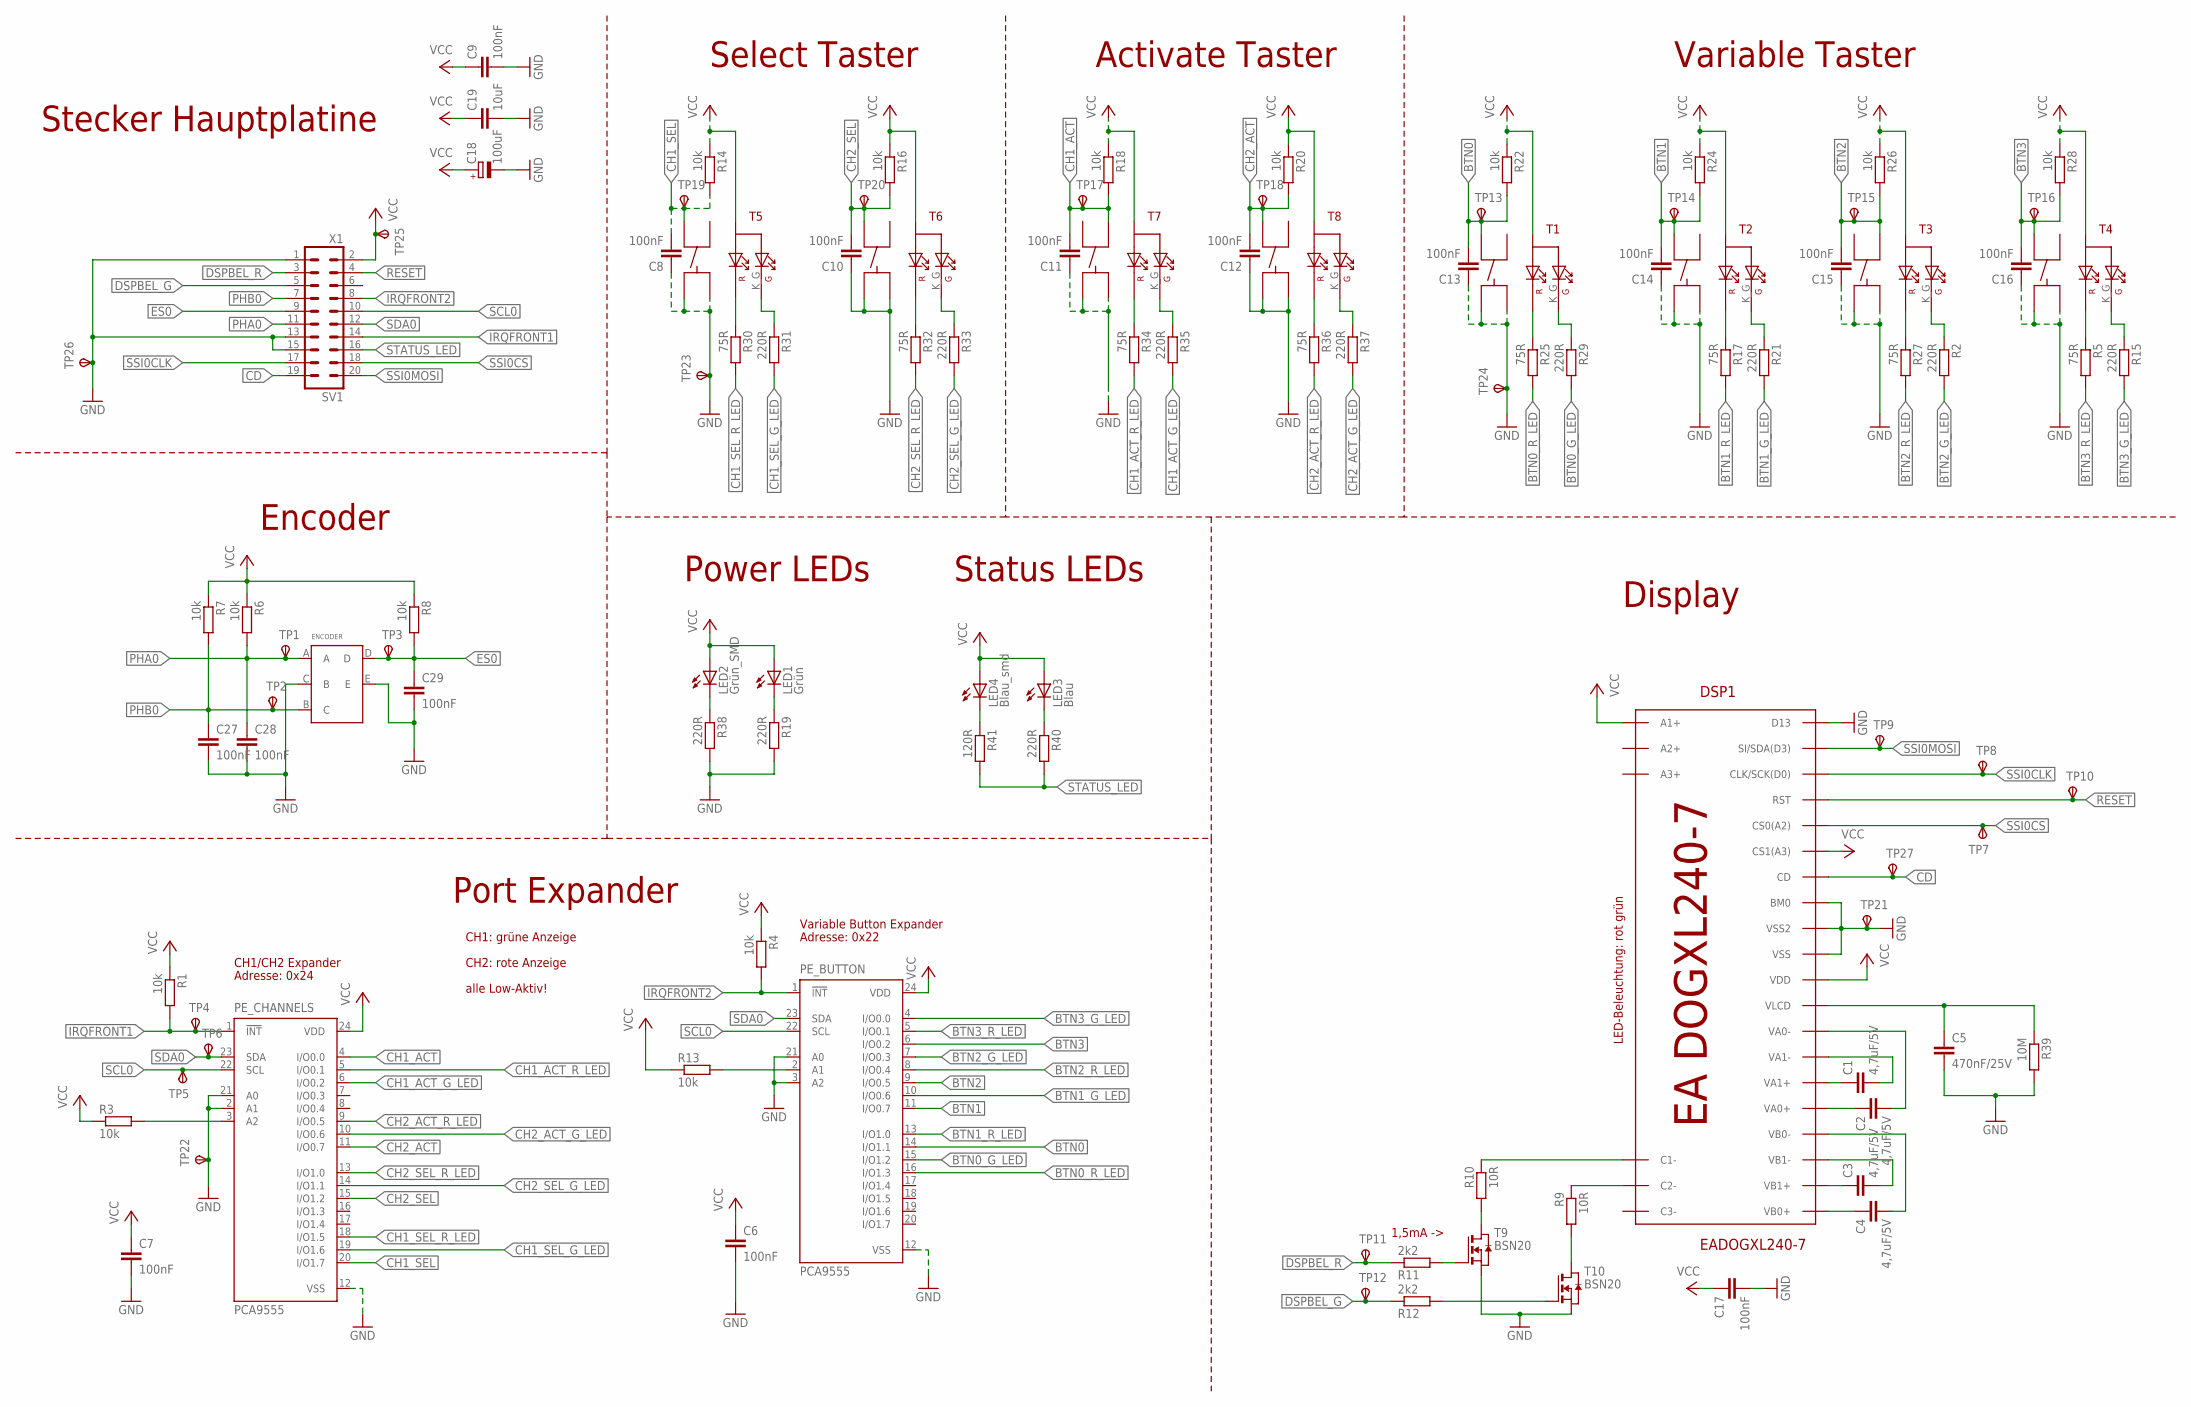
[picture p145: schematic Frontpanel.sch]

Parts:
C1, C2, C3, C4: 4,7uF/5V; C0805
C5: 470nF/25V; C0603
C6, C7, C8, C9, C10, C11, C12, C13, C14, C15, C16, C17, C27, C28, C29: 100nF; C0603
C18: 100uF; CT7343
C19: 10uF; C0805
DSP1: EADOGXL240-7
ENCODER: ENCODER
LED1: Grün; LED5MM
LED2: Grün_SMD; CHIP-LED0603
LED3: Blau; LED5MM
LED4: Blau_smd; CHIP-LED0603
PE_BUTTON: PCA9555; SSOP24_DBQ
PE_CHANNELS: PCA9555; SSOP24_DBQ
R1, R3, R4, R6, R7, R8, R13, R14, R16, R18, R20, R22, R24, R26, R28: 10k; R0603
R2, R15, R19, R21, R29, R31, R33, R35, R37, R38, R40: 220R; R0603
R5, R17, R25, R27, R30, R32, R34, R36: 75R; R0603
R9, R10: 10R; M1206
R11, R12: 2k2; R0603
R39: 10M; R0603
R41: 120R; R0603
SV1: X1; ML20
T1, T2, T3, T4, T5, T6, T7, T8: TASTER_2FSH9_E_BEL; TASTER_3FSH9_SMD_E
T9, T10: BSN20; SOT-23
TP1, TP2, TP3, TP4, TP5, TP6, TP7, TP8, TP9, TP10, TP11, TP12, TP13, TP14, TP15, TP16, TP17, TP18, TP19, TP20, TP21, TP22, TP23, TP24, TP25, TP26, TP27: TPSB1,27; B1,27

Connections:
BTN0: C13.2, PE_BUTTON.14 (I/O1.1), R22.2, T1.13, TP13.TP
BTN0_G_LED: PE_BUTTON.15 (I/O1.2), R29.2
BTN0_R_LED: PE_BUTTON.16 (I/O1.3), R25.2
BTN1: C14.2, PE_BUTTON.11 (I/O0.7), R24.2, T2.13, TP14.TP
BTN1_G_LED: PE_BUTTON.10 (I/O0.6), R21.2
BTN1_R_LED: PE_BUTTON.13 (I/O1.0), R17.2
BTN2: C15.2, PE_BUTTON.9 (I/O0.5), R26.2, T3.23, TP15.TP
BTN2_G_LED: PE_BUTTON.7 (I/O0.3), R2.2
BTN2_R_LED: PE_BUTTON.8 (I/O0.4), R27.2
BTN3: C16.2, PE_BUTTON.6 (I/O0.2), R28.2, T4.13, TP16.TP
BTN3_G_LED: PE_BUTTON.4 (I/O0.0), R15.2
BTN3_R_LED: PE_BUTTON.5 (I/O0.1), R5.2
CD: DSP1.CD, SV1.19, TP27.TP
CH1_ACT: C11.2, PE_CHANNELS.4 (I/O0.0), R18.2, T7.23, TP17.TP
CH1_ACT_G_LED: PE_CHANNELS.6 (I/O0.2), R35.2
CH1_ACT_R_LED: PE_CHANNELS.5 (I/O0.1), R34.2
CH1_SEL: C8.2, PE_CHANNELS.20 (I/O1.7), R14.2, T5.13, TP19.TP
CH1_SEL_G_LED: PE_CHANNELS.19 (I/O1.6), R31.2
CH1_SEL_R_LED: PE_CHANNELS.18 (I/O1.5), R30.2
CH2_ACT: C12.2, PE_CHANNELS.11 (I/O0.7), R20.2, T8.13, TP18.TP
CH2_ACT_G_LED: PE_CHANNELS.10 (I/O0.6), R37.2
CH2_ACT_R_LED: PE_CHANNELS.9 (I/O0.5), R36.2
CH2_SEL: C10.2, PE_CHANNELS.15 (I/O1.2), R16.2, T6.13, TP20.TP
CH2_SEL_G_LED: PE_CHANNELS.14 (I/O1.1), R33.2
CH2_SEL_R_LED: PE_CHANNELS.13 (I/O1.0), R32.2
DSPBEL_G: R12.1, SV1.5, TP12.TP
DSPBEL_R: R11.1, SV1.3, TP11.TP
ES0: C29.1, ENCODER.D, R8.2, SV1.9, TP3.TP
GND: C5.2, C6.2, C7.2, C8.1, C9.2, C10.1, C11.1, C12.1, C13.1, C14.1, C15.1, C16.1, C17.2, C18.-, C19.2, C27.2, C28.2, C29.2, DSP1.BM0, DSP1.D13, DSP1.VSS1 (VSS), DSP1.VSS2, ENCODER.C (B), ENCODER.E, PE_BUTTON.3 (A2), PE_BUTTON.12 (VSS), PE_BUTTON.21 (A0), PE_CHANNELS.2 (A1), PE_CHANNELS.12 (VSS), PE_CHANNELS.21 (A0), R19.2, R38.2, R39.2, SV1.1, SV1.13, SV1.15, T1.14, T1.24, T2.14, T2.24, T3.14, T3.24, T4.14, T4.24, T5.14, T5.24, T6.14, T6.24, T7.14, T7.24, T8.14, T8.24, T9.2 (S), T10.2 (S), TP21.TP, TP22.TP, TP23.TP, TP24.TP, TP26.TP
IRQFRONT1: PE_CHANNELS.1 (!INT), R1.2, SV1.14, TP4.TP
IRQFRONT2: PE_BUTTON.1 (!INT), R4.2, SV1.8
unnamed: PE_CHANNELS.3 (A2), R3.2
unnamed: R27.1, T3.K_R (KR)
unnamed: DSP1.C1-, R10.1
unnamed: PE_BUTTON.2 (A1), R13.2
unnamed: R11.2, T9.3 (G)
unnamed: DSP1.C2-, R9.1
unnamed: R12.2, T10.3 (G)
unnamed: R29.1, T1.K_G (KG)
unnamed: R25.1, T1.K_R (KR)
unnamed: R17.1, T2.K_R (KR)
unnamed: C1.1, DSP1.VA1+
unnamed: C2.1, DSP1.VA0+
unnamed: C3.1, DSP1.VB1+
unnamed: C4.1, DSP1.VB0+
unnamed: C3.2, DSP1.VB1-
unnamed: C4.2, DSP1.VB0-
unnamed: R9.2, T10.1 (D)
unnamed: R10.2, T9.1 (D)
unnamed: R21.1, T2.K_G (KG)
unnamed: R36.1, T8.K_R (KR)
unnamed: R2.1, T3.K_G (KG)
unnamed: R5.1, T4.K_R (KR)
unnamed: R15.1, T4.K_G (KG)
unnamed: R37.1, T8.K_G (KG)
unnamed: R34.1, T7.K_R (KR)
unnamed: R35.1, T7.K_G (KG)
unnamed: R32.1, T6.K_R (KR)
unnamed: R33.1, T6.K_G (KG)
unnamed: R30.1, T5.K_R (KR)
unnamed: R31.1, T5.K_G (KG)
unnamed: C1.2, DSP1.VA1-
unnamed: LED1.K (C), R19.1
unnamed: LED2.C, R38.1
unnamed: C2.2, DSP1.VA0-
unnamed: LED3.K (C), R40.1
unnamed: C5.1, DSP1.VLCD, R39.1
unnamed: LED4.C, R41.1
PHA0: C28.1, ENCODER.A, R6.2, SV1.11, TP1.TP
PHB0: C27.1, ENCODER.B (C), R7.2, SV1.7, TP2.TP
RESET: DSP1.RST, SV1.4, TP10.TP
SCL0: PE_BUTTON.22 (SCL), PE_CHANNELS.22 (SCL), SV1.10, TP5.TP
SDA0: PE_BUTTON.23 (SDA), PE_CHANNELS.23 (SDA), SV1.12, TP6.TP
SSI0CLK: DSP1.SCK(D0) (CLK/SCK(D0)), SV1.17, TP8.TP
SSI0CS: DSP1.CS0(A2), SV1.18, TP7.TP
SSI0MOSI: DSP1.SDA(D3) (SI/SDA(D3)), SV1.20, TP9.TP
STATUS_LED: R40.2, R41.2, SV1.16
VCC: C6.1, C7.1, C9.1, C17.1, C18.+, C19.1, DSP1.A1+, DSP1.CS1(A3), DSP1.VDD, LED1.A, LED2.A, LED3.A, LED4.A, PE_BUTTON.24 (VDD), PE_CHANNELS.24 (VDD), R1.1, R3.1, R4.1, R6.1, R7.1, R8.1, R13.1, R14.1, R16.1, R18.1, R20.1, R22.1, R24.1, R26.1, R28.1, SV1.2, T1.A, T2.A, T3.A, T4.A, T5.A, T6.A, T7.A, T8.A, TP25.TP

Notes on the sheet:
Stecker Hauptplatine
Adresse: 0x24
Encoder
Port Expander
Adresse: 0x22
CH1: grüne Anzeige
CH2: rote Anzeige
Variable Button Expander
CH1/CH2 Expander
alle Low-Aktiv!
Select Taster
Activate Taster
Variable Taster
Power LEDs
LED-Beleuchtung: rot grün
1,5mA ->
Status LEDs
Display

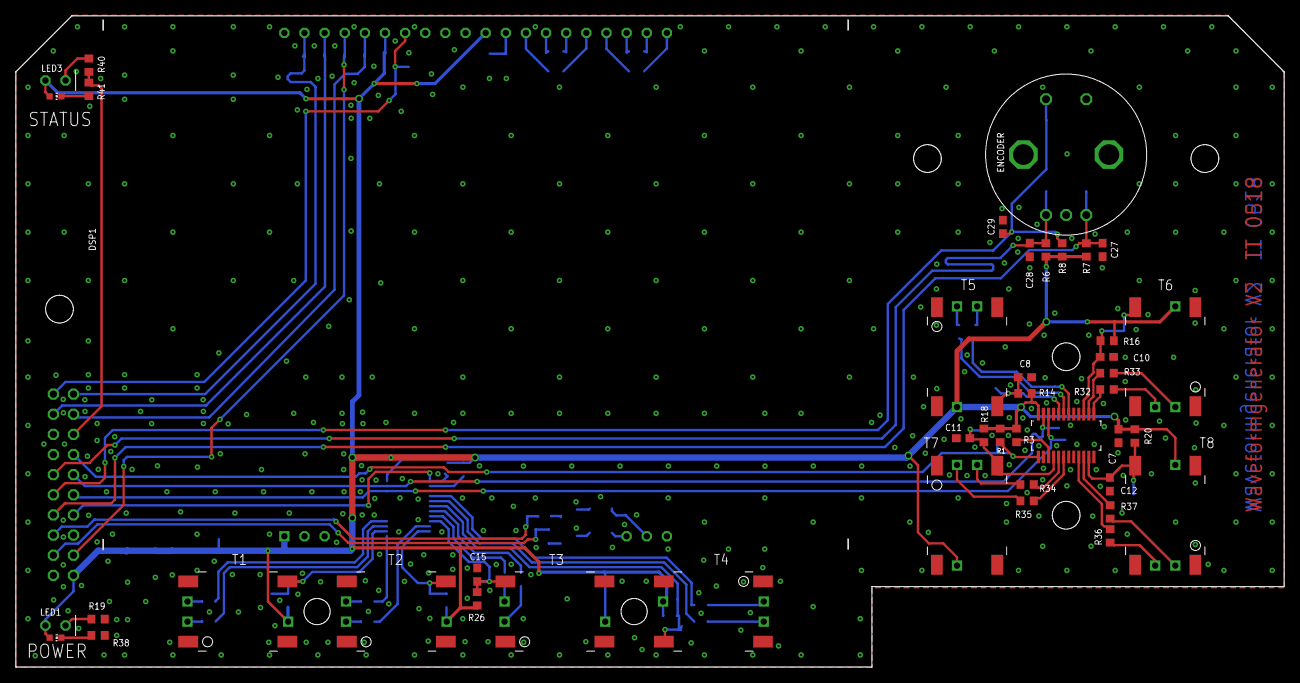
[picture p146: board Frontpanel.brd from above]

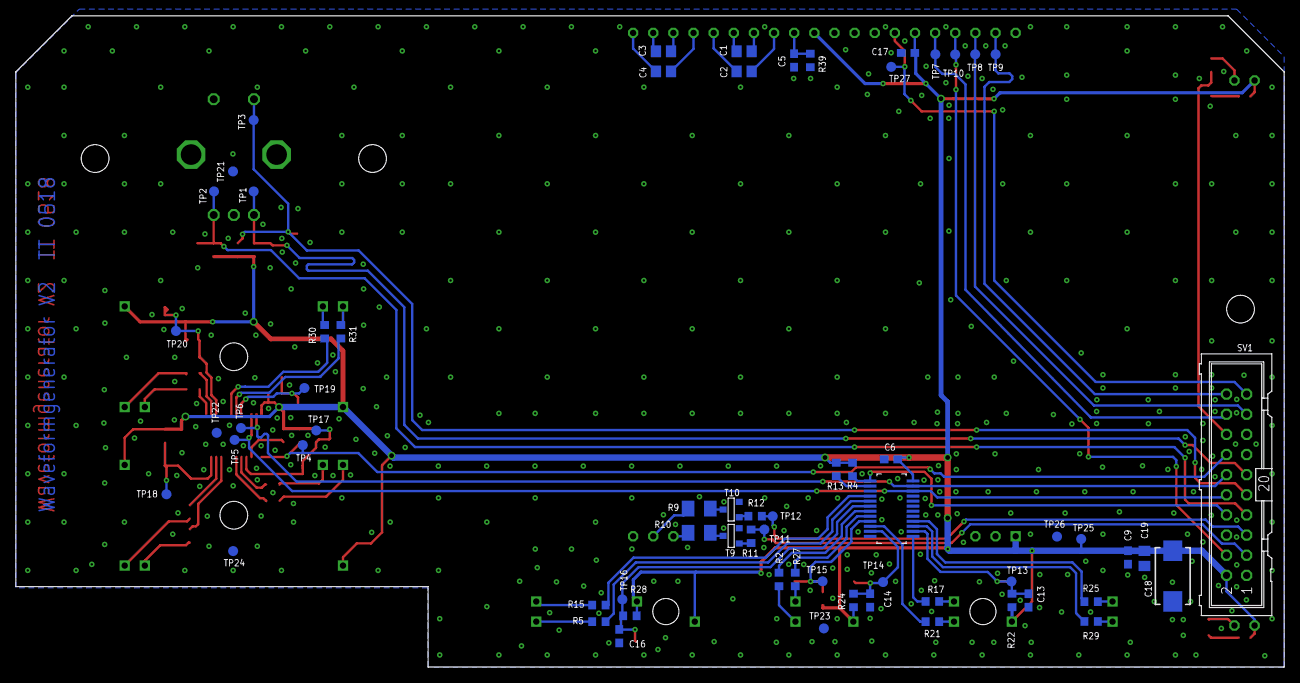
[picture p147: board Frontpanel.brd from below]

Board: 2 copper layers, 160.0 x 82.2 mm, 108 parts (64 on the bottom side), 78 nets.
