Agustin586/AWG-RP2040/Tesis/Extras/Funktionsgenerator-master/Funktionsgenerator-master/Hardware/Hauptplatine/Hauptplatine.brd

## EAGLE design Tesis/Extras/Funktionsgenerator-master/Funktionsgenerator-master/Hardware/Hauptplatine/Hauptplatine.brd (2026-01-10)

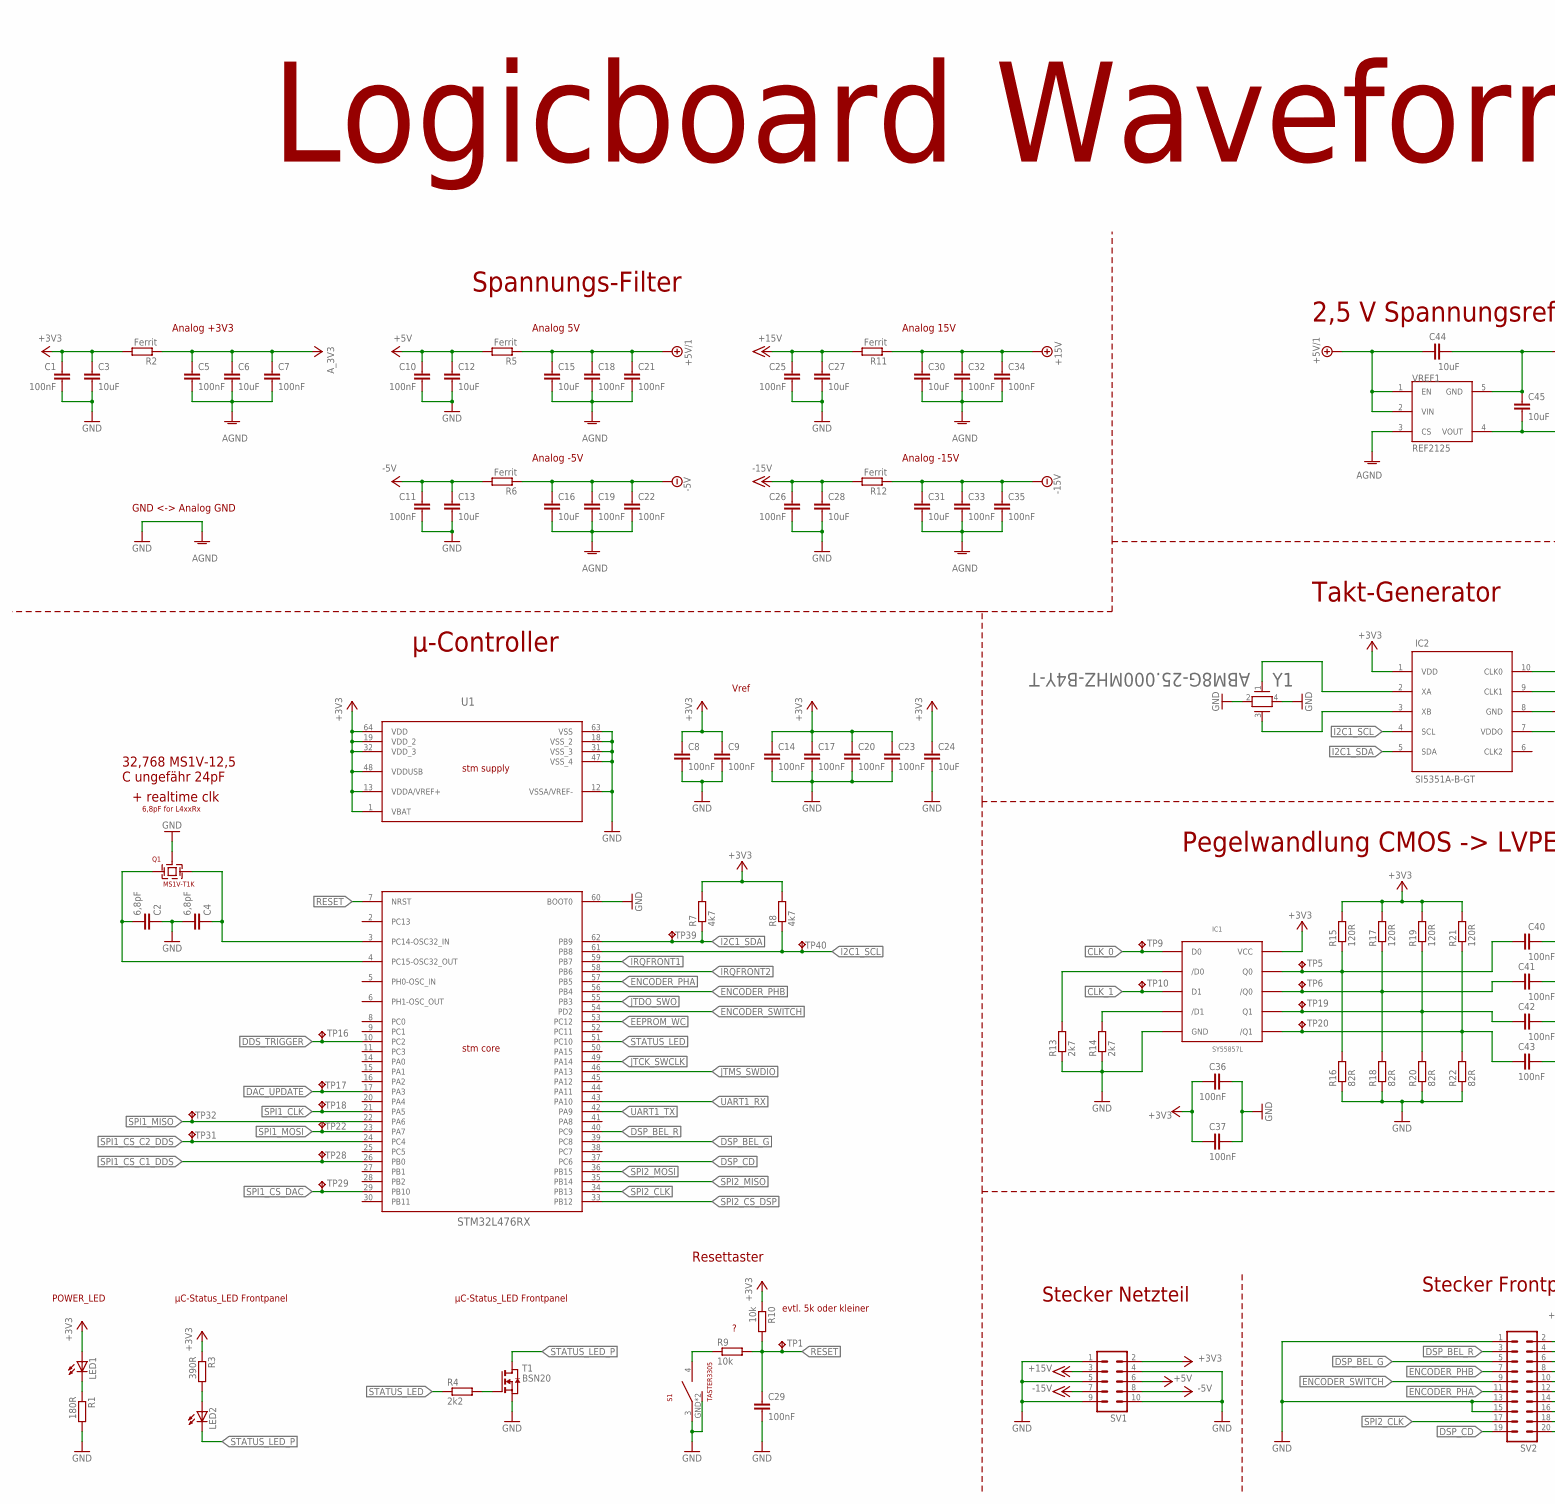
[picture p148: schematic Hauptplatine.sch, sheet 1, part in row 1, column 1]

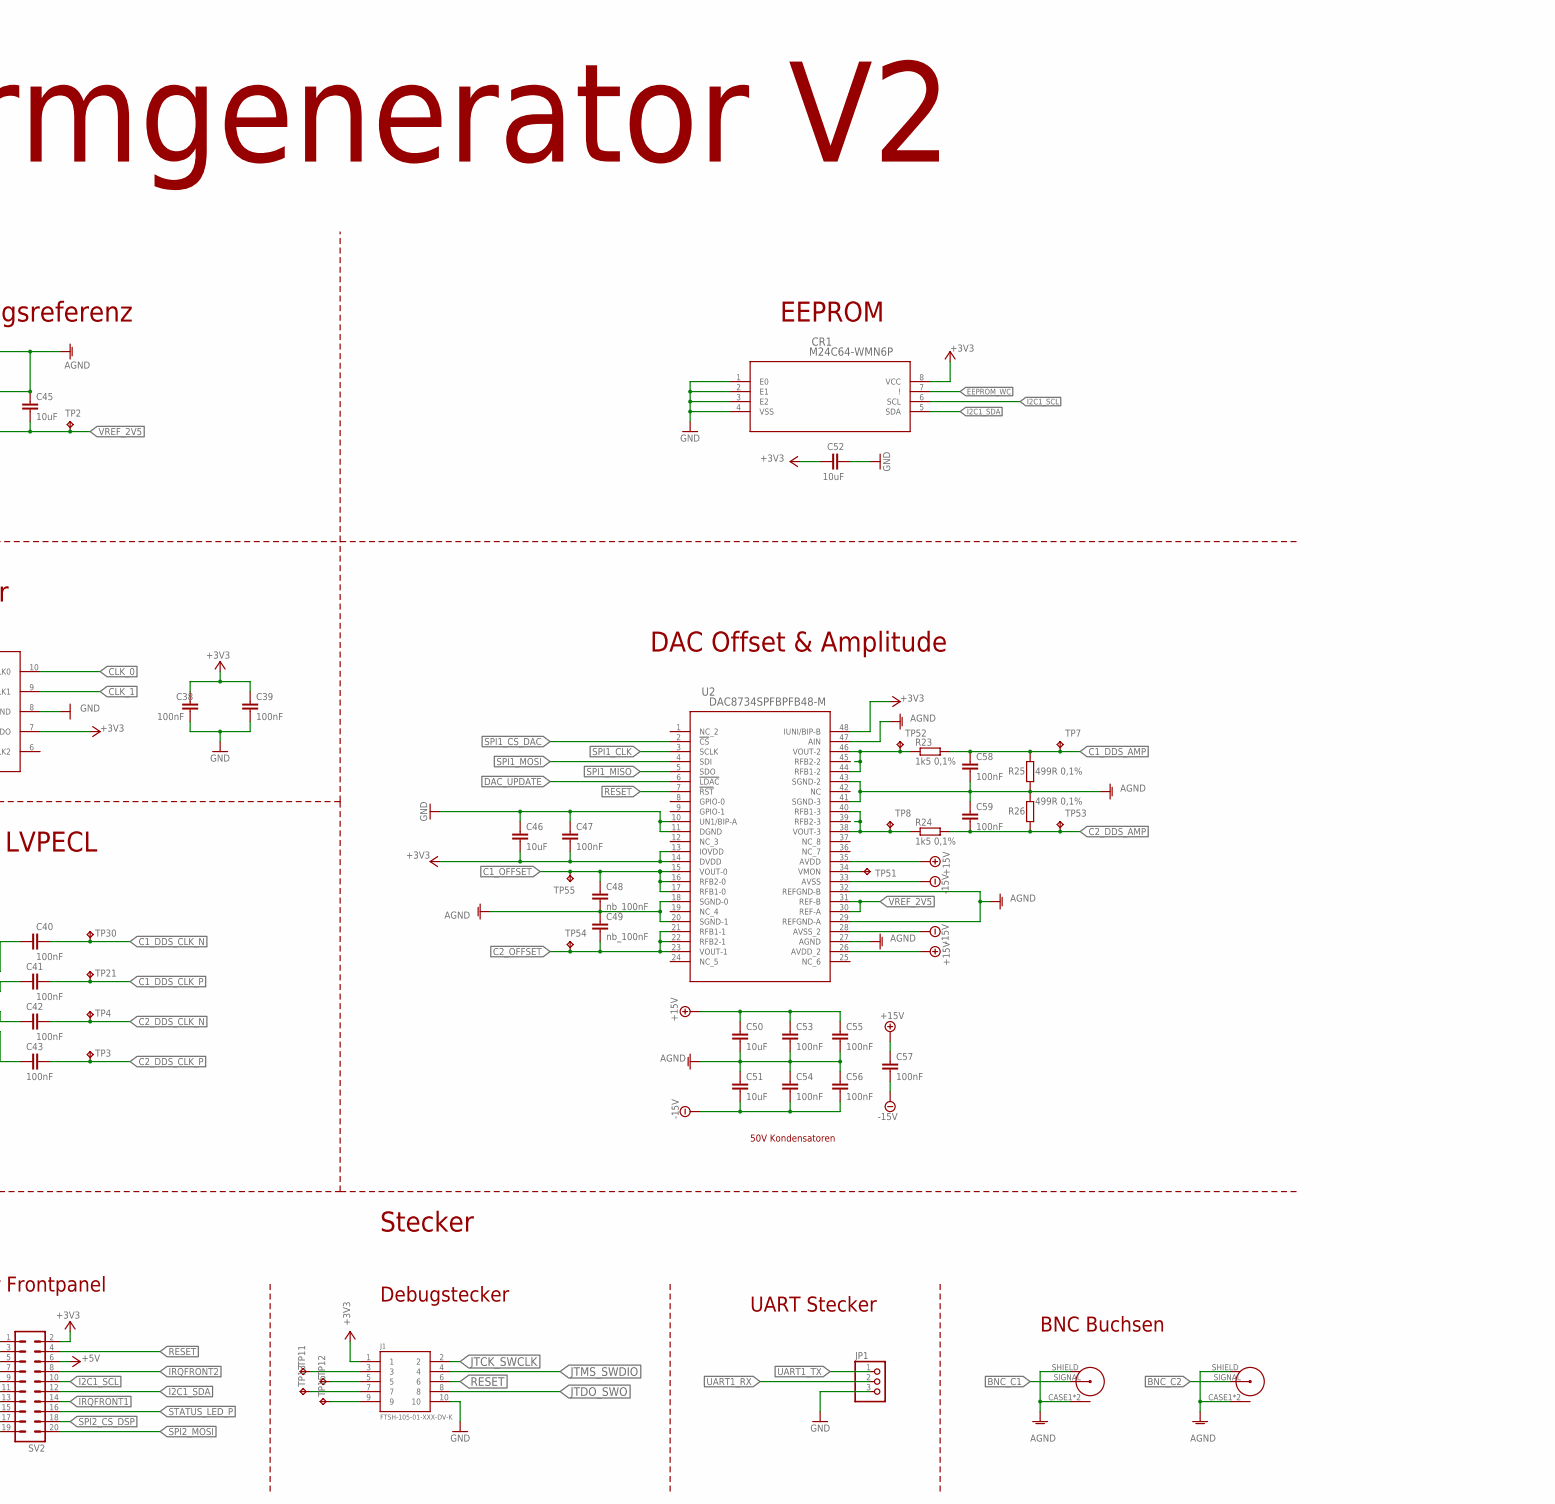
[picture p149: schematic Hauptplatine.sch, sheet 1, part in row 1, column 2]

Parts:
C1, C5, C7, C8, C9, C10, C11, C14, C17, C18, C19, C20, C21, C22, C23, C25, C26, C29, C32, C33, C34, C35, C36, C37, C38, C39, C40, C41, C42, C43, C47, C53, C54, C55, C56, C57, C58, C59: 100nF; C0603
C2, C4: 6,8pF; C0603
C3, C6, C12, C13, C15, C16, C24, C27, C28, C30, C31, C44, C45, C46, C50, C51, C52: 10uF; C0603
C48, C49: nb_100nF; C0603
CR1: M24C64-WMN6P; SO-8
IC1: SY55857L; MSOP(K10-1)
IC2: SI5351A-B-GT; MSOP10
J1: FTSH-105-01-XXX-DV-K
JP1: PINHD-1X3; 1X03
LED1, LED2: LEDCHIPLED_0603; CHIPLED_0603
Q1: MS1V-T1K
R1: 180R; R0603
R2, R5, R6, R11, R12: Ferrit; R0603
R3: 390R; R0603
R4: 2k2; R0603
R7, R8: 4k7; R0603
R9, R10: 10k; R0603
R13, R14: 2k7; R0603
R15, R17, R19, R21: 120R; R0603
R16, R18, R20, R22: 82R; R0603
R23, R24: 1k5 0,1%; R0603
R25, R26: 499R 0,1%; R0603
S1: TASTER3305
SV1: ML10
SV2: ML20
T1: BSN20; SOT-23
TP1, TP2, TP3, TP4, TP5, TP6, TP7, TP8, TP9, TP10, TP11, TP12, TP13, TP15, TP16, TP17, TP18, TP19, TP20, TP21, TP22, TP28, TP29, TP30, TP31, TP32, TP39, TP40, TP51, TP52, TP53, TP54, TP55: TPB1,27; B1,27
U1: STM32L476RX; LQFP64-10X10MM
U2: DAC8734SPFBPFB48-M; PFB48-M
VREF1: REF2125; SOT23-5L
X1, X2: 740845_BNC
Y1: ABM8G-25.000MHZ-B4Y-T; CRYSTAL_ABM8G

Connections:
+3V3: C1.1, C3.1, C8.1, C9.1, C14.1, C17.1, C20.1, C23.1, C24.1, C36.1, C37.1, C38.1, C39.1, C46.2, C47.2, C52.1, CR1.8 (VCC), IC1.VCC, IC2.1 (VDD), IC2.7 (VDDO), J1.1, LED1.A, R2.2, R3.1, R7.2, R8.2, R10.1, R15.2, R17.2, R19.2, R21.2, SV1.2, SV2.2, U1.1 (VBAT), U1.13 (VDDA/VREF+), U1.19 (VDD_2), U1.32 (VDD_3), U1.48 (VDDUSB), U1.64 (VDD), U2.13 (IOVDD), U2.14 (DVDD), U2.48 (IUNI/BIP-B); also elsewhere on the board
+5V: C10.1, C12.1, R5.2, SV1.6, SV2.6
+5V/1: C15.1, C18.1, C21.1, C44.1, R5.1, VREF1.1 (EN), VREF1.2 (VIN); also elsewhere on the board
+15V: C25.1, C27.1, R11.2, SV1.3
+18V: C30.1, C32.1, C34.1, C50.1, C53.1, C55.1, C57.1, R11.1, U2.26 (AVDD_2), U2.35 (AVDD); also elsewhere on the board
-5V: C16.1, C19.1, C22.1, R6.1; also elsewhere on the board
-5V/D: C11.1, C13.1, R6.2, SV1.8
-15V: C26.1, C28.1, R12.2, SV1.7
-18V: C31.1, C33.1, C35.1, C51.2, C54.2, C56.2, C57.2, R12.1, U2.28 (AVSS_2), U2.33 (AVSS); also elsewhere on the board
ANALOG_3V3: C5.1, C6.1, C7.1, R2.1; also elsewhere on the board
BNC_C1: X1.SIGNAL; also elsewhere on the board
BNC_C2: X2.SIGNAL; also elsewhere on the board
C1_DDS_AMP: C58.1, R23.2, R25.2, TP7.TP; also elsewhere on the board
C1_DDS_CLK_N: C40.1, TP30.TP; also elsewhere on the board
C1_DDS_CLK_P: C41.1, TP21.TP; also elsewhere on the board
C1_OFFSET: C48.1, TP55.TP, U2.15 (VOUT-0), U2.16 (RFB2-0), U2.17 (RFB1-0); also elsewhere on the board
C2_DDS_AMP: C59.2, R24.2, R26.1, TP53.TP; also elsewhere on the board
C2_DDS_CLK_N: C42.1, TP4.TP; also elsewhere on the board
C2_DDS_CLK_P: C43.1, TP3.TP; also elsewhere on the board
C2_OFFSET: C49.2, TP54.TP, U2.21 (RFB1-1), U2.22 (RFB2-1), U2.23 (VOUT-1); also elsewhere on the board
CLK_0: IC1.D0, IC2.10 (CLK0), TP9.TP
CLK_1: IC1.D1, IC2.9 (CLK1), TP10.TP
DAC_UPDATE: TP17.TP, U1.17 (PA3), U2.6 (!LDAC)
DDS_TRIGGER: TP16.TP, U1.10 (PC2); also elsewhere on the board
DSP_BEL_G: SV2.5, U1.39 (PC8)
DSP_BEL_R: SV2.3, U1.40 (PC9)
DSP_CD: SV2.19, U1.37 (PC6)
EEPROM_WC: CR1.7 (!), U1.53 (PC12)
ENCODER_PHA: SV2.11, U1.57 (PB5)
ENCODER_PHB: SV2.7, U1.56 (PB4)
ENCODER_SWITCH: SV2.9, U1.54 (PD2)
GND: C1.2, C2.1, C3.2, C4.2, C5.2, C6.2, C7.2, C8.2, C9.2, C10.2, C11.2, C12.2, C13.2, C14.2, C15.2, C16.2, C17.2, C18.2, C19.2, C20.2, C21.2, C22.2, C23.2, C24.2, C25.2, C26.2, C27.2, C28.2, C29.2, C30.2, C31.2, C32.2, C33.2, C34.2, C35.2, C36.2, C37.2, C38.2, C39.2, C44.2, C45.1, C46.1, C47.1, C48.2, C49.1, C50.2, C51.1, C52.2, C53.2, C54.1, C55.2, C56.1, C58.2, C59.1, CR1.1 (E0), CR1.2 (E1), CR1.3 (E2), CR1.4 (VSS), IC1.GND, IC2.8 (GND), J1.10, JP1.3, Q1.GND, R1.2, R13.1, R14.1, R16.1, R18.1, R20.1, R22.1, R25.1, R26.2, S1.3, S1.GND, S1.GND2 (GND), SV1.1, SV1.4, SV1.5, SV1.9, SV1.10, SV2.1, SV2.13, SV2.15, T1.2 (S), U1.12 (VSSA/VREF-), U1.18 (VSS_2), U1.31 (VSS_3), U1.47 (VSS_4), U1.60 (BOOT0), U1.63 (VSS), U2.10 (UN1/BIP-A), U2.11 (DGND), U2.18 (SGND-0), U2.20 (SGND-1), U2.27 (AGND), U2.29 (REFGND-A), U2.32 (REFGND-B), U2.41 (SGND-3), U2.43 (SGND-2), U2.47 (AIN), VREF1.3 (CS), VREF1.5 (GND), X1.CASE1 (CASE), X1.CASE2 (CASE), X1.SHIELD, X2.CASE1 (CASE), X2.CASE2 (CASE), X2.SHIELD, Y1.2, Y1.4; also elsewhere on the board
I2C1_SCL: CR1.6 (SCL), IC2.4 (SCL), R8.1, SV2.10, TP40.TP, U1.61 (PB8)
I2C1_SDA: CR1.5 (SDA), IC2.5 (SDA), R7.1, SV2.12, TP39.TP, U1.62 (PB9)
IRQFRONT1: SV2.14, U1.59 (PB7)
IRQFRONT2: SV2.8, U1.58 (PB6)
JTCK_SWCLK: J1.2, U1.49 (PA14)
JTDO_SWO: J1.8, U1.55 (PB3)
JTMS_SWDIO: J1.4, U1.46 (PA13)
unnamed: R9.1, S1.4
unnamed: LED1.C, R1.1
unnamed: R23.1, TP52.TP, U2.44 (RFB1-2), U2.45 (RFB2-2), U2.46 (VOUT-2)
unnamed: IC2.2 (XA), Y1.1
unnamed: IC2.3 (XB), Y1.3
unnamed: J1.3, TP11.TP
unnamed: R24.1, TP8.TP, U2.38 (VOUT-3), U2.39 (RFB2-3), U2.40 (RFB1-3)
unnamed: C2.2, Q1.1, U1.4 (PC15-OSC32_OUT)
unnamed: R4.2, T1.3 (G)
unnamed: LED2.A, R3.2
unnamed: J1.5, TP12.TP
unnamed: J1.7, TP13.TP
unnamed: IC1./D1, R14.2
unnamed: IC1./D0, R13.2
unnamed: C40.2, IC1.Q0, R15.1, R16.2, TP5.TP
unnamed: C41.2, IC1./Q0, R17.1, R18.2, TP6.TP
unnamed: C42.2, IC1.Q1, R19.1, R20.2, TP19.TP
unnamed: J1.9, TP15.TP
unnamed: C43.2, IC1./Q1, R21.1, R22.2, TP20.TP
unnamed: TP51.TP, U2.34 (VMON)
unnamed: C4.1, Q1.2, U1.3 (PC14-OSC32_IN)
RESET: C29.1, J1.6, R9.2, R10.2, SV2.4, TP1.TP, U1.7 (NRST), U2.7 (!RST); also elsewhere on the board
SPI1_CLK: TP18.TP, U1.21 (PA5), U2.3 (SCLK); also elsewhere on the board
SPI1_CS_C1_DDS: TP28.TP, U1.26 (PB0); also elsewhere on the board
SPI1_CS_C2_DDS: TP31.TP, U1.24 (PC4); also elsewhere on the board
SPI1_CS_DAC: TP29.TP, U1.29 (PB10), U2.2 (!CS)
SPI1_MISO: TP32.TP, U1.22 (PA6), U2.5 (SDO); also elsewhere on the board
SPI1_MOSI: TP22.TP, U1.23 (PA7), U2.4 (SDI); also elsewhere on the board
SPI2_CLK: SV2.17, U1.34 (PB13)
SPI2_CS_DSP: SV2.18, U1.33 (PB12)
SPI2_MISO: U1.35 (PB14)
SPI2_MOSI: SV2.20, U1.36 (PB15)
STATUS_LED: R4.1, U1.51 (PC10)
STATUS_LED_P: LED2.C, SV2.16, T1.1 (D)
UART1_RX: JP1.2, U1.43 (PA10)
UART1_TX: JP1.1, U1.42 (PA9)
VREF_2V5: C45.2, TP2.TP, U2.30 (REF-A), U2.31 (REF-B), VREF1.4 (VOUT)

Notes on the sheet:
Stecker Frontpanel
Debugstecker
Stecker
Spannungs-Filter
Analog -5V
Analog +3V3
Analog 5V
Analog -15V
Analog 15V
+ realtime clk
32,768 MS1V-12,5 C ungefähr 24pF
Logicboard Waveformgenerator V2
Resettaster
evtl. 5k oder kleiner
Stecker Netzteil
POWER_LED
µC-Status_LED Frontpanel
BNC Buchsen
6,8pF for L4xxRx
Vref
2,5 V Spannungsreferenz
Takt-Generator
µ-Controller
EEPROM
DAC Offset & Amplitude
50V Kondensatoren
UART Stecker
Pegelwandlung CMOS -> LVPECL
GND <-> Analog GND
