Agustin586/AWG-RP2040/Tesis/Extras/Funktionsgenerator-master/Funktionsgenerator-master/Hardware/Hauptplatine/Hauptplatine.brd

## EAGLE design Tesis/Extras/Funktionsgenerator-master/Funktionsgenerator-master/Hardware/Hauptplatine/Hauptplatine.brd (continued)

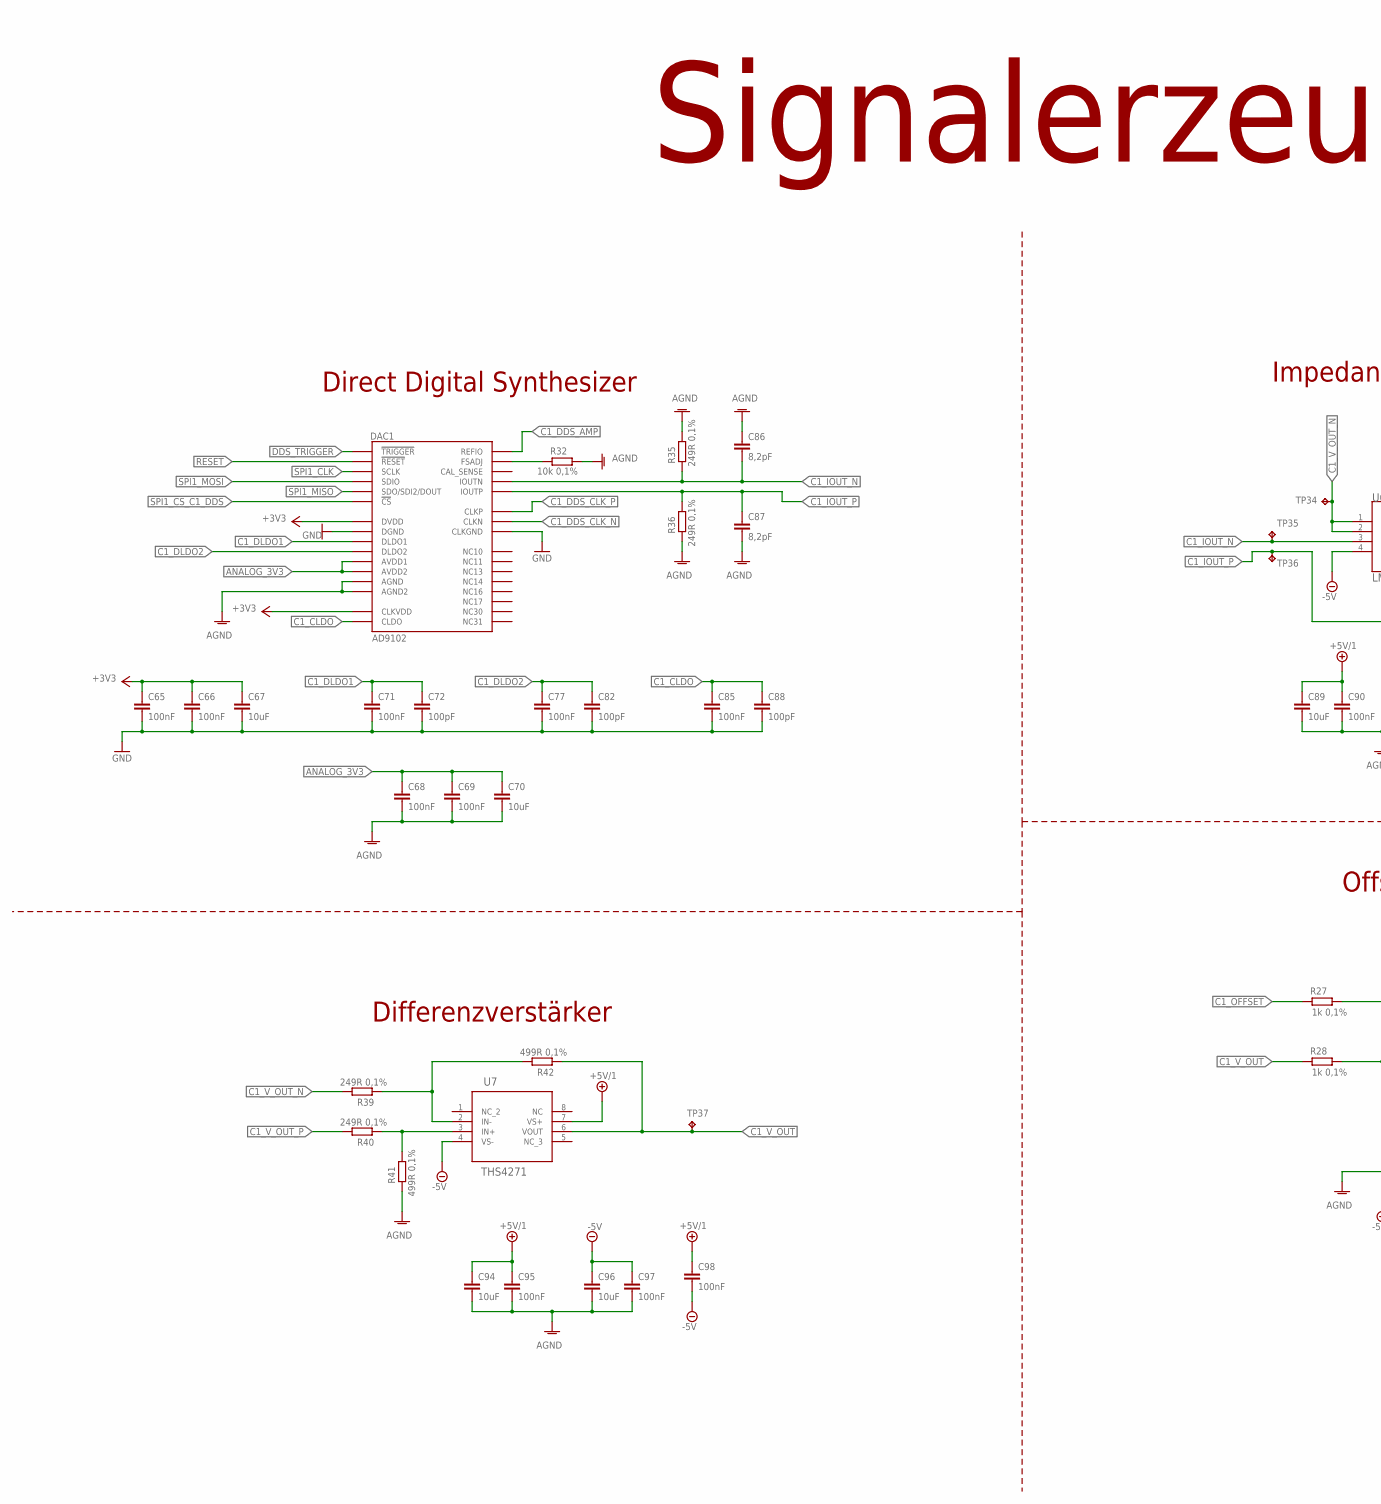
[picture p150: schematic Hauptplatine.sch, sheet 2, Channel 1, part in row 1, column 1]

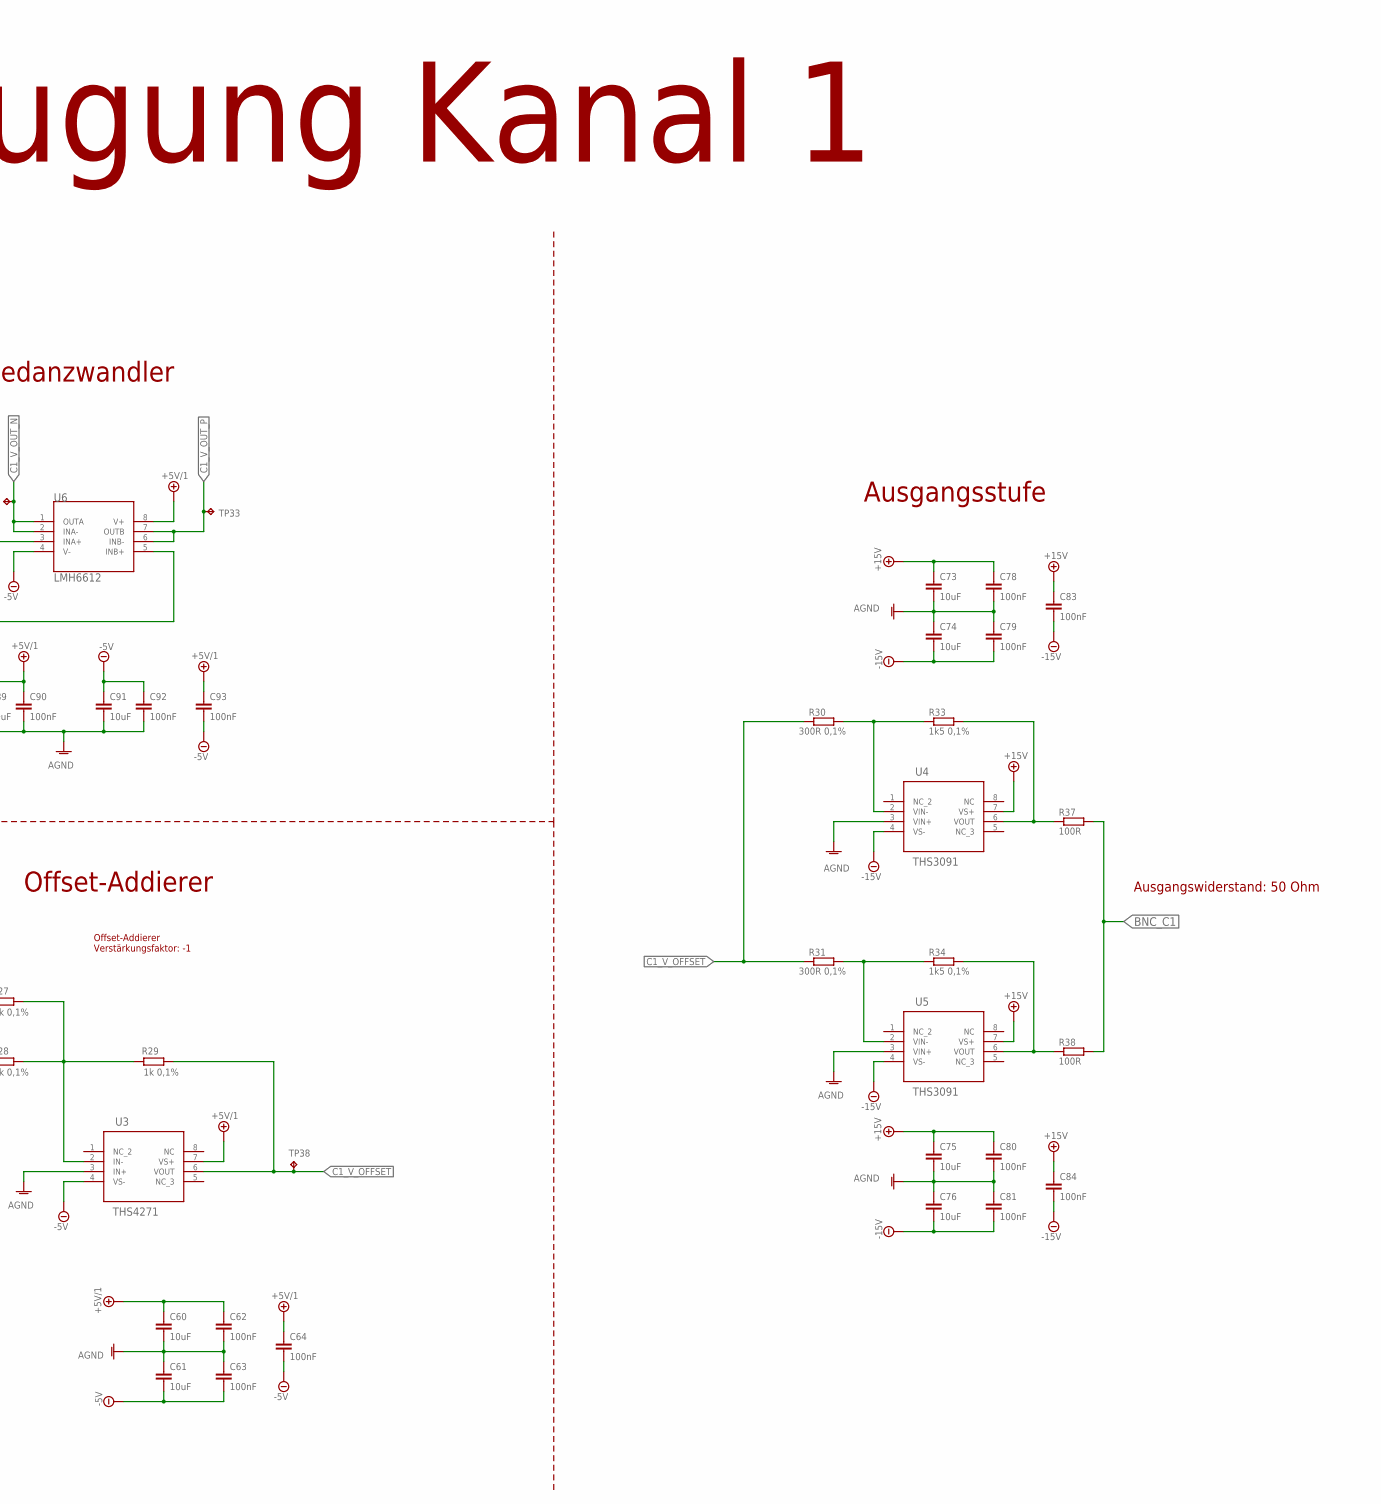
[picture p151: schematic Hauptplatine.sch, sheet 2, Channel 1, part in row 1, column 2]

Parts:
C60, C61, C67, C70, C73, C74, C75, C76, C89, C91, C94, C96: 10uF; C0603
C62, C63, C64, C65, C66, C68, C69, C71, C77, C78, C79, C80, C81, C83, C84, C85, C90, C92, C93, C95, C97, C98: 100nF; C0603
C72, C82, C88: 100pF; C0603
C86, C87: 8,2pF; C0603
DAC1: AD9102; CP_32_12
R27, R28, R29: 1k 0,1%; R0603
R30, R31: 300R 0,1%; R0603
R32: 10k 0,1%; R0603
R33, R34: 1k5 0,1%; R0603
R35, R36, R39, R40: 249R 0,1%; R0603
R37, R38: 100R; R0603
R41, R42: 499R 0,1%; R0603
TP33, TP34, TP35, TP36, TP37, TP38: TPB1,27; B1,27
U3, U7: THS4271; D8-M
U4, U5: THS3091; D8-M
U6: LMH6612; M08A-M

Connections:
+3V3: C65.1, C66.1, C67.1, DAC1.5 (DVDD), DAC1.23 (CLKVDD); also elsewhere on the board
+5V/1: C60.1, C62.1, C64.1, C89.1, C90.1, C93.1, C94.1, C95.1, C98.1, U3.7 (VS+), U6.8 (V+), U7.7 (VS+); also elsewhere on the board
+18V: C73.1, C75.1, C78.1, C80.1, C83.1, C84.1, U4.7 (VS+), U5.7 (VS+); also elsewhere on the board
-5V: C61.2, C63.2, C64.2, C91.1, C92.1, C93.2, C96.1, C97.1, C98.2, U3.4 (VS-), U6.4 (V-), U7.4 (VS-); also elsewhere on the board
-18V: C74.2, C76.2, C79.2, C81.2, C83.2, C84.2, U4.4 (VS-), U5.4 (VS-); also elsewhere on the board
ANALOG_3V3: C68.1, C69.1, C70.1, DAC1.12 (AVDD2), DAC1.29 (AVDD1); also elsewhere on the board
BNC_C1: R37.2, R38.2; also elsewhere on the board
C1_CLDO: C85.1, C88.1, DAC1.22 (CLDO)
C1_DDS_AMP: DAC1.18 (REFIO); also elsewhere on the board
C1_DDS_CLK_N: DAC1.20 (CLKN); also elsewhere on the board
C1_DDS_CLK_P: DAC1.21 (CLKP); also elsewhere on the board
C1_DLDO1: C71.1, C72.1, DAC1.6 (DLDO1)
C1_DLDO2: C77.1, C82.1, DAC1.4 (DLDO2)
C1_IOUT_N: C86.2, DAC1.28 (IOUTN), R35.1, TP35.TP, U6.3 (INA+)
C1_IOUT_P: C87.1, DAC1.27 (IOUTP), R36.2, TP36.TP, U6.5 (INB+)
C1_OFFSET: R27.2; also elsewhere on the board
C1_V_OFFSET: R29.1, R30.1, R31.1, TP38.TP, U3.6 (VOUT)
C1_V_OUT: R28.2, R42.1, TP37.TP, U7.6 (VOUT)
C1_V_OUT_N: R39.2, TP34.TP, U6.1 (OUTA), U6.2 (INA-)
C1_V_OUT_P: R40.2, TP33.TP, U6.6 (INB-), U6.7 (OUTB)
DDS_TRIGGER: DAC1.32 (!TRIGGER); also elsewhere on the board
GND: C60.2, C61.1, C62.2, C63.1, C65.2, C66.2, C67.2, C68.2, C69.2, C70.2, C71.2, C72.2, C73.2, C74.1, C75.2, C76.1, C77.2, C78.2, C79.1, C80.2, C81.1, C82.2, C85.2, C86.1, C87.2, C88.2, C89.2, C90.2, C91.2, C92.2, C94.2, C95.2, C96.2, C97.2, DAC1.3 (DGND), DAC1.15 (AGND), DAC1.19 (CLKGND), DAC1.26 (AGND2), DAC1.33 (DGND), R32.2, R35.2, R36.1, R41.1, U3.3 (IN+), U4.3 (VIN+), U5.3 (VIN+); also elsewhere on the board
unnamed: DAC1.25 (FSADJ), R32.1
unnamed: R40.1, R41.2, U7.3 (IN+)
unnamed: R39.1, R42.2, U7.2 (IN-)
unnamed: R33.2, R37.1, U4.6 (VOUT)
unnamed: R31.2, R34.1, U5.2 (VIN-)
unnamed: R34.2, R38.1, U5.6 (VOUT)
unnamed: R30.2, R33.1, U4.2 (VIN-)
unnamed: R27.1, R28.1, R29.2, U3.2 (IN-)
RESET: DAC1.9 (!RESET); also elsewhere on the board
SPI1_CLK: DAC1.1 (SCLK); also elsewhere on the board
SPI1_CS_C1_DDS: DAC1.8 (!CS); also elsewhere on the board
SPI1_MISO: DAC1.7 (SDO/SDI2/DOUT); also elsewhere on the board
SPI1_MOSI: DAC1.2 (SDIO); also elsewhere on the board

Notes on the sheet:
Signalerzeugung Kanal 1
Direct Digital Synthesizer
Differenzverstärker
Offset-Addierer
Ausgangsstufe
Offset-Addierer Verstärkungsfaktor: -1
Impedanzwandler
Ausgangswiderstand: 50 Ohm

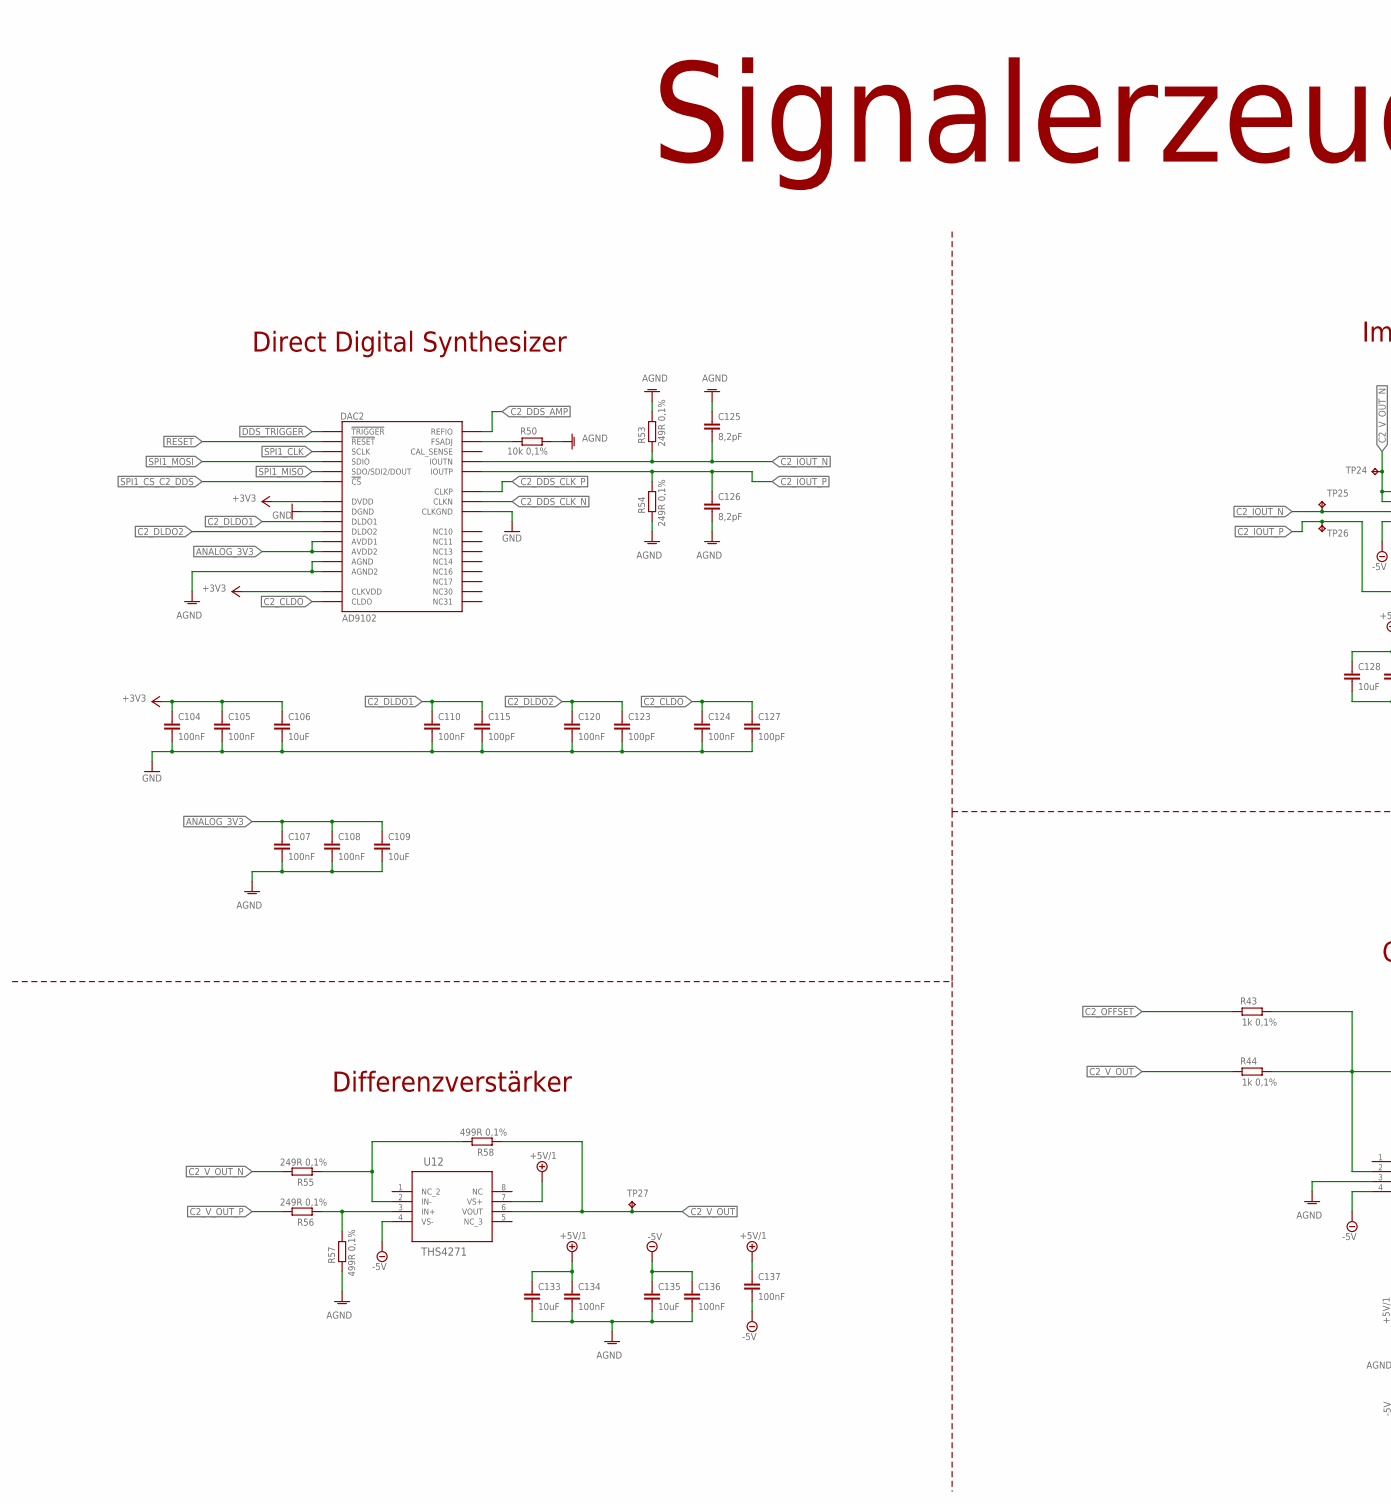
[picture p152: schematic Hauptplatine.sch, sheet 3, Channel 2, part in row 1, column 1]

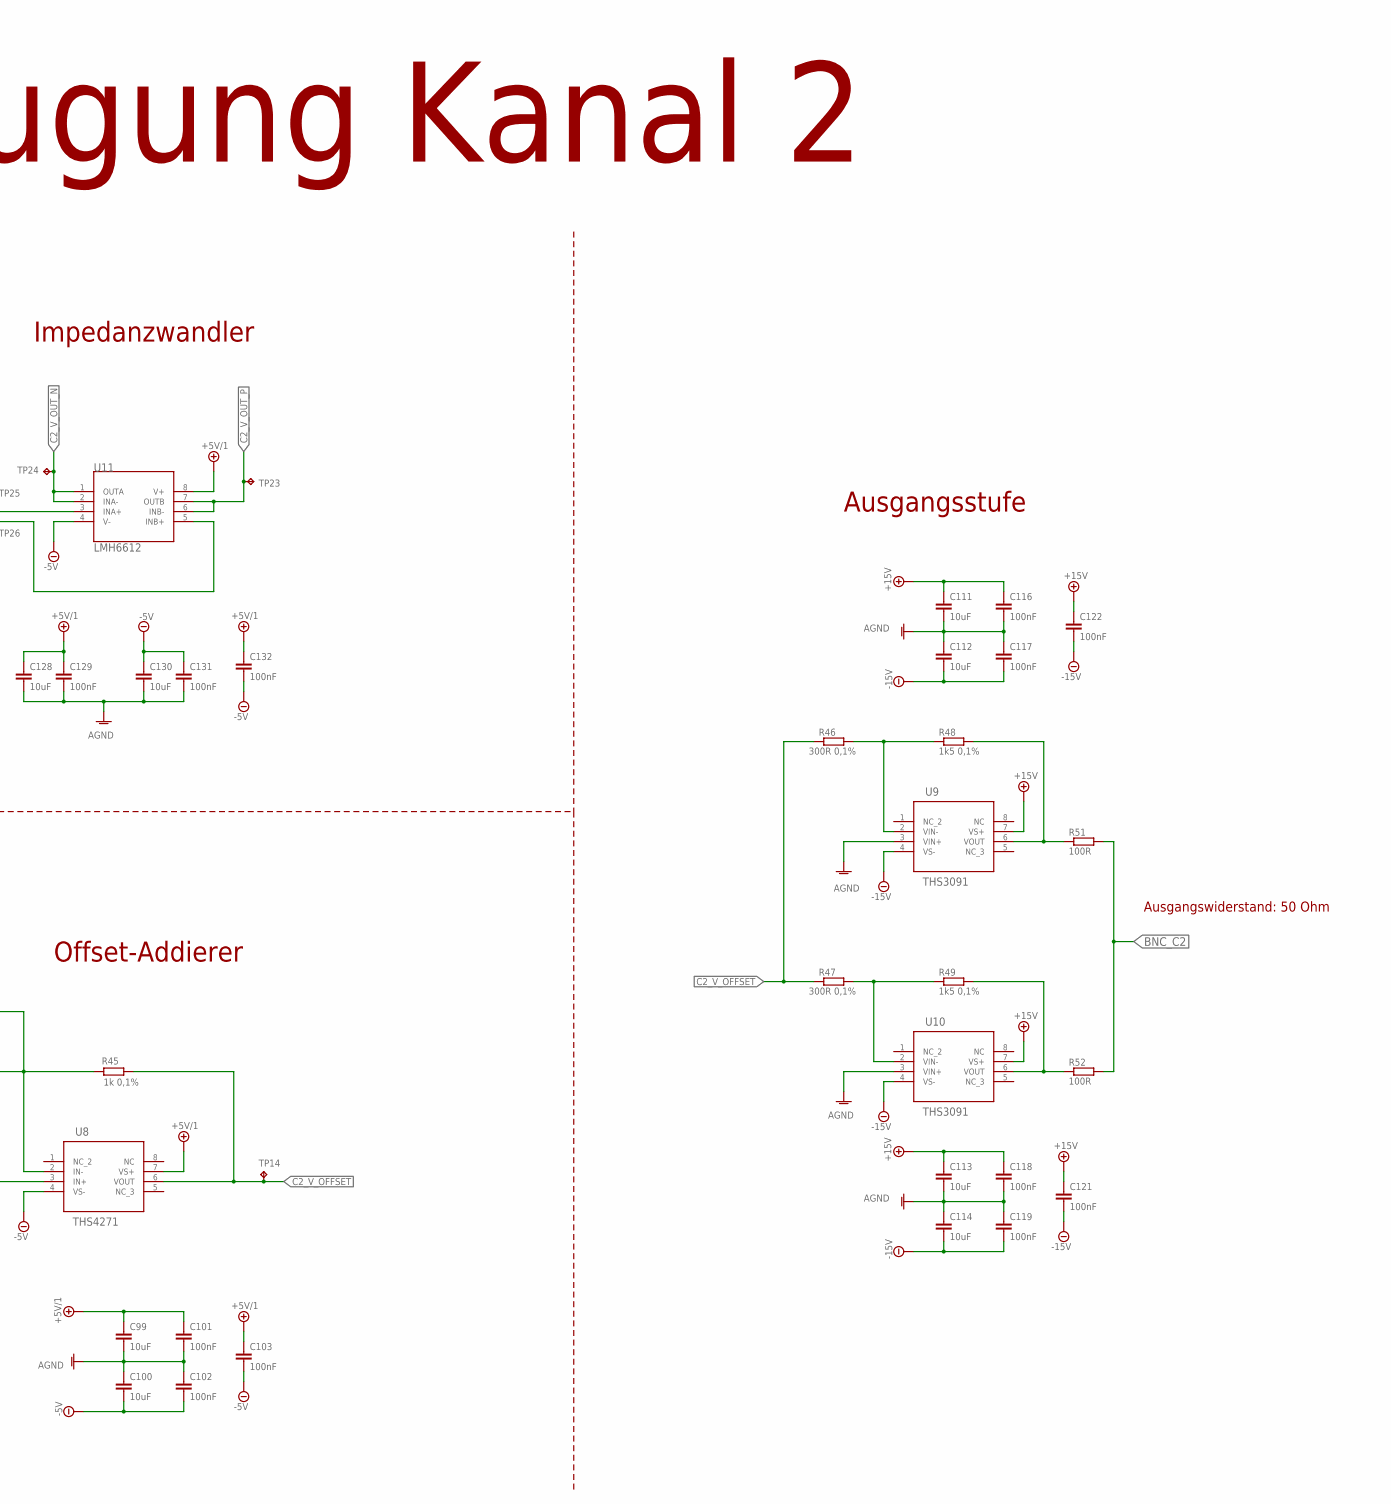
[picture p153: schematic Hauptplatine.sch, sheet 3, Channel 2, part in row 1, column 2]

Parts:
C99, C100, C106, C109, C111, C112, C113, C114, C128, C130, C133, C135: 10uF; C0603
C101, C102, C103, C104, C105, C107, C108, C110, C116, C117, C118, C119, C120, C121, C122, C124, C129, C131, C132, C134, C136, C137: 100nF; C0603
C115, C123, C127: 100pF; C0603
C125, C126: 8,2pF; C0603
DAC2: AD9102; CP_32_12
R43, R44, R45: 1k 0,1%; R0603
R46, R47: 300R 0,1%; R0603
R48, R49: 1k5 0,1%; R0603
R50: 10k 0,1%; R0603
R51, R52: 100R; R0603
R53, R54, R55, R56: 249R 0,1%; R0603
R57, R58: 499R 0,1%; R0603
TP14, TP23, TP24, TP25, TP26, TP27: TPB1,27; B1,27
U8, U12: THS4271; D8-M
U9, U10: THS3091; D8-M
U11: LMH6612; M08A-M

Connections:
+3V3: C104.1, C105.1, C106.1, DAC2.5 (DVDD), DAC2.23 (CLKVDD); also elsewhere on the board
+5V/1: C99.1, C101.1, C103.1, C128.1, C129.1, C132.1, C133.1, C134.1, C137.1, U8.7 (VS+), U11.8 (V+), U12.7 (VS+); also elsewhere on the board
+18V: C111.1, C113.1, C116.1, C118.1, C121.1, C122.1, U9.7 (VS+), U10.7 (VS+); also elsewhere on the board
-5V: C100.2, C102.2, C103.2, C130.1, C131.1, C132.2, C135.1, C136.1, C137.2, U8.4 (VS-), U11.4 (V-), U12.4 (VS-); also elsewhere on the board
-18V: C112.2, C114.2, C117.2, C119.2, C121.2, C122.2, U9.4 (VS-), U10.4 (VS-); also elsewhere on the board
ANALOG_3V3: C107.1, C108.1, C109.1, DAC2.12 (AVDD2), DAC2.29 (AVDD1); also elsewhere on the board
BNC_C2: R51.2, R52.2; also elsewhere on the board
C2_CLDO: C124.1, C127.1, DAC2.22 (CLDO)
C2_DDS_AMP: DAC2.18 (REFIO); also elsewhere on the board
C2_DDS_CLK_N: DAC2.20 (CLKN); also elsewhere on the board
C2_DDS_CLK_P: DAC2.21 (CLKP); also elsewhere on the board
C2_DLDO1: C110.1, C115.1, DAC2.6 (DLDO1)
C2_DLDO2: C120.1, C123.1, DAC2.4 (DLDO2)
C2_IOUT_N: C125.2, DAC2.28 (IOUTN), R53.1, TP25.TP, U11.3 (INA+)
C2_IOUT_P: C126.1, DAC2.27 (IOUTP), R54.2, TP26.TP, U11.5 (INB+)
C2_OFFSET: R43.2; also elsewhere on the board
C2_V_OFFSET: R45.1, R46.1, R47.1, TP14.TP, U8.6 (VOUT)
C2_V_OUT: R44.2, R58.1, TP27.TP, U12.6 (VOUT)
C2_V_OUT_N: R55.2, TP24.TP, U11.1 (OUTA), U11.2 (INA-)
C2_V_OUT_P: R56.2, TP23.TP, U11.6 (INB-), U11.7 (OUTB)
DDS_TRIGGER: DAC2.32 (!TRIGGER); also elsewhere on the board
GND: C99.2, C100.1, C101.2, C102.1, C104.2, C105.2, C106.2, C107.2, C108.2, C109.2, C110.2, C111.2, C112.1, C113.2, C114.1, C115.2, C116.2, C117.1, C118.2, C119.1, C120.2, C123.2, C124.2, C125.1, C126.2, C127.2, C128.2, C129.2, C130.2, C131.2, C133.2, C134.2, C135.2, C136.2, DAC2.3 (DGND), DAC2.15 (AGND), DAC2.19 (CLKGND), DAC2.26 (AGND2), DAC2.33 (DGND), R50.2, R53.2, R54.1, R57.1, U8.3 (IN+), U9.3 (VIN+), U10.3 (VIN+); also elsewhere on the board
unnamed: DAC2.25 (FSADJ), R50.1
unnamed: R56.1, R57.2, U12.3 (IN+)
unnamed: R55.1, R58.2, U12.2 (IN-)
unnamed: R48.2, R51.1, U9.6 (VOUT)
unnamed: R47.2, R49.1, U10.2 (VIN-)
unnamed: R49.2, R52.1, U10.6 (VOUT)
unnamed: R46.2, R48.1, U9.2 (VIN-)
unnamed: R43.1, R44.1, R45.2, U8.2 (IN-)
RESET: DAC2.9 (!RESET); also elsewhere on the board
SPI1_CLK: DAC2.1 (SCLK); also elsewhere on the board
SPI1_CS_C2_DDS: DAC2.8 (!CS); also elsewhere on the board
SPI1_MISO: DAC2.7 (SDO/SDI2/DOUT); also elsewhere on the board
SPI1_MOSI: DAC2.2 (SDIO); also elsewhere on the board

Notes on the sheet:
Signalerzeugung Kanal 2
Direct Digital Synthesizer
Differenzverstärker
Ausgangsstufe
Offset-Addierer
Impedanzwandler
Ausgangswiderstand: 50 Ohm

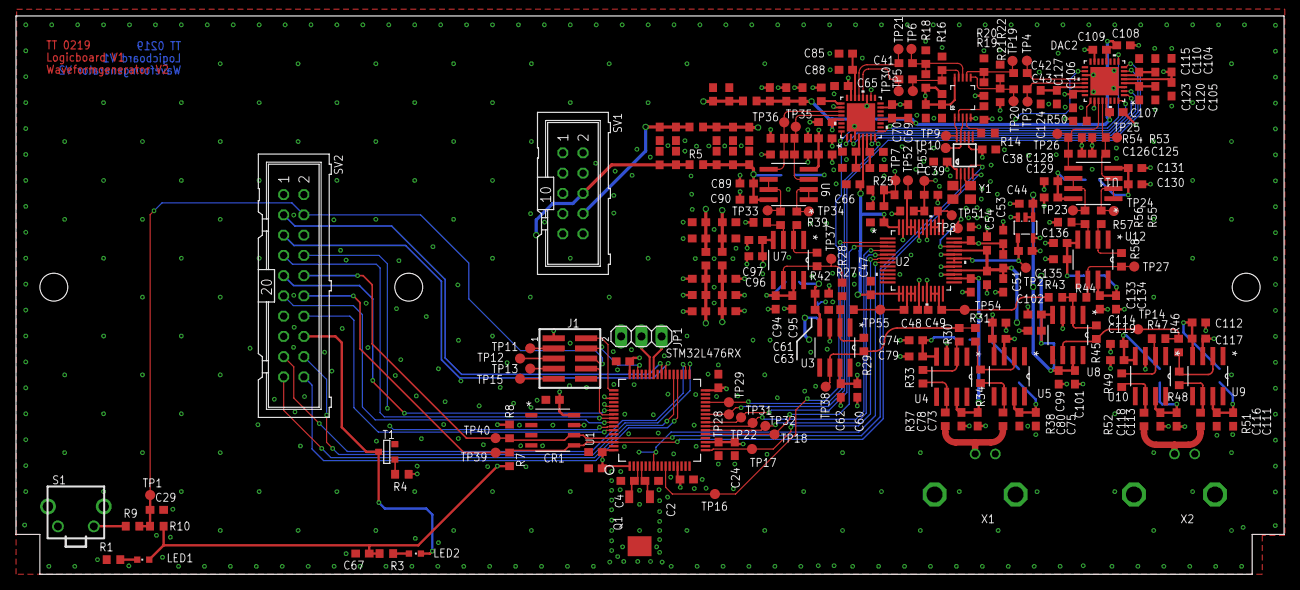
[picture p154: board Hauptplatine.brd from above]

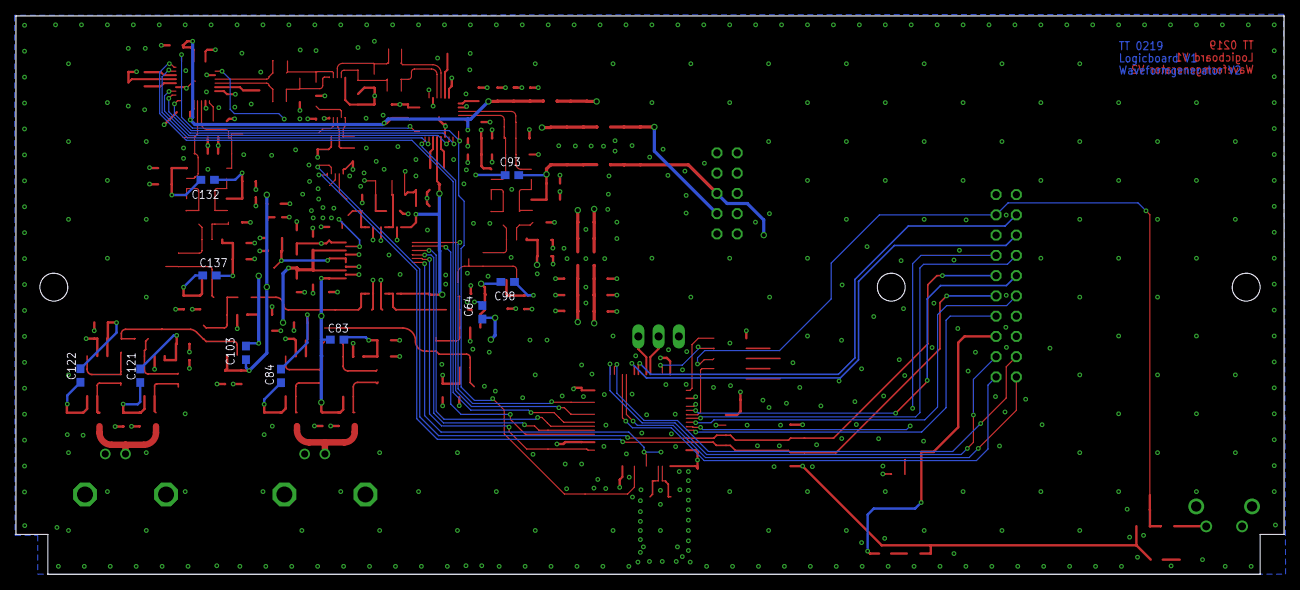
[picture p155: board Hauptplatine.brd from below]

Board: 4 copper layers, 159.0 x 70.0 mm, 270 parts (10 on the bottom side), 109 nets.
