Agustin586/AWG-RP2040/(commit log)

2025-06-14 Update - General
    [2-R2 Dac.SchDoc, Alimentacion.SchDoc, Control.SchDoc, Generador de Funciones.PrjPcb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]
2025-06-19 Update - PCB - Modelo 3d
2025-06-19 Update - PCB - 3D Model
2025-06-19 Update - PCB - View
2025-08-30 Add SASE presentation materials and related assets
    Added multiple files for the SASE project, including presentation videos, conference and poster PDFs, and various images and diagrams. These assets support documentation and dissemination of the AWG SASE 2025 work.
2026-01-11 Update PCB design
    [PCB-Fuente.V01.R00.PcbDoc]
2026-01-12 Update PCB TopOverlay
    Se agrega algunas notas sobre la misma PCB.
    [PCB-Fuente.V01.R00.PcbDoc]
2026-01-29 Anteproyecto
    Se realiza el documento definitivo del anteproyecto
    [RP2040_minimal_r2-BOM.xlsx]
2026-01-29 Bibliografia
    Se agregan pdfs como material bibliográfico para el diseño de pcb y demás.
2026-01-29 Bibliografia
    Se actualiza la bibliografia.
    [RP2040_minimal_r2.kicad_pcb, RP2040_minimal_r2.kicad_sch]
2026-01-29 PCB de Control
    Se realizan avances en la placa de control. Se realizaron sheets para AD9102, PE4312, RP2040, etc. Se agregaron librerias para componentes.
    [ABM8-272-T3.SchLib, ABM8272T3.PcbLib, AD9102BCPZ.SchLib, Canal-DDS.V03.R00.SchDoc, Control-Principal.V03.R00.SchDoc, DifferentialToSingleOutput.V03.R00.SchDoc, EDI2CAP.CFG, LMH6612MAX_NOPB.SchLib]
2026-01-29 PCB Placa de Alimentacion
    Se actualiza la placa de alimentacion con minimos cambios.
    [Fuente.V01.R00.PrjPcb]
2026-02-01 Actualizacion de la placa de control
    [5227161-2.SchLib, 52271612.PcbLib, 52271612.psm, 5413879-2.SchLib, 54138792.PcbLib, Alimentacion.V03.R00.SchDoc, Amplificador.V03.R00.SchDoc, BLM21AG102BH1J.PcbLib]
2026-02-08 Update PCB Control
    Se actualiza el esquematico de la placa de control. Falta calcular valores del dac bipolar para el offset.
    [Alimentacion.V03.R00.SchDoc, Amplificador.V03.R00.SchDoc, BNC-OUTPUT.V03.R00.SchDoc, Canal-DDS.V03.R00.SchDoc, ConexionesPanelFrontal.V03.R00.SchDoc, Control-Principal.V03.R00.SchDoc, DAC8562SDGSR.SchLib, DifferentialToSingleOutput.V03.R00.SchDoc]
2026-02-08 Update Anteproyecto
    Se realiza la segunda version con la correcciones mencionadas para el anteproyecto.
2026-02-16 Se corrigen y agregan cosas al anteproyecto
    Se hace correccion de forma de escritura y se agregan los integrados que se van a utilizar en la descripcion del hardware. Tambien se ponen los diagramas en bloques de forma apaisada.
    [Alimentacion.V03.R00.SchDoc, Amplificador.V03.R00.SchDoc, BNC-OUTPUT.V03.R00.SchDoc, Canal-DDS.V03.R00.SchDoc, ConexionesPanelFrontal.V03.R00.SchDoc, Control-Principal.V03.R00.SchDoc, DifferentialToSingleOutput.V03.R00.SchDoc, MCP4725.V03.R00.SchDoc]
2026-02-23 Update PCB Control
    Se realizan avances
    [Alimentacion.V03.R00.SchDoc, Amplificador.V03.R00.SchDoc, BNC-OUTPUT.V03.R00.SchDoc, Canal-DDS.V03.R00.SchDoc, ConexionesPanelFrontal.V03.R00.SchDoc, Control-Principal.V03.R00.SchDoc, DifferentialToSingleOutput.V03.R00.SchDoc, EDI2CAP.CFG]
2026-02-23 Update Fuente.V01.R00.OutJob
    Se realiza la documentacion
2026-03-01 Se realizan cambios en la pcb de control. Se routean todas las pistas de señal. Falta agregar control de impedancia a ciertas señales.
    [Amplificador.V03.R00.SchDoc, Control-Principal.V03.R00.SchDoc, DifferentialToSingleOutput.V03.R00.SchDoc, PCB_Control.V03.R00.PcbDoc, SY55857L.V03.R00.SchDoc]
2026-03-06 Actualizacion de la PCB de Control
    [Alimentacion.V03.R00.SchDoc, BNC-OUTPUT.V03.R00.SchDoc, Control-Principal.V03.R00.SchDoc, Ethernet.V03.R00.SchDoc, Microcontrolador.V03.R00.SchDoc, PCB_Control.V03.R00.PcbDoc, SY55857L.V03.R00.SchDoc, Sintetizador-AD9102.V03.R00.SchDoc]
2026-04-12 Firmware para panel
2026-04-12 Actualizacion placas
    [Alimentacion.V03.R00.SchDoc, Amplificador.V03.R00.SchDoc, Bill of Materials-Fuente.V01.R00.xlsx, Canal-DDS.V03.R00.SchDoc, ConexionesPanelFrontal.V03.R00.SchDoc, Control-Principal.V03.R00.SchDoc, DifferentialToSingleOutput.V03.R00.SchDoc, Ethernet.V03.R00.SchDoc]
