Agustin586/AWG-RP2040/(notices)

Notices in the files:
parts and their libraries:
PowerMagnetics: Copyright: Würth Elektronik
